openAMRobot/openamrobot-docs/docs/assets/roadmap/media/openamrobot-2-store-1080p-poster.png

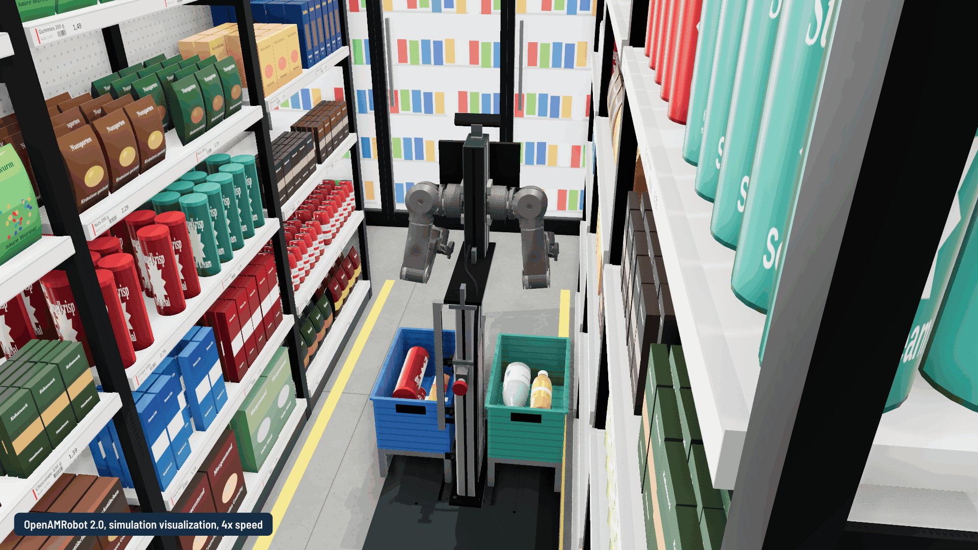
docs/assets/roadmap/media/openamrobot-2-store-1080p-poster.png
