openAMRobot/openamrobot-docs/docs/assets/roadmap/media/store/05_store_overview.jpg

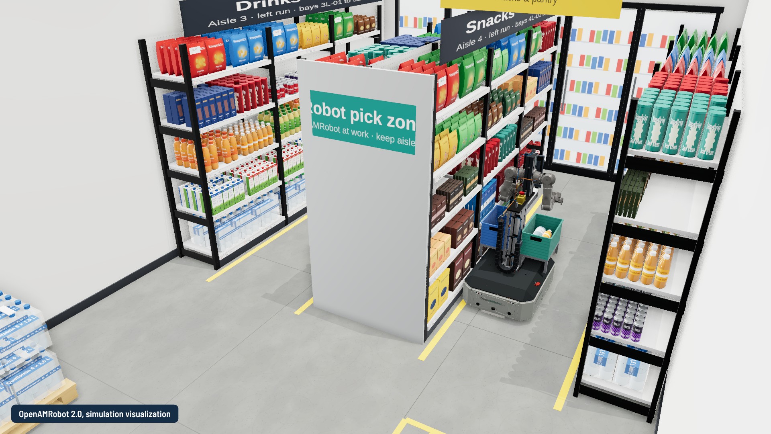
docs/assets/roadmap/media/store/05_store_overview.jpg
