openAMRobot/openamrobot-docs/docs/templates/hardware-README.md

# HARDWARE_COMPONENT_NAME

STATUS: Active

One-sentence hardware definition.

## How it fits

Identify the assemblies and repositories that consume or depend on this design.

## Opening these files

| Format | Authoring tool and version | Free viewer |
|---|---|---|
| Example | Exact tool/version | Viewer/link |

## Build contents

List assemblies, drawings, schematics, PCB source, manufacturing exports, and exclusions.

## BOM summary

Link the authoritative BOM and state its revision.

## Validated configuration

Record the exact tested mechanical, electrical, firmware, and software configuration.

## Known limitations

List verified limitations without unfinished-work markers.

## Repository boundaries

State what belongs here and link firmware, software, documentation, and interface work to their owners.

## Documentation

- Repository documentation: [docs/](docs/)
- Conceptual documentation: DOCS_PAGE_URL

## Safety

State electrical, mechanical, stored-energy, thermal, motion, lifting, and fabrication hazards.

## Project

- [Licence](LICENSE)
- [Licensing map](LICENSING.md)
- [Contributing](https://github.com/openAMRobot/.github/blob/main/CONTRIBUTING.md)
- [Security](https://github.com/openAMRobot/.github/blob/main/SECURITY.md)
