openAMRobot/openamrobot-docs/STATE.md

# State

Working state of this repository for maintainers and agents. Not published on the site (outside `docs/`).

## OpenAMRobot 2.0 plan set reflected in the docs

As of 9 November 2026 (owner decisions of 2, 3 and 8 Nov 2026; decision baseline D-01 to D-34 in P-03 rev20.6 item 30): P-03 rev20.6, E-01 rev1.8 (design text only since rev1.6; precharge, regen clamp, ZLAC boot, brake gating, FB-A/F-CHG and W09 pending, D-22 to D-25, D-28, D-33; not evidence of an implemented or accepted safety chain), M-01 rev19.10, BOM Issue 7.15 (Hardware BOM sheet; the sheet header still reads 7.14), B-02 rev18.11, UC1 rev18.6, decisions.yaml at 87c8486 on main (openAMRobot/.github#90 merged 10 Nov 2026, same tree as the reviewed head 6328f51; change request openAMRobot/.github#89).

- Roadmap pages (`docs/assets/roadmap/`): snapshot 9 Nov 2026 (status pages, model, visuals and the hardware page; window 6 to 9 Nov 2026); PARTS is BOM Issue 7.15 (148 records, 123 onboard by the model rule) (`scripts/roadmap_model/bom715.py` over the 7.14 importer; LFT-008 and MEC-022 added).
- Model placement data is generated: `scripts/roadmap_model/run_all.sh` (sources in `../src`, combined model expanded under `../ament`). Weekly update: edit `facts.yaml`, `parts.yaml`, `bom_map.yaml`, `conflicts.yaml`, then rerun.
- Item-specific citations of earlier revisions (for example "P-03 rev19.7 item 23", "rev20.0 item 24") are kept as the record of where a decision was taken.
- Shared model (`docs/assets/roadmap/model/`): Getac ZX80 drawn portrait only, on a fixed portrait mount (owner correction A3, register OPERATOR-PANEL and TABLET-MOUNT); no ghost. `scripts/sync_audit.json` regenerated by the Playwright visual audit: 166 parts, 0 mismatches.
- Owner decisions of 2 Nov 2026 in the model (entered in P-03 rev20.4 item 28 and M-01 rev19.8): 2 mm tyre compression as an intended contact; lift base plate on the centre-frame arch; owner corrections A1 to A5: TZBOT WCM-500-24 wireless charging prepared in 2.0 (register CHARGING): receiver position at the rear panel on the centre line, class "prepared, installed later", with the base-sheet cut-out, F-CHG, KCHG and the start and fault lines drawn; manual charging through SB50 with the Daly 28.4 V / 20 A charger at any time; 4 + 4 LF105 cells in the side pockets, power electronics on a plate above the receiver (`rear_layout.py`); one front bay layout, two tiers (`front_bay.py`, no options); Getac portrait only on a fixed mount, 55 mm lower (8 Nov 2026, was 40 mm), with the light bar 10 mm below; ZED lens 60 mm ahead of J1_A (8 Nov 2026, was 57 mm); second E-stop on the adapter plate, button up (no other position and no ghost; arm checks use only valid poses: within the joint limits, no self-collision, no collision with the robot body).
- Owner corrections A6 to A9 of 2 Nov 2026 (entered in P-03 rev20.4 item 28 and M-01 rev19.8): lift stop sensors on the rear face of the static DOLD column, centred in y, z 120 / 295 / 470 mm, SICK DOL-1204-G02M cables down the static column; the adapter plate is one part, 6082-T6, 425 x 100 x 10 mm, with a 65 mm rear extension behind the column rear face (sensor face, 2 mm flag gap, 9 mm rod clearance, 20 x 20 rod L430 bolted with M5 under the extension plus the corner bracket, 12 mm bolt edge distance), `frames.lift_rear_layout()`; rod bottom 109 mm above the cover at L1000; GI-010 closed. GI-082 (arch top sheet) and GI-025 (side-panel return flange notch at x -0.275 to -0.133 m) are minor decided fixes, CAD pending. The CAD rear dimensions (552 / 337.6 / 235 mm) are the reference. GI-080 (major, manual layout pending, evans-kwashie): the automatic packer could not place FB-B and the BMS under its rules (single layer plus shelf, 5 mm gaps, nothing above a fuse block, estimated outlines); the free space above the receiver is about 190 x 229 x 165 mm (plate width x plate length x height to the cover); a manual two-level layout with datasheet outlines follows in the next PR. GI-126 (major): battery + to F0 is 196 mm routed as a smooth lug-to-lug curve (175 mm straight, rule about 150 mm). GI-129 and GI-130 (major): F0 to the disconnect (CBL-P02) and K1 to K2 (CBL-P05) have no compliant route in the current rear layout (FB-A, a top-access fuse block, sits between their terminals with no passage beside or under it); they wait for the rear-layout rework with GI-080. Battery: two removable trays joined by the keyed connector PWR-018 (conflict with B-02 rev18.10 listed for the battery owner).
- Harness (3 Nov 2026, `scripts/roadmap_model/harness.py` through `build.py`): every cable of `cable_list.csv` in a named harness (W01 rear power, W02 drive section, W03 / W04 left and right side trunks, W05 front sensors, W07 front tier, W08 lift column, W09 upper body) with labels at both ends and its disconnect points (DP-TRAY-L/R, DP-FT, DP-LIFT). Base routes come from a 5 mm voxel router (structure as shells, parts as boxes, keep-outs, withdrawal paths of the trays, the front tiers and the cover, bend radius per cable class; short lug-to-lug links as smooth curves); routes are cached in `harness_routes.json` by input hash (a full reroute takes about 15 minutes). Upper body: DP-LIFT behind the lift base plate, fixed sleeve on the -y face of the static column, vertical energy chain behind the column (inner 38 x 25 mm, R 75 mm, 0.792 m), moving trunk under the adapter plate. Mounting points and new parts for CAD: `harness_cad_changes.csv`. Not routed: cables to FB-B and the BMS (not placed, GI-080; the arm power cables are routed from DP-LIFT up), CBL-P02 and CBL-P05 (GI-129, GI-130).
- Owner decisions of 8 Nov 2026 (P-03 rev20.4 item 28 and rev20.5 item 29): the roadmap model is the reference for components, mass and placement, and the URDF masses follow `mass_export.yaml` (one source: openamr-platform-sw base_link and openamr-upperbody-sw lift_carriage_link copy it). DOLD lift from the supplier STEP (`facts.yaml` `column`: foot 280 x 60.4 x 10 mm (224 x 40 mm is DOLD-internal; the robot fixing is 4 x DIN 7984 M8 x 14 through the foot tabs on 260 x 30 mm into the tapped 350 x 140 x 10 mm MEC-019, P-03 rev20.6 item 30 D-20), static profile 240 x 60 mm to 505 mm, inner stage 209.5 x 53.3 x 470 mm). Arch reinforcement GI-082: 4 x M8 8.8 through-bolts into one laser-cut tapped steel backing plate if the mechanical owner confirms the space, otherwise 5 mm S235 with press-in nuts (D-21, `arch_fix`, CAD pending). K1/K2 are GX11CAC only (docs #68, 3 Nov); option B is no longer reported (GI-008, GI-009 closed). Wiring: the slot is the gap between the cover lower edge and the panel upper edges (z 214 to 232 mm); no cable, busbar or tie in it or on a panel upper edge (the side-panel top flanges included), all around the robot, no inward band (`cover_slot` keep-outs in `harness.py`); at the rear, parts may rise above the slot level and their leads run down inside. Upper-body cables enter the base through two 50 x 25 mm openings left and right of the lift on the channel centre lines (power left through CH-C1, signal right through CH-C2; DP-LIFT-L and DP-LIFT-R), with entry slots in the centre-bracket front and rear walls and the C-RM channel over the rear power module. Mass ledger (owner, 8 Nov 2026 evening): `mass_ledger.yaml` counts every part once, quantity x datasheet mass (EVE LF105 1.98 kg per cell, ZLLG80 hub motor 3.45 kg, Blickle castor 0.3 kg, RPLIDAR S3 115 g, Gemini 336L 135 g, MEAN WELL and Blue Sea figures), custom parts from dimensions and material; the battery pack is no mass line of its own (cells, busbars, sense harness, probes, insulation; trays, BMS, F0 and disconnect separate); the DOLD 11.7 kg is split into the static 8.89 kg and the moving 2.81 kg share (`column.mass_split`); hub motors, castors and the LiDAR sit on their own URDF links, the wrist cameras on theirs; `mass_export.py` fails when a part is counted twice. Mass export: carriage parts on lift_carriage_link, column parts on lift_column_base_link, one link per BOM line, real boxes for the column, chassis and hub motors, box centres for the centre of mass (the vertex mean put the cells 66 mm high); the Getac pocket is counted once, on UI-002 (MEC-012 is allocation only, included in UI-002).
- After the snapshot: openamr-upperbody-sw #29 merged on 2 Nov 00:06 UTC; the combined model, the parity check and the mass export are rebuilt from the openamr-upperbody-sw #48 head d8c0940 (paired: the export link frames are the #48 frames; main after #48 merges) (with openamr-platform-sw 131e500 and openarm_description 14ff67b).
- Geometry and hardware issues (`geometry_issues.csv`): 0 blockers, 0 majors, 39 minors (8 Nov 2026: option B for K1/K2 is no longer reported, GI-008 and GI-009 closed; the receiver margin is the 15 mm offset, GI-121 to GI-123 keep their IDs with the new wording; 3 Nov 2026: the rear power module layout of `rear_power.py` closes GI-080, GI-126, GI-129 and GI-130). IDs are stable across reruns (`scripts/roadmap_model/issue_ids.yaml`, seeded from the IDs published in PR #68): existing IDs never renumber, new issues get new IDs, closed IDs keep their reason.
- TZBOT values from the TZBOT WCM-500-24 Wireless Charger Instruction Manual V2.5 (2021-09-23), `facts.yaml` `tzbot_receiver`: 170 x 150 x 52 mm, about 1.5 kg, air gap 20 +-10 mm (no effect on the enclosure). Owner decision of 8 Nov 2026 (P-03 rev20.5 item 29): no metal within 20 mm of the receiver sides (`metal_clear`), held by a 3D-printed plastic frame on the steel base sheet (`frame`, part `tz_receiver_frame`, design by the mechanical owner, with a cable notch for the rear TF-Luna lead), and 15 mm above it (`metal_clear_above`; TZBOT recommends 20 mm). `rear_layout.py` places the receiver 170 mm along x, 20 mm in front of the rear panel (x -0.350 to -0.180), bottom 50 mm; the base-sheet cut-out is the receiver plus the frame. The charging gap with a 52 mm floor transmitter (-2 mm) is a minor issue of kind to solve before receiver installation, declared in `check_roadmap.py` KNOWN_CONTACTS.
- Roadmap vs combined model (`parity_report.csv`): 50 mapped items, 42 matched, 4 out of tolerance, 11 pending (intended pending differences include the A6 adapter-plate rear extension, no longer flush with the column rear face (P-03 rev20.1 item 25 D2), the sensor face and the rod position).
- Decision baseline of 8 Nov 2026 (P-03 rev20.6 item 30) in the model: compute D-01, lift foot fixing and MEC-019 350 x 140 mm D-20, backing plate D-21, 0.5 m/s base ceiling D-07 (not measured), CTL-017 and NPN NO sensors D-11, two trays D-27. Mass (D-26, owner instruction of 8 Nov 2026 evening): the ledger is `mass_ledger.yaml`, every part counted once with its datasheet mass, custom parts from their design-intent solids or dimensions and material; the DOLD column split into the static and the moving share; platform-sw #126 and upperbody-sw #48 copy the export pinned to this PR's commit. Design values, not weighed; the mechanical owner reviews the custom-part estimates.
- Refresh of 9 Nov 2026 (branch roadmap/2026-11-09-roadmap-refresh, stacked on docs #83): PARTS from BOM Issue 7.15 (LFT-008 lift foot screws, MEC-022 arch backing plate, 21 changed rows); mass ledger 87.1 kg (base 58.2, lift 9.1, carriage 6.72 kg; 86.3 kg at #83 before LFT-008 and MEC-022), design values, not weighed. openamr-platform-sw #126 and openamr-upperbody-sw #48 still copy the export of #83 (eaa26aa) and need a re-pin after this refresh merges. Exploded tour stops 43.5, 54, 71.5 and 79.5 carry the 8 Nov decisions (foot tabs, receiver plastic frame, two 50 x 25 mm openings, flag rod guide and second E-stop on the adapter plate). Stills 01 to 08, both tour videos and the posters re-rendered into `evidence/2026-11-09-media/`; the dark-store video is unchanged. Conflicts between sources: 50 (`conflicts.yaml`). Review of #84 (9 Nov 2026): `bom715.py` stops on a bad header, invalid or duplicate IDs, non-numeric Qty and page records missing from the workbook, reports added, changed, removed and overridden records, and escapes "</" in the embedded JSON (`scripts/tests/test_bom715.py`); MEC-019 Qty 1 with the two joints and the assembly order of 9 Nov 2026 (P-03 rev20.6; the workbook Qty cell holds legacy notes, recorded as a conflict); LFT-008 and MEC-022 carry provisional explicit placements in `mass_ledger.yaml` (`place`), and the export names its BOM issue from `facts.yaml`. H-day 16 Nov 2026 confirmed: the v0.0.1 Teensy rig runs the current 2.0 base software (a software test, not Build 1 commissioning or acceptance); 6 Nov go/no-go dates labelled historical.
- Copy fixes of 10 Nov 2026 (roadmap audit of 10 Nov): the pages keep the 9 Nov snapshot and record what changed after it. .github #90 merged as 87c8486 and docs #83 and #84 as 329a7bc and ff8ca57 on 10 Nov; the register footers, the system map and the progress lines say so. 16 Nov is a planned software session on the v0.0.1 Teensy rig, after preflight; the architecture controller card is decided per line; the IMU row follows D-10 (EKF on /imu/data_raw, main still on /imu/data, #129); the motion figure is labelled as the rc.1 pin of 19 Oct; progress opens with a capability panel (main, rc.1 pin, last run) and the per-area tables are the historical audit of 19 Oct; purchasing status is out of the narrative (check_roadmap.py "purchasing status"); the exploded drawer label no longer names a BOM issue. Contributor GitHub handles stay on the pages as owners (project lead decision of 10 Nov 2026: they are public on GitHub already). The package cards are regenerated in a follow-up PR (packages.py).
- Public BOM status of 10 Nov 2026 (owner decision): dated stock and quote notes stay in the workbook. `bom715.py` `public_status()` cleans the Procurement status, Release status and Procurement state fields of every record and the purchase view section (no quote counters); a field that held only such notes reads "Procurement confirmation pending". Selected parts, installed quantities and engineering status stay. Tests in `scripts/tests/test_bom715.py`.
- Precharge (SAF-004, PWR-014, PWR-015, BUY-26) on the hardware page and in `bom_coverage.csv`: in the design (P-03 rev20.2; sizing, sequencing and acceptance pending, D-22), not fitted (#83). The progress page keeps "precharge fitted" only in its dated 24 Oct 2026 refresh section.
- `docs/assets/hardware/openamrobot2-hardware-architecture-bom7.html` is the BOM Issue 7 record; superseded notes at the top carry the later values.

The figures above are checked by `scripts/check_roadmap.py` against the generated files (`scripts/sync_audit.json`, `bom_coverage.csv`, `geometry_issues.csv`, `scripts/roadmap_model/parity_summary.json`); it fails when they disagree.

## Owner handles

Owners on the roadmap pages and in `geometry_issues.csv` are GitHub handles from this list, or "owner: to be assigned" (`scripts/roadmap_model/analyse.py` OWN for the issues):

- BotshareAI: project lead.
- panthera-momagdii: tech lead, UI reviewer.
- fridayali: mechanical CAD, URDF, docking.
- evans-kwashie: electrical, safety, firmware.
- skunal3318: navigation.
- Brinex45: manipulation.
- vineethmanthena: perception.
- parthkeshari: UI lead.
- nikgolobo: UI and simulation checks.
- Tushargoel230: upper-body model.
- KARTHIKEYAN124: release.
- ArkaStark: bench and integration.
- wikki26: CI owner.
- anandgawai123456-glitch: docs owner.

## Goal of the roadmap model

The roadmap becomes a renderer of the expanded combined_robot.xacro (openamr-upperbody-sw) at a pinned commit, with no hand-typed dimensions in model.js.

- One geometry, two presentations.
- URDF only: physics, inertials, collisions, ros2_control, MoveIt, Gazebo.
- Roadmap only: finishes, labels, exploded offsets, BOM classes, harness, fasteners, design-intent parts. Roadmap-only parts always attach to a URDF link with an offset (`scripts/roadmap_model/link_map.yaml`).
- Convergence runs in phases: 1) warn-only parity report (done, 2 Nov 2026: `parity.py`, CI warning); 2) URDF-to-GLB renderer plus an overlay file keyed by URDF link name; 3) the parity check fails CI above 0.5 mm, and the frozen fixture in upperbody-sw is removed; 4) the combined model feeds the lift joint, limits, mass, COM, collision reports and recorded MoveIt trajectories into the roadmap, and the roadmap feeds BOM masses, visual-only detail links and confirmed design-intent datums back (`mass_export.yaml` is the first input).

## Open follow-ups

- Rear layout (A1, A9): manual two-level layout of FB-B and the BMS with datasheet outlines in the next PR (GI-080, the automatic packer placed neither after five attempts); F0 distance (GI-126) and a cable passage for CBL-P02 and CBL-P05 beside or under FB-A (GI-129, GI-130); hardware owner. The harness rerun routes the FB-B and BMS cables once those parts are placed. CAD owner: the side-panel return flange notch (GI-025), the adapter-plate rear extension and the arch doubler (GI-082).
- Arch top sheet at the rear rivet nuts is over its yield with the arms at full reach, payload and braking (GI-082): decided fix, a doubler or through-bolts with a backing plate, CAD pending.
- TZBOT (to solve before the receiver is installed): charging gap (GI-036) and the rear panel and TF-Luna inside the 20 mm margin (GI-121 to GI-123).
- Wrist cameras are robot-page fittings, not registry parts.
- Tour and store media were not re-rendered (tour script unchanged).
