openAMRobot/openamrobot-docs/LICENSING.md

# OpenAMRobot licensing standard

OpenAMRobot uses asset-appropriate permissive licences for original material owned by or validly assigned to **OpenAMRobot (Botshare LTD)**.

| Material | Licence |
|---|---|
| Software, firmware, scripts, configuration, APIs, tests, and code examples | [MIT](https://spdx.org/licenses/MIT.html) |
| Documentation, diagrams, tutorials, original images, and other authored content | [Creative Commons Attribution 4.0 International](https://spdx.org/licenses/CC-BY-4.0.html) |
| CAD, PCB and schematic source, mechanical/electrical design files, manufacturing source, and CAD-derived robot geometry | [CERN Open Hardware Licence Version 2 — Permissive](https://spdx.org/licenses/CERN-OHL-P-2.0.html) |

Copyright (c) 2021–2026 OpenAMRobot (Botshare LTD).

The root `LICENSE` identifies the predominant licence for this repository. Where a repository contains several asset types, the table above and any more specific file, directory, SPDX, package, or notice declaration determine the applicable licence.

## Third-party material

No OpenAMRobot licence relicenses third-party material. Third-party material remains governed by its original ownership, licence, patent, attribution, modification, and source-availability terms. Specific third-party terms control over this general policy and are recorded in source headers, dependency manifests, `NOTICE.md`, `THIRD_PARTY_NOTICES.md`, accompanying licence files, or the material itself.

## Ownership and branding

Public licensing grants the permissions in the applicable licence; it does not transfer ownership of the underlying intellectual property. OpenAMRobot, OpenAMR, associated logos, visual identity, and claims of official affiliation or certification are not licensed under MIT, CC BY 4.0, or CERN-OHL-P-2.0. See the organization [Trademark Policy](https://github.com/openAMRobot/.github/blob/main/TRADEMARK_POLICY.md).

## Earlier distributions

Licences validly granted for earlier copies remain effective for those copies. The current default branch states the policy for current and future distributions, subject to third-party rights and mandatory law.

Licensing and provenance questions: **info@botshare.ai**.
