openAMRobot/openamrobot-docs/docs/includes/abbreviations.md

*[AMR]: Autonomous Mobile Robot
*[API]: Application Programming Interface
*[BOM]: Bill of Materials
*[CAD]: Computer-Aided Design
*[CoG]: Centre of Gravity
*[E-stop]: Emergency stop
*[IMU]: Inertial Measurement Unit
*[LMS]: Learning Management System
*[ROS 2]: Robot Operating System 2
*[SLAM]: Simultaneous Localization and Mapping
*[TF]: Transform frame system in ROS
*[URDF]: Unified Robot Description Format
*[VLA]: Vision-Language-Action model
