openAMRobot/openamrobot-docs/docs/learn/foundations.md

<section class="oamr-hero oamr-hero--compact"><div><span class="oamr-status">Stage 1 · Understand</span><h1>Foundations</h1><p>Build the mental model needed to make safe, informed decisions without drowning in robotics vocabulary.</p></div>OpenAMRobot logo</section>

## What to understand

<div class="oamr-grid">
<article class="oamr-card"><h3>Robot anatomy</h3><p>Drive, power, compute, sensors, actuators, chassis and mechanics.</p></article>
<article class="oamr-card"><h3>Navigation</h3><p>Frames, odometry, SLAM, localization, planning, avoidance and docking.</p></article>
<article class="oamr-card"><h3>Manipulation</h3><p>Kinematics, planning, grasping, workspace, reach and the lift.</p></article>
<article class="oamr-card oamr-card--accent"><h3>Embodied AI</h3><p>Why demonstration matters; Show, Correct, Judge; datasets, policies and simulation.</p></article>
<article class="oamr-card"><h3>ROS 2 in an afternoon</h3><p>Nodes, topics, services, actions, parameters, launch, TF, URDF and ros2_control.</p></article>
<article class="oamr-card oamr-card--success"><h3>Working safely</h3><p>Moving robots, electricity, batteries, emergency stop and basic risk assessment.</p></article>
</div>

!!! note "Learning scope"
    This section explains how the pieces relate. Exact implementation details remain in the [Technical Reference](../reference/index.md) and owning repositories.

**Next:** [Build the platform](build.md) or [start in simulation](bring-up.md).
