openAMRobot/openamrobot-docs/docs/start-here/index.md

---
title: Start here
description: Choose the shortest OpenAMRobot path for learning, assembly, operation, integration, development or business validation.
hide:
  - navigation
---

<section class="oamr-hero oamr-hero--compact"><div><span class="oamr-status">Start here</span><h1>Find the shortest path to your goal</h1><p>Choose an outcome first; learn only the detail you need.</p><div class="oamr-actions"><a class="oamr-button oamr-button--primary" href="../foundations/">Learn the platform</a><a class="oamr-button" href="../business/">Build a business</a></div></div>OpenAMRobot logo</section>

## What OpenAMRobot is

OpenAMRobot is an open-source robotics ecosystem operated by **Botshare LTD**. It combines a modular mobile platform, ROS 2 software, embedded firmware, open hardware, shared interfaces, an operator UI and a developing manipulation and Embodied AI layer.

Its operating idea is simple: **the person who understands the work should be able to operate and teach the robot without first becoming a robotics engineer**.

## Choose your path

<div class="oamr-grid">
<article class="oamr-card"><span class="oamr-status">Domain Expert</span><h3>Run and teach</h3><p>Apply task knowledge through missions, monitoring, demonstrations and outcome review.</p><p><a href="../paths/domain-expert/">Begin →</a></p></article>
<article class="oamr-card"><span class="oamr-status">Beginner</span><h3>Learn the platform</h3><p>Build foundations and reach a first verified result in simulation.</p><p><a href="../paths/beginner/">Begin →</a></p></article>
<article class="oamr-card"><span class="oamr-status">Integrator</span><h3>Deploy reliably</h3><p>Configure a supported system for a site, workflow and acceptance target.</p><p><a href="../paths/integrator/">Begin →</a></p></article>
<article class="oamr-card"><span class="oamr-status">Builder</span><h3>Build and own</h3><p>Hardware, installation, bring-up, calibration and acceptance.</p><p><a href="../paths/builder/">Begin →</a></p></article>
<article class="oamr-card"><span class="oamr-status">Developer</span><h3>Extend and contribute</h3><p>Architecture, repositories, contracts and customization guides.</p><p><a href="../paths/developer/">Begin →</a></p></article>
<article class="oamr-card oamr-card--success"><span class="oamr-status oamr-status--stable">Entrepreneur</span><h3>Create a local business</h3><p>Choose a model, validate demand, launch and join the ecosystem.</p><p><a href="../paths/entrepreneur/">Begin →</a></p></article>
</div>

## Start with the task in front of you

These routes cut across the documentation tree. Use them when you know the outcome you need but not which OpenAMRobot section owns it.

<div class="oamr-grid">
<article class="oamr-card"><h3>I need to assemble a robot</h3><p>Prepare the workspace, identify revision-matched parts, assemble one subsystem at a time and verify the result.</p><p><a href="../build/prepare/">Start the build route →</a></p></article>
<article class="oamr-card"><h3>I need to start the software</h3><p>Choose simulation or hardware, install the supported stack and verify the first launch before changing configuration.</p><p><a href="../build/software/">Start the software route →</a></p></article>
<article class="oamr-card"><h3>I need to create a map</h3><p>Understand the mapping model, capture the environment and verify that the saved map supports localization.</p><p><a href="../use/mapping/creating-a-map/">Start the mapping route →</a></p></article>
<article class="oamr-card"><h3>The robot is not moving</h3><p>Collect power, control, lifecycle and diagnostic evidence, then isolate the failing layer.</p><p><a href="../maintain/diagnosis/isolating-a-fault/">Start fault isolation →</a></p></article>
<article class="oamr-card"><h3>I need to integrate a new sensor</h3><p>Define the interface, mount and configure the sensor, then verify frames and data quality.</p><p><a href="../customize/device-packages/adding-a-sensor/">Start sensor integration →</a></p></article>
<article class="oamr-card"><h3>I want to evaluate a customer workflow</h3><p>Describe the task, environment, constraints and acceptance evidence before proposing automation.</p><p><a href="../business/validate/">Start workflow validation →</a></p></article>
</div>

## Simulation or hardware?

| Start with simulation when… | Start with hardware when… |
| --- | --- |
| You are learning navigation, missions or APIs | You must validate mechanics, wiring, sensors or safety |
| You want a reproducible software environment | You are preparing a real deployment or demonstration |
| Hardware is not yet available | You completed the pre-power safety checks |

!!! warning "Know the boundary"
    Simulation does not validate power, wiring, sensing noise, traction, mechanical tolerances, emergency behavior or site safety.
