openAMRobot/openamrobot-docs/docs/about/index.md

---
title: About, legal and contact
---

# About, legal and contact

## Project and operator

OpenAMRobot is an open-source robotics ecosystem initiated, operated and controlled by **Botshare LTD**.

| Detail | Information |
|---|---|
| Legal entity | Botshare LTD |
| Cyprus company ID | HE479056 |
| VAT number | 60197356L |
| Registered contact address | Chrysanthou Mylona 1, Panayides Building, Office 1, 3030 Limassol, Cyprus |
| Email | [info@botshare.ai](mailto:info@botshare.ai) |
| Website | [botshare.ai](https://botshare.ai) |
| GitHub | [github.com/openAMRobot](https://github.com/openAMRobot) |

## Copyright and licensing

Copyright © 2021–2026 OpenAMRobot (Botshare LTD).

Original OpenAMRobot material is licensed by asset type:

| Material | Licence |
|---|---|
| Software and firmware | MIT |
| Documentation, diagrams, tutorials, original images and educational content | CC BY 4.0 |
| Hardware source, CAD, PCB, schematics, manufacturing source and CAD-derived geometry | CERN-OHL-P-2.0 |

A repository’s root licence identifies its predominant material. LICENSING.md, file-level SPDX identifiers, directory notices and third-party notices provide more-specific terms and take priority where applicable. Public licensing grants the permissions in the applicable licence; it does not transfer ownership.

Third-party materials remain subject to their respective owners, licences and notices.

## Trademarks

OpenAMRobot, OpenAMR, associated logos, visual identity and claims of official affiliation or certification are not licensed under MIT, CC BY 4.0 or CERN-OHL-P-2.0. See the [Trademark Policy](https://github.com/openAMRobot/.github/blob/main/TRADEMARK_POLICY.md).

## Contributions and security

- Contributions: [Contribution Guide](https://github.com/openAMRobot/.github/blob/main/CONTRIBUTING.md)
- Contributor Agreements: [CLA process](https://github.com/openAMRobot/.github/blob/main/CLA.md)
- Intellectual property: [IP Policy](https://github.com/openAMRobot/.github/blob/main/IP_POLICY.md)
- Security reports: [Security Policy](https://github.com/openAMRobot/.github/blob/main/SECURITY.md)
- General, licensing and provenance questions: [info@botshare.ai](mailto:info@botshare.ai)

OpenAMRobot is experimental. Public documentation does not represent safety certification, regulatory approval, performance warranty or fitness for a particular deployment.
