openAMRobot/openamrobot-docs/docs/learn/index.md

---
title: Learning path
---

<section class="oamr-hero oamr-hero--compact"><div><span class="oamr-status">The learning path</span><h1>From first principles to an owned robot</h1><p>A staged path to understand, build, configure, train, operate, maintain and customize OpenAMRobot.</p><div class="oamr-actions"><a class="oamr-button oamr-button--primary" href="foundations/">Start with foundations</a><a class="oamr-button" href="../reference/">Technical reference</a></div></div>OpenAMRobot logo</section>

<div class="oamr-path"><span>Understand</span><b>→</b><span>Build</span><b>→</b><span>Bring up</span><b>→</b><span>Configure</span><b>→</b><span>Train</span><b>→</b><span>Use</span><b>→</b><span>Maintain</span><b>→</b><span>Customize</span></div>

## Pick the stage you need

<div class="oamr-grid">
<article class="oamr-card"><h3><a href="foundations/">1 · Foundations</a></h3><p>Robot anatomy, navigation, manipulation, Embodied AI, ROS 2 and safety.</p></article>
<article class="oamr-card"><h3><a href="build/">2 · Build</a></h3><p>Kit, mechanics, electronics, assembly, software and acceptance.</p></article>
<article class="oamr-card"><h3><a href="bring-up/">3 · Bring up</a></h3><p>First power-on, hardware checks, first motion and verification.</p></article>
<article class="oamr-card"><h3><a href="configure/">4 · Configure</a></h3><p>Profiles, hardware, geometry, calibration, safety and docking.</p></article>
<article class="oamr-card oamr-card--accent"><h3><a href="train/">5 · Train</a></h3><p>Named poses, demonstrations, replay, correction and evaluation.</p></article>
<article class="oamr-card oamr-card--success"><h3><a href="use/">6 · Use</a></h3><p>Operation, mapping, missions, Blockly, monitoring and recovery.</p></article>
<article class="oamr-card"><h3><a href="maintain/">7 · Maintain</a></h3><p>Checks, diagnosis, repair, spares, updates and rollback.</p></article>
<article class="oamr-card"><h3><a href="customize/">8 · Customize</a></h3><p>Devices, software, firmware, hardware, simulation and AI.</p></article>
</div>

## How learning pages work

Every practical guide should name its reader, prerequisites, expected outcome, verification method, common failures and next step. Repositories remain canonical for exact versions, source, parameters and interfaces; this site explains the concept and complete task.
