openAMRobot/openamrobot-docs/docs/solutions/index.md

---
title: Solutions
---

<section class="oamr-hero oamr-hero--compact"><div><span class="oamr-status">Solutions</span><h1>Start with the work, not the robot</h1><p>Use one shared platform and reusable capability patterns to address concrete operational problems.</p><div class="oamr-actions"><a class="oamr-button oamr-button--primary" href="pilot-framework/">Plan a pilot</a><a class="oamr-button" href="../business/">Build a local offer</a></div></div>OpenAMRobot logo</section>

## Priority solution families

<div class="oamr-grid">
<article class="oamr-card"><h3><a href="intralogistics/">Intralogistics</a></h3><p>Internal delivery, material movement, patrol and warehouse-support workflows.</p></article>
<article class="oamr-card oamr-card--accent"><h3><a href="retail/">Retail & replenishment</a></h3><p>Stock movement, aisle tasks and mobile-manipulation demonstrations.</p></article>
<article class="oamr-card"><h3><a href="manufacturing/">Manufacturing</a></h3><p>Line-side delivery, inspection, material handling and operator-assist workflows.</p></article>
<article class="oamr-card"><h3><a href="facility-services/">Facility & service operations</a></h3><p>Inspection, internal delivery, cleaning support and recurring service tasks.</p></article>
<article class="oamr-card oamr-card--success"><h3><a href="education-research/">Education & research</a></h3><p>A reproducible open platform for applied learning, experiments and workforce development.</p></article>
<article class="oamr-card"><h3><a href="pilot-framework/">Pilot framework</a></h3><p>Convert a workflow into requirements, metrics, evidence and a commercial next step.</p></article>
</div>

!!! note "Shared platform, not separate products"
    Solution pages adapt reusable navigation, manipulation, interface and training capabilities. They do not create four incompatible robot products.
