openAMRobot/openamrobot-docs/docs/learn/customize.md

<section class="oamr-hero oamr-hero--compact"><div><span class="oamr-status">Stage 8 · Customize</span><h1>Extend without fragmenting</h1><p>Add capabilities through stable interfaces, device packages and documented configuration rather than one-off forks.</p></div>OpenAMRobot logo</section>

<div class="oamr-grid">
<article class="oamr-card"><h3>Device packages</h3><p>Add an arm, sensor or actuator through a repeatable integration contract.</p></article>
<article class="oamr-card"><h3>Software & UI</h3><p>Add nodes, interface components, Blockly blocks and tests.</p></article>
<article class="oamr-card"><h3>Firmware</h3><p>Build, flash, add bridges, use micro-ROS and diagnose embedded behavior.</p></article>
<article class="oamr-card"><h3>Hardware</h3><p>Modify mounting, power, electronics or mechanics with mass and stability checks.</p></article>
<article class="oamr-card"><h3>Simulation & AI</h3><p>Build worlds, scenarios, datasets, evaluations and policy workflows.</p></article>
<article class="oamr-card oamr-card--accent"><h3>External systems</h3><p>Connect APIs, business systems and future fleet interoperability at explicit boundaries.</p></article>
</div>

!!! note "Contribution path"
    Reusable improvements should follow the repository governance and contribution workflow so the ecosystem benefits from them.

**Reference:** [Repository map](../reference/repositories.md) · [Interfaces](../reference/interfaces.md) · [Contributing](../contributing/index.md)
