openAMRobot/openamrobot-docs/docs/solutions/pilot-framework.md

<section class="oamr-hero oamr-hero--compact"><div><span class="oamr-status">Pilot framework</span><h1>Turn interest into evidence</h1><p>A pilot is a bounded commercial experiment with an owner, metric, safety envelope and next decision.</p></div>OpenAMRobot logo</section>

<div class="oamr-path"><span>Qualify</span><b>→</b><span>Baseline</span><b>→</b><span>Design</span><b>→</b><span>Build</span><b>→</b><span>Test</span><b>→</b><span>Decide</span></div>

| Stage | Required output |
| --- | --- |
| Qualify | Process, owner, pain, constraints and budget |
| Baseline | Current time, cost, error, delay and intervention |
| Design | Workflow, configuration, safety and acceptance metric |
| Build | Reproducible pilot configuration and operator procedure |
| Test | Results, failures, interventions and evidence |
| Decide | Deploy, iterate, stop or expand – with commercial next step |

!!! warning "A demo is not a pilot"
    A demo proves that something can move. A pilot tests whether a defined workflow creates acceptable value under real constraints.
