openAMRobot/openamrobot-docs/docs/assets/hardware/openamrobot2-general-arrangement.html

Superseded by the option B upper-body mounting, P-03 rev18.9 item 18; regenerated drawing to follow

# OpenAMRobot 2.0 general arrangement

Mobile platform with the own COTS mast and two OpenArm 2.0 arms. All views to scale from the MMP STEP, the official OpenArm 2.0 CAD and the F2S model. Dimensions in millimetres.

Status | Design proposal, pending measured inputs
Date | 28 September 2026
Owner | Botshare Ltd, OpenAMRobot
Baseline | mast_1350 installation height, mast top 1500 mm, command ceiling 1.5 m/s (analytical)

## Elevations

Arms stowed at the 1350 mm installation height. The ghost plates on the side view mark the other three mounting positions (1300, 1400, 1450 mm). Balloon numbers refer to the parts list.

Side viewFront to the right, hidden parts dashed

Front viewArms hang either side of the 60 mm mast

## Parts list

Item | Part | Key data | Source
1 | Mobile platform MMP | Steel chassis 780 x 582 mm, deck face 294 mm | MMP STEP
2 | Top cover | Non-structural, 630 x 576 mm | MMP STEP
3 | Hub motor ZLTECH ZLLG80ASM250-L-B | 200 mm, 24 V, double shaft, holding brake (ratings pending F2A), track 400 mm | ZLTECH, BOM Issue 7.7
4 | Swivel castor Blickle LPA-VSTH 35K | 52 mm total height, 15 mm offset, 100 kg each | Blickle
5 | Battery 8S1P EVE LF105 | 25.6 V, 105 Ah, 23 kg, centred 25 % of length from the rear | Decision 27 Sep
6 | Electronics bay | Jetson J401, ZLAC8015D, contactors, STM32, DC/DC | P-00
7 | LiDAR SLAMTEC RPLIDAR S3 (S3M1-R2) | Navigation scan, front; existing MMP.07 A1 bracket, 10 mm standoffs and a 7.1 mm spacer plate, beam 222.0 mm above the floor (same as the A1); lidar_link (0.330, 0, 0.124) from base_link, yaw pi; scan window fully open, no translucent cover; USB via USB to UART adapter to the Jetson, regulated 5 V rail; functional sensing, not a safety device | P-03 rev19.0 items 13 and 19
8 | Base camera Orbbec Gemini 336L | Front panel, housing centre on the old camera centre, 142.5 mm above the floor; base_camera_link (0.376, 0, 0.0445) from base_link; opening about 126 x 36 mm; up-tilt bt05, bt10 (baseline) or bt15 | P-03 rev19.0
9 | Base E-stop and start button | Front panel, dual-channel E-stop | P-00, MMP STEP
10 | Near-field sensors | 4 x MaxBotix MB7060 ultrasonic in the front and rear edge holes (27.5 mm, y ±0.130 m, 91.4 mm above the floor); 2 x TF-Luna ToF cliff sensors in the front and rear centre holes (22.0 mm; new rear hole); frames us_front_left, us_front_right, us_rear_left, us_rear_right, tof_front, tof_rear | P-03 rev19.0
11 | Mast base plate and brackets | Aluminium 10 mm on 8 x M8 rivet nuts, HBLFSDW6 brackets, rear brace | MMP STEP, OpenArm CAD
12 | Mast MISUMI HFS6-60120 | 60 x 120 mm, 1196 mm long, mast top 1500 mm above the floor, 5.4 kg | MISUMI
13 | Index cross holes | Diameter 6.6 mm at 50 mm pitch over the full length | Decision 28 Sep
14 | Cable duct | Rear slot zone, service loop to the shoulders | Decision 27 Sep
15 | J1_A arm plates | OpenArm 2.0 part, 12 mm, bolted to the mast side slots | OpenArm 2.0 STEP
16 | Shoulder motors J1 and J2 | DAMIAO DM8009P, two per arm | OpenArm 2.0 BOM
17 | OpenArm 2.0 arm | 7 DOF, 5.36 kg, reach 633 mm, nominal payload 4.1 kg | openarm_description
18 | Gripper with wrist camera | 0.77 kg, parallel fingers, in-hand RGB camera | OpenArm 2.0 BOM
19 | Chest cover with E-stop | Second dual-channel E-stop, about 1.45 m | OpenArm 2.0 STEP, P-00
20 | Head camera ZED-121210 | Stereo scene camera on the mast top; SKU and interface pending | OpenArm 2.0 BOM

## Plan view and stability

The dashed teal rectangle is the tipping boundary: the castor swivel axes moved inwards by their 15 mm offset. The centre of gravity stays inside it in every pose.

Top viewFront to the right

Tipping boundary CoG envelope, travel and arm poses P4, drawer pull 150 N, 86 mm from the edge LiDAR 270 degree field Battery under the deck

## Mast and shoulder mounting

The OpenArm J1_A plates bolt straight onto the side T-slots of the MISUMI profile, so the official arm kinematics stay exact and the shoulder moves between four indexed positions in 50 mm steps. Installation height 1350 mm; mast top 1500 mm.

Detail AElevation and section at the shoulder axis

One M6 through-bolt in the index cross hole locates both J1_A plates at the selected height.

M5 bolts into 6-series T-nuts carry the arm loads, four per plate.

Dashed outlines show the plate at mast_1300, mast_1350 and mast_1450.

Arm and camera cables run in the rear slot zone and loop to each shoulder, long enough for one 50 mm step.

Cross holes: diameter 6.6 mm at 50 mm pitch, ordered as a MISUMI alteration. Every height is a configuration ID propagated to URDF, MoveIt, calibration and dataset metadata. At mast_1450 the plate overhangs the mast top by 11 mm; its upper bolts stay inside the profile.

## Mast positions compared

Height changes reach, not stability. Theoretical horizontal reach at the A4 test heights uses the official 633 mm arm reach. Installation height is 1350 mm; the other positions are available for tests.

| mast_1300 | mast_1350 | mast_1400 | mast_1450
Shoulder axis above floor, mm | 1300 | 1350 | 1400 | 1450
Arm plate top, mm | 1361 | 1411 | 1461 | 1511
Reach at 820 mm height, mm | 413 | 346 | 254 | 62
Reach at 960 mm height, mm | 534 | 499 | 455 | 401
Reach at 1090 mm height, mm | 597 | 577 | 552 | 521
Reach at 1355 mm height, mm | 631 | 633 | 631 | 626
CoG height in travel, mm | 366 | 375 | 384 | 392
Braking decel that tips the robot, m/s² | 7.8 | 7.6 | 7.4 | 7.2

## F2S stability and stopping summary

Output | Result | Basis
Gross mass | about 93 kg | Cap 120 kg
CoG envelope, four poses | 372 to 427 mm high, within 35 mm of the drive axle | Travel, arms forward, arm sideways, drawer pull
Lowest static margin | 86 mm, drawer pull 150 N at 1090 mm | Minimum 50 mm; tips at about 220 N
Stopping at the 1.5 m/s ceiling | 0.82 m at 2.5 m/s² with 0.25 s latency | Tipping needs more than 5.6 m/s², traction limit 3.5 m/s²
Drive pair | Within the ZLTECH 120 kg drivable-mass rating | Rocking case about 650 N per motor, radial limit asked from ZLTECH
Motor speed at the cap | 143 rpm | Rated 200 rpm
Geometry change | None | Battery rear, mast on the drive axle, flat floor envelope

Open inputs: weighed chassis mass, ZLTECH radial load limit and dynamic brake rating, final hub-motor bracket and track, arms supplied without the OpenArm body. Battery and electronics outlines are placeholders until M-01 fixes them.
