openAMRobot/openamrobot-docs/docs/index.md

---
title: Home
description: Learn, build, operate, customize and commercialize the modular OpenAMRobot open-source Embodied AI platform.
hide:
  - navigation
---

<section class="oamr-hero"><div><span class="oamr-status">Open-source Embodied AI ecosystem</span><h1>Build robots. Train them for real work.</h1><p>Learn, build, operate and commercialize a modular ROS 2 platform designed to make robotics useful to domain experts – not only robotics specialists.</p><div class="oamr-actions"><a class="oamr-button oamr-button--primary" href="start-here/">Choose your path</a><a class="oamr-button" href="learn/">Learn the platform</a><a class="oamr-button" href="business/">Build a business</a></div></div>OpenAMRobot project logo</section>

> **One promise, three doors.** Make Embodied AI unprecedentedly simple for domain experts – from reading and assembly to configuration, training, operation and maintenance.

## One platform, three doors

<div class="oamr-grid">
<article class="oamr-card"><span class="oamr-status">The truth</span><h3>GitHub repositories</h3><p>Canonical code, CAD, firmware, interfaces, releases and exact technical reference.</p><p><a href="https://github.com/openAMRobot">Explore GitHub →</a></p></article>
<article class="oamr-card"><span class="oamr-status">The learning path</span><h3>This knowledge hub</h3><p>Illustrated concepts and guided paths to build, configure, train, use and maintain the platform.</p><p><a href="learn/">Start learning →</a></p></article>
<article class="oamr-card oamr-card--accent"><span class="oamr-status oamr-status--experimental">The product</span><h3>The App</h3><p>Guided, semi-automated workflows that hide robotics complexity from domain experts.</p><p><a href="about/">Understand the direction →</a></p></article>
<article class="oamr-card oamr-card--success"><span class="oamr-status oamr-status--stable">The ecosystem</span><h3>Businesses built around it</h3><p>Training, integration, hardware, pilots, deployment and local support opportunities.</p><p><a href="business/">Explore the opportunity →</a></p></article>
</div>

## Choose your role

| I want to… | Best starting point | Primary outcome |
| --- | --- | --- |
| Apply task knowledge to run and train a robot | [Domain Expert path](paths/domain-expert.md) | Operate missions, demonstrate tasks and judge outcomes safely |
| Learn robotics from the beginning | [Beginner path](paths/beginner.md) | Understand the platform and complete a first simulation |
| Deploy it at a customer site | [Integrator path](paths/integrator.md) | Configure and adapt a reliable system |
| Assemble my own platform | [Builder path](paths/builder.md) | Build, bring up and accept a working robot |
| Extend code, firmware or hardware | [Developer path](paths/developer.md) | Build new capabilities and contribute |
| Create a robotics business | [Entrepreneur path](paths/entrepreneur.md) | Validate, launch, deliver and support locally |

## Two journeys through the ecosystem

<p class="oamr-kicker">Robot ownership</p>
<div class="oamr-path"><span>Understand</span><b>→</b><span>Build</span><b>→</b><span>Bring up</span><b>→</b><span>Configure</span><b>→</b><span>Train</span><b>→</b><span>Use</span><b>→</b><span>Maintain</span><b>→</b><span>Customize</span></div>

<p class="oamr-kicker">Business building</p>
<div class="oamr-path"><span>Discover</span><b>→</b><span>Choose a model</span><b>→</b><span>Validate</span><b>→</b><span>Launch</span><b>→</b><span>Sell</span><b>→</b><span>Deliver</span><b>→</b><span>Support</span><b>→</b><span>Scale</span></div>

## Current platform

<div class="oamr-grid">
<article class="oamr-card"><span class="oamr-status oamr-status--stable">Active</span><h3>Mobile platform</h3><p>ROS 2 Jazzy, Nav2, SLAM, navigation, docking, simulation, firmware and open hardware.</p><p><a href="reference/mobile-platform/">Technical overview →</a></p></article>
<article class="oamr-card"><span class="oamr-status oamr-status--stable">Active</span><h3>Robot interface</h3><p>Browser-based operation, visualization and no-code workflows.</p><p><a href="ui/">Explore the interface →</a></p></article>
<article class="oamr-card"><span class="oamr-status oamr-status--beta">Developing</span><h3>Upper body & manipulation</h3><p>Lift, arm-agnostic manipulation, named poses and mobile-manipulation integration.</p><p><a href="reference/upper-body/">See the architecture →</a></p></article>
<article class="oamr-card"><span class="oamr-status oamr-status--experimental">Developing</span><h3>Demonstration pipeline</h3><p>Show, Correct, Judge workflows for capturing, replaying and evaluating demonstrations.</p><p><a href="learn/train/">Learn how teaching works →</a></p></article>
</div>

!!! info "Capability status"
    Pages distinguish **stable**, **beta**, **experimental**, **planned**, **community** and **partner-supported** capabilities. Confirm the relevant repository and release before committing to a deployment.

<div class="oamr-legal"><strong>Open technology, protected identity.</strong><br>Software is generally MIT, documentation CC BY 4.0, and hardware source CERN-OHL-P-2.0. Botshare Academy curriculum, certification and partner rights are separate commercial elements.</div>
