openAMRobot/openamrobot-docs/docs/academy/programs.md

# Academy programs

| Program | Audience | Promise | Primary delivery layer |
| --- | --- | --- | --- |
| **1 · Robot Operator and Trainer** | Domain experts and operations teams | Operate and teach supported workflows without becoming robotics engineers | The App + guided delivery |
| **2 · Build Your Robot** | Builders, technicians and makers | Assemble, configure and maintain an owned platform | Knowledge hub |
| **3 · Customize and Engineer** | Developers, integrators and engineers | Extend the platform safely and reproducibly | Knowledge hub + GitHub |

## Corporate formats

- **Discovery Workshop (1 day):** operate the robot, make a first demonstration, qualify a real automation process and define a pilot path.
- **Discovery Workshop / Demo Day:** practical introduction for a company, hub or professional community.
- **Corporate Enablement:** training plus advisory around a selected workflow.
- **Productization Sprint:** structured requirements, architecture, simulation or PoC and roadmap.

Formats, current prices and booking: [academy.botshare.ai/companies](https://academy.botshare.ai/companies).

!!! info "Capability honesty"
    Program promises must follow demonstrated platform capability. Training by demonstration is taught through supported pipelines and bounded workflows – not as arbitrary task learning.
