openAMRobot/openamrobot-docs/docs/reference/index.md

---
title: Technical reference
description: Find canonical OpenAMRobot repositories, architecture, interfaces, configurations and subsystem references.
---

<section class="oamr-hero oamr-hero--compact"><div><span class="oamr-status">Technical reference</span><h1>Find the owning source</h1><p>Architecture, repositories, interfaces and subsystem references for people integrating or extending the platform.</p><div class="oamr-actions"><a class="oamr-button oamr-button--primary" href="repositories/">Repository map</a><a class="oamr-button" href="https://github.com/openAMRobot">GitHub organization</a></div></div>OpenAMRobot logo</section>

## Reference map

<div class="oamr-grid">
<article class="oamr-card"><h3><a href="architecture/">System architecture</a></h3><p>Subsystem boundaries, delivery layers and how the platform fits together.</p></article>
<article class="oamr-card"><h3><a href="repositories/">Repository ecosystem</a></h3><p>The canonical source for every software, firmware, hardware and shared component.</p></article>
<article class="oamr-card"><h3><a href="mobile-platform/">Mobile platform</a></h3><p>Navigation, docking, bring-up, embedded control, CAD and electronics.</p></article>
<article class="oamr-card"><h3><a href="upper-body/">Upper body</a></h3><p>Lift, robot arms, manipulation architecture and developing integrations.</p></article>
<article class="oamr-card oamr-card--accent"><h3><a href="openamrobot-2/">OpenAMRobot 2.0 design</a></h3><p>Hardware architecture, general arrangement and stability model of the robot being designed in development cycle 2.</p></article>
<article class="oamr-card"><h3><a href="interfaces/">Interfaces</a></h3><p>Messages, services, actions and stable contracts between components.</p></article>
<article class="oamr-card"><h3><a href="communication/">Communication</a></h3><p>APIs, middleware, telemetry and external integration boundaries.</p></article>
</div>

!!! info "Canonical-source rule"
    The owning repository is canonical for exact versions, parameters, schemas and contracts. This knowledge hub teaches what they mean, how they fit together and how to choose, apply and verify them in a complete robot.
