openAMRobot/openamrobot-docs/docs/business/partner-program.md

<section class="oamr-hero oamr-hero--compact"><div><span class="oamr-status">Partner ecosystem</span><h1>Build local capability with OpenAMRobot</h1><p>Partners can specialize in training, integration, hardware, solutions or support – and expand after proving demand and delivery quality.</p><div class="oamr-actions"><a class="oamr-button oamr-button--primary" href="../../academy/partner-program/">Training Partner Program</a><a class="oamr-button" href="mailto:info@botshare.ai?subject=OpenAMRobot%20Partner%20Program">Discuss partnership</a></div></div>OpenAMRobot logo</section>

## Partner principles

1. **Customer value first:** each offer addresses a measurable workflow or capability gap.
2. **Start narrow:** begin with one authorized offer or delivery role.
3. **Open and commercial are distinct:** source licenses do not grant certification or trademark rights.
4. **Quality compounds:** training, deployment and support must follow documented standards.
5. **Evidence unlocks expansion:** territory, scope and rights grow after successful delivery.

<div class="oamr-split"><div class="oamr-panel"><h3>You bring</h3><p>Local customer access, facilities, instructors or engineers, delivery capacity and ongoing support.</p></div><div class="oamr-panel"><h3>Botshare brings</h3><p>OpenAMRobot, methodology, documentation, enablement, certification pathways and ecosystem coordination.</p></div></div>

For the mature training offer, requirements and delivery model, see the [Certified Training Partner Program](../academy/partner-program.md).
