openAMRobot/openamrobot-docs/docs/academy/index.md

---
title: Botshare Academy
description: Explore practical OpenAMRobot programs for operating, training, building, owning and extending Embodied AI systems.
---

<section class="oamr-hero"><div><span class="oamr-status">Botshare Academy</span><h1>Train the people who own the task</h1><p>Practical Embodied AI education for Domain Experts, beginners, integrators, builders and developers – built on the real OpenAMRobot platform.</p><div class="oamr-actions"><a class="oamr-button oamr-button--primary" href="programs/">Explore programs</a><a class="oamr-button" href="partner-program/">Become a training partner</a></div></div>OpenAMRobot logo</section>

> **Domain expertise – not coding – becomes the programming interface.**

## Three-program pathway

<div class="oamr-grid">
<article class="oamr-card oamr-card--accent"><span class="oamr-status">Program 1</span><h3>Operate & Train</h3><p>Run missions, demonstrate tasks, correct behavior and judge outcomes. No coding required for the core path.</p><p><a href="program-1/">View Program 1 →</a></p></article>
<article class="oamr-card"><span class="oamr-status">Program 2</span><h3>Build & Own</h3><p>Assemble, bring up, configure, calibrate and maintain the platform.</p><p><a href="program-2/">View Program 2 →</a></p></article>
<article class="oamr-card"><span class="oamr-status">Program 3</span><h3>Customize & Engineer</h3><p>Extend software, firmware, hardware, interfaces, simulation and AI workflows.</p><p><a href="program-3/">View Program 3 →</a></p></article>
<article class="oamr-card oamr-card--success"><span class="oamr-status oamr-status--stable">Corporate entry</span><h3>Robotics Opportunity Workshop</h3><p>Qualify a workflow, understand feasibility and ROI, and define an evidence-based next step.</p></article>
</div>

## From learning to adoption

<div class="oamr-path"><span>Learn</span><b>→</b><span>Assess</span><b>→</b><span>Pilot</span><b>→</b><span>Deploy</span><b>→</b><span>Expand</span></div>

Academy enrollment, payments, LMS delivery and certificate verification belong in the commercial learning platform. This site explains the programs and connects them to the open technical knowledge base.
