openAMRobot/openamrobot-docs/docs/business/index.md

---
title: Build a business
description: Validate, launch, deliver and support services or products built around the OpenAMRobot ecosystem.
---

<section class="oamr-hero"><div><span class="oamr-status">Build a business</span><h1>Create value around an open platform</h1><p>Build local capability in training, integration, pilots, hardware, deployment and support – without starting a robotics ecosystem from zero.</p><div class="oamr-actions"><a class="oamr-button oamr-button--primary" href="business-models/">Choose a model</a><a class="oamr-button" href="partner-program/">Explore partnership</a></div></div>OpenAMRobot logo</section>

> Open source lowers the barrier to building. A successful business still requires customer access, delivery competence, quality, support and measurable outcomes.

## Entrepreneur journey

<div class="oamr-path"><span>Discover</span><b>→</b><span>Choose a model</span><b>→</b><span>Validate</span><b>→</b><span>Launch</span><b>→</b><span>Sell</span><b>→</b><span>Deliver</span><b>→</b><span>Support</span><b>→</b><span>Scale</span></div>

## Where partners create value

<div class="oamr-grid">
<article class="oamr-card"><h3>Training</h3><p>Workshops, cohorts, corporate enablement and assessed practical certification.</p></article>
<article class="oamr-card"><h3>Integration</h3><p>Site configuration, devices, interfaces, workflows and external systems.</p></article>
<article class="oamr-card"><h3>Hardware</h3><p>Kit sourcing, assembly, approved configurations, spares and repair.</p></article>
<article class="oamr-card"><h3>Pilots</h3><p>Opportunity assessment, feasibility, metrics and controlled customer validation.</p></article>
<article class="oamr-card"><h3>Deployment</h3><p>Installation, acceptance, operator onboarding and transition to operation.</p></article>
<article class="oamr-card oamr-card--success"><h3>Local support</h3><p>Maintenance, updates, incident response and recurring customer relationships.</p></article>
</div>

## Start with evidence

The recommended entry point is not territorial exclusivity or a full franchise commitment. Begin with a qualified market, one repeatable offer and one delivery capability. Expand rights and scope after evidence of demand and quality.

!!! info "Open-source use and partner status"
    OpenAMRobot can be used under its applicable licenses. Official Botshare Academy curriculum, certification, trademarks and Certified Partner designations are separate commercial elements.
