openAMRobot/openamrobot-docs/docs/solutions/education-research.md

# Education and research

**For:** training providers, applied centres, researchers, makers and technical programs.

OpenAMRobot provides inspectable mechanics, electronics, firmware, ROS 2 software, simulation, navigation, interfaces and developing Embodied AI workflows on one platform.

<div class="oamr-grid"><article class="oamr-card"><h3>Learn</h3><p>Use the staged knowledge path from robot anatomy to customization.</p></article><article class="oamr-card"><h3>Build</h3><p>Connect theory to a reproducible physical platform.</p></article><article class="oamr-card"><h3>Experiment</h3><p>Work with simulation, navigation, interfaces and demonstration data.</p></article><article class="oamr-card oamr-card--success"><h3>Contribute</h3><p>Return reusable improvements through governed open-source workflows.</p></article></div>

For official training delivery and certification, see [Botshare Academy](../academy/index.md).
