openAMRobot/openamrobot-docs/docs/assets/hardware/openamrobot2-ga-elevations.jpg

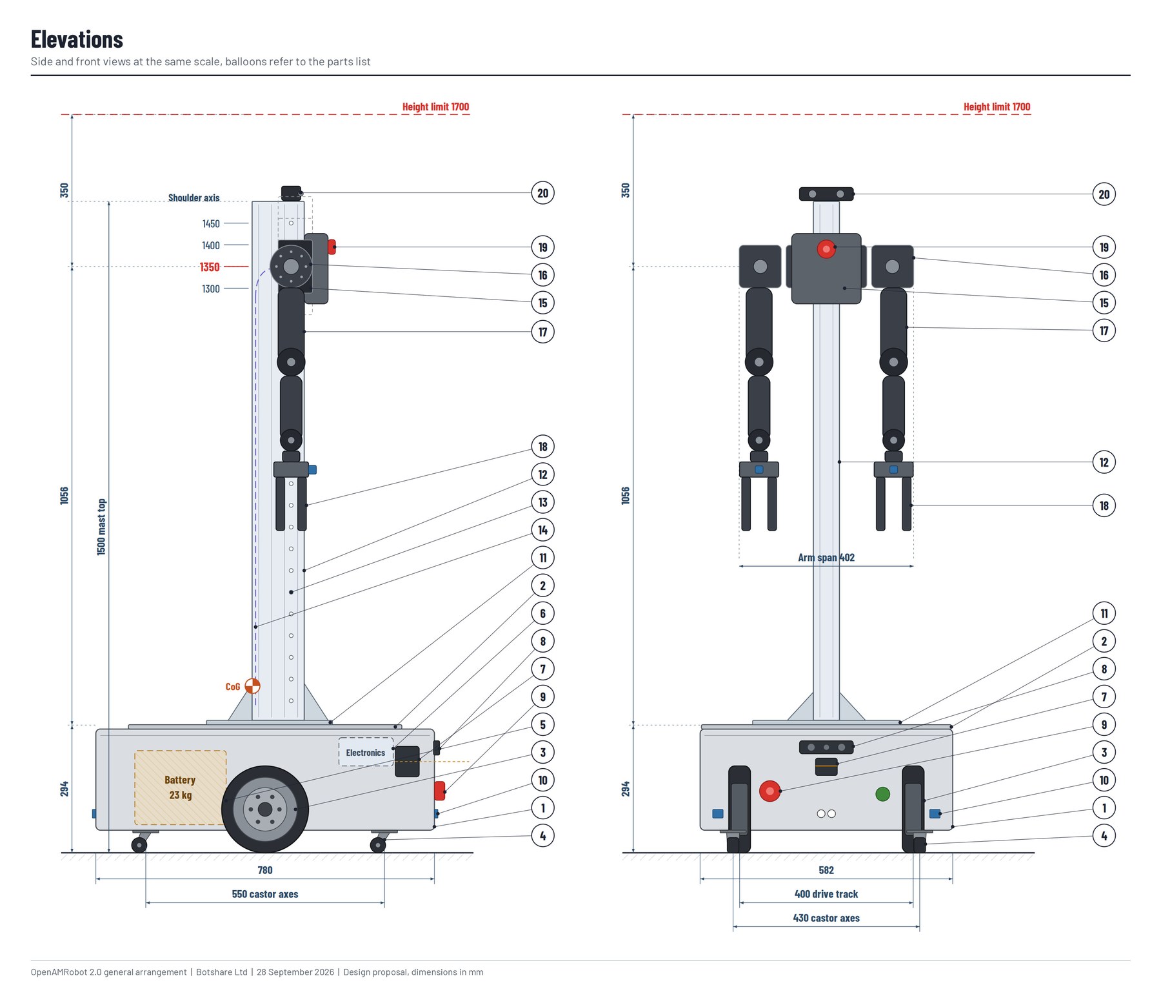
docs/assets/hardware/openamrobot2-ga-elevations.jpg
