openAMRobot/openamrobot-docs/docs/assets/hardware/openamrobot2-ga-front-view.jpg

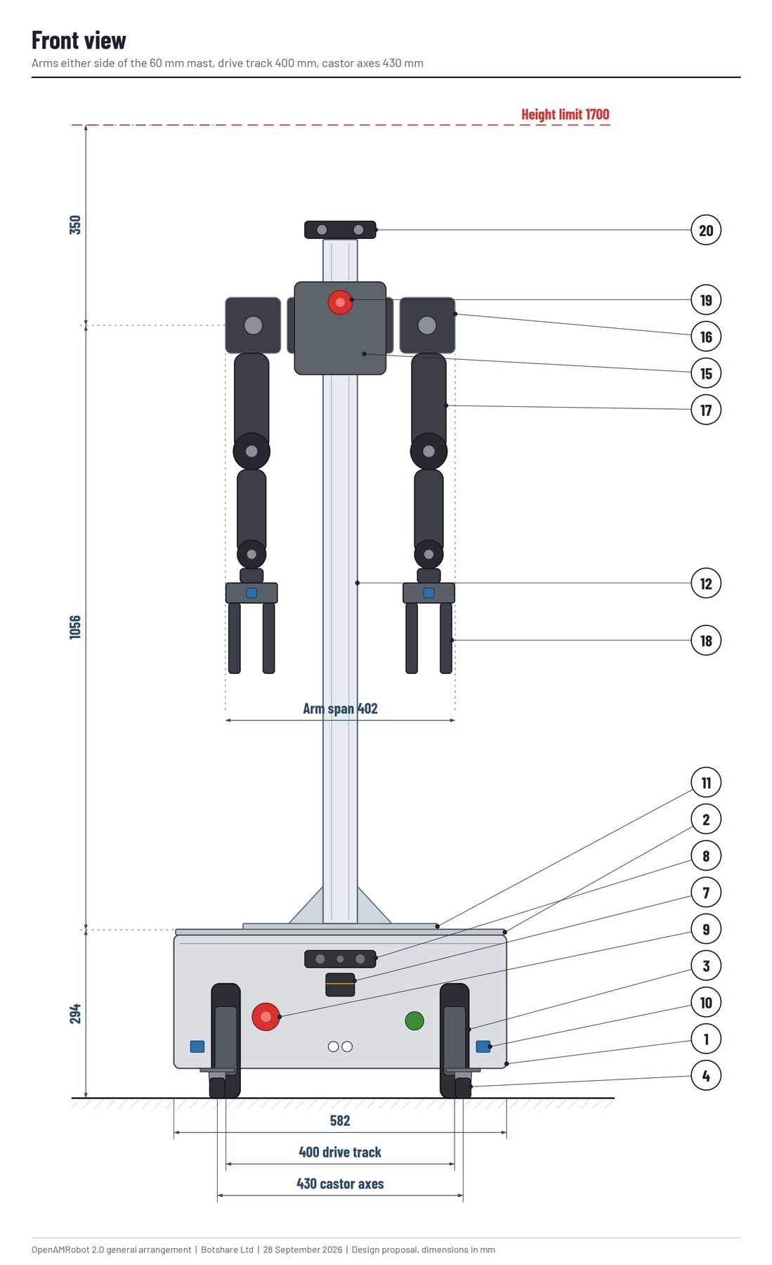
docs/assets/hardware/openamrobot2-ga-front-view.jpg
