openAMRobot/openamrobot-docs/docs/assets/hardware/openamrobot2-ga-mast-detail.jpg

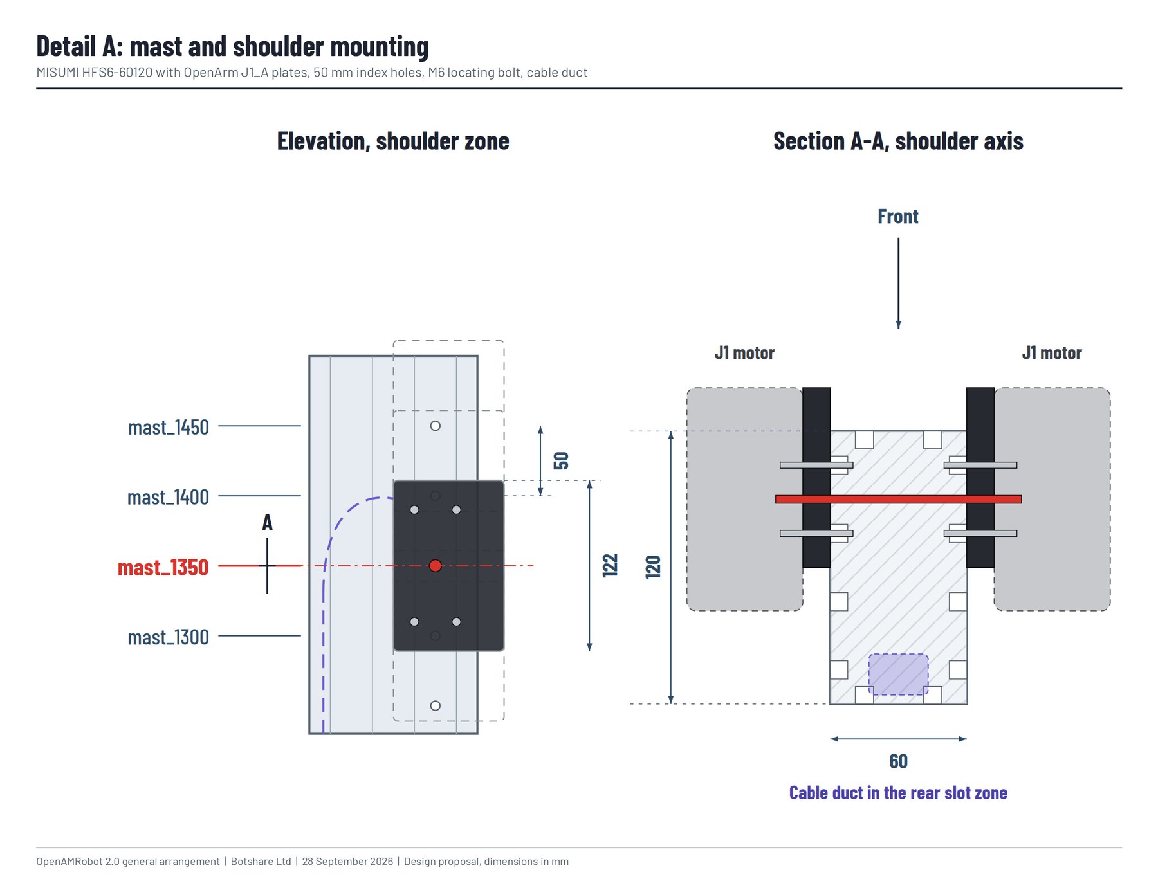
docs/assets/hardware/openamrobot2-ga-mast-detail.jpg
