openAMRobot/openamrobot-docs/docs/assets/hardware/openamrobot2-ga-side-view.jpg

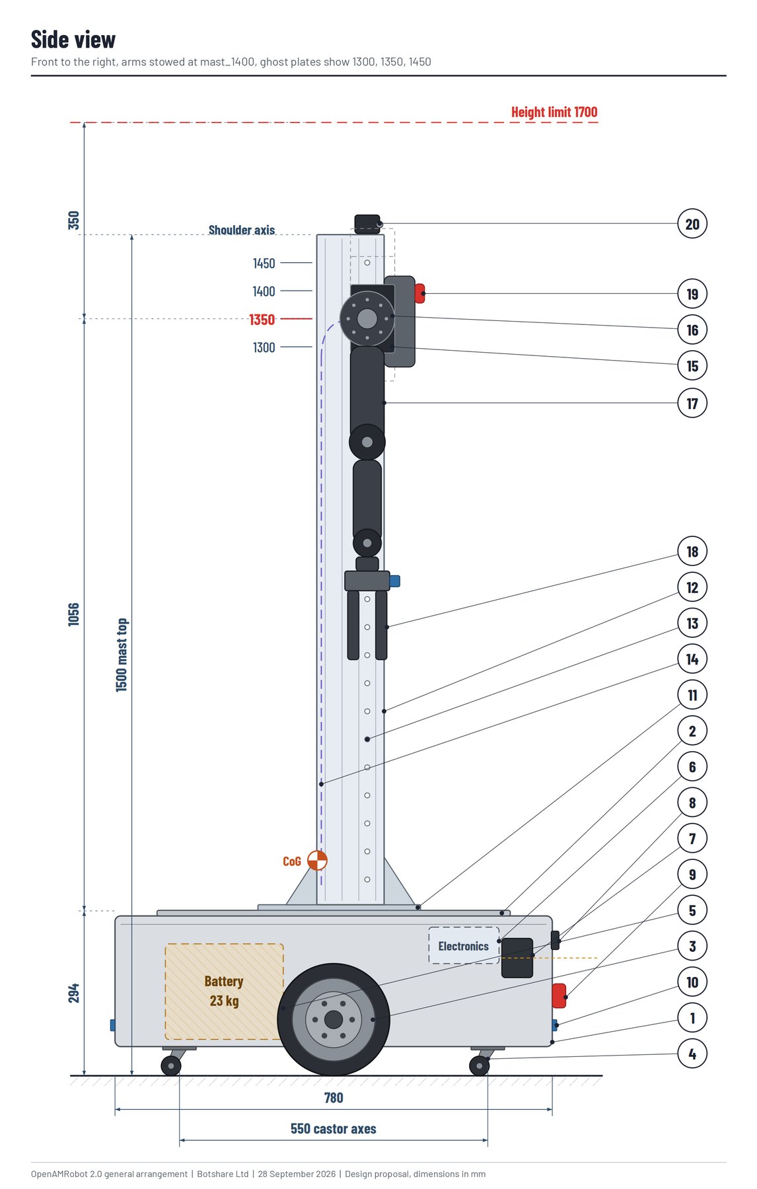
docs/assets/hardware/openamrobot2-ga-side-view.jpg
