openAMRobot/openamrobot-docs/docs/assets/hardware/openamrobot2-ga-top-view.jpg

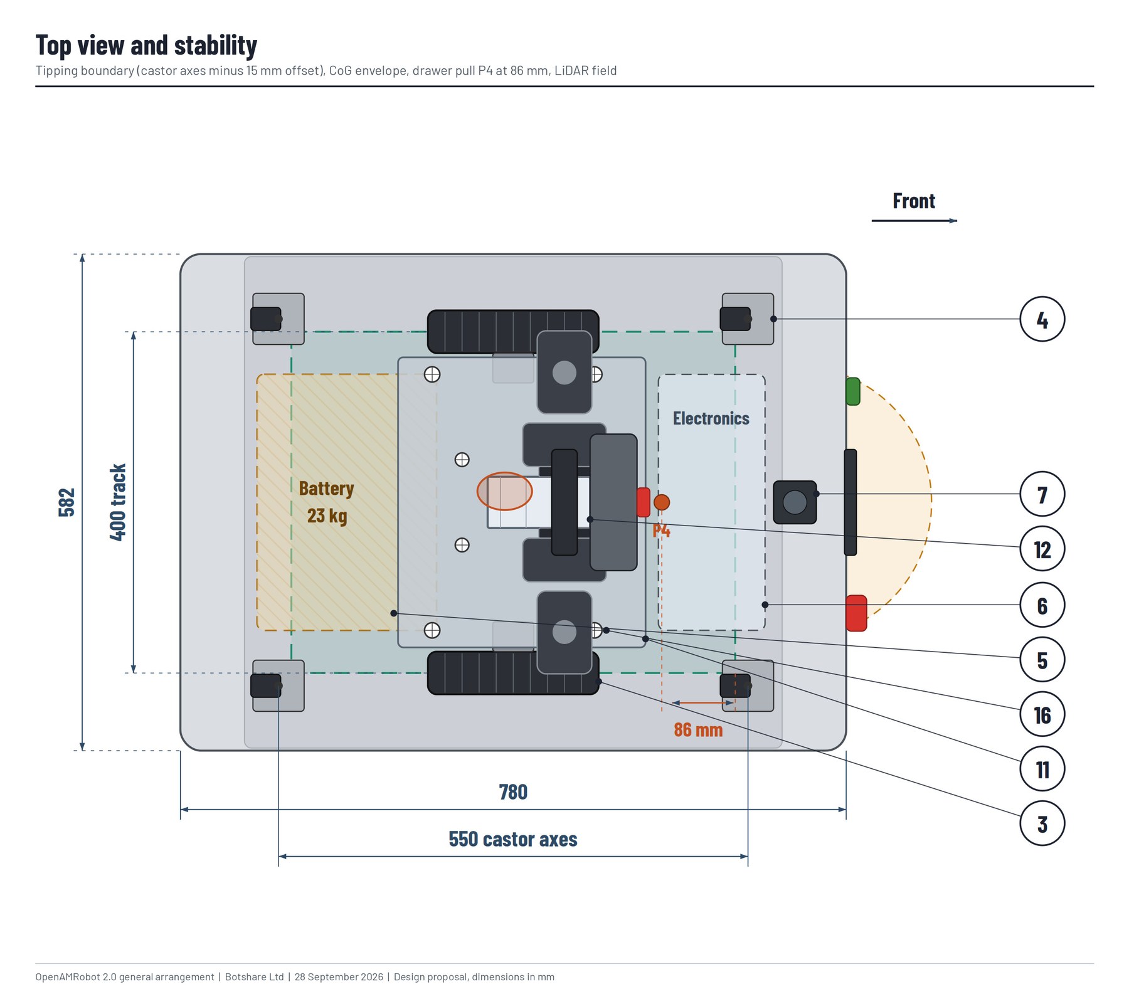
docs/assets/hardware/openamrobot2-ga-top-view.jpg
