openAMRobot/openamrobot-docs/docs/assets/roadmap/media/openamrobot-2-tour-1080p-poster.png

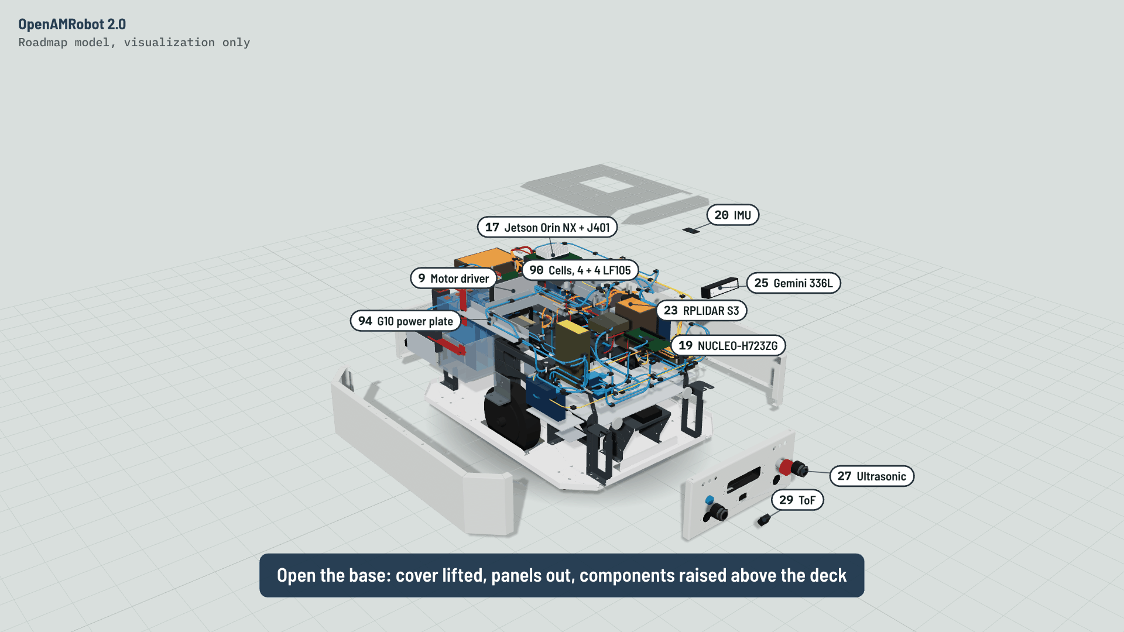
docs/assets/roadmap/media/openamrobot-2-tour-1080p-poster.png
