openAMRobot/openamrobot-docs/docs/assets/roadmap/media/openamrobot-2-tour-1080x1350-poster.png

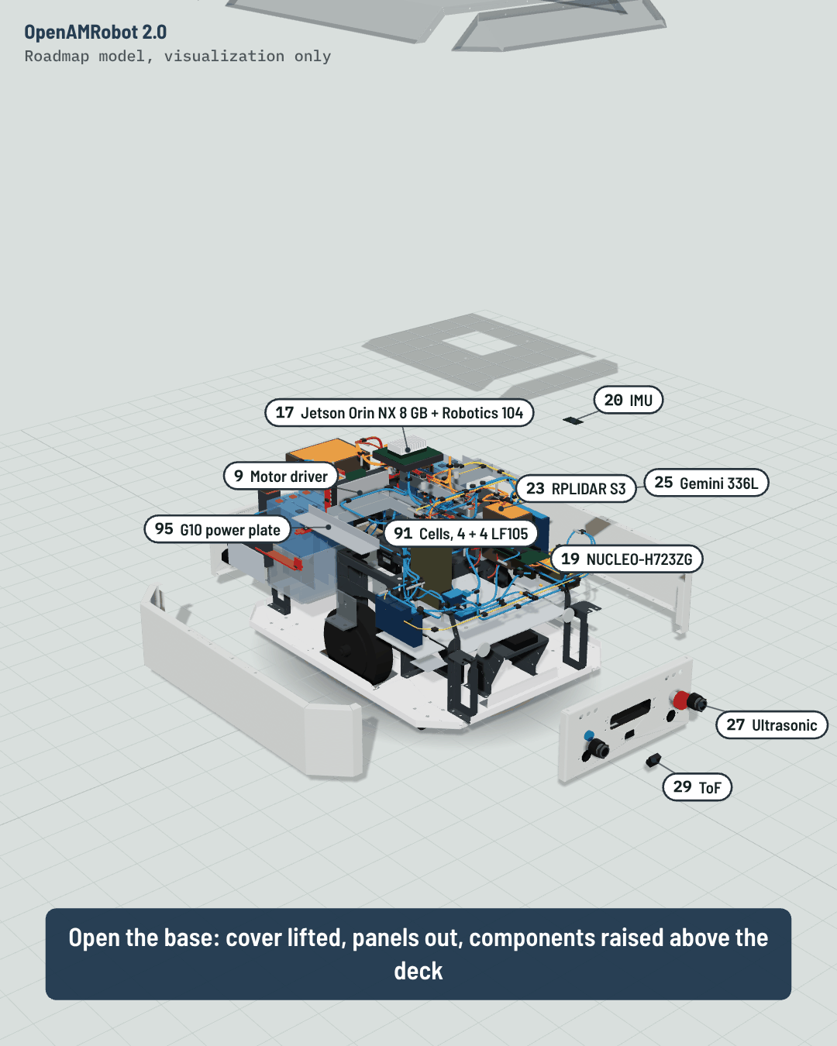
docs/assets/roadmap/media/openamrobot-2-tour-1080x1350-poster.png
