openAMRobot/openamrobot-docs/docs/assets/roadmap/media/stills/01_robot_front_three_quarter_L1000.jpg

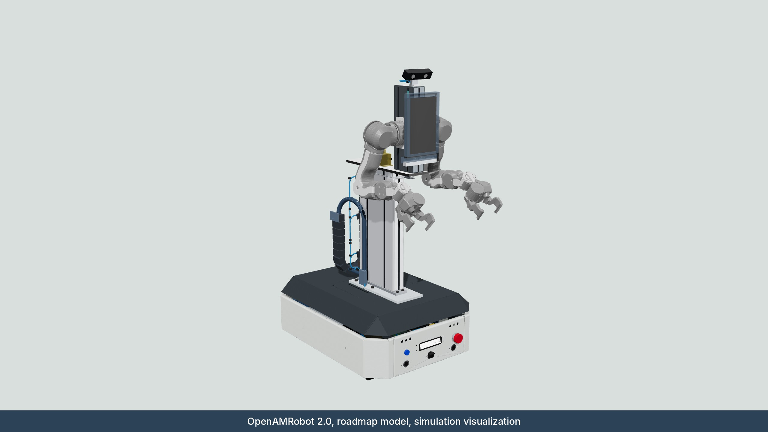
docs/assets/roadmap/media/stills/01_robot_front_three_quarter_L1000.jpg
