openAMRobot/openamrobot-docs/docs/assets/roadmap/media/stills/03_robot_side.jpg

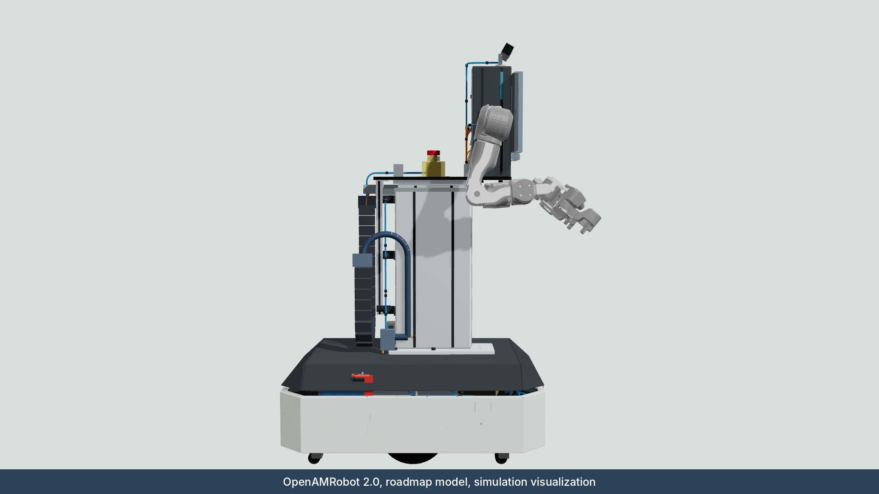
docs/assets/roadmap/media/stills/03_robot_side.jpg
