openAMRobot/openamrobot-docs/docs/assets/roadmap/media/stills/06_front_bay_side_zones.jpg

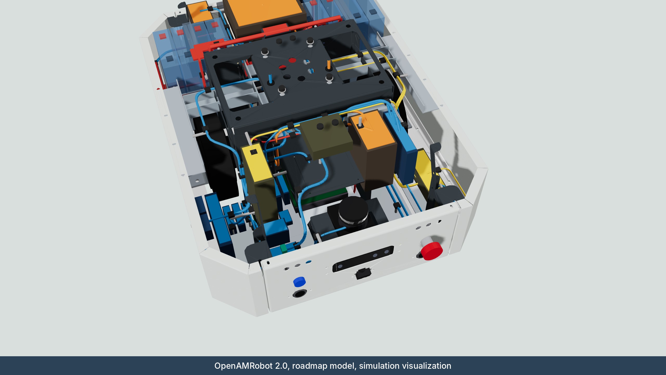
docs/assets/roadmap/media/stills/06_front_bay_side_zones.jpg
