openAMRobot/openamrobot-docs/docs/assets/roadmap/media/stills/08_exploded_view.jpg

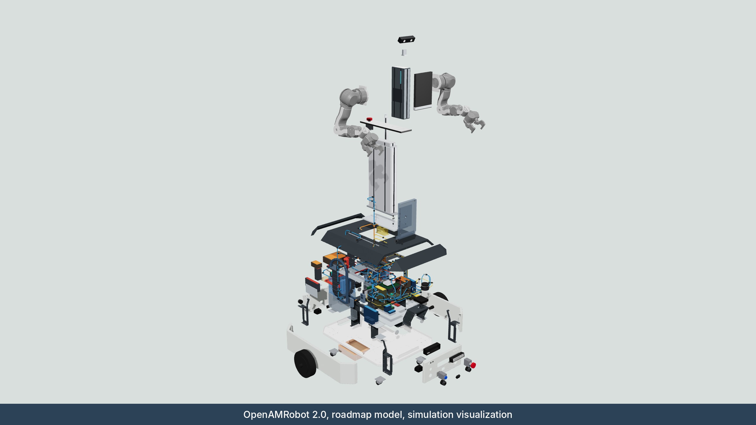
docs/assets/roadmap/media/stills/08_exploded_view.jpg
