openAMRobot/openamrobot-docs/docs/assets/roadmap/media/stills/09_store_picking_from_shelf.jpg

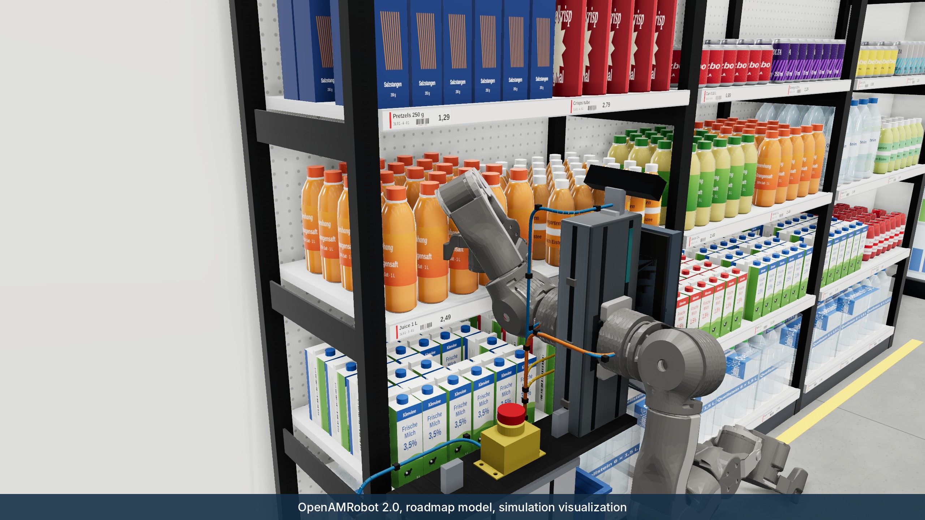
docs/assets/roadmap/media/stills/09_store_picking_from_shelf.jpg
