openAMRobot/openamrobot-docs/docs/assets/roadmap/media/store/03_place_tote.jpg

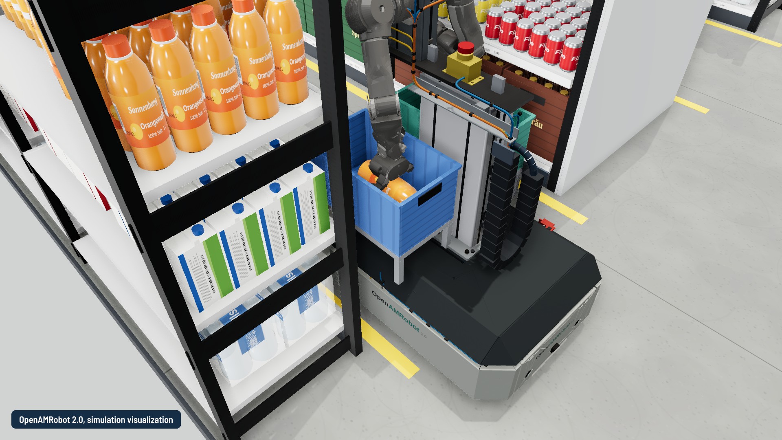
docs/assets/roadmap/media/store/03_place_tote.jpg
