openAMRobot/openamrobot-docs/docs/assets/roadmap/media/store/04_front_low.jpg

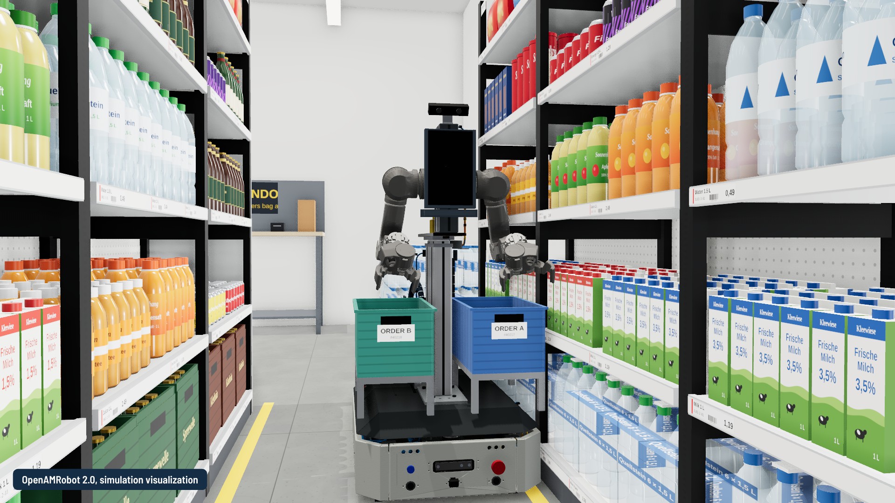
docs/assets/roadmap/media/store/04_front_low.jpg
