openAMRobot/openamrobot-docs/docs/assets/roadmap/media/store/04_front_low_1080x1350.jpg

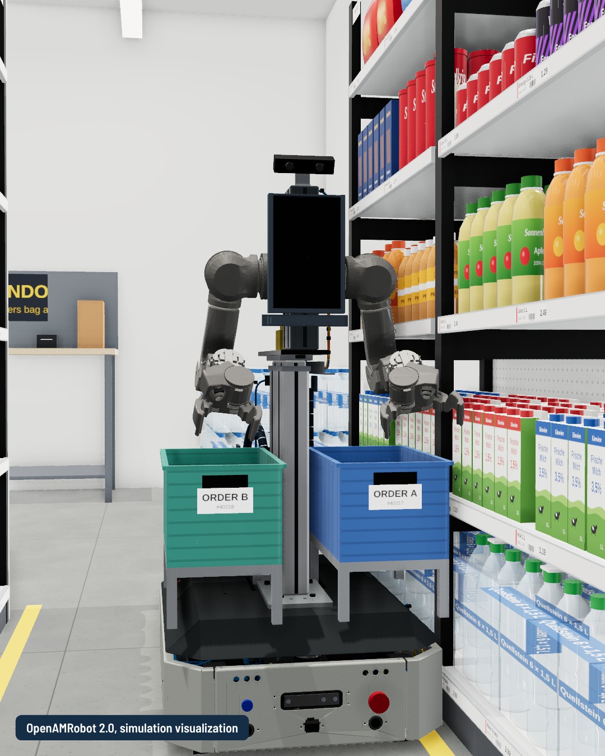
docs/assets/roadmap/media/store/04_front_low_1080x1350.jpg
