openAMRobot/openamrobot-docs/docs/assets/roadmap/media/store/06_dock.jpg

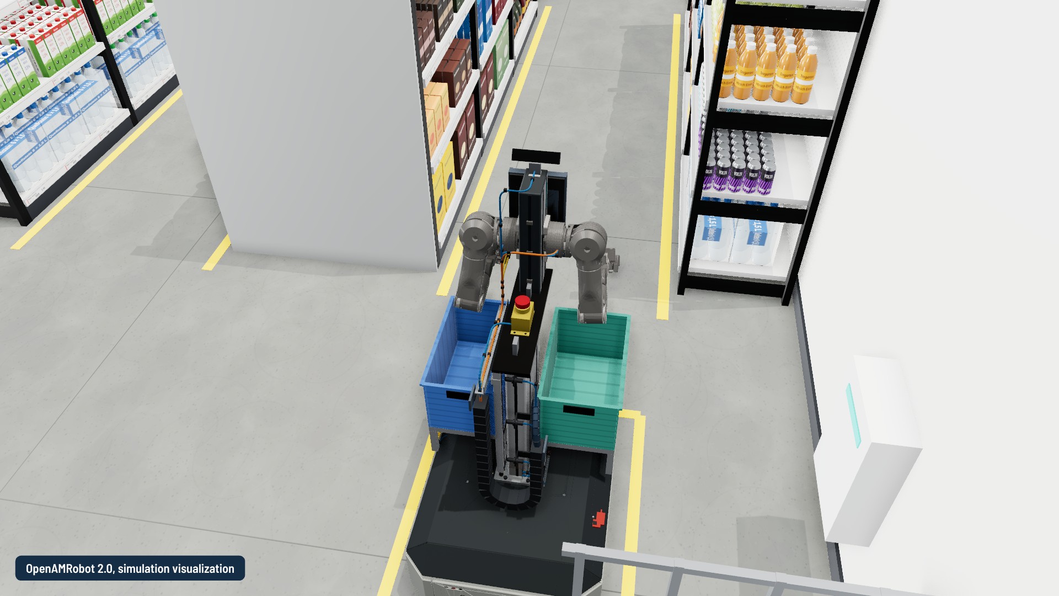
docs/assets/roadmap/media/store/06_dock.jpg
