openAMRobot/openamrobot-docs/docs/assets/roadmap/media/store/thumbs/02_pick_side_1080x1350.jpg

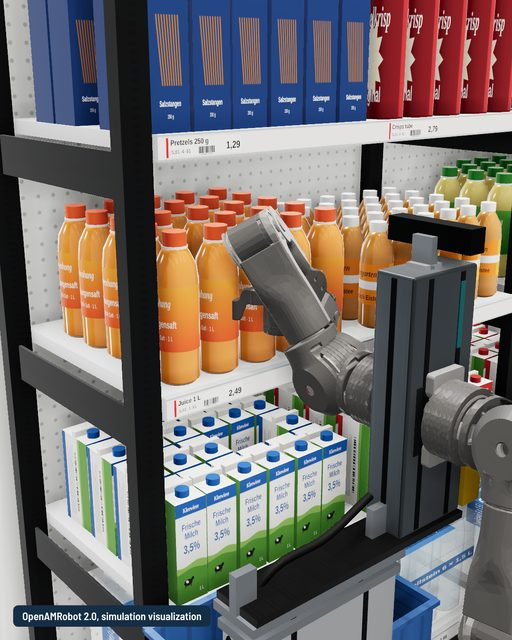
docs/assets/roadmap/media/store/thumbs/02_pick_side_1080x1350.jpg
