openAMRobot/openamrobot-docs/docs/assets/roadmap/model/exploded-static.png

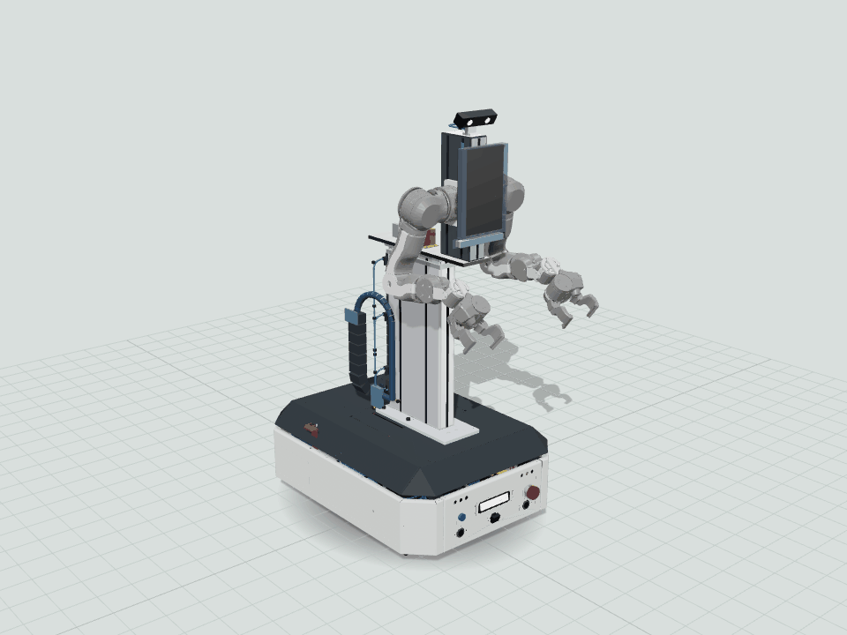
docs/assets/roadmap/model/exploded-static.png
