openAMRobot/openamrobot-docs/evidence/2026-10-25-exploded-view-v2/exploded_375_open_base.png

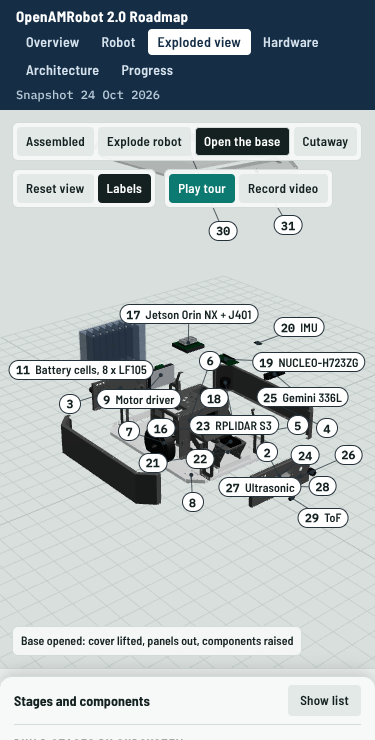
evidence/2026-10-25-exploded-view-v2/exploded_375_open_base.png
