openAMRobot/openamrobot-docs/evidence/2026-10-25-exploded-view-v2/exploded_1280_cutaway.png

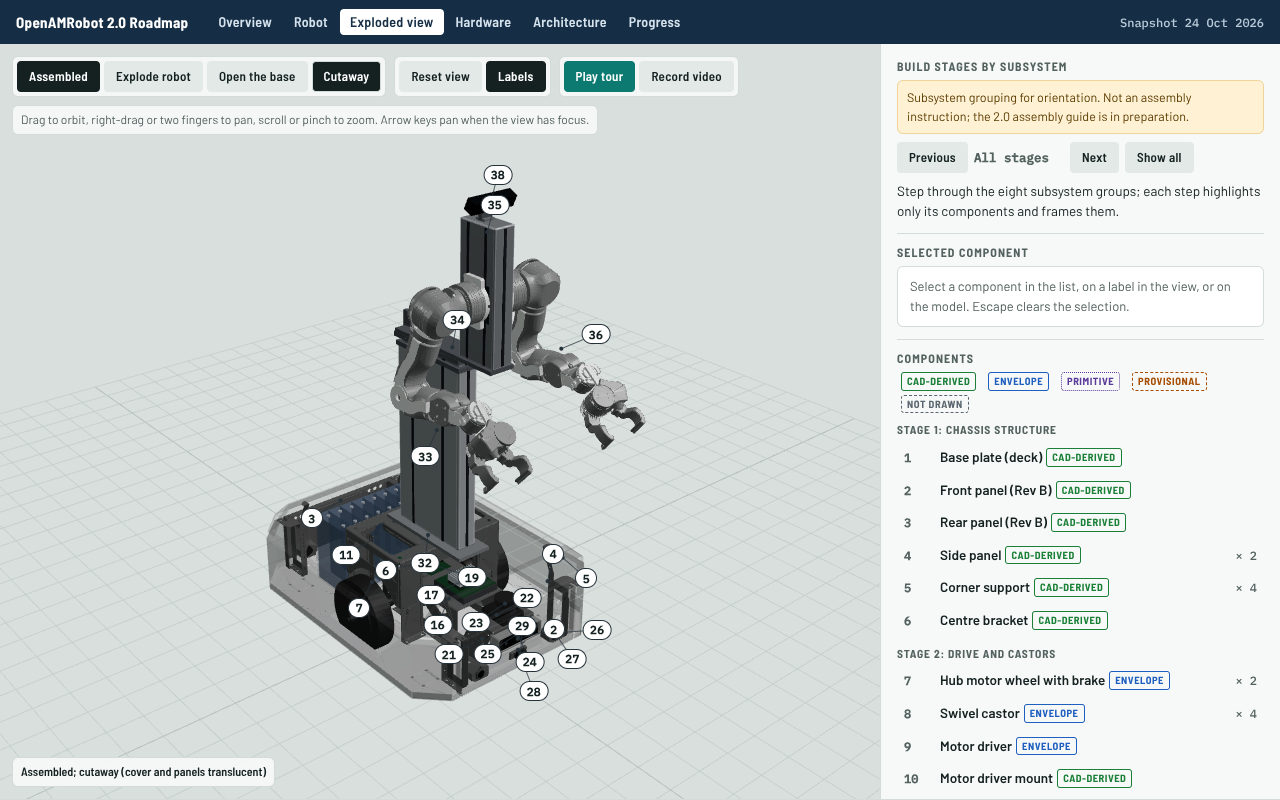
evidence/2026-10-25-exploded-view-v2/exploded_1280_cutaway.png
