openAMRobot/openamrobot-docs/evidence/2026-10-25-exploded-view-v2/exploded_1280_no_webgl.png

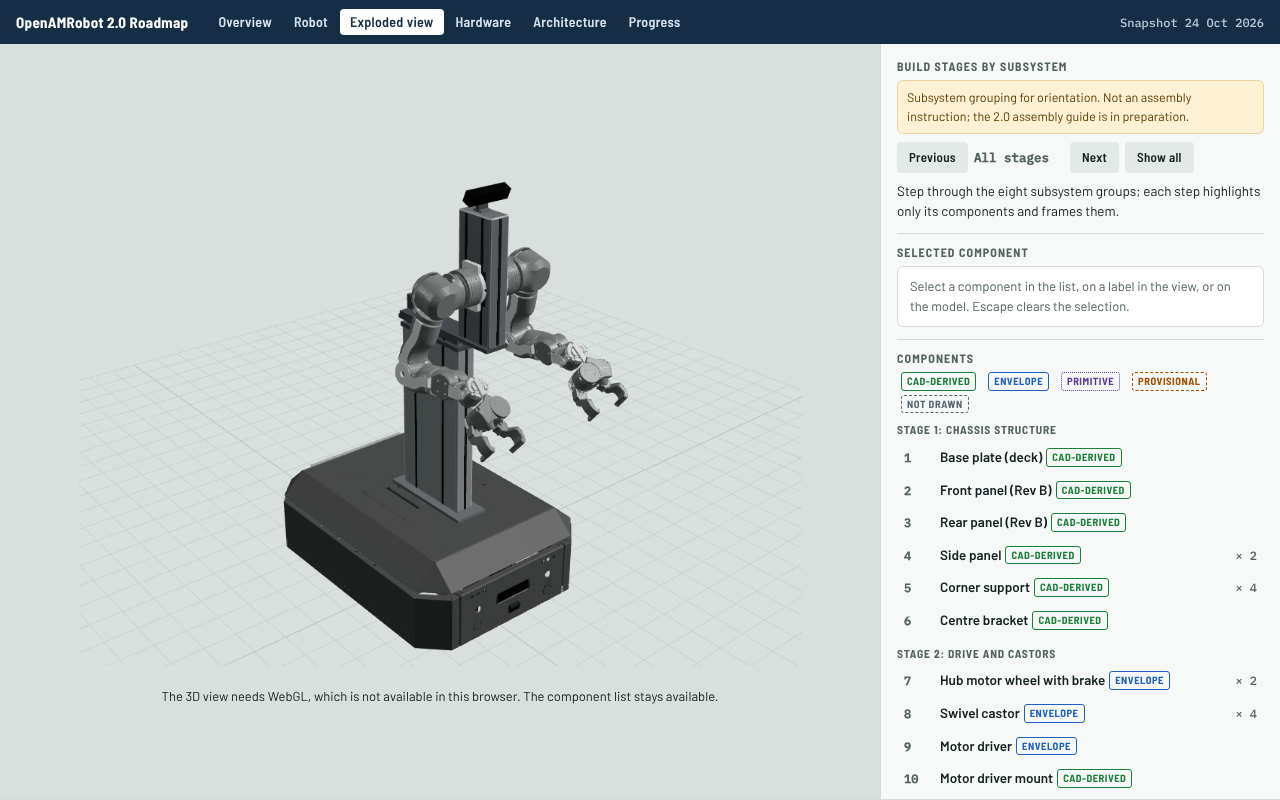
evidence/2026-10-25-exploded-view-v2/exploded_1280_no_webgl.png
