openAMRobot/openamrobot-docs/evidence/2026-10-25-exploded-view-v2/robot_1280_overview.png

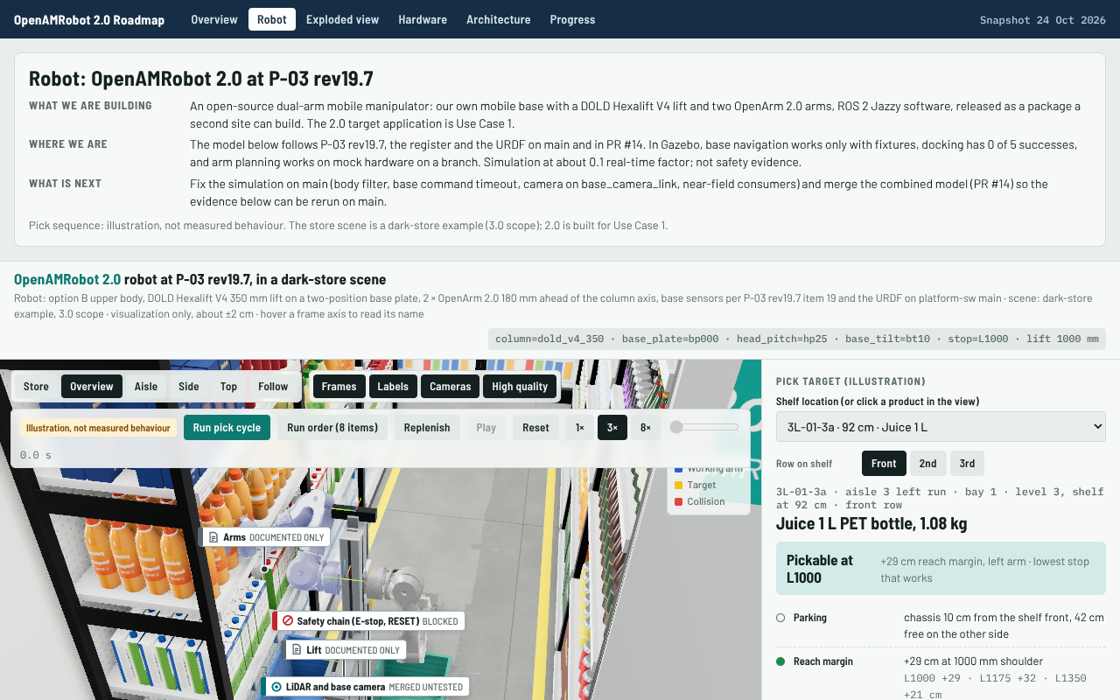
evidence/2026-10-25-exploded-view-v2/robot_1280_overview.png
