openAMRobot/openamrobot-docs/evidence/2026-10-25-finish/exploded_1280_open_base_after.png

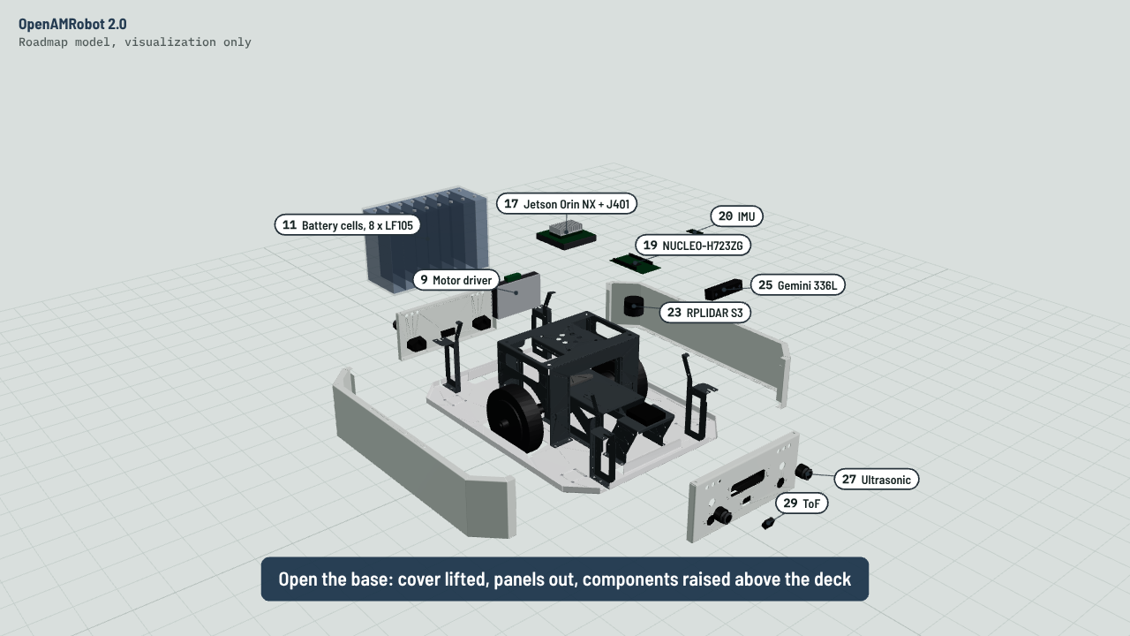
evidence/2026-10-25-finish/exploded_1280_open_base_after.png
