openAMRobot/openamrobot-docs/evidence/2026-10-25-finish/mask_rear_after.png

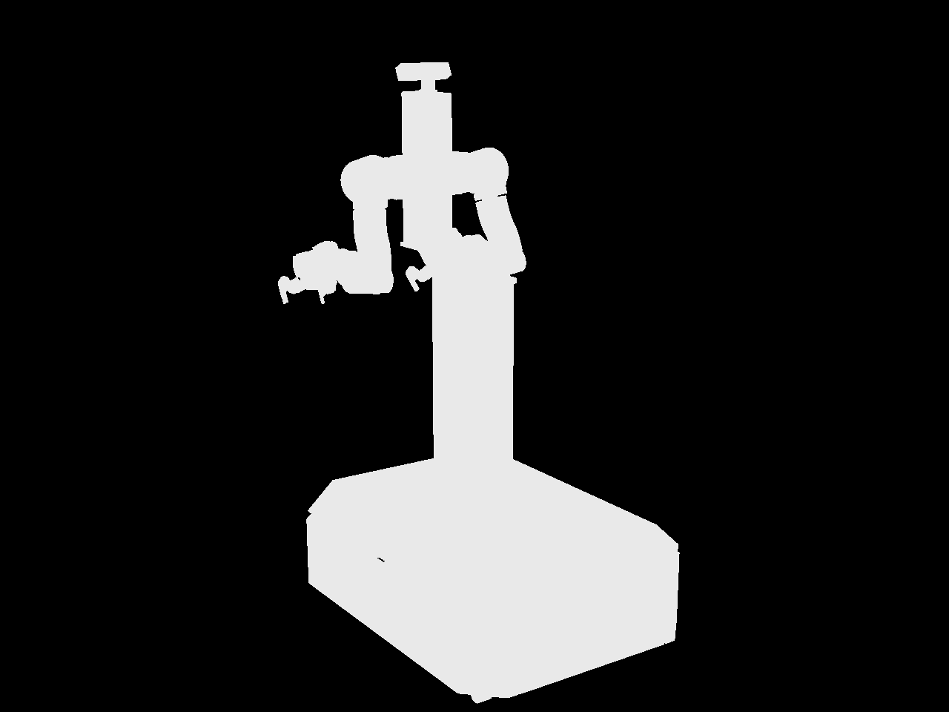
evidence/2026-10-25-finish/mask_rear_after.png
