openAMRobot/openamrobot-docs/evidence/2026-10-25-finish/robot_1280_side_before.png

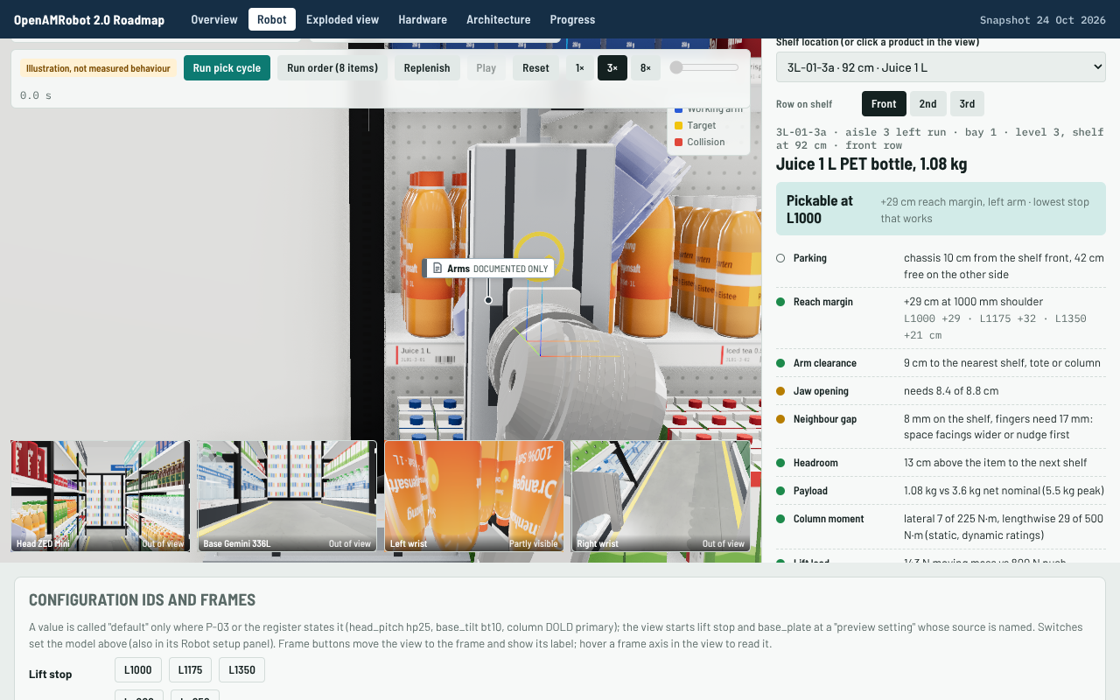
evidence/2026-10-25-finish/robot_1280_side_before.png
