openAMRobot/openamrobot-docs/evidence/2026-10-25-finish/tour_caption_12.9s_before_12.9s_after_13.0s_after.png

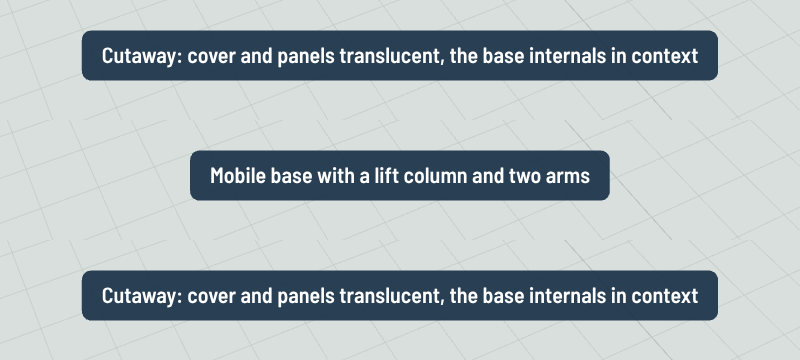
evidence/2026-10-25-finish/tour_caption_12.9s_before_12.9s_after_13.0s_after.png
