openAMRobot/openamrobot-docs/evidence/2026-10-26-shared-model/exploded_375_after.png

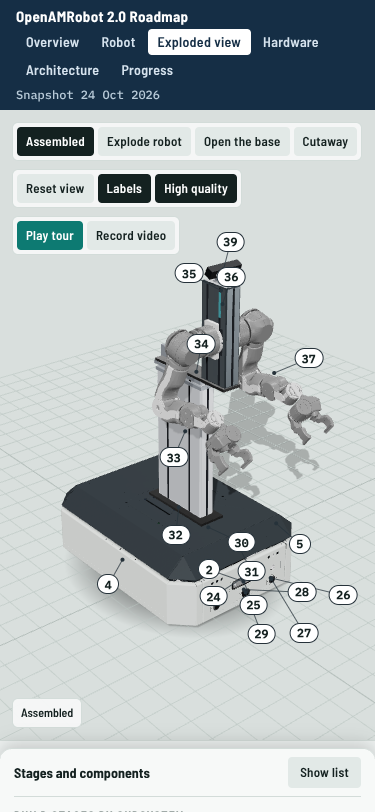
evidence/2026-10-26-shared-model/exploded_375_after.png
