openAMRobot/openamrobot-docs/evidence/2026-10-26-shared-model/mask_exploded_front_before.png

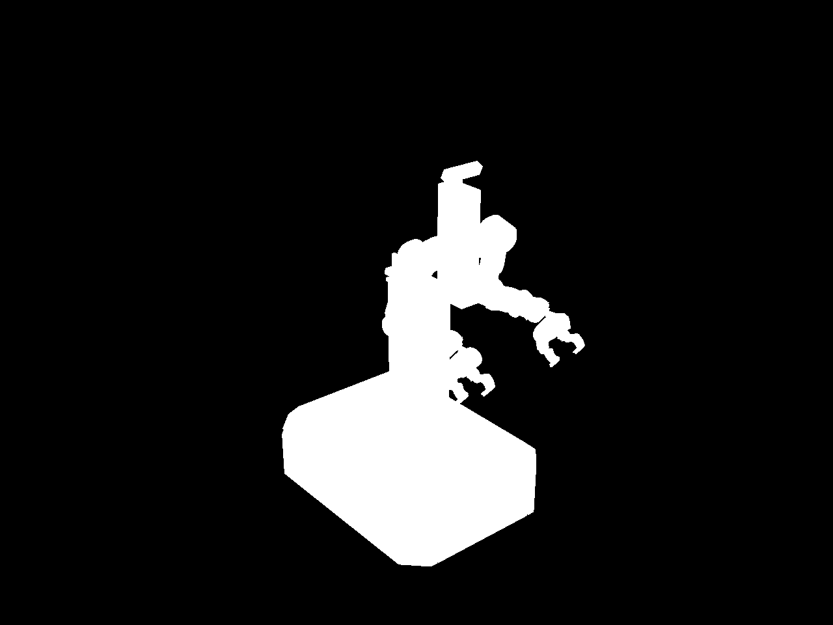
evidence/2026-10-26-shared-model/mask_exploded_front_before.png
