openAMRobot/openamrobot-docs/evidence/2026-10-26-shared-model/mask_exploded_rear_after.png

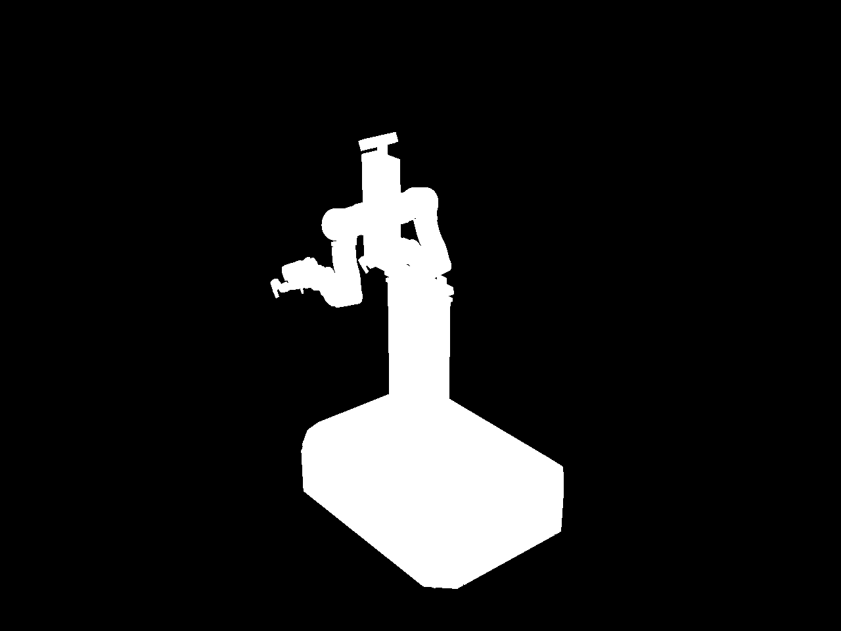
evidence/2026-10-26-shared-model/mask_exploded_rear_after.png
