openAMRobot/openamrobot-docs/evidence/2026-10-26-shared-model/preview/05_exploded_explode_robot.png

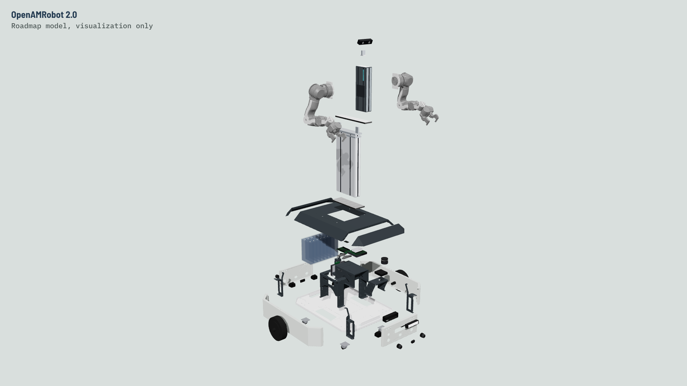
evidence/2026-10-26-shared-model/preview/05_exploded_explode_robot.png
