openAMRobot/openamrobot-docs/evidence/2026-10-26-shared-model/robot_1280_side_before.png

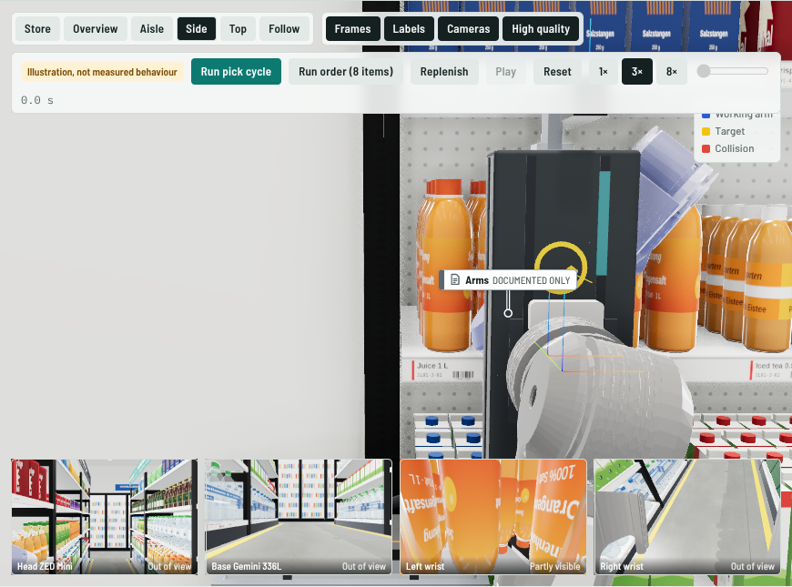
evidence/2026-10-26-shared-model/robot_1280_side_before.png
