openAMRobot/openamrobot-docs/evidence/2026-10-27-store-media/robot_375_media_section.png

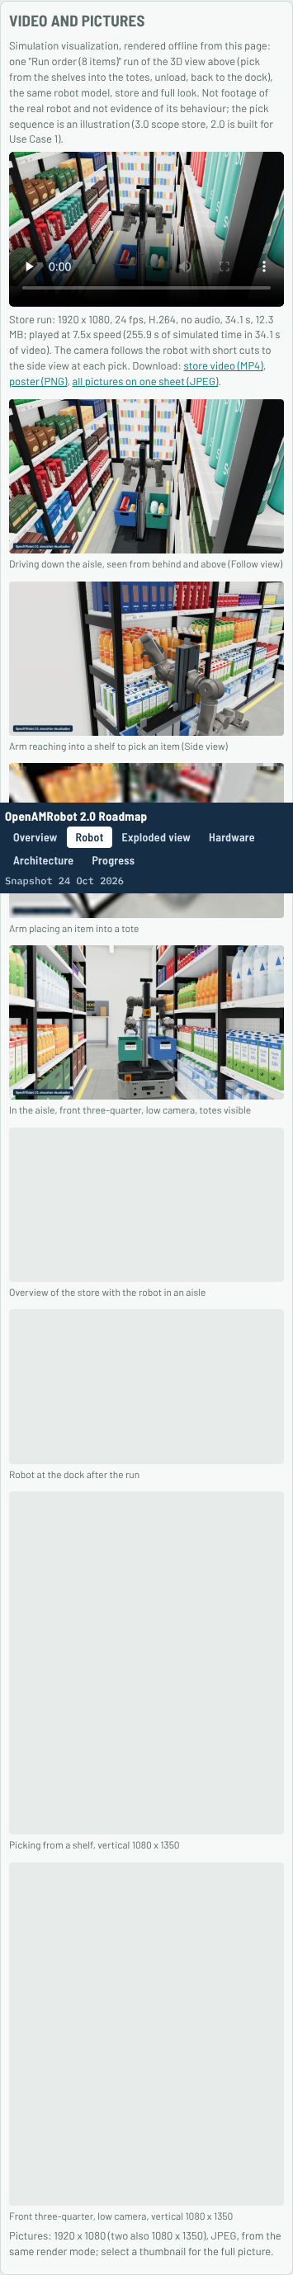
evidence/2026-10-27-store-media/robot_375_media_section.png
