openAMRobot/openamrobot-docs/evidence/2026-10-27-store-media/robot_overview_after.png

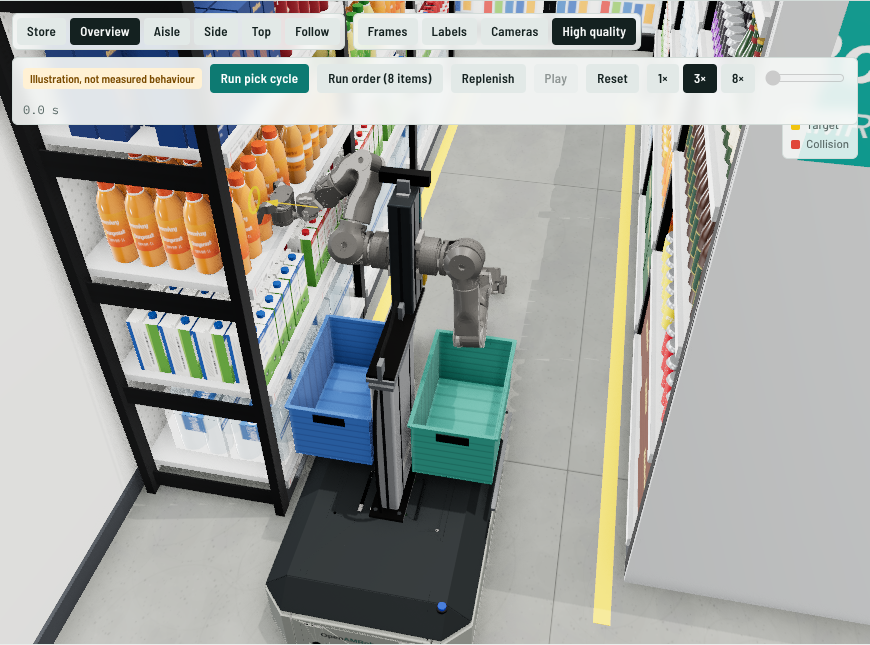
evidence/2026-10-27-store-media/robot_overview_after.png
