openAMRobot/openamrobot-docs/evidence/2026-10-28-base-estop-reset/robot_1280x720_before_rear.png

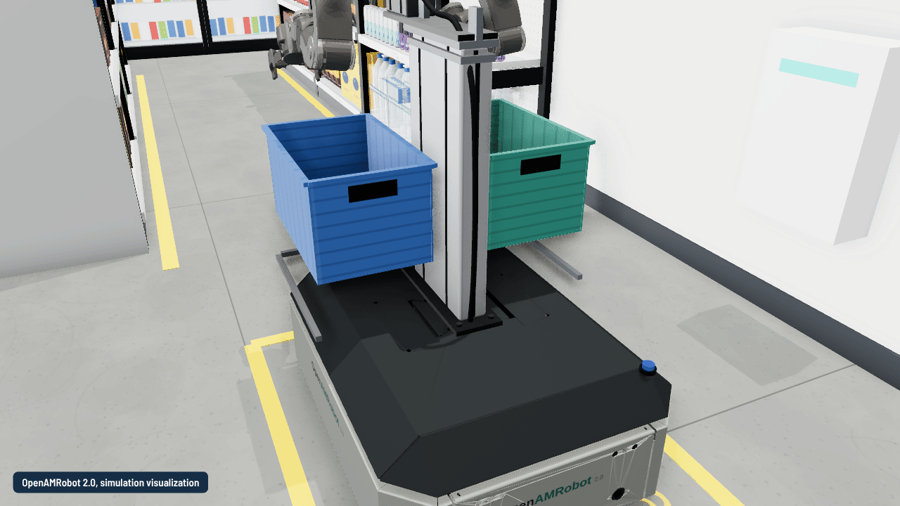
evidence/2026-10-28-base-estop-reset/robot_1280x720_before_rear.png
