openAMRobot/openamrobot-docs/evidence/2026-10-28-chest-riser-rerender/column_top_L1350.png

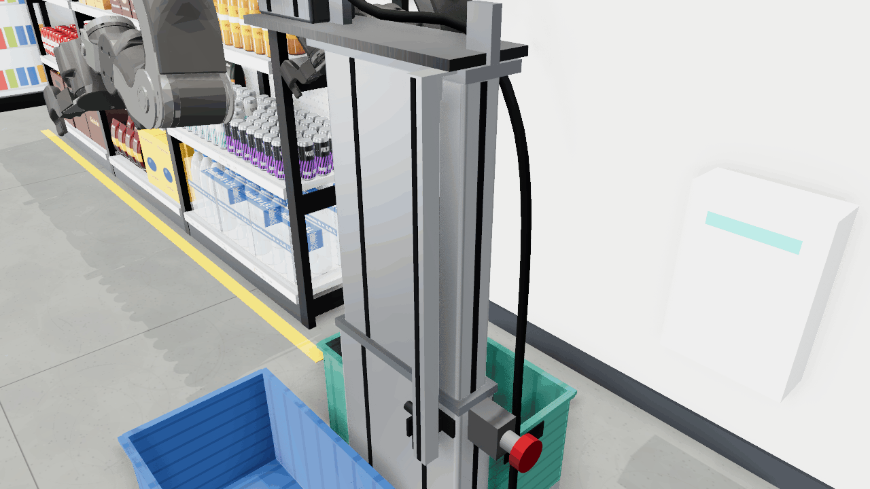
evidence/2026-10-28-chest-riser-rerender/column_top_L1350.png
