openAMRobot/openamrobot-docs/evidence/2026-10-28-chest-riser-rerender/page_checks/robot_375_media_section.png

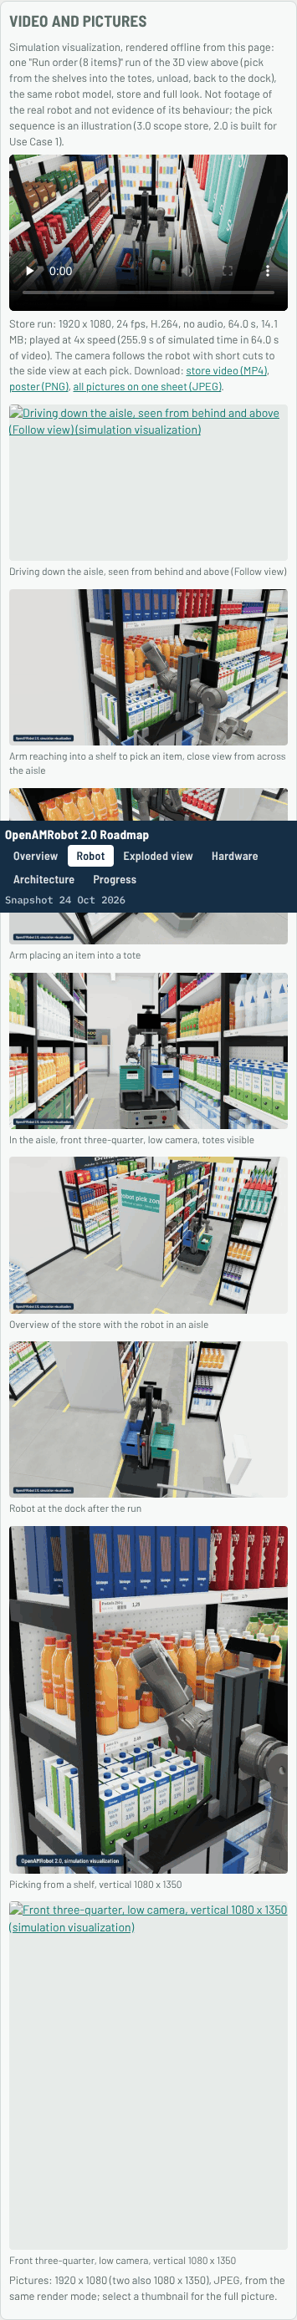
evidence/2026-10-28-chest-riser-rerender/page_checks/robot_375_media_section.png
