openAMRobot/openamrobot-docs/evidence/2026-10-28-chest-riser-rerender/store_media/store_frame_30pct_0461.jpg

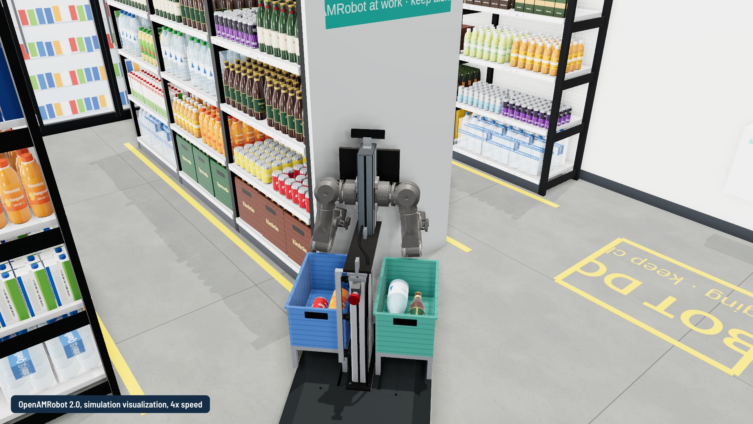
evidence/2026-10-28-chest-riser-rerender/store_media/store_frame_30pct_0461.jpg
