openAMRobot/openamrobot-docs/evidence/2026-10-28-chest-riser-rerender/store_media/store_frame_70pct_1075.jpg

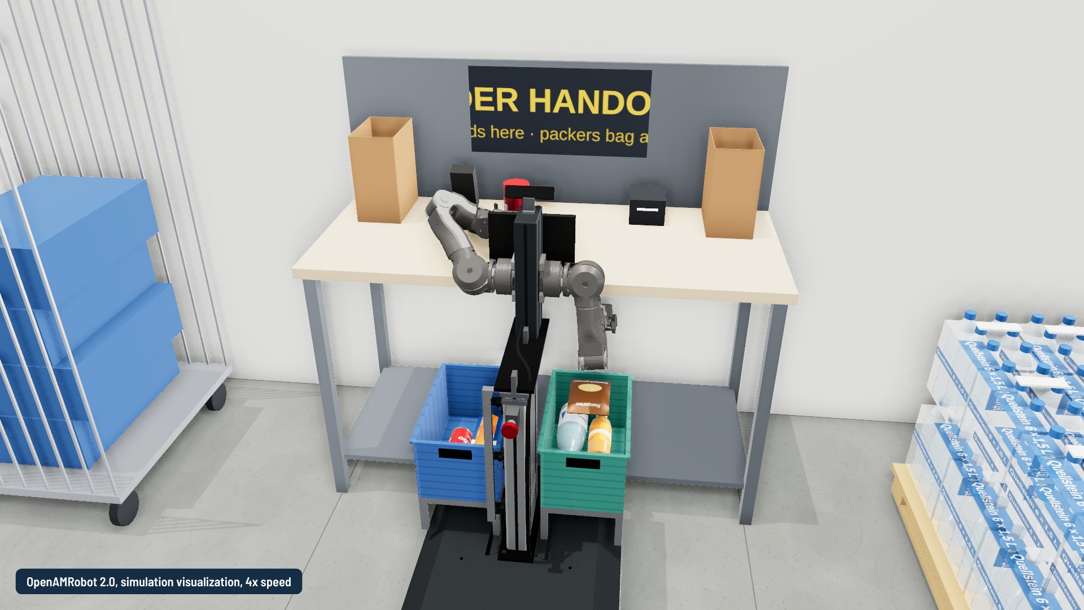
evidence/2026-10-28-chest-riser-rerender/store_media/store_frame_70pct_1075.jpg
