openAMRobot/openamrobot-docs/evidence/2026-10-28-chest-riser-rerender/store_t65_second_estop_overlap.png

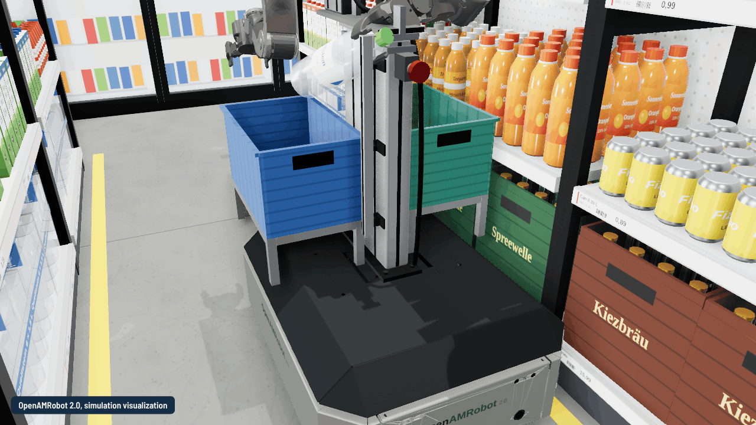
evidence/2026-10-28-chest-riser-rerender/store_t65_second_estop_overlap.png
