openAMRobot/openamrobot-docs/evidence/2026-11-02-roadmap-update/exploded_rear_view.jpg

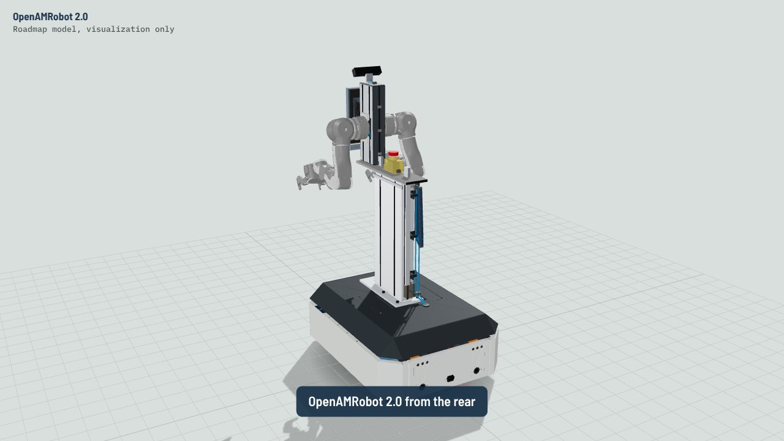
evidence/2026-11-02-roadmap-update/exploded_rear_view.jpg
