openAMRobot/openamrobot-docs/evidence/2026-11-02-roadmap-update/front_bay_opened.jpg

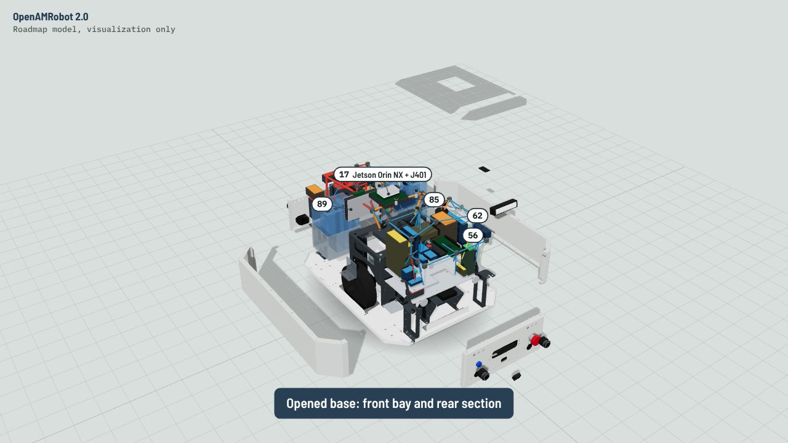
evidence/2026-11-02-roadmap-update/front_bay_opened.jpg
