openAMRobot/openamrobot-docs/evidence/2026-11-02-roadmap-update/lift_rear_L1350.jpg

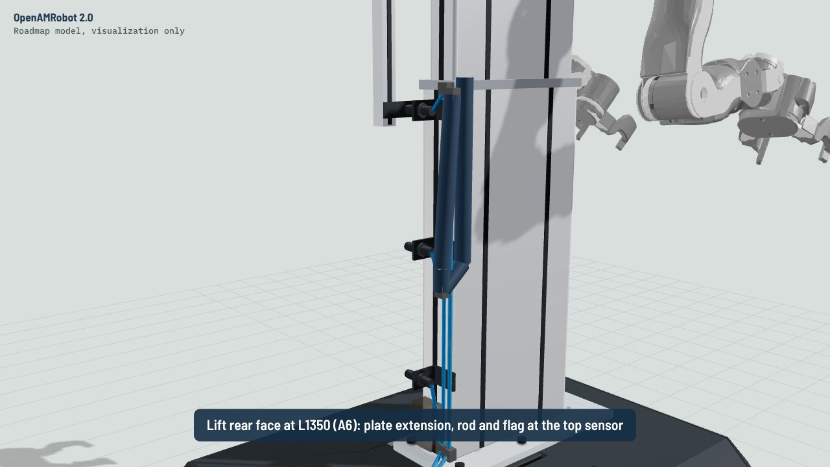
evidence/2026-11-02-roadmap-update/lift_rear_L1350.jpg
