openAMRobot/openamrobot-docs/evidence/2026-11-02-roadmap-update/rear_section_side.jpg

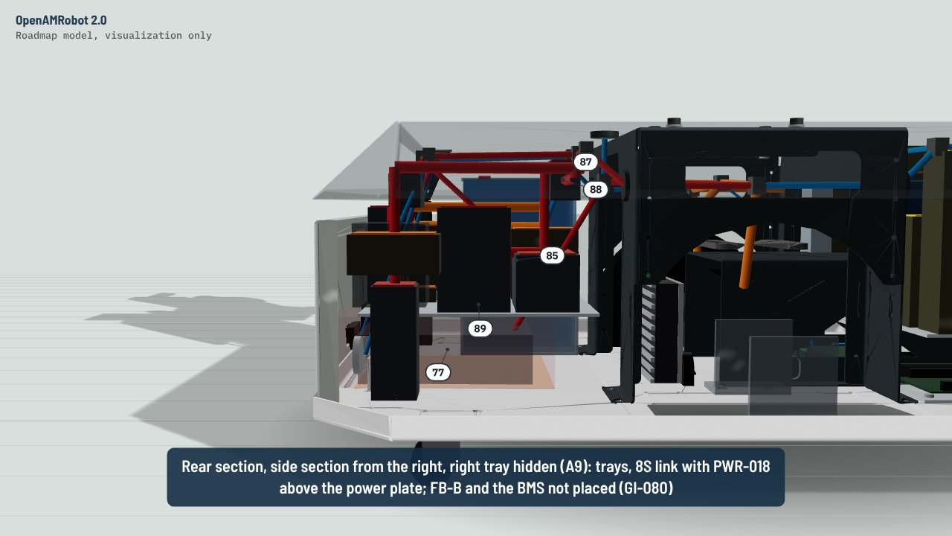
evidence/2026-11-02-roadmap-update/rear_section_side.jpg
