openAMRobot/openamrobot-docs/evidence/2026-11-02-roadmap-update/robot_rear.jpg

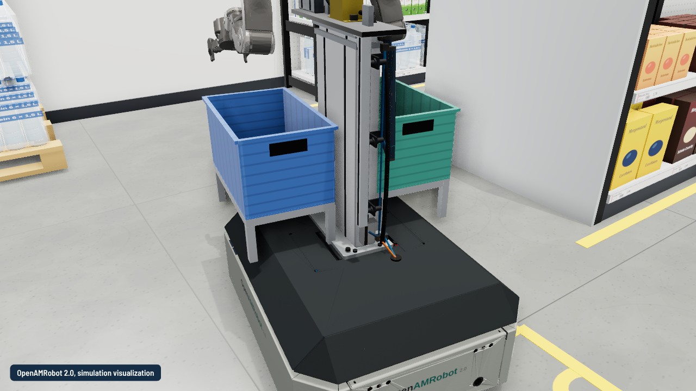
evidence/2026-11-02-roadmap-update/robot_rear.jpg
