openAMRobot/openamrobot-docs/evidence/2026-11-02-roadmap-update/upper_body_side.jpg

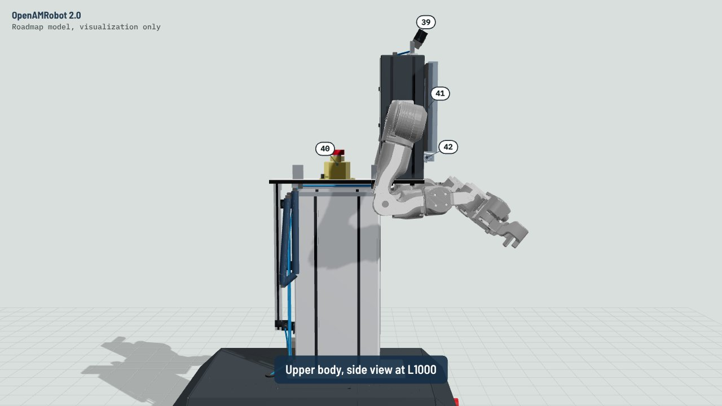
evidence/2026-11-02-roadmap-update/upper_body_side.jpg
