openAMRobot/openamrobot-docs/evidence/2026-11-03-harness/base_side_harness.png

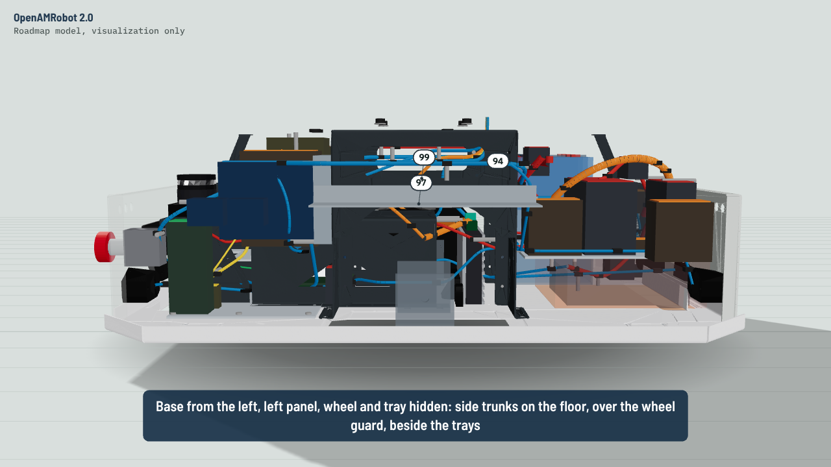
evidence/2026-11-03-harness/base_side_harness.png
