openAMRobot/openamrobot-docs/evidence/2026-11-03-harness/lift_chain_L1000.png

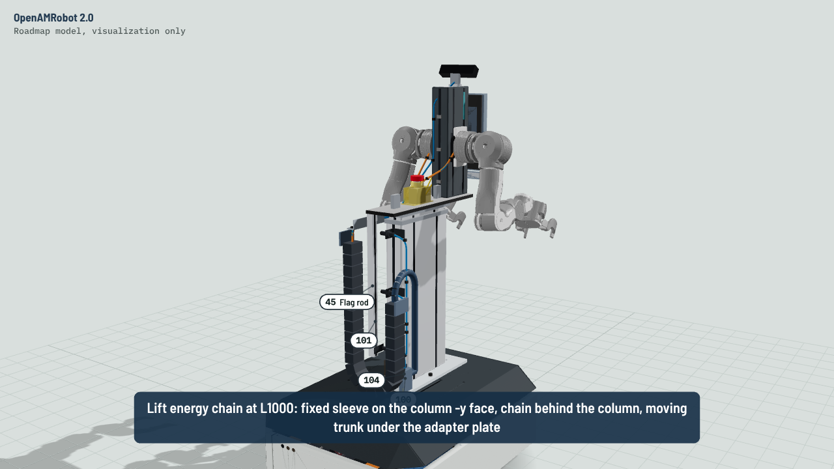
evidence/2026-11-03-harness/lift_chain_L1000.png
