openAMRobot/openamrobot-docs/evidence/2026-11-04-layout-harness-flag/after/C1_central_passage_top.png

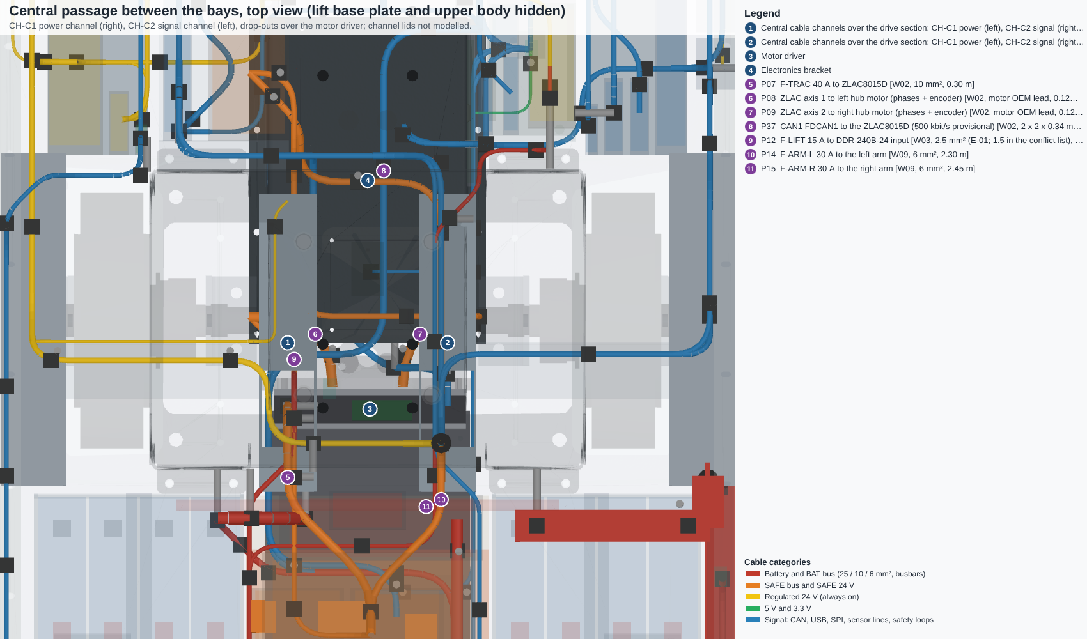
evidence/2026-11-04-layout-harness-flag/after/C1_central_passage_top.png
