openAMRobot/openamrobot-docs/evidence/2026-11-04-layout-harness-flag/after/C2_central_channels_3d.png

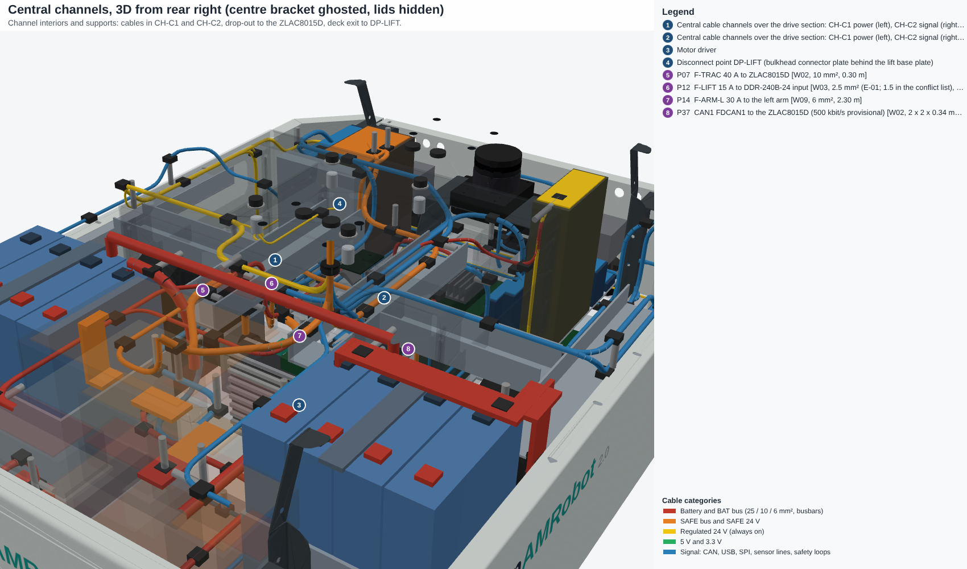
evidence/2026-11-04-layout-harness-flag/after/C2_central_channels_3d.png
