openAMRobot/openamrobot-docs/evidence/2026-11-04-layout-harness-flag/after/F1_flag_rod_rear_L1000.png

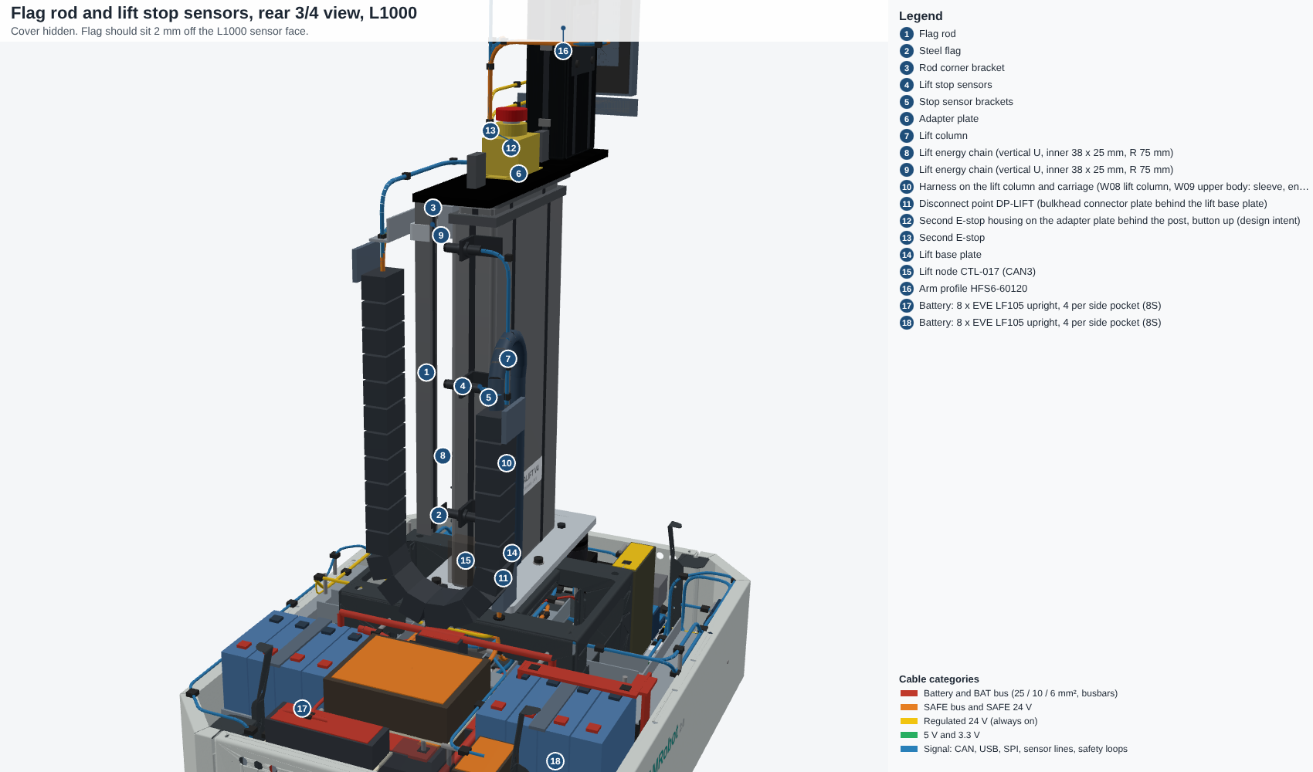
evidence/2026-11-04-layout-harness-flag/after/F1_flag_rod_rear_L1000.png
