openAMRobot/openamrobot-docs/evidence/2026-11-04-layout-harness-flag/after/F2_flag_rod_rear_L1350.png

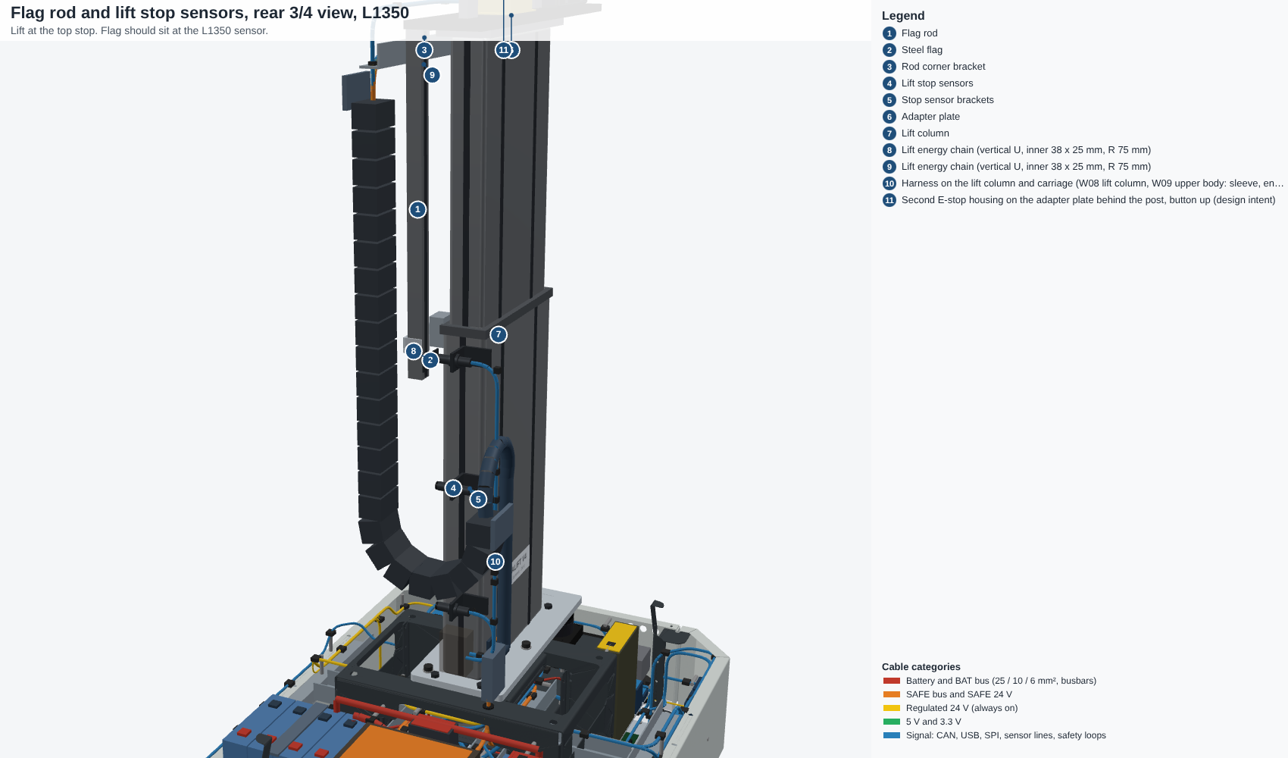
evidence/2026-11-04-layout-harness-flag/after/F2_flag_rod_rear_L1350.png
