openAMRobot/openamrobot-docs/evidence/2026-11-04-layout-harness-flag/after/F5_flag_rod_rear_straight_L1175.png

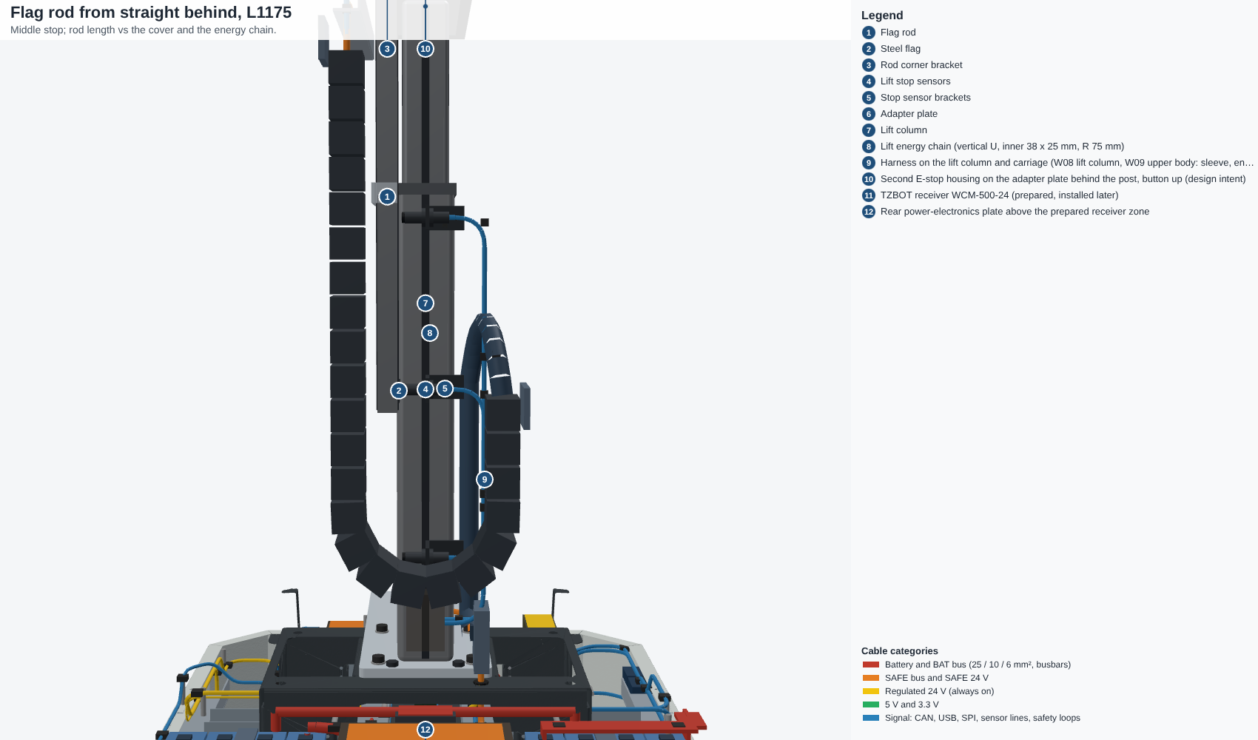
evidence/2026-11-04-layout-harness-flag/after/F5_flag_rod_rear_straight_L1175.png
