openAMRobot/openamrobot-docs/evidence/2026-11-04-layout-harness-flag/after/FB2_front_bay_side_zones_3d.png

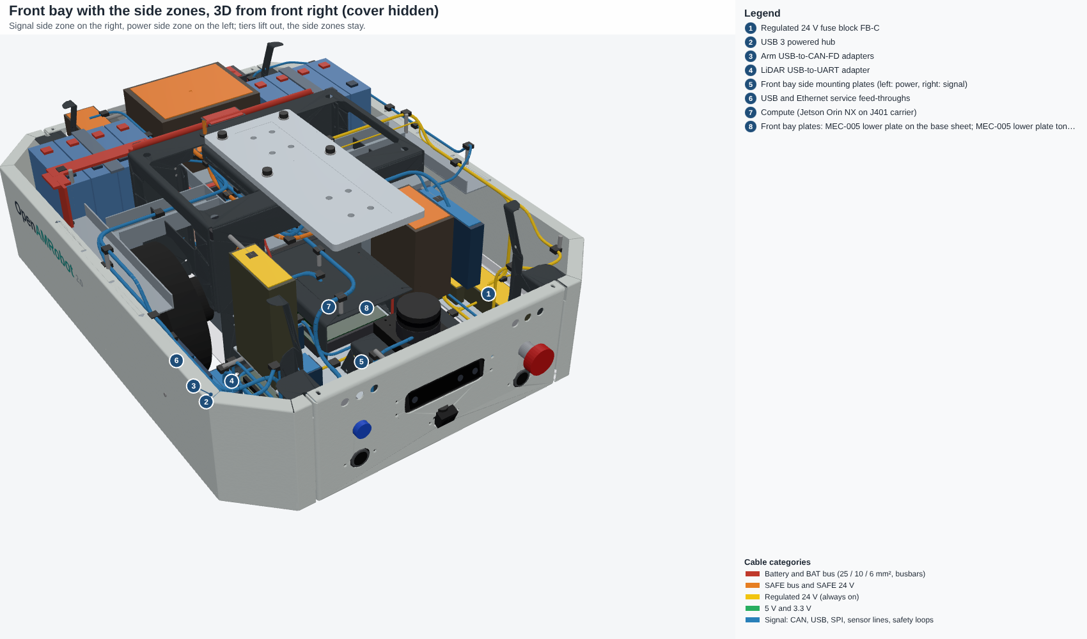
evidence/2026-11-04-layout-harness-flag/after/FB2_front_bay_side_zones_3d.png
