openAMRobot/openamrobot-docs/evidence/2026-11-04-layout-harness-flag/after/H1_harness_rear_W01_W02.png

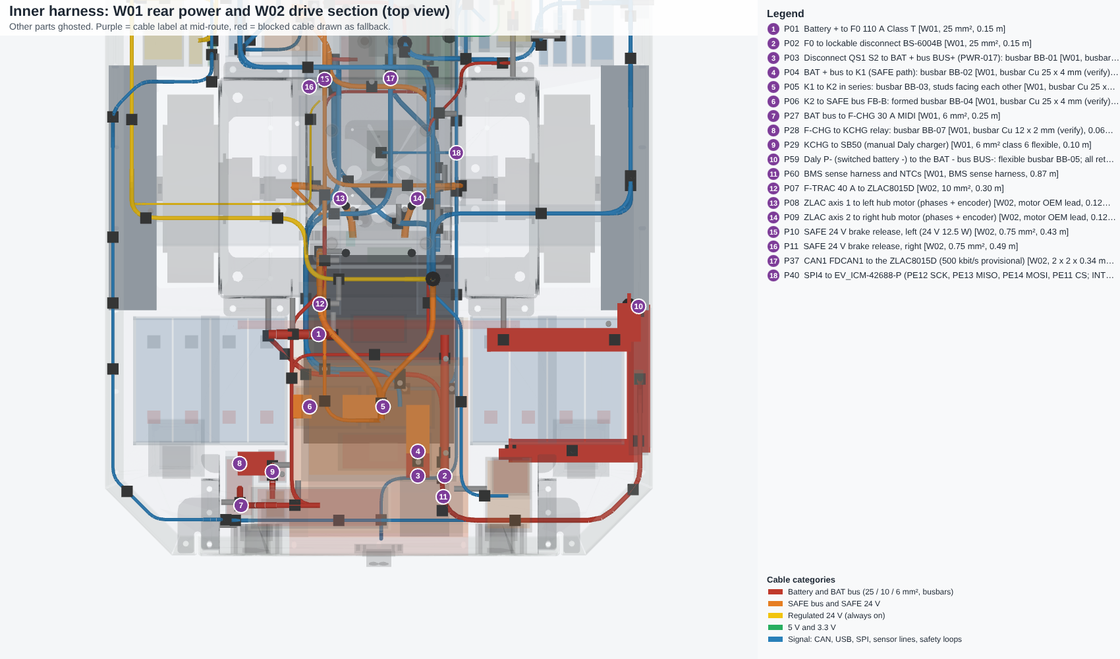
evidence/2026-11-04-layout-harness-flag/after/H1_harness_rear_W01_W02.png
