openAMRobot/openamrobot-docs/evidence/2026-11-04-layout-harness-flag/after/H2_harness_front_W05_W07.png

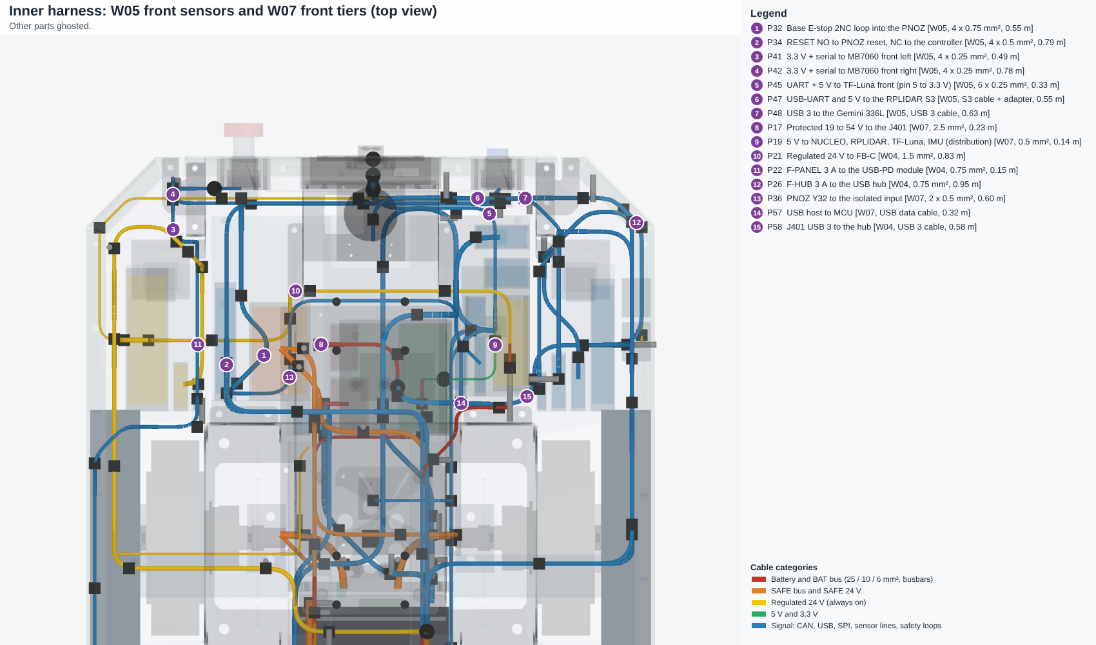
evidence/2026-11-04-layout-harness-flag/after/H2_harness_front_W05_W07.png
