openAMRobot/openamrobot-docs/evidence/2026-11-04-layout-harness-flag/after/H5_harness_all_top.png

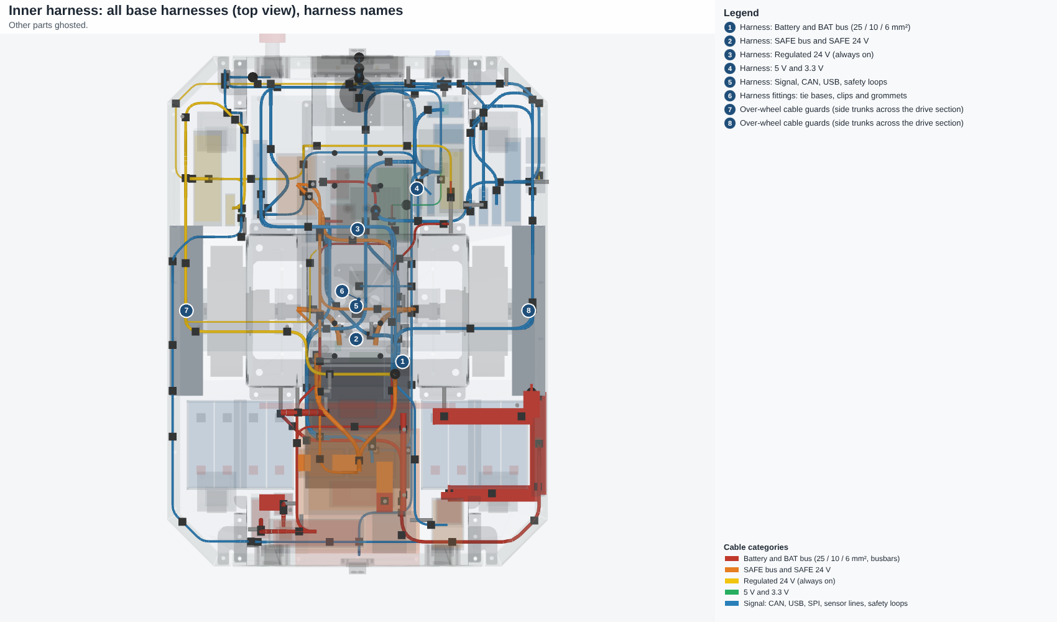
evidence/2026-11-04-layout-harness-flag/after/H5_harness_all_top.png
