openAMRobot/openamrobot-docs/evidence/2026-11-04-layout-harness-flag/after/R4_rear_module_3d.png

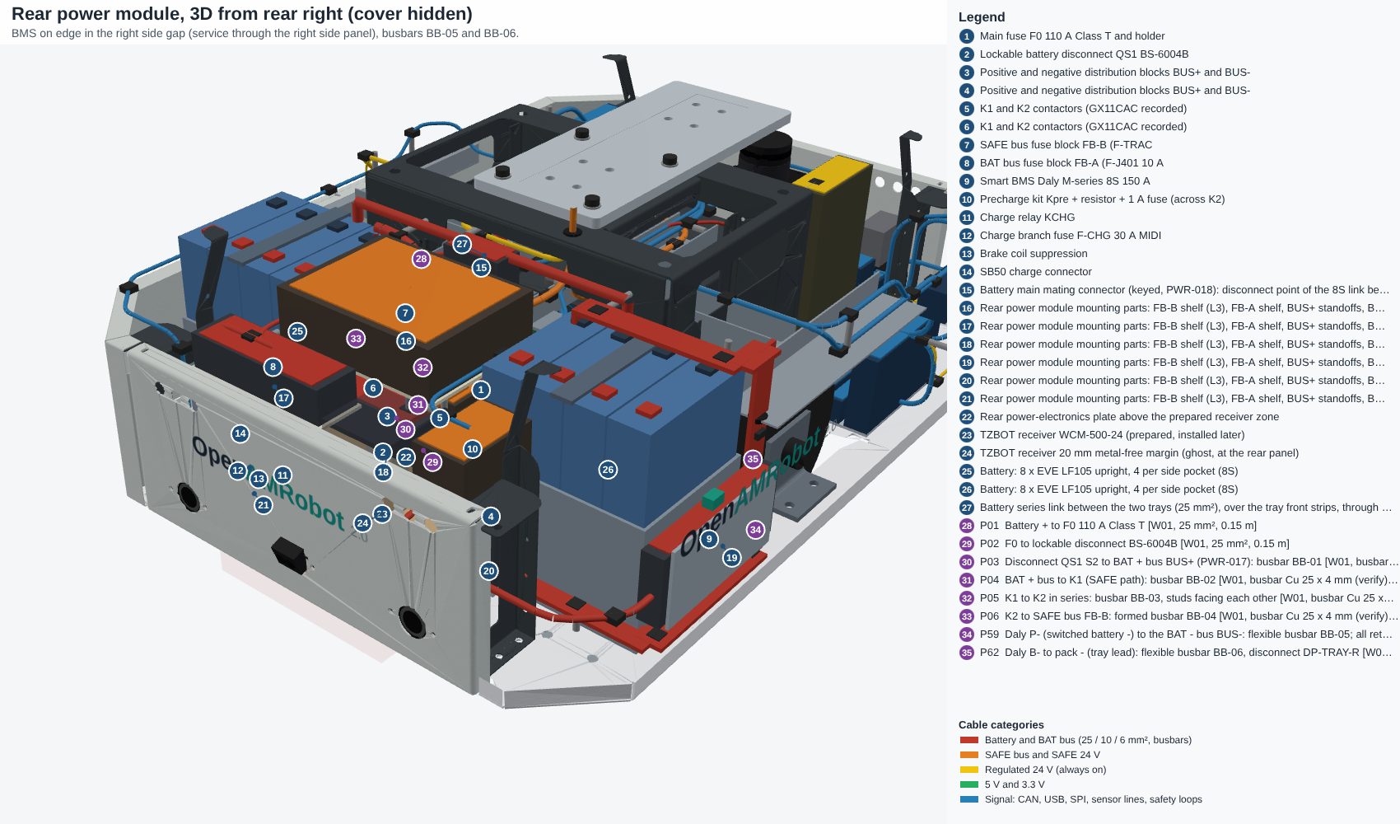
evidence/2026-11-04-layout-harness-flag/after/R4_rear_module_3d.png
