openAMRobot/openamrobot-docs/evidence/2026-11-04-layout-harness-flag/after/S1_left_corridor.png

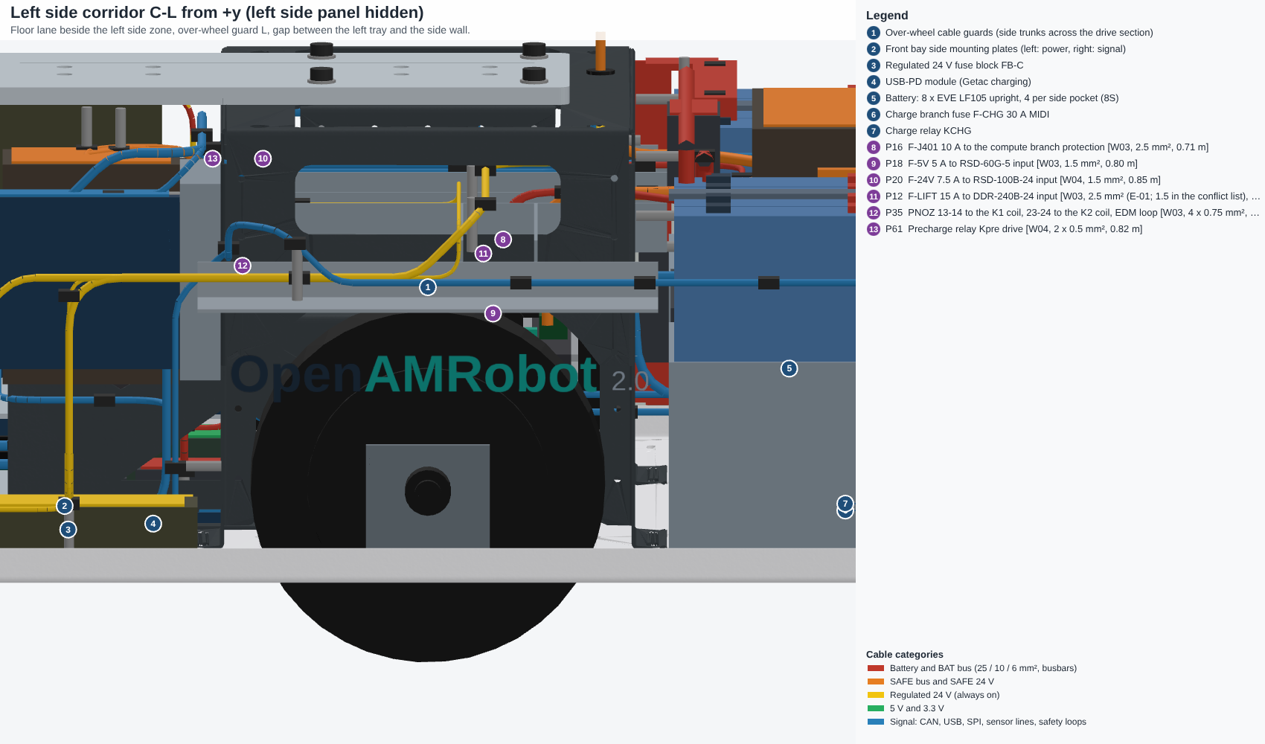
evidence/2026-11-04-layout-harness-flag/after/S1_left_corridor.png
