openAMRobot/openamrobot-docs/evidence/2026-11-04-layout-harness-flag/after/S2_right_corridor.png

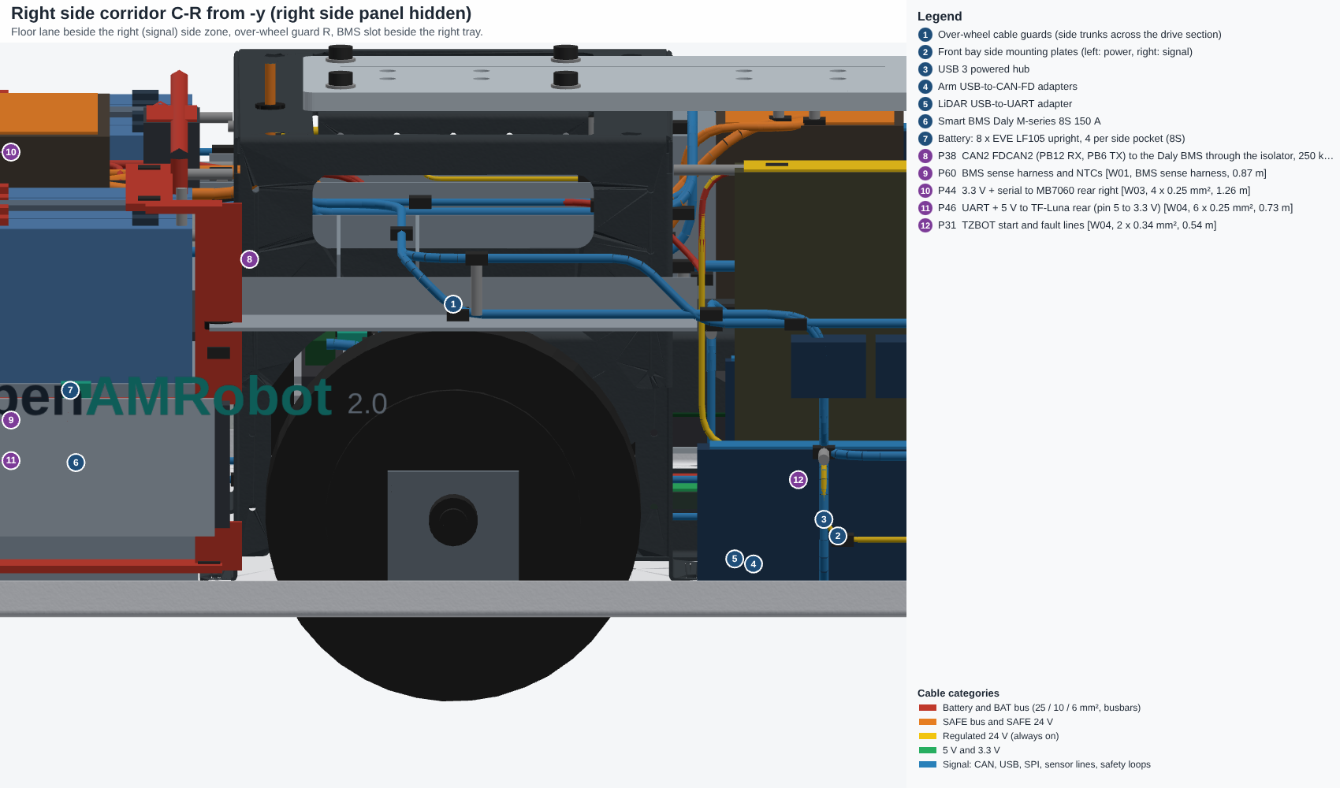
evidence/2026-11-04-layout-harness-flag/after/S2_right_corridor.png
