openAMRobot/openamrobot-docs/evidence/2026-11-04-layout-harness-flag/after/U1_upper_rear_cables.png

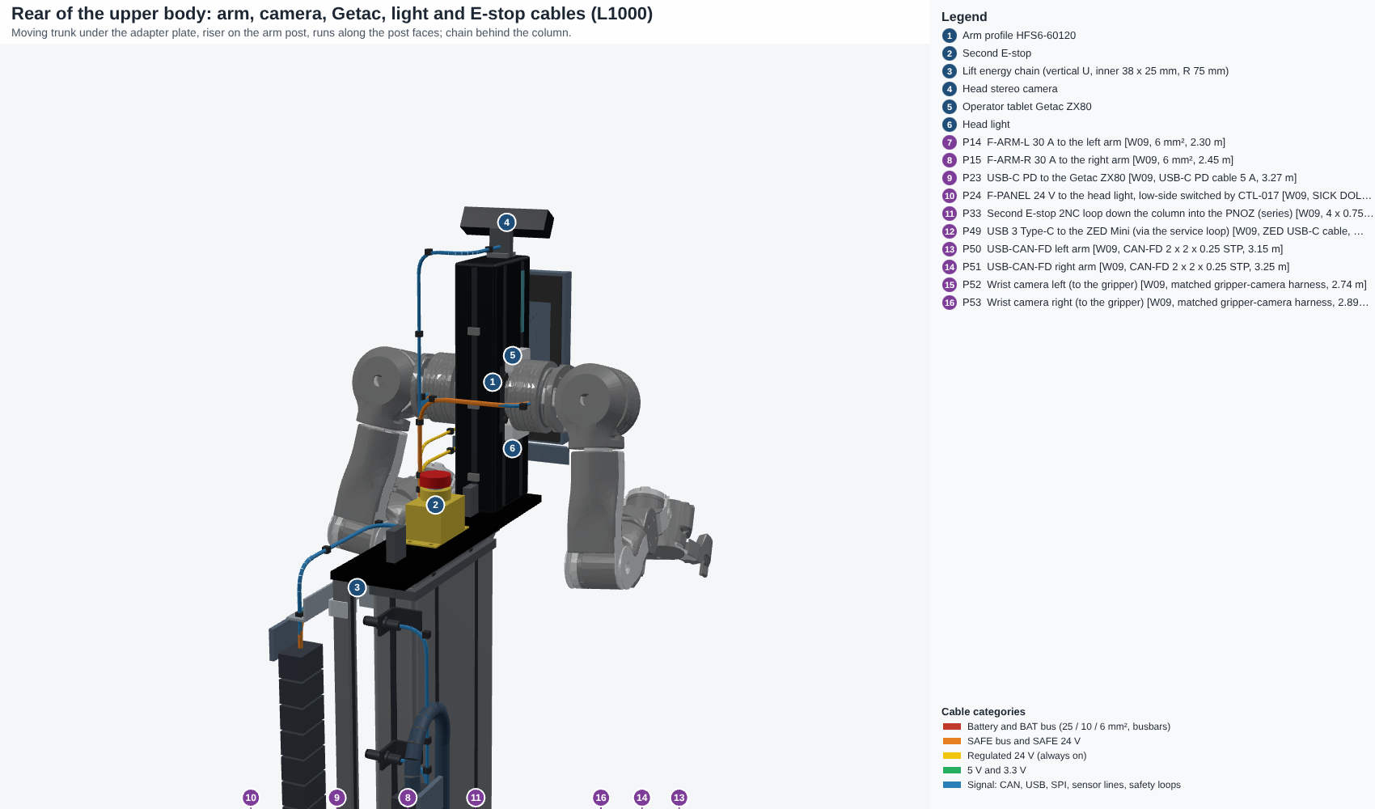
evidence/2026-11-04-layout-harness-flag/after/U1_upper_rear_cables.png
