openAMRobot/openamrobot-docs/evidence/2026-11-04-layout-harness-flag/before/B2_rear_bay_3d.png

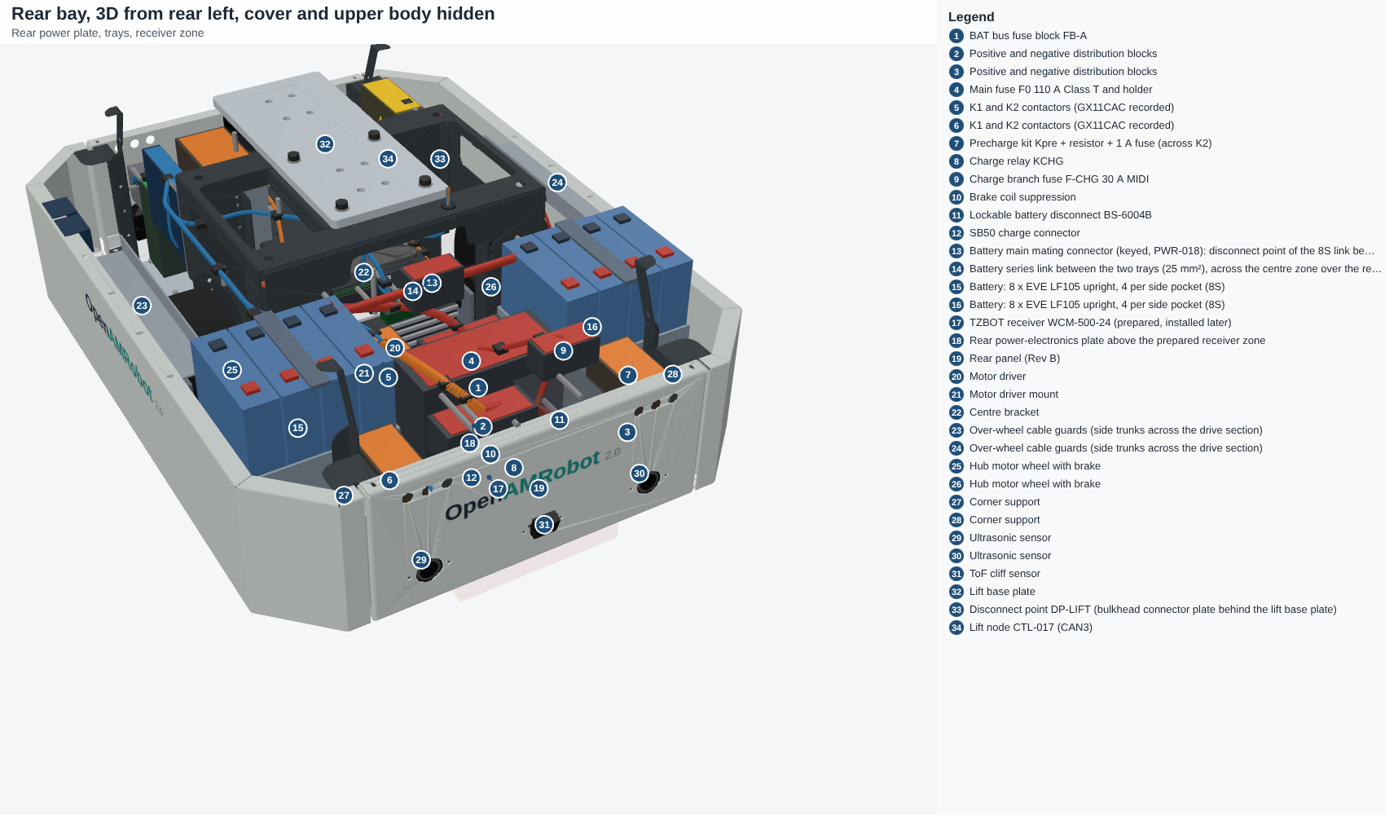
evidence/2026-11-04-layout-harness-flag/before/B2_rear_bay_3d.png
