openAMRobot/openamrobot-docs/evidence/2026-11-04-layout-harness-flag/before/B3_front_bay_top.png

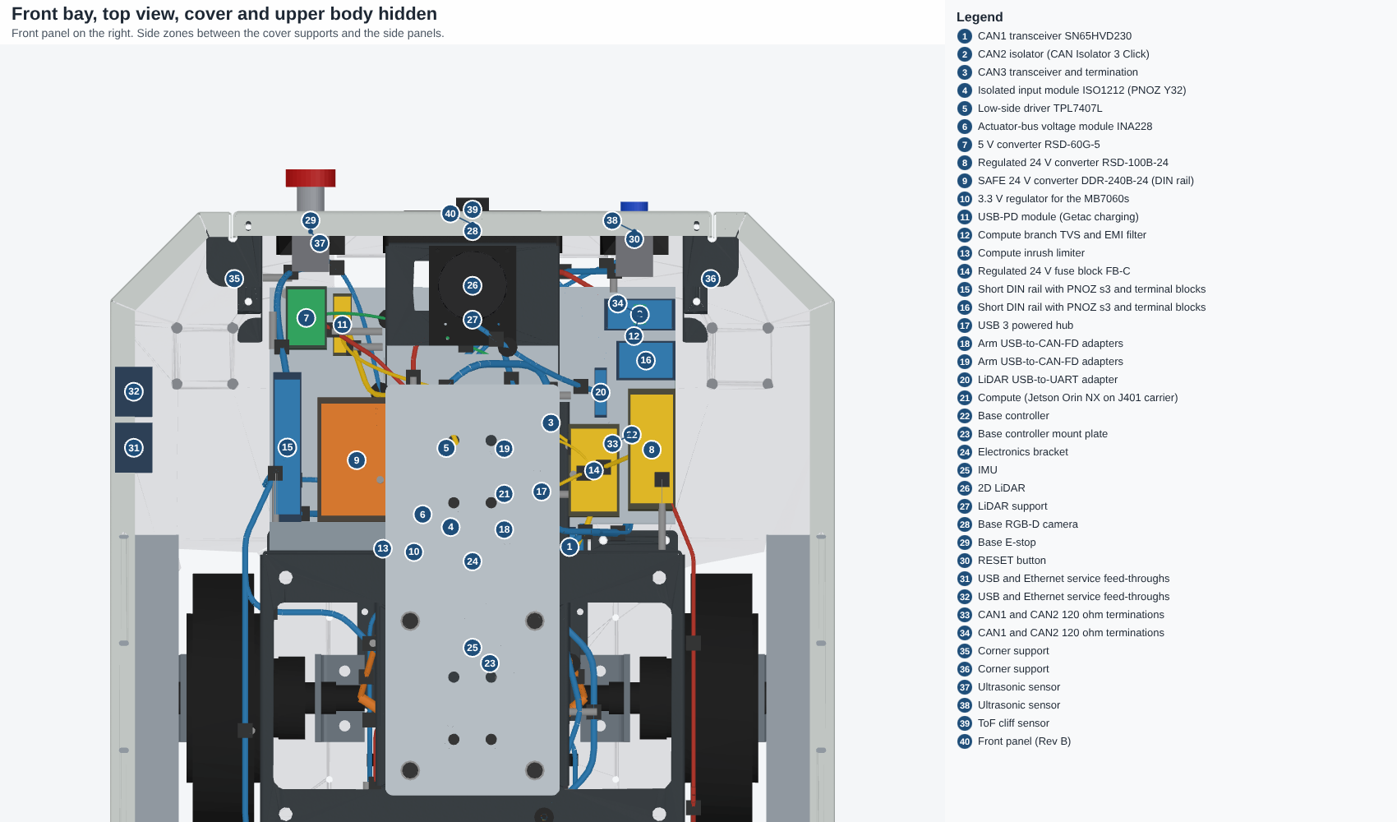
evidence/2026-11-04-layout-harness-flag/before/B3_front_bay_top.png
