openAMRobot/openamrobot-docs/evidence/2026-11-04-layout-harness-flag/before/F3_flag_rod_side_close_L1000.png

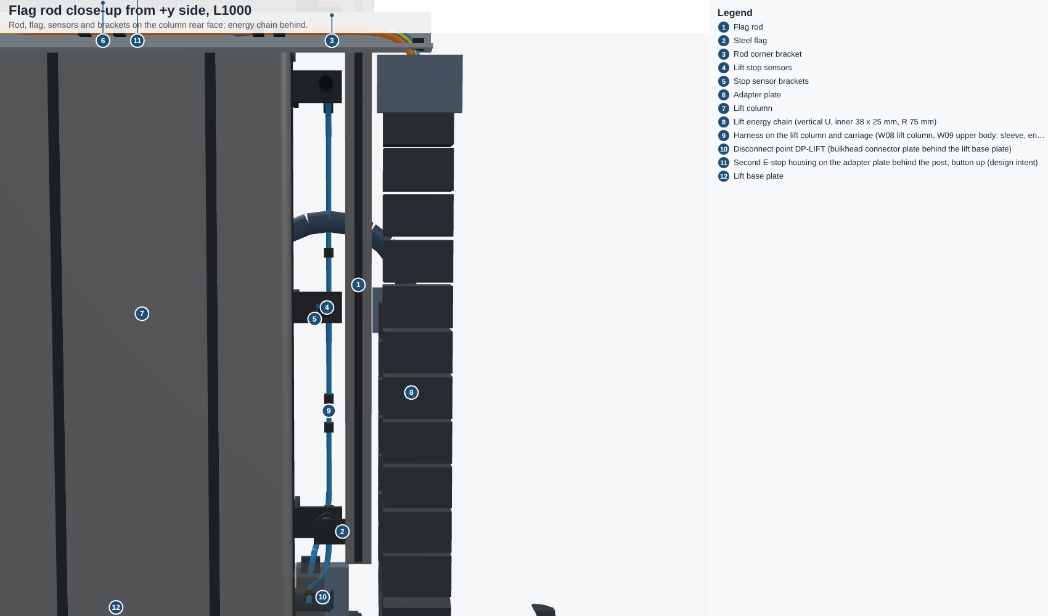
evidence/2026-11-04-layout-harness-flag/before/F3_flag_rod_side_close_L1000.png
