openAMRobot/openamrobot-docs/evidence/2026-11-04-layout-harness-flag/before/F4_flag_rod_plan_section.png

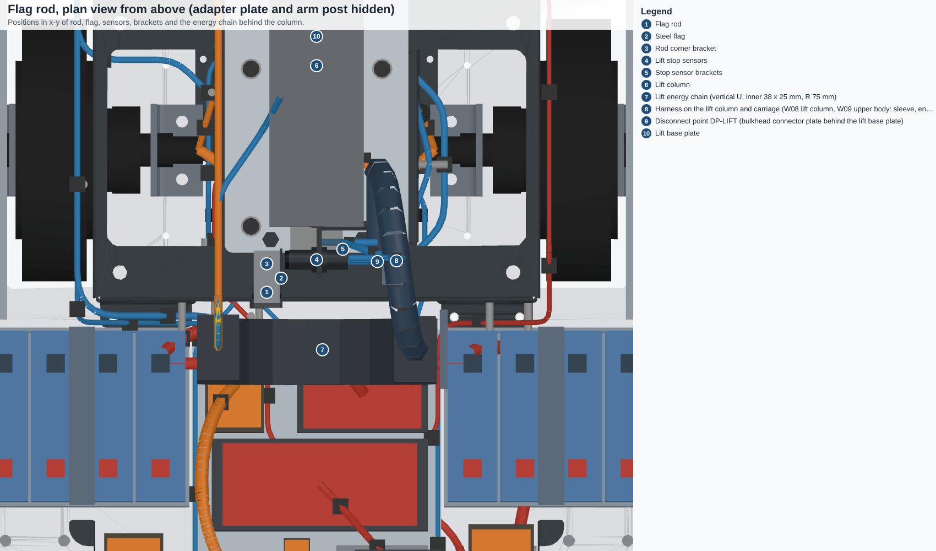
evidence/2026-11-04-layout-harness-flag/before/F4_flag_rod_plan_section.png
