openAMRobot/openamrobot-docs/evidence/2026-11-04-layout-harness-flag/before/H3_harness_side_trunks_W03_W04.png

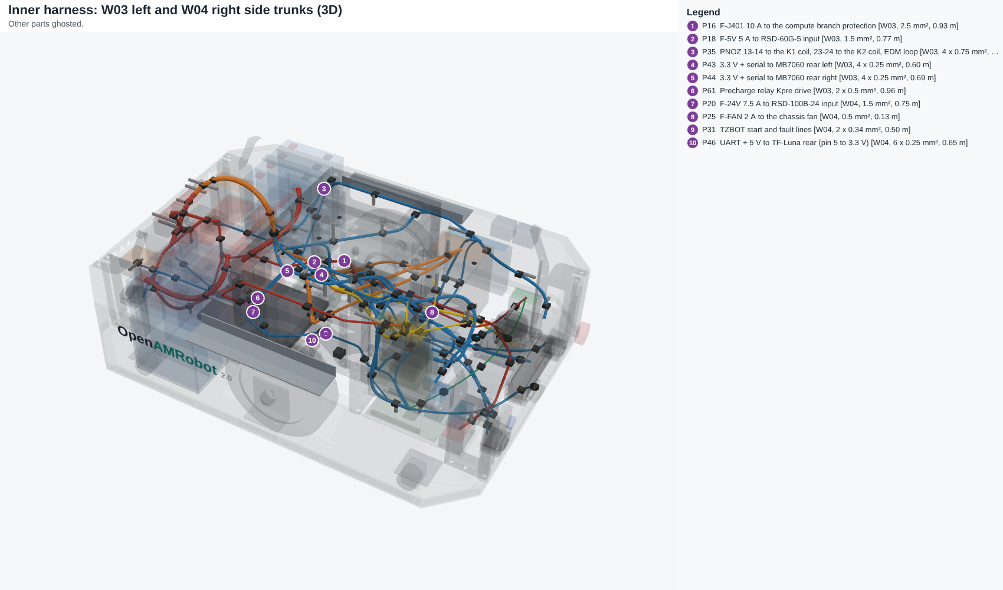
evidence/2026-11-04-layout-harness-flag/before/H3_harness_side_trunks_W03_W04.png
