openAMRobot/openamrobot-docs/evidence/2026-11-04-layout-harness-flag/compare/compare_B1_rear_bay_top.png

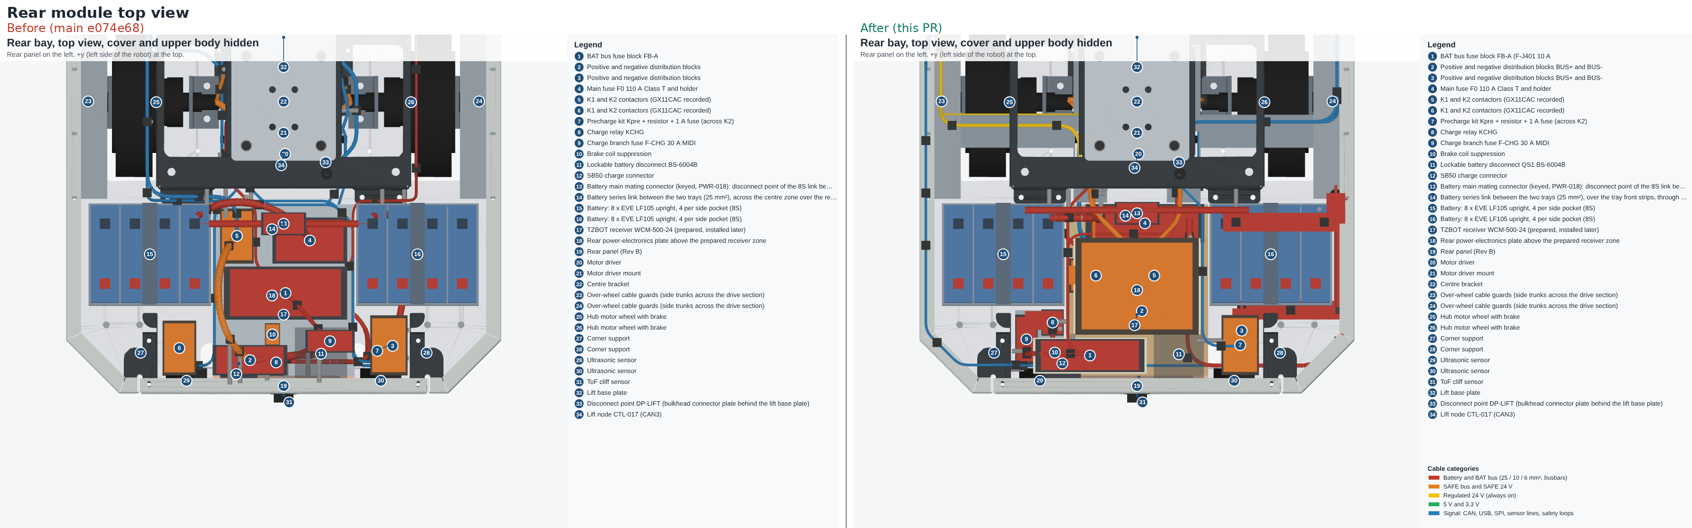
evidence/2026-11-04-layout-harness-flag/compare/compare_B1_rear_bay_top.png
