openAMRobot/openamrobot-docs/evidence/2026-11-04-layout-harness-flag/compare/compare_B4_front_bay_3d.png

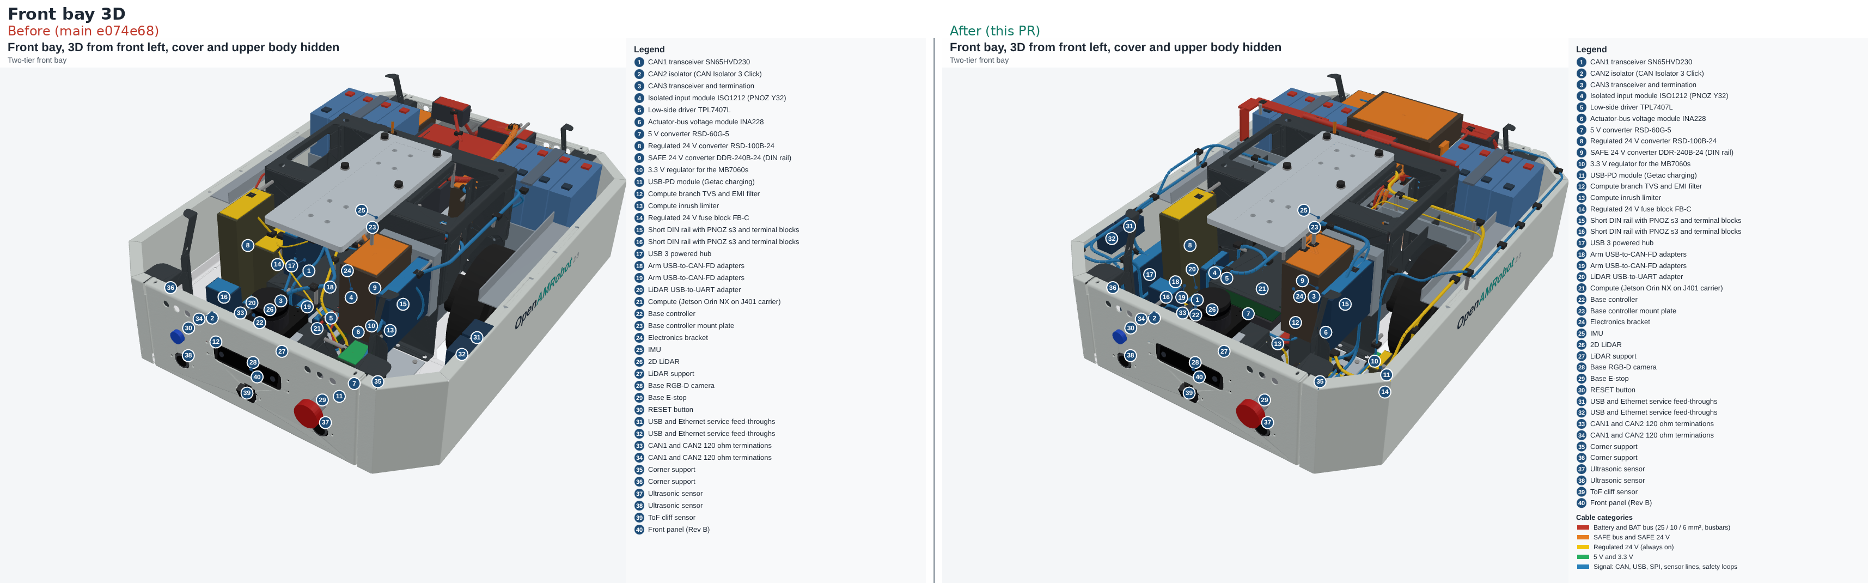
evidence/2026-11-04-layout-harness-flag/compare/compare_B4_front_bay_3d.png
