openAMRobot/openamrobot-docs/evidence/2026-11-04-layout-harness-flag/compare/compare_B5_base_overview_top.png

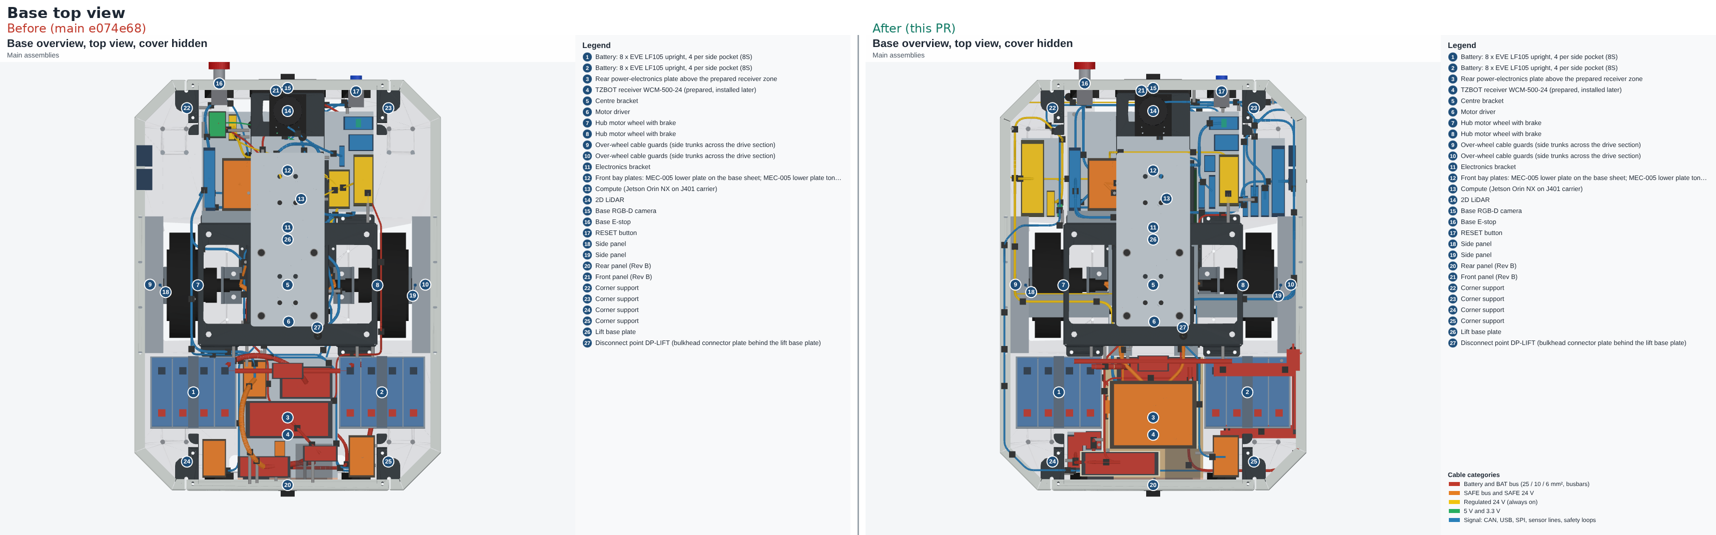
evidence/2026-11-04-layout-harness-flag/compare/compare_B5_base_overview_top.png
