openAMRobot/openamrobot-docs/evidence/2026-11-04-media/contact_stills.jpg

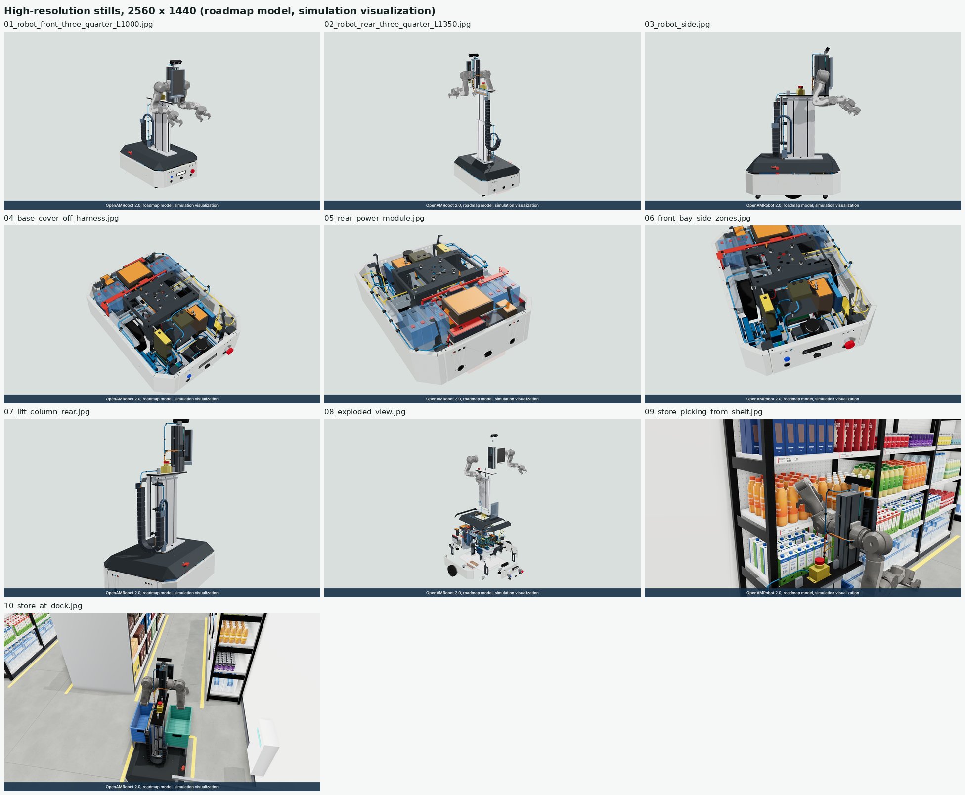
evidence/2026-11-04-media/contact_stills.jpg
