openAMRobot/openamrobot-docs/evidence/2026-11-09-media/contact_stills.jpg

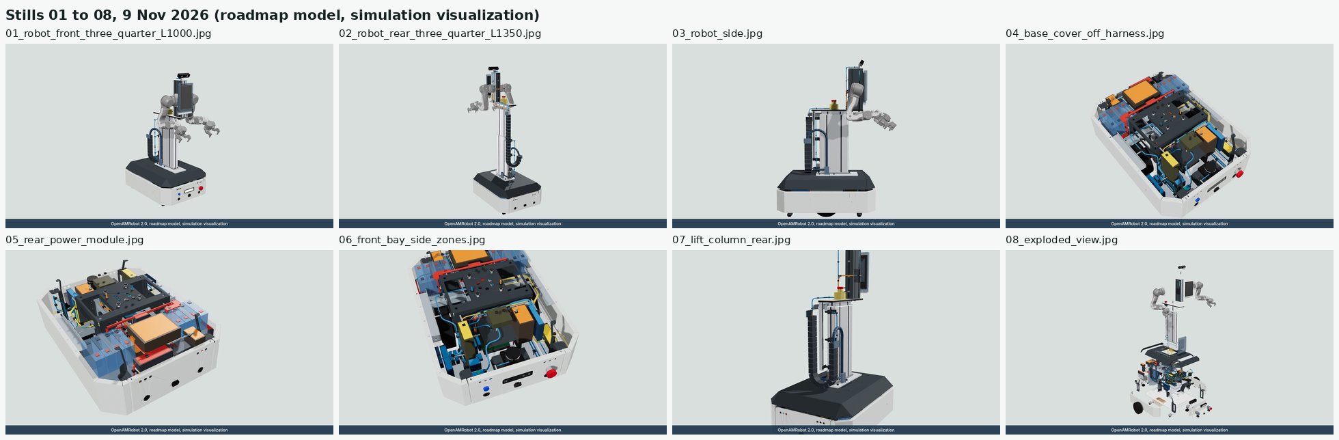
evidence/2026-11-09-media/contact_stills.jpg
