openAMRobot/openamrobot-docs/docs/assets/roadmap/model/bom_coverage.csv

id | part | part_number | qty | subsystem | onboard | class | geometry_source | position_source | model_qty | model_component | mass_kg | mass_source | drawn | reason_not_drawn
ARM-001 | Primary application arms (bimanual set) | OpenArm 2.0 Full Option target: bimanual arms with two fingertip cameras and ZED-121210 to | 1 | Manipulation | y | CAD-derived | openarm_description 14ff67b meshes | datums.yaml: J1_A at y +-0.031, 0.166 above the carriage | 1 | openarm | 12.26 | upstream URDF nominal link masses (2 x 6.13 kg incl. gripper) | y
ARM-002 | OpenArm KER bimanual leader kit | OpenArm KER bimanual leader set | 1 | Manipulation | n | not drawn |  |  | 0 | none |  |  | n | offboard
ARM-003 | Head stereo camera, Stereolabs ZED Mini | ZED-121210; USB 3 Type-C; no GMSL2; supplied lift-carriage mount and routing fit to be con | 1 | Manipulation | y | primitive | datums head_camera_size 26.5 x 124.5 x 30.5 | datums.yaml (lens 0.042 ahead, 0.223 above J1_A), hp30 | 1 | head_camera | 0.0629 | datums head_camera_mass | y
ARM-004 | Wrist RGB cameras | Exact integrated OpenArm 2.0 fingertip-camera SKU, mount geometry and optical transforms t | 2 | Manipulation | y | placeholder | 18 x 18 x 12 mm box (robot page fitting) | datums left/right_wrist_camera_pose (placeholder) | 2 | inside:openarm | 0.02 | estimate | y
ARM-005 | Grippers | OpenArm 2.0 compact grippers | 2 | Manipulation | y | CAD-derived | openarm_description gripper meshes | upstream kinematics | 2 | inside:openarm | 0.0 | included in ARM-001 | y
ARM-006 | Arm USB-to-CAN-FD adapters | Exact supported adapter revision | 2 | Manipulation | y | proposed | proposed size: 60x25x15 mm | proposed in the side_r (SIG domain) | 2 | bay_usbcan | 0.06 | estimate | y
ARM-007 | Bench arm power adapters | 24 V / 15 A per plan; confirm packing list | 2 | Manipulation | n | not drawn |  |  | 0 | none |  |  | n | offboard
ARM-008 | Kit E-stop (ESTOP-KIT), withdrawn: the second robot button is SAF-001 on the moving adapter plate | Exact kit stop assembly | 0 | Manipulation | n | not drawn |  |  | 0 | none |  |  | n | qty 0 (withdrawn)
ARM-009 | Head camera data/power cable | Stereolabs ZED Mini USB 3 Type-C cable/interface; no GMSL2 path for ZED-121210; supplied l | 1 | Manipulation | y | proposed | cable tube | harness route via the lift energy chain | 1 | harness | 0.05 | estimate | y
ARM-010 | Wrist camera cable sets | Matched gripper-camera harness | 2 | Manipulation | y | proposed | cable tube | harness route along the arms (placeholder) | 2 | harness | 0.06 | estimate | y
ARM-011 | Head-camera supplied mount and OpenAMRobot adapter | Supplied mount holds the ZED Mini at its ends; OpenAMRobot pitch bracket on the profile to | 1 | Camera and arm interface | y | primitive | datums head_camera_bracket_* | datums.yaml (post top) | 1 | head_camera_bracket | 0.05 | estimate | y
AUX-001 | Head light | FLDL-i150x15-W, 158 x 17 x 20 mm, 24 V 0.32 A, M8 4-pin; flat on an aluminium cooling plat | 1 | Upper-body auxiliary | y | placeholder | datums head_light_size 20 x 158 x 17 | datums.yaml head_light_gap_below_tablet | 1 | head_light | 0.11 | datums head_light_mass (upper bound) | y
AUX-002 | Head light low-side switching on the lift node | Low-side switch channel on CTL-017 (no separate part) | 1 | Upper-body auxiliary | y | not drawn |  |  | 0 | none |  |  | n | function on CTL-017, no separate part
AUX-003 | Head light cable | DOL-0804-G02MRN, M8 4-pin, 2 m | 1 | Upper-body auxiliary | y | proposed | cable tube | harness route via the lift energy chain | 1 | harness | 0.08 | estimate | y
CAM-001 | Base front RGB-D camera | Gemini 336L | 1 | Navigation sensing | y | envelope | PROVENANCE.yaml base_camera (Gemini 336L outline) | sensor_frames.yaml base_camera_link (0.387, 0, 0.046), bt10 | 1 | base_camera | 0.135 | 1 x 0.135 kg: Orbbec Gemini 336L specification: 135 g | y
CAM-002 | Base camera USB cable | Gemini 336L compatible USB 3 cable | 1 | Navigation sensing | y | proposed | cable tube | harness route | 1 | harness | 0.04 | estimate | y
CAP-001 | Capture workstation | PC with supported OpenArm/KER/LeRobot stack | 1 | Capture station | n | not drawn |  |  | 0 | none |  |  | n | offboard
CAP-002 | KER USB cable sets | Matched KER leader USB interfaces |  | Capture station | n | not drawn |  |  | 0 | none |  |  | n | offboard
CAP-003 | Dataset storage / backup | External storage or NAS allocation | 1 | Capture station | n | not drawn |  |  | 0 | none |  |  | n | offboard
CAP-004 | Calibration target / fixture | Rigid checkerboard/Charuco target, dimensions TBD | 1 | Capture station | n | not drawn |  |  | 0 | none |  |  | n | offboard
CAP-005 | KER desk mount / restraint | Matched bimanual support | 1 | Capture station | n | not drawn |  |  | 0 | none |  |  | n | offboard
CMP-001 | Jetson Orin NX 8 GB compute module | Jetson Orin NX 8 GB (900-13767-0010-000) | 1 | Compute | y | envelope | PROVENANCE.yaml compute (Orin NX 8 GB on Robotics 104, D-01; earlier J401 outline until the Robotics 104 drawing) | CAD v0.2 electronics bracket MMP.04.00.00.002 top | 1 | compute | 0.25 | estimate | y
CMP-002 | Robotics carrier board | reComputer Robotics 104 carrier (exact SKU to confirm) | 1 | Compute | y | envelope | Robotics 104 carrier (D-01), earlier J401 outline until its drawing | CAD v0.2 | 1 | compute | 0.2 | estimate | y
CMP-003 | NVMe SSD | M.2 2280 NVMe PCIe Gen3 x4, 512 GB | 1 | Compute | y | envelope | inside the compute envelope | carrier M.2 slot | 1 | inside:compute | 0.008 | estimate | y
CMP-005 | Jetson heatsink and fan kit | Matched Robotics 104 / Orin NX 8 GB heatsink and fan kit (confirm fit) | 1 | Compute | y | envelope | inside the compute envelope | on the module | 1 | inside:compute | 0.15 | estimate | y
CMP-006 | Chassis cooling fan | 24 V COTS fan; exact size/SKU after thermal test | 1 | Compute | y | proposed | proposed 80 x 80 x 25: 80x80x25 mm | proposed: on the cover underside above the Jetson, exhaust through the cover; comes off with the cover, lead plugs in at DP-FAN (front end of CH-C1) | 1 | fan | 0.09 | estimate | y
CMP-007 | Wi-Fi interface and antennas | Robotics 104-compatible Wi-Fi kit or external access point | 1 | Compute | y | not drawn |  |  | 0 | inside:compute | 0.02 | estimate | n | carrier M.2 Wi-Fi inside the compute envelope; antenna position not decided
CMP-009 | USB 3 powered hub | ST7300USBME, 7-port industrial USB 3 hub | 1 | Compute | y | proposed | catalogue outline, verify: 135x80x25 mm | proposed in the side_r (SIG domain) | 1 | bay_usbhub | 0.35 | estimate from the catalogue class | y
CTL-001 | STM32H723ZG base controller (Gate B) | NUCLEO-H723ZG | 1 | Base controller | y | envelope | NUCLEO-144 133.34 x 70 mm (UM2407) | CAD v0.2 controller plate MMP.04.00.00.003 | 1 | base_controller | 0.08 | estimate | y
CTL-002 | mikroBUS adapter for the Nucleo (removed) | Arduino UNO click shield; removed 1 Nov 2026, the IMU board connects to SPI4 directly | 0 | Base controller | n | not drawn |  |  | 0 | none |  |  | n | qty 0 (removed, P-03 rev20.2)
CTL-003 | CAN1 non-isolated 3.3 V transceiver board | Waveshare SN65HVD230 CAN Board | 1 | Base controller | y | proposed | catalogue outline, verify: 32x21x10 mm | proposed in the front bay, upper shelf (second tier) (SIG domain) | 1 | bay_can1 | 0.006 | estimate from the catalogue class | y
CTL-004 | Complete isolated input module for PNOZ Y32 | Complete 24 V field-input / isolated 3.3 V logic-output module; channel 1 Y32, channel 2 s | 1 | Base controller | y | proposed | catalogue outline, verify: 64x51x12 mm | proposed in the front bay, upper shelf (second tier) (SIG domain) | 1 | bay_iso1212 | 0.02 | estimate from the catalogue class | y
CTL-008 | USB data cable, host to MCU | Host-to-NUCLEO connector-compatible data cable | 1 | Base controller | y | proposed | cable tube | harness route | 1 | harness | 0.03 | estimate | y
CTL-009 | CAN1 termination resistors | 120 ohm termination at two physical ends | 2 | Base controller | y | proposed | 120 ohm termination plug | CAN1 bus ends (cable_list.csv) | 2 | can_terms | 0.004 | estimate | y
CTL-010 | CAN2 termination resistors | 120 ohm termination at two physical ends | 2 | Base controller | y | proposed | 120 ohm termination plug | CAN2 bus ends (cable_list.csv) | 2 | can_terms | 0.004 | estimate | y
CTL-011 | BMS CAN mating cable | Exact BMS CAN harness | 1 | Base controller | y | proposed | cable tube | harness route | 1 | harness | 0.03 | estimate | y
CTL-012 | IMU shield interconnect and retention | SPI/INT1 harness and mechanical retention | 1 | Base controller | y | proposed | cable tube | harness route (SPI4 pin map, B4) | 1 | harness | 0.01 | estimate | y
CTL-014 | CAN2 isolated signal-and-power transceiver board | CAN Isolator 3 Click, MIKROE-5785 (MAX14882) | 1 | Base controller | y | proposed | mikroBUS L size 57.15 x 25.4 mm: 57.15x25.4x10 mm | proposed in the front bay, upper shelf (second tier) (SIG domain) | 1 | bay_can2 | 0.008 | estimate from the catalogue class | y
CTL-015 | CAN3 upper-body auxiliary transceiver and termination | CAN3 transceiver + 120 ohm termination | 1 | Base controller | y | proposed | same board class as CTL-003, proposed: 32x21x10 mm | proposed in the front bay, upper shelf (second tier) (SIG domain) | 1 | bay_can3 | 0.006 | estimate | y
CTL-016 | CAN3 upper-body auxiliary actuators / lift carriage interface connector | Connector and cable set, to be confirmed | 1 | Base controller | y | proposed | cable tube | harness route via the lift energy chain | 1 | harness | 0.08 | estimate | y
CTL-017 | Upper-body controller (lift H-bridge and Halls, 3 stop sensors, head light, Getac power enable, spare inputs) | NUCLEO-G474RE + Infineon BLDC-SHIELD_IFX007T + SN65HVD230; CAN3 node | 1 | Base controller | y | provisional | proposed size (board envelope pending the board decision): 25x40x60 mm | not documented: drawn on the static column rear face below the L1000 stop sensor (A6), above the lift motor | 1 | lift_node | 0.06 | estimate | y
CTL-018 | Low-side output driver for RESET lamp and KCHG coil | TI TPL7407LDR on Adafruit 1207 SOIC-16 breakout, outputs off from power-up; DFR0457 not us | 1 | Base controller | y | proposed | catalogue outline, verify: 51x38x12 mm | proposed in the front bay, upper shelf (second tier) (SIG domain) | 1 | bay_tpl7407 | 0.015 | estimate from the catalogue class | y
DOC-001 | Dock target / AprilTag board | Rigid matte AprilTag 36h11 three-tag bundle | 1 | Docking hardware | n | not drawn |  |  | 0 | none |  |  | n | offboard
DOC-002 | Dock mechanical guide / base | Dock revision TBD | 1 | Docking hardware | n | not drawn |  |  | 0 | none |  |  | n | offboard
DOC-004 | Secondary low AprilTag | Rigid matte low marker | 1 | Docking | n | not drawn |  |  | 0 | none |  |  | n | offboard
DRV-001 | Rigid-mounted hub motor with encoder and integrated e-brake | ZLLG80ASM250-L-B | 2 | Drivetrain | y | envelope | ZLLG80ASM250-L-B2 V1.01 double-shaft STEP (revolved profile, platform-sw converter) | track 0.400 placeholder; axle at base_link (P-03 item 8) | 2 | hub_motor_wheel | 6.9 | 2 x 3.450 kg: ZLTECH ZLLG80-ASM250-L V1.0 specification: 3.45 kg dual shaft (3.4 kg single shaft) | y
DRV-002 | Dual-axis CANopen servo driver | ZLAC8015D V4.2 | 1 | Drivetrain | y | envelope | PROVENANCE.yaml motor_driver (as in the CAD) | CAD v0.2 driver mount MMP.02.00.00.002 | 1 | motor_driver | 0.6 | 1 x 0.600 kg: estimate: 150 x 97 x 31 mm aluminium-cased driver (ZLAC8015D manual outline) | y
DRV-003 | Integrated motor brake and OEM brake harness allocation | Harness per fuse/wiring schedule | 1 | Drivetrain | y | proposed | cable tube | harness route (cable_list.csv) | 1 | harness | 0.15 | estimate | y
F-FAN | Fan branch fuse | F-FAN 2 A ATO | 1 | Power protection | y | proposed | ATO fuse in FB-C | FB-C | 1 | inside:bay_fbc | 0.002 | estimate | y
F-HUB | USB hub branch fuse | F-HUB 3 A ATO | 1 | Power protection | y | proposed | ATO fuse in FB-C | FB-C | 1 | inside:bay_fbc | 0.002 | estimate | y
F-PANEL | Panel branch fuse (Getac USB-PD module and head light; was F-PD in an earlier E-01) | F-PANEL 3 A ATO | 1 | Power protection | y | proposed | ATO fuse in FB-C | FB-C | 1 | inside:bay_fbc | 0.002 | estimate | y
F-SAFE | Safety circuit fuse | F-SAFE 2 A ATO | 1 | Power protection | y | proposed | ATO fuse in FB-C | FB-C | 1 | inside:bay_fbc | 0.002 | estimate | y
FB-A | Battery-bus fuse block | SafetyHub 150 (7748) | 1 | Power distribution | y | proposed | 146 x 44 x 33 mm (owner report rev 2, verify): 44x146x33 mm | proposed in the rear power module, at the rear panel under the sloped cover (rear_power.py) (BAT domain) | 1 | rz_fba | 0.12 | estimate from the catalogue class | y
FB-B | Safe-bus fuse block | SafetyHub 150 (7748) | 1 | Power distribution | y | proposed | 165 x 129 x 48 mm (owner report rev 2, verify): 129x165x48 mm | proposed in the rear power module level L3, FB-B shelf above BUS+, K1 and K2, fuses up (rear_power.py) (SAFE domain) | 1 | rz_fbb | 0.45 | estimate from the catalogue class | y
FB-C | Regulated 24 V fuse block | 5046 | 1 | Power distribution | y | proposed | Blue Sea 5046 146 x 44 x 33 mm (owner report rev 2: same part as FB-A), verify: 146x44x33 mm | proposed in the side_l (R24 domain) | 1 | bay_fbc | 0.12 | estimate from the catalogue class | y
FIX-001 | Portability and API validation fixture | LeRobot SO-101 follower only | 1 | Manipulation validation | n | not drawn |  |  | 0 | none |  |  | n | offboard
FIX-002 | SO-101 leader kit | SO-101 leader, optional | 1 | Manipulation validation | n | not drawn |  |  | 0 | none |  |  | n | offboard
FIX-003 | SO-101 controller, PSU and harness | Exact follower kit peripherals | 1 | Manipulation validation | n | not drawn |  |  | 0 | none |  |  | n | offboard
IMU-001 | 6-DoF IMU module | TDK EV_ICM-42688-P evaluation board on SPI4 (P-03 rev20.2) | 1 | IMU / base controller | y | envelope | EV_ICM-42688-P board outline (GLB envelope) | sensor_frames.yaml imu_link (0.0544, 0, 0.1210) on MMP.04.00.00.002 | 1 | imu | 0.005 | estimate | y
LFT-001 | Lift stop sensors, one per stop (L1000, L1175, L1350) | IME12-04BNSZC0S, M12 inductive, NPN NO; always-on 24 V rail | 3 | Lift sensing | y | placeholder | M12 x 48 mm cylinder | datums.yaml lift_stop_sensor_z_* | 3 | lift_stop_sensors | 0.09 | estimate 30 g each | y
LFT-002 | Lift stop sensor cables | DOL-1204-G02M, M12 4-pin, 2 m | 3 | Lift sensing | y | proposed | cable tube | down the static column | 3 | harness | 0.15 | estimate | y
LFT-003 | Lift stop sensor brackets in the static DOLD profile T-slot | BEF-WN-M12 (5308447) | 3 | Lift sensing | y | placeholder | datums lift_sensor_bracket_* | datums.yaml | 3 | lift_sensor_brackets | 0.06 | estimate | y
LFT-004 | Flag rod hanging from the adapter plate | 5-series 20 x 20 profile, L 430 mm, M5 tapped | 1 | Lift sensing | y | placeholder | 20 x 20 x 430 | datums.yaml lift_flag_rod_* | 1 | flag_rod | 0.22 | estimate 0.5 kg/m | y
LFT-005 | Rod corner bracket (anti-rotation) | 20-series corner bracket | 1 | Lift sensing | y | placeholder | 20 corner bracket | datums.yaml | 1 | rod_corner_bracket | 0.02 | estimate | y
LFT-006 | Steel flag for the stop sensors | SS400 flag 45 x 20 x 2 mm | 1 | Lift sensing | y | placeholder | 45 x 20 x 2 SS400 | datums.yaml lift_flag_* | 1 | lift_flag | 0.014 | volume x 7850 | y
LFT-007 | Lift sensor fastener set | 2 x M4 short nut, 2 x M4x8 ISO 7380, 1 x M5x20 ISO 4762, 3 x bracket screw plus T-nut | 1 | Lift sensing | y | proposed | fastener_schedule.csv | LIFT-SNS-01 joints | 1 | fasteners | 0.03 | estimate | y
LFT-008 | Lift foot fasteners and medium threadlocker | 4 x DIN 7984 M8 x 14 8.8 + medium threadlocker (lift foot to MEC-019) | 4 | Lift mechanics | y | proposed | fastener_schedule.csv (DOLD column to the lift base plate) | D-20 foot tabs 260 x 30 mm | 4 | fasteners | 0.032 | 4 x 0.008 kg: estimate: DIN 7984 M8 x 14 class 8.8 low-head cap screw, steel (BOM 7.15, D-20) | y
MEC-001 | Robot 2.0 chassis/deck and panels | MEC-001 drawing revision TBD | 1 | Mechanical | y | CAD-derived | CAD v0.2 MMP.00 to MMP.05 STEP | CAD v0.2 assembly | 1 | base_plate, front_panel, rear_panel, side_panel, support, centre_bracket, cover, cover_flange | 0.0 | CAD volume x 7850 kg/m3 (steel assumed), computed | y
MEC-002 | Four rigid swivel castors, no suspension | LPA-VSTH 35K, unbraked swivel plate castor | 4 | Mechanical | y | envelope | PROVENANCE.yaml castor (LPA-VSTH 35K) | CAD v0.2 corners | 4 | castor | 1.2 | 4 x 0.300 kg: Blickle LPA-VSTH 35K data sheet: unit weight 0.3 kg | y
MEC-003 | Arm profile on the lift / OpenArm J1\_A support | HFS6-60120, 340 mm, end-tapped both ends (confirm MISUMI drawing) | 1 | Mechanical | y | primitive | HFS6-60120 60 x 120 x 340 | B7: centred 0.180 ahead of the column axis | 1 | arm_profile | 1.5 | estimate 4.4 kg/m | y
MEC-004 | Lift adapter plate, rear upright and profile fasteners | MEC-004 drawing revision TBD | 1 | Mechanical | y | primitive | 360 x 100 x 10 6082-T6 | B7: rear edge flush with the column rear face | 1 | adapter_plate | 1.546 | 1 x 1.546 kg: design-intent solids design_intent/adapter_post.py: adapter plate with the rear extension, rear upright and stiffener, 6082-T6 (the HFS6 post is MEC-003) | y
MEC-005 | Removable electronics base plate | MEC-005 drawing revision TBD | 1 | Mechanical | y | proposed | 3 mm 5052 aluminium sheet, proposed outline | front bay floor (E1) | 1 | bay_plate | 0.0 | computed from outline x 3 mm x 2680 kg/m3 | y
MEC-006 | Base electronics plate / cable-routing interface | MEC-006 drawing revision TBD | 1 | Mechanical | y | proposed | 3 mm aluminium cable-routing plate, proposed outline | rear zone floor behind the cells | 1 | rear_plate | 0.0 | computed | y
MEC-007 | Battery tray and positive restraints | MEC-007 drawing revision TBD | 2 | Mechanical | y | provisional | design_intent/battery_tray.step (two pocket trays, scripts/roadmap_model/design_intent/battery_tray.py) | A1 side pockets | 2 | battery_tray | 1.479 | 1 x 1.479 kg: design-intent solids design_intent/battery_tray.py: two 5754-H22 pocket trays with their cell straps | y
MEC-008 | LiDAR spacer plate, aluminium, A1 hole pattern below, 4 x M2.5 S3 pattern above | Existing MMP.07 A1 bracket with 17.5 mm printed spacer MMP.07.00.00.002 and no standoffs; | 1 | Mechanical | y | CAD-derived | MMP.07.00.00.001 and .002 STEP | CAD v0.2 | 1 | lidar_support, lidar_spacer | 0.6 | estimate | y
MEC-009 | Base RGB-D camera bracket | 3D-printed PETG Gemini 336L mount with 2 x M4 heat-set inserts and longer spacers; spacer | 1 | Mechanical | y | CAD-derived | MMP.01.00.00.003 STEP | CAD v0.2 | 1 | camera_mount | 0.04 | estimate | y
MEC-010 | 3D-printed PETG TF-Luna mounting sets, one front centre and one rear centre, pitched 10 degrees down (P-03 rev19.7 item 19 D6; bench test confirms the return on real floors; sensor positions pending the owner CAD confirmation) | 3D-printed PETG TF-Luna mounting sets, one front centre and one rear centre, pitched 10 de | 2 | Mechanical | y | CAD-derived | MMP.00.00.00.005 STEP | CAD v0.2 | 2 | tof_mount | 0.02 | estimate | y
MEC-011 | 3D-printed PETG or COTS MB7060 retention sets, one per edge hole (front left, front right, rear left, rear right) | 3D-printed PETG MB7060 serial ultrasonic mounting sets, one front and one rear | 4 | Mechanical | y | CAD-derived | MMP.00.00.00.006 STEP | CAD v0.2 | 4 | ultrasonic_mount | 0.06 | estimate | y
MEC-012 | Tablet mounting adapter | MEC-012 drawing revision TBD | 1 | Mechanical | y | provisional | design_intent/getac_pocket.step (scripts/roadmap_model/design_intent/getac_pocket.py) | L1000, portrait on a fixed mount (A3) (arm-post front face x 0.060 + 0.180 + 0.060 = 0.300 (bp000); tablet centre 0.246 above the column top at L1000 (datums.yaml getac_tablet_z_above_column_top), 0.) | 1 | getac_pocket | 0.461 | design-intent volume x density | y
MEC-013 | Cable guards, clamps and edge protection | MEC-013 drawing revision TBD |  | Mechanical | y | proposed | P-clips, grommets, edge guards | harness route | 204 | harness_fittings | 0.15 | estimate | y
MEC-014 | Mounting fastener and standoff schedule | MEC-014 drawing revision TBD |  | Mechanical | y | proposed | fastener_schedule.csv | joints of the model |  | fasteners | 0.6 | estimate | y
MEC-015 | Rigid motor shaft-flat bracket sets | Laser-cut / bent / bolted bracket assembly | 2 | Mechanical | y | provisional | design_intent/motor_bracket.step (scripts/roadmap_model/design_intent/motor_bracket.py) | 4 brackets; brake side inboard on both wheels (local +y points away from the wheel: inner brackets face inboard, outer brackets outboard) | 2 | motor_brackets | 1.116 | design-intent volume x 7850 | y
MEC-016 | Rigid caster height-shim assortment | Laser-cut 0.5 / 1 / 2 mm full-footprint plates or suitable COTS shims | 1 | Mechanical | y | proposed | castor plate footprint: 62x60x1 mm | castor positions (M.DIMS CASTER) | 1 | shims | 0.12 | estimate | y
MEC-017 | OpenAMRobot branding parts for covers | Geometry/material to be defined | 1 | Mechanical | y | not drawn |  |  | 0 | none |  |  | n | branding decals are robot page fittings, geometry not defined
MEC-018 | DOLD Hexalift V4 350 mm lift column | DOLD Hexalift V4 350, BS-HM240G350530-MFF24; 350 mm stroke; 530 mm retracted; 880 mm exten | 1 | Lift mechanics | y | primitive | DOLD 240 x 60, 530 retracted, inner stage placeholder | B7 column axis x 0.060 (bp000) | 1 | lift_column | 11.7 | 1 x 11.700 kg: DOLD Hexalift V4 350 catalogue 11.7 kg; static and moving share from the STEP geometry and the materials (facts.yaml column.mass_split) | y
MEC-019 | Lift base plate, two fore-aft positions | 6082-T6, 350 x 140 x 10 mm, 8 x M8 tapped through. Joint 1, column to MEC-019: the DOLD fo | 1 | Lift mechanics | y | primitive | 350 x 140 x 10 6082-T6 (D-20) | B7 bp000 / bp050 | 1 | lift_base_plate | 1.293 | 1 x 1.293 kg: design-intent solid design_intent/lift_base_plate.py: 350 x 140 x 10 mm 6082-T6 with the tapped hole sets, x 2700 kg/m3 (D-20) | y
MEC-020 | TiMOTION TL3 400 mm lift column fallback | Exact delivered variant to be confirmed | 1 | Lift mechanics | n | not drawn |  |  | 0 | none |  |  | n | fallback lift, not fitted
MEC-021 | 3/4 inch NPS lock nut for MB7060 | 3/4 inch NPS lock nut | 4 | Mechanical | y | proposed | 3/4 in NPS nut, 35 mm across | sensor_frames us_* (y, z); behind the 2 mm front panel | 4 | us_locknut | 0.08 | estimate | y
MEC-022 | Arch backing plate | One laser-cut tapped steel plate if the mechanical owner confirms space, else 5 mm S235 wi | 1 | Lift mechanics | y | provisional | arch backing plate under the arch top sheet, below MEC-019 (BOM 7.15, D-21); drawing pending, mass placed at the lift base plate | B3 arch top, under MEC-019 | 1 | lift_base_plate | 0.77 | 1 x 0.770 kg: estimate: arch backing plate, 5 mm S235 option, about 150 x 130 x 5 mm x 7850 kg/m3 (BOM 7.15, D-21); the tapped laser-cut option is lighter or equal | y
NAV-001 | 2D navigation LiDAR | RPLIDAR S3M1-R2 (S3) | 1 | Navigation sensing | y | envelope | PROVENANCE.yaml lidar (S3 outline) | sensor_frames.yaml lidar_link (0.330, 0, 0.124) yaw pi; MMP.07 + 17.5 mm spacer | 1 | lidar | 0.115 | 1 x 0.115 kg: Slamtec RPLIDAR S3 datasheet: 115 g | y
NAV-003 | LiDAR USB-to-UART adapter and regulated 5 V cable set | USB-to-UART adapter + regulated 5 V cable set | 1 | Navigation sensing | y | proposed | proposed size: 40x20x10 mm | proposed in the side_r (SIG domain) | 1 | bay_lidar_uart | 0.01 | estimate | y
PWR-001 | Battery pack | 8 x EVE LF105 (8S1P, 25.6 V, 105 Ah, 2.688 kWh) in two trays of 4 joined by PWR-018 | 1 | Power | y | provisional | 8 x LF105 200 x 130 x 38 mm (B5) | A1 side pockets (owner, 2 Nov 2026) | 1 | battery_cells | 0.0 | included in PWR-023, PWR-024, PWR-025, PWR-026, PWR-027: 8S1P pack = cells PWR-023 + busbars PWR-024 + BMS sense harness PWR-025 + probes PWR-026 + insulation PWR-027; trays MEC-007, BMS PWR-002, F0 PWR-003 and disconnect PWR-004 are their own lines | y
PWR-002 | Smart BMS | Daly M-series configured 8S LiFePO4 150 A common port | 1 | Power | y | proposed | 164 x 66 x 21 mm catalogue outline (owner report rev 2; verify on the delivered order code): 164x21x66 mm | proposed in the right side gap between the right battery tray and the side wall (owner report rev 2, rear_power.py) (BAT domain) | 1 | rz_bms | 0.45 | 1 x 0.450 kg: estimate from the catalogue class (Daly M-series 8S 150 A) | y
PWR-003 | Main fuse and holder | Blue Sea 5112 Class T fuse 110 A with Blue Sea 5007100 holder, 20 kA interrupt | 1 | Power | y | proposed | about 159 x 51 x 58 mm (owner report rev 2, verify): 51x159x58 mm | proposed in the rear power module level L1, on the G10 power plate 15 mm above the receiver (rear_power.py) (BAT domain) | 1 | rz_f0 | 0.3 | estimate from the catalogue class | y
PWR-004 | Battery disconnect | Blue Sea BS-6004B lockable disconnect, 300 A, key lock in OFF | 1 | Power | y | provisional | 67 mm face, 64 mm behind the panel (owner report rev 2, verify): 64x67x67 mm | rear power owner report rev 2 (rear_power.py): through the rear panel at y -56, key outside, both M10 studs facing into the robot (S1 from F0 at z 183, S2 to BUS+ at z 202) | 1 | rz_disc | 0.29 | 1 x 0.290 kg: Blue Sea Systems 6004 m-Series specification: 0.65 lb (0.29 kg) | y
PWR-005 | Bench charger | Daly 28.4 V / 20 A charger, bench charger only, on the SB50 charge connector, E-stop press | 1 | Power | n | not drawn |  |  | 0 | none |  |  | n | offboard
PWR-006 | Fuse block and branch fuses | Blade fuse block 8-way + fuses per schedule (F1..F5) | 1 | Power | y | proposed | superseded by FB-A / FB-B / FB-C (E-01 rev1.6) | FB-C | 1 | inside:bay_fbc | 0.0 | included in FB-C | y
PWR-007 | 5 V isolated DC/DC converter | MEAN WELL RSD-60G-5 | 1 | Power | y | proposed | catalogue outline, verify: 120x50x33 mm | proposed in the front bay, lower plate on the base sheet (power conversion and safety) (LV domain) | 1 | bay_rsd60 | 0.32 | estimate from the catalogue class | y
PWR-008 | USB-PD module for operator tablet charging | 24 V in, USB-C PD 15 to 30 W | 1 | Power | y | proposed | proposed size: 50x30x15 mm | proposed in the side_l (R24 domain) | 1 | bay_usbpd | 0.03 | estimate | y
PWR-009 | Bus TVS clamps and EMI filter for compute branch | TVS and EMI/inrush network selected against each rail limit | 1 | Power | y | proposed | proposed size: 60x40x25 mm | proposed in the front bay, lower plate on the base sheet (power conversion and safety) (BAT domain) | 1 | bay_pwr009 | 0.06 | estimate | y
PWR-010 | Braking resistor (conditional) | Brake chopper/dump path sized from measured energy; exact product gate | 1 | Power | y | not drawn |  |  | 0 | none |  |  | n | conditional, not decided
PWR-012 | Regulated 24 V supply for coils and low-current peripherals | RSD-100B-24 | 1 | Power | y | proposed | catalogue outline, verify: 159x97x38 mm | proposed in the front bay, upper shelf (second tier) (R24 domain) | 1 | bay_rsd100 | 0.6 | 1 x 0.600 kg: MEAN WELL RSD-100B-24: 0.6 kg (distributor data from the MEAN WELL datasheet) | y
PWR-013 | Arm 24 V conversion stage | Bidirectional/regen-compatible architecture TBD |  | Power | y | not drawn |  |  | 0 | none |  |  | n | ARM-VOLT gate open (PWR-013 not selected)
PWR-014 | Precharge pulse resistor | Value and pulse rating after capacitance measurement | 1 | Power | y | proposed | in the precharge kit | rear zone | 1 | inside:rz_pre | 0.0 | included in SAF-004 | y
PWR-015 | Precharge branch fuse and holder | Coordinated with precharge resistor and wiring | 1 | Power | y | proposed | in the precharge kit | rear zone | 1 | inside:rz_pre | 0.0 | included in SAF-004 | y
PWR-016 | Ready-made actuator-bus voltage measurement module | INA228 breakout, product 5832 | 1 | Power | y | proposed | catalogue outline, verify: 25.4x17.8x6 mm | proposed in the front bay, lower plate on the base sheet (power conversion and safety) (SIG domain) | 1 | bay_ina228 | 0.003 | estimate from the catalogue class | y
PWR-017 | Positive and negative distribution blocks | Touch-protected DC distribution blocks | 2 | Power | y | proposed | proposed size, verify: 40x100x40 mm | proposed in the rear power module level L1, on the G10 power plate 15 mm above the receiver (rear_power.py) (BAT domain) | 2 | rz_pwr017 | 0.4 | estimate | y
PWR-018 | Battery tray series link connector set | Keyed touch-protected DC connector, at least 100 A, tray series link (D-27) | 1 | Power | y | proposed | proposed size: 30x60x40 mm | on the series link over the centre, z 0.262 (A9) | 1 | rz_batcon | 0.08 | estimate | y
PWR-019 | SB50 charge connector | SB50 charge connector for the TZBOT receiver output and the bench charger | 1 | Power | y | proposed | catalogue outline, verify: 40x50x38 mm | proposed: rear panel above the plate, reachable for manual charging (Daly 28.4 V / 20 A charger at any time) | 1 | rz_sb50 | 0.06 | estimate | y
PWR-022 | Single wired charge-branch fuse and holder | F-CHG 30 A MIDI | 1 | Power | y | proposed | catalogue outline, verify: 66x30x32 mm | proposed in the rear corner behind a battery tray, inside the rear supports (rear_power.py) (BAT domain) | 1 | rz_fchg | 0.05 | estimate from the catalogue class | y
PWR-023 | EVE LF105 cell allocation | LF105 105 Ah LiFePO4 | 8 | Power | y | provisional | 8 cell boxes | A1 side pockets | 8 | battery_cells | 15.84 | 8 x 1.980 kg: EVE LF105 product specification (version F): 1980 +/- 100 g per cell | y
PWR-024 | Cell busbars and terminal hardware | Matched LF105 terminal variant |  | Power | y | provisional | inside the envelope | B5 |  | inside:battery_cells | 0.22 | 1 x 0.220 kg: estimate: 8 Cu busbars 56 x 20 x 2 mm x 8960 kg/m3 (0.020 kg each) + 16 M6 nuts and washers (4 g each) | y
PWR-025 | BMS sense harness | Exact 8S BMS mating harness | 1 | Power | y | provisional | inside the envelope | B5 | 1 | inside:battery_cells | 0.06 | 1 x 0.060 kg: estimate: 9 leads x 0.6 m, 0.5 mm2 Cu with insulation, 11 g/m | y
PWR-026 | Pack temperature probes | Exact supported NTC type |  | Power | y | provisional | inside the envelope | B5 |  | inside:battery_cells | 0.01 | 2 x 0.005 kg: estimate: NTC probe with lead, 5 g | y
PWR-027 | Battery pack internal insulation and cell restraint allocation | LF105-compatible insulation/restraint set | 1 | Power | y | provisional | inside the envelope | B5 | 1 | inside:battery_cells | 0.29 | 1 x 0.290 kg: estimate: 0.5 mm insulating sheet on two faces of each cell (0.42 m2 x 0.5 mm x 1400 kg/m3); the cell straps are in MEC-007 | y
PWR-028 | Battery enclosure | Use two removable insulated trays of 4 upright LF105 cells, sized from delivered cell data | 1 | Power | y | provisional | the envelope shell | B5 | 1 | battery_tray | 0.0 | included in MEC-007: the two removable pocket trays MEC-007 are the battery enclosure (A9) | y
PWR-029 | Compute inrush limiter / protected input | Matched Robotics 104 input protection | 1 | Power | y | proposed | proposed size: 50x30x20 mm | proposed in the front bay, lower plate on the base sheet (power conversion and safety) (BAT domain) | 1 | bay_pwr029 | 0.04 | estimate | y
PWR-030 | SAFE 24 V converter for lift and hub-motor brake release | MEAN WELL DDR-240B-24 (P-03 rev20.2); requirement 20 to 30 V DC input, 24 V DC output, at | 1 | Power and safety | y | proposed | catalogue outline, verify: 63x125.2x100 mm | proposed in the front bay, DIN carrier on the centre-bracket front wall (SAFE domain) | 1 | bay_ddr240 | 0.8 | 1 x 0.800 kg: MEAN WELL DDR-240B-24: 0.8 kg (distributor data from the MEAN WELL datasheet) | y
PWR-031 | Reserved fused contactor-switched 24 V auxiliary-actuator branch | Fuse/contactor/branch parts to be confirmed | 1 | Power and safety | y | not drawn |  |  | 0 | none |  |  | n | reserved branch, parts to be confirmed
PWR-032 | 3.3 V regulator for the four MB7060 sensors | 3.3 V regulator, at least 300 mA, fed from the 5 V rail | 1 | Power | y | proposed | proposed size: 25x20x10 mm | proposed in the side_l (LV domain) | 1 | bay_pwr032 | 0.005 | estimate | y
SAF-001 | Base front and moving adapter plate E-stop button assemblies | Schneider XB4BS8445 plus ZBE-102 (2NC + 1NO each), base front and top of the moving adapte | 2 | Safety | y | placeholder | XB4BS8445 + ZBE-102 datasheet dimensions (GLB estop node) | B4: base front old red-button hole; static column rear face (M-09 pending) | 2 | estop, second_estop | 0.3 | estimate 0.15 kg each | y
SAF-002 | Dual-channel monitored safety relay with manual reset and feedback loop | Pilz PNOZ s3 24 V DC (750103), selected | 1 | Safety | y | proposed | PNOZ s3 22.5 x 98 x 121 catalogue outline, verify; rail 35 mm: 100x98x121 mm | proposed in the front bay, DIN carrier on the centre-bracket front wall (SIG domain) | 1 | bay_din | 0.35 | estimate from the catalogue class | y
SAF-003 | K1 and K2 series contactors with integrated NC auxiliary contacts | GX11CAC only (P-03 item 27); GX14CAC dropped (D-32) | 2 | Safety | y | proposed | catalogue outline, verify: 45x73x76 mm | proposed in the rear power module level L1, on the G10 power plate 15 mm above the receiver (rear_power.py) (SAFE domain) | 2 | rz_k1k2 | 0.9 | estimate from the catalogue class | y
SAF-004 | Kpre: actuator-bus precharge relay, in the design (P-03 rev20.2; sizing, sequencing and acceptance pending, D-22) | DC relay, exact contact/coil SKU pending | 1 | Safety | y | proposed | proposed size: 80x50x35 mm | proposed in the rear corner behind a battery tray, inside the rear supports (rear_power.py) (SAFE domain) | 1 | rz_pre | 0.12 | estimate | y
SAF-005 | One illuminated manual reset pushbutton | XB4BW36B5, the only reset button: 1NO to the PNOZ reset, 1NC to the controller, 5 s hold r | 1 | Safety | y | placeholder | XB4BW36B5 datasheet dimensions | B4: old green-button hole | 1 | reset_button | 0.12 | estimate | y
SAF-006 | Integrated NC auxiliary contacts for K1 and K2 (no separate feedback assemblies) | One SPST-NC auxiliary per GX11CAC, mechanically linked to its main contacts | 2 | Safety | y | proposed | integrated in GX11CAC | K1/K2 | 2 | inside:rz_k1k2 | 0.0 | included | y
SAF-007 | Brake coil suppression / switching hardware | Matched brake coil transient control | 1 | Safety | y | proposed | proposed size: 30x20x15 mm | proposed in the rear corner behind a battery tray, inside the rear supports (rear_power.py) (SAFE domain) | 1 | rz_brake | 0.01 | estimate | y
SNS-001 | 2 x TF-Luna ToF cliff sensors, front and rear panel centre holes, one MCU UART each | TF-Luna | 2 | Near-field sensing | y | envelope | TF-Luna 35 x 21.25 x 13.5 mm (datasheet) | sensor_frames.yaml tof_front/tof_rear | 2 | tof | 0.01 | datasheet 5 g each | y
SNS-002 | MaxBotix MB7060 serial ultrasonic ranger | MB7060 XL-MaxSonar-WR, housing -2XX (3/4 inch NPS WRC), RS232, 7-pin default connection, n | 4 | Near-field sensing | y | envelope | MB7060 -2XX housing (datasheet 11838) | sensor_frames.yaml us_* | 4 | ultrasonic | 0.236 | datasheet 59 g each | y
SNS-003 | Sensor harness and panel mounts | six near-field sensors: four MB7060 UART drops (with trigger GPIO) and two TF-Luna UART dr | 1 | Near-field sensing | y | proposed | cable tubes and panel mounts | harness route | 1 | harness | 0.1 | estimate | y
TST-001 | CAN service interface | PCAN-USB, isolated order variant required | 1 | Commissioning | n | not drawn |  |  | 0 | none |  |  | n | offboard
TST-002 | Borrowed calibrated scales for six wheel-contact loads | Six scales/load cells suitable for wheel loads | 6 | Commissioning | n | not drawn |  |  | 0 | none |  |  | n | offboard
TST-003 | Battery energy measurement | Calibrated DC power/Wh logger | 1 | Commissioning | n | not drawn |  |  | 0 | none |  |  | n | offboard
TST-004 | Service harness and crimp tooling | Connector-specific calibrated crimp tools | 1 | Commissioning | n | not drawn |  |  | 0 | none |  |  | n | offboard
TST-005 | Commissioning gamepad | Logitech F710 with USB receiver | 1 | Commissioning | n | not drawn |  |  | 0 | none |  |  | n | offboard
TST-006 | Docking ground-truth rig | Overhead camera, calibrated tags/grid and angle reference | 1 | Test equipment | n | not drawn |  |  | 0 | none |  |  | n | offboard
UI-001 | Detachable operator tablet | Getac ZX80 (8 inch, 234 x 149.8 x 17.6 mm, 590 g, IP67, USB-C PD) portrait only, on a fixe | 1 | Operator panel | y | placeholder | datums getac_tablet_size 17.6 x 234 x 149.8 | datums.yaml getac_tablet_z_above_column_top, centre 40 mm lower (A3, portrait on a fixed mount) | 1 | getac_tablet | 0.59 | datums getac_tablet_mass | y
UI-002 | Tablet mount, fixed portrait mount | Fixed portrait mount for the ZX80 (149.8 wide x 234 tall), owner decision of 2 Nov 2026 | 1 | Operator panel | y | provisional | design_intent/getac_pocket.step (scripts/roadmap_model/design_intent/getac_pocket.py) | L1000, portrait on a fixed mount (A3) (arm-post front face x 0.060 + 0.180 + 0.060 = 0.300 (bp000); tablet centre 0.246 above the column top at L1000 (datums.yaml getac_tablet_z_above_column_top), 0.) | 1 | getac_pocket | 0.461 | design-intent volume x density | y
UI-003 | Reporting audio output | Tablet speaker; external audio conditional | 1 | Operator panel | y | not drawn |  |  | 0 | inside:getac_tablet |  |  | n | tablet speaker, part of UI-001
WCH-001 | TZBOT WCM-500-24 wireless charging set | WCM-500-24, 24 V class, 8 to 15 A, output 28.4 V | 1 | Wireless charging | n | not drawn |  |  | 0 | none |  |  | n | set row: the onboard part is WCH-002, the transmitter WCH-003 is offboard
WCH-002 | TZBOT onboard receiver | WCM-500-24 onboard receiver | 1 | Wireless charging | y | prepared, installed later | TZBOT WCM-500-24 manual V2.5: 170 x 150 x 52 mm, about 1.5 kg: 170x150x52 mm | A1 rear charger zone (owner, 2 Nov 2026) | 1 | tz_receiver | 0.0 | installed later (about 1.5 kg when installed) | y
WCH-003 | TZBOT station transmitter | WCM-500-24 station transmitter, input 220 V 50 Hz | 1 | Wireless charging | n | unmapped |  |  | 1 | tz_transmitter |  |  | y
WCH-004 | Charge relay KCHG | 24 V coil, 1NO + 1NC | 1 | Charging safety | y | proposed | proposed size: 35x30x30 mm | proposed in the rear corner behind a battery tray, inside the rear supports (rear_power.py) (BAT domain) | 1 | rz_kchg | 0.05 | estimate | y
WCH-005 | TZBOT start and fault lines to STM32 | Fault open collector, max 30 V, 200 mA, pull-up | 1 | Charging control | y | proposed | cable tube | harness route | 1 | harness | 0.02 | estimate | y
WCH-006 | Receiver output branch | Receiver output to F-CHG and BAT bus | 1 | Charging power | y | proposed | cable tube | harness route | 1 | harness | 0.1 | estimate | y
WCH-007 | Receiver plastic frame, 3D printed, 20 mm metal-free lateral, 15 mm above, rear bar 40 x 18 mm cable notch | Receiver plastic frame, 3D printed, 20 mm metal-free lateral, 15 mm above, rear bar 40 x 1 | 1 | Mechanical | y | provisional | drawn with the receiver | with WCH-002 | 1 | inside:tz_receiver | 0.0 | included in WCH-002 | y
WIR-001 | Power cables, connectors | Provisional 25 mm² main, 10 mm² drive, 6 mm² each arm and charger; connector variants matc |  | Wiring | y | proposed | cable tubes | harness route |  | harness | 2.2 | computed from route lengths (cable_list.csv) | y
WIR-002 | CAN drive bus cable | 2x2x0.34 mm2 shielded twisted pair, \< 3 m, 120 ohm terminations |  | Wiring | y | proposed | cable tubes | harness route |  | harness | 0.15 | computed from route lengths | y
