openAMRobot/openamrobot-docs/docs/templates/component-README.md

# COMPONENT_NAME

STATUS: Active

One-sentence technical definition.

## Quick start

Provide no more than five copy-pasteable commands.

**Success check:** State the exact observable result.

## Requirements

| Requirement | Version or constraint |
|---|---|
| Example | Exact value |

## Architecture

Add the implementation-sensitive architecture diagram here and explain it briefly.

## Repository structure

| Path | Purpose |
|---|---|
| src/ | Component source |

## Configuration

| Parameter | Default | Meaning |
|---|---:|---|
| Example | value | Purpose |

## Repository boundaries

State what belongs here, what does not, and link to the owning repositories.

## Documentation

- Repository documentation: [docs/](docs/)
- Conceptual documentation: DOCS_PAGE_URL

## Development

Link to build, test, and contribution commands.

## Safety

State component-specific hazards and mandatory controls, or explain why this section is not applicable.

## Project

- [Licence](LICENSE)
- [Licensing map](LICENSING.md)
- [Contributing](https://github.com/openAMRobot/.github/blob/main/CONTRIBUTING.md)
- [Security](https://github.com/openAMRobot/.github/blob/main/SECURITY.md)
- [Support](https://github.com/openAMRobot/.github/blob/main/SUPPORT.md)
