openAMRobot/openamrobot-docs/docs/templates/README-component.md

# <Human Readable Name>

<One sentence: what this is, what it runs on, what it produces.>

> **Status:** Active




OpenAMRobot ecosystem

## How it fits

<Two or three sentences. What this component is responsible for, what it consumes,
what consumes it. Name the repos.>

Full ecosystem overview: [openamrobot-docs](https://github.com/openAMRobot/openamrobot-docs)

## Quick start

```bash
<five commands or fewer, copy-pasteable, no placeholders>
```

**Success check:** <one observable thing that proves it worked>

Other installation paths: [docs/installation.md](docs/installation.md)

## Requirements

| Use case | Required |
| --- | --- |
| <case> | <requirement> |

## What is in here

| Path | Contains |
| --- | --- |
| `<dir>/` | <one line> |

## Repository boundaries

**Belongs here**

- <item>

**Does not belong here**

| Topic | Lives in |
| --- | --- |
| <topic> | [<repo>](https://github.com/openAMRobot/<repo>) |

## Documentation

| Guide | Purpose |
| --- | --- |
| [Installation](docs/installation.md) | <purpose> |
| [Development](docs/development.md) | <purpose> |
| [Troubleshooting](docs/troubleshooting.md) | <purpose> |

## Development

```bash
<build and test commands>
```

Read [CONTRIBUTING.md](CONTRIBUTING.md) before changing <the sensitive areas>.

## Safety notice

<Delete this section only if nothing here can move, heat, or carry current.
State plainly what is not safety rated and what the operator must keep in reach.>

## Project

MIT licensed. See [LICENSE](LICENSE).

[Contributing](CONTRIBUTING.md) · [Security](SECURITY.md) · [Support the project](https://github.com/openAMRobot/openamrobot-docs#support)
