openAMRobot/openamrobot-docs/docs/assets/hardware/openamrobot2-ga-parts-list.jpg

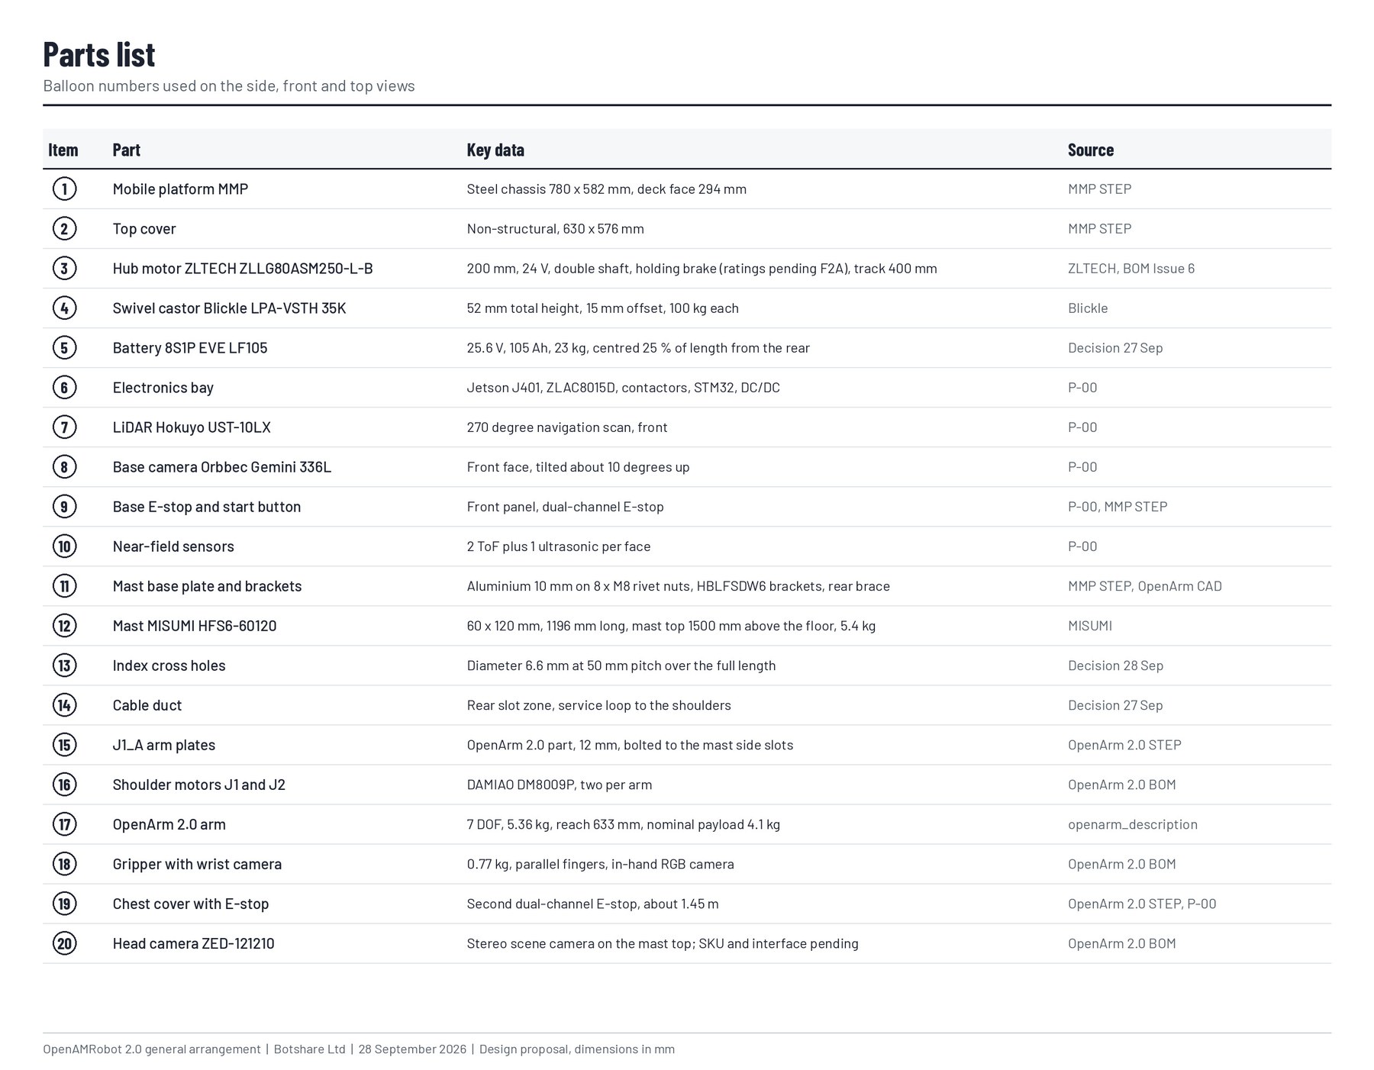
docs/assets/hardware/openamrobot2-ga-parts-list.jpg
