openAMRobot/openamrobot-docs/docs/assets/roadmap/model/design_intent/ultrasonic_mount.step

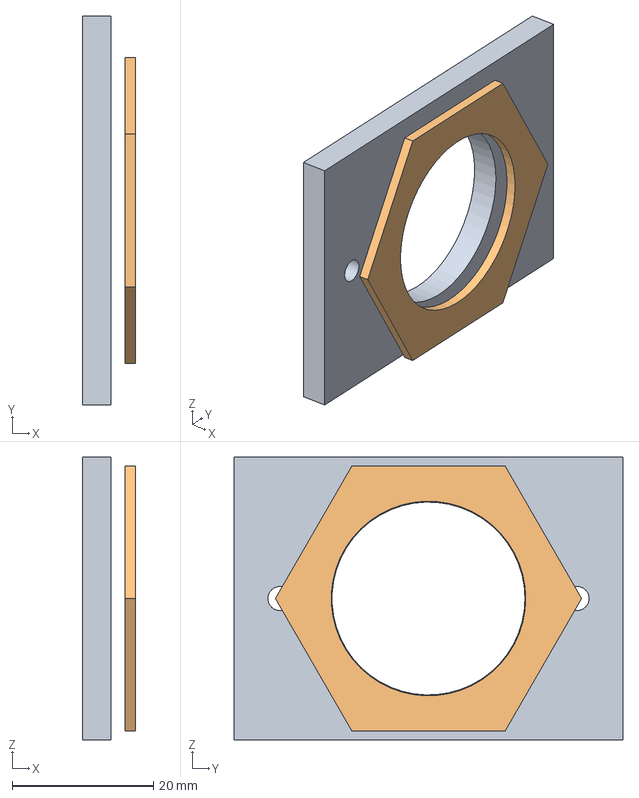
[picture p84: CAD file, 2026-11-10]
docs/assets/roadmap/model/design_intent/ultrasonic_mount.step
7.50 x 55.0 x 40.0 mm
MEC-011_retention_plate
MEC-011_nut_seat
