openAMRobot/openamrobot-docs/docs/assets/roadmap/model/export/openamrobot2_layout.step

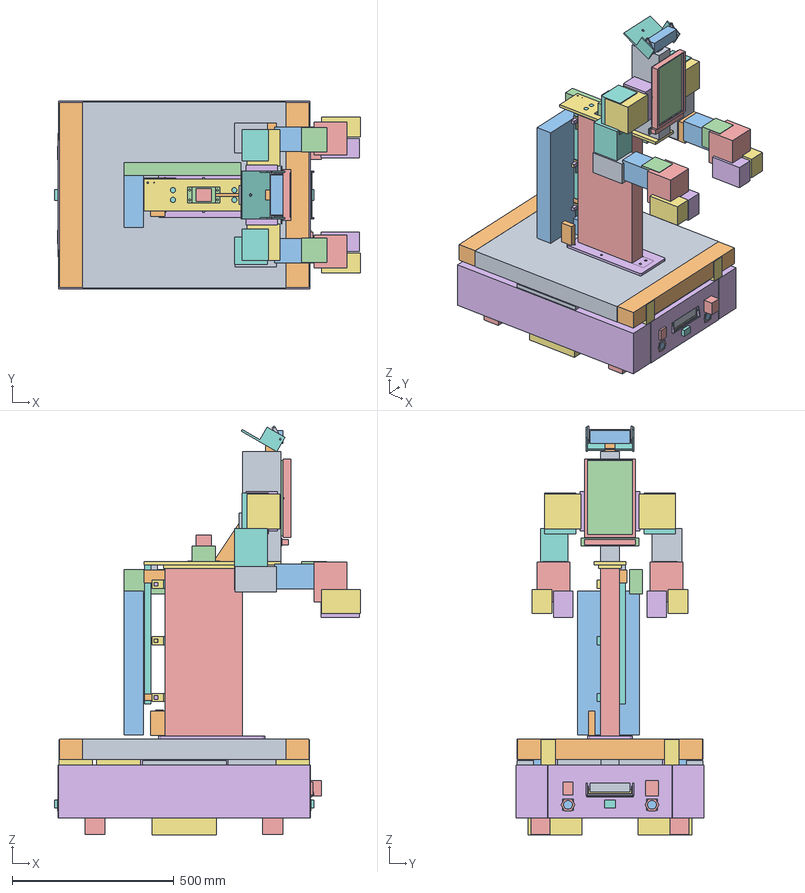
[picture p85: CAD file, 2026-11-04]
docs/assets/roadmap/model/export/openamrobot2_layout.step
947.1 x 582.0 x 1265.5 mm
CAM-001__base_camera
CTL-001__base_controller
MEC-001__base_plate
MEC-009__camera_mount
MEC-002__castor_front_left
MEC-002__castor_front_right
MEC-002__castor_rear_left
MEC-002__castor_rear_right
MEC-001__centre_bracket
CMP-001__compute
MMP.04.00.00.003__controller_plate
MEC-001__cover
MEC-001__cover_flange_front
MEC-001__cover_flange_rear
MMP.02.00.00.002__driver_mount
MMP.04.00.00.002__electronics_bracket
SAF-001__estop
MEC-001__front_panel
DRV-001__hub_motor_wheel_left
DRV-001__hub_motor_wheel_right
IMU-001__imu
NAV-001__lidar
MEC-008__lidar_spacer
MEC-008__lidar_support
DRV-002__motor_driver
MEC-001__rear_panel
SAF-005__reset_button
MEC-001__side_panel_left
MEC-001__side_panel_right
MEC-001__support_front_left
MEC-001__support_front_right
MEC-001__support_rear_left
MEC-001__support_rear_right
SNS-001__tof_front
MEC-010__tof_mount_front
MEC-010__tof_mount_rear
SNS-001__tof_rear
SNS-002__ultrasonic_front_left
SNS-002__ultrasonic_front_right
MEC-011__ultrasonic_mount_front_left
MEC-011__ultrasonic_mount_front_right
MEC-011__ultrasonic_mount_rear_left
MEC-011__ultrasonic_mount_rear_right
SNS-002__ultrasonic_rear_left
SNS-002__ultrasonic_rear_right
MEC-018__lift_column
MEC-018__lift_column_stage
MEC-018__lift_column_head
MEC-004__adapter_plate
MEC-003__arm_profile
ARM-011__head_camera_bracket
ARM-003__head_camera
SAF-001__second_estop
UI-001__getac_tablet
AUX-001__head_light
NOBOM__lift_stop_sensor_1
NOBOM__lift_sensor_bracket_1
NOBOM__lift_sensor_bracket_leg_1
NOBOM__lift_stop_sensor_2
NOBOM__lift_sensor_bracket_2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
