openAMRobot/openamrobot-docs/docs/assets/roadmap/model/design_intent/ultrasonic_mount_tilt6.step

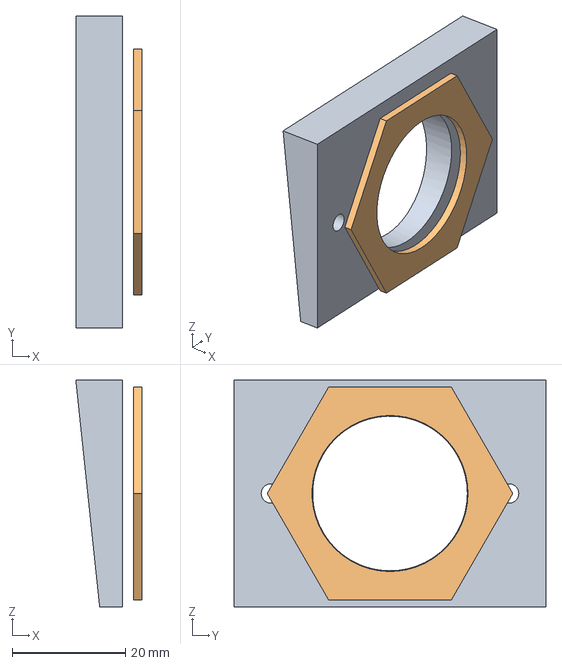
[picture p86: CAD file, 2026-11-10]
docs/assets/roadmap/model/design_intent/ultrasonic_mount_tilt6.step
11.7 x 55.0 x 40.0 mm
MEC-011_retention_plate
MEC-011_nut_seat
