openAMRobot/openamrobot-docs/docs/assets/roadmap/model/design_intent/lift_base_plate.step

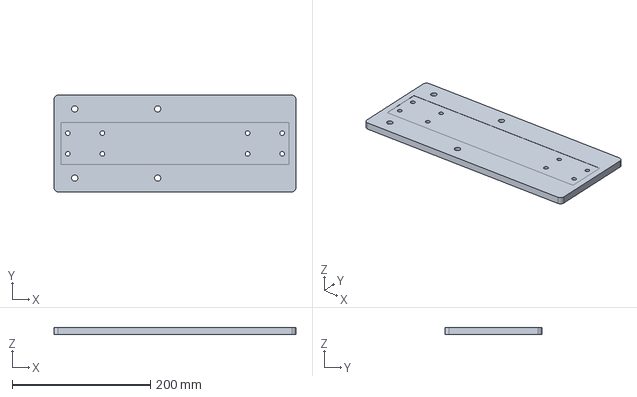
[picture p87: CAD file, 2026-11-10]
docs/assets/roadmap/model/design_intent/lift_base_plate.step
350.0 x 140.0 x 10.0 mm
