openAMRobot/openamrobot-docs/docs/assets/roadmap/model/design_intent/gemini_mount.step

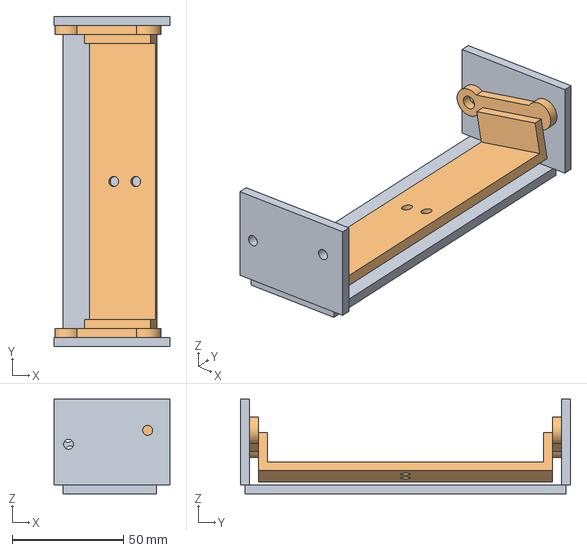
[picture p88: CAD file, 2026-11-10]
docs/assets/roadmap/model/design_intent/gemini_mount.step
52.0 x 148.0 x 42.5 mm
MEC-009_base_and_cheeks
MEC-009_cradle_bt10
