openAMRobot/openamrobot-docs/docs/assets/roadmap/model/design_intent/zed_bracket.step

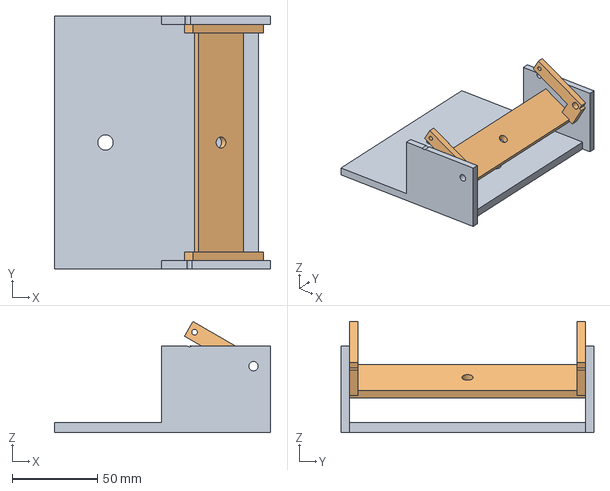
[picture p89: CAD file, 2026-11-10]
docs/assets/roadmap/model/design_intent/zed_bracket.step
127.0 x 148.5 x 65.3 mm
ARM-011_foot_and_cheeks
ARM-011_cradle_hp30
