openAMRobot/openamrobot-docs/docs/assets/roadmap/model/design_intent/adapter_post.step

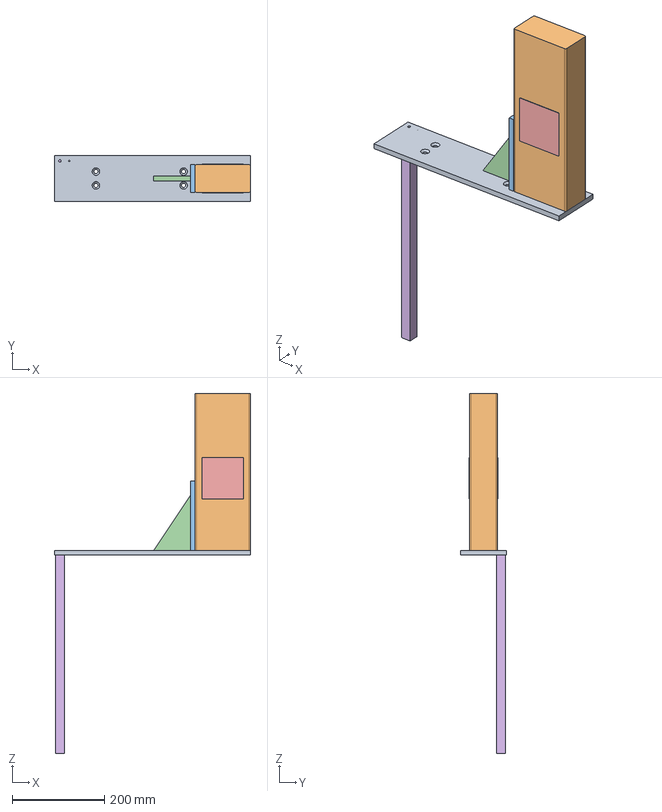
[picture p91: CAD file, 2026-11-03]
docs/assets/roadmap/model/design_intent/adapter_post.step
425.0 x 100.0 x 780.0 mm
MEC-004_adapter_plate
MEC-003_arm_post_HFS6-60120_envelope
MEC-004_rear_upright
MEC-004_stiffener
MEC-004_J1A_spacer_left
MEC-004_J1A_spacer_right
LFT-004_flag_rod_ref
