openAMRobot/openamrobot-docs/docs/assets/roadmap/model/design_intent/battery_tray.stl

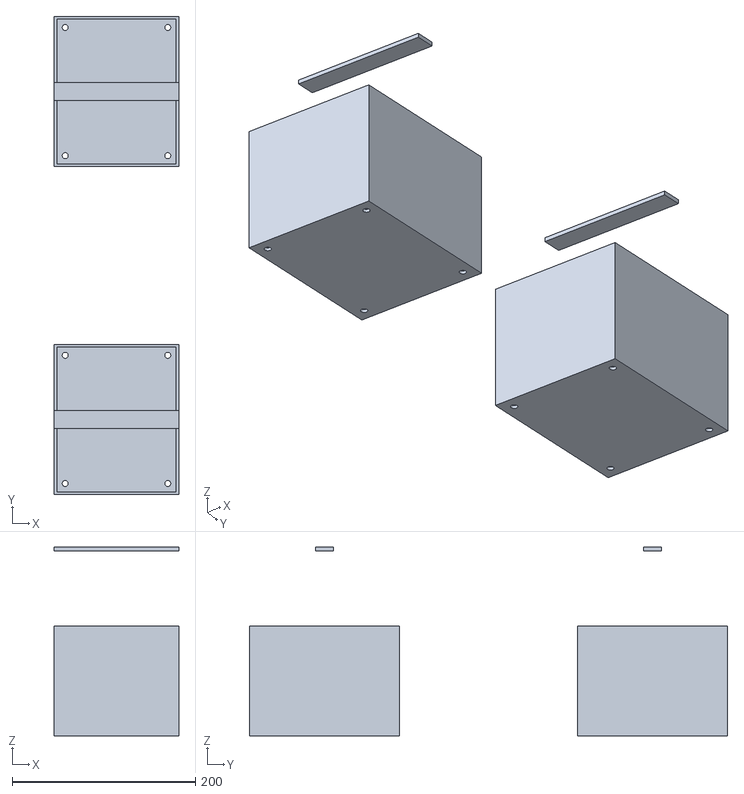
[picture p92: CAD file, 2026-11-03]
docs/assets/roadmap/model/design_intent/battery_tray.stl
136.0 x 522.0 x 206.0
