openAMRobot/openamrobot-docs/docs/assets/roadmap/model/design_intent/motor_bracket.stl

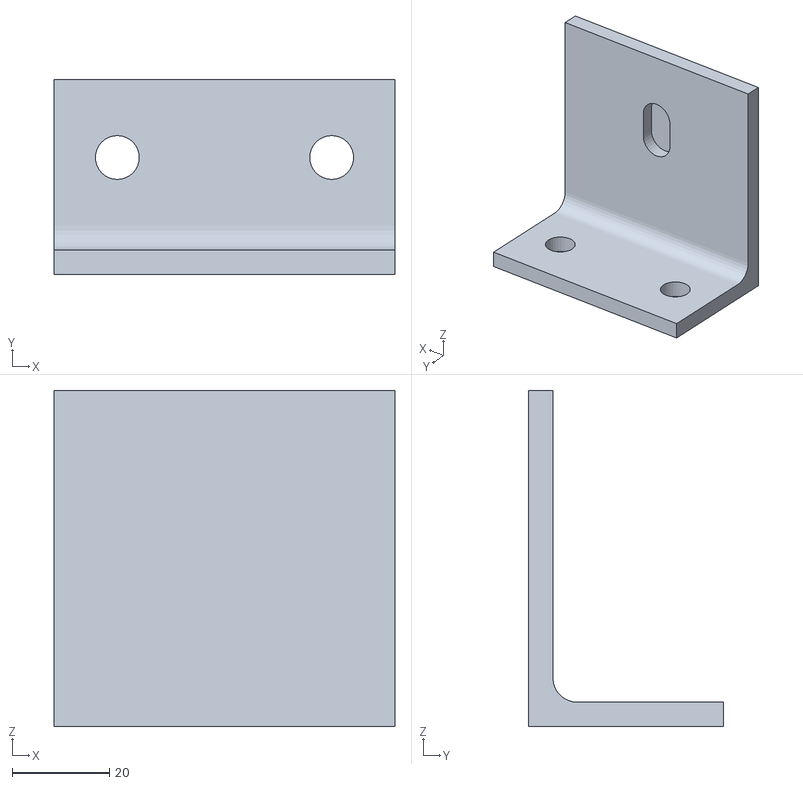
[picture p93: CAD file, 2026-11-03]
docs/assets/roadmap/model/design_intent/motor_bracket.stl
70.0 x 40.0 x 69.0
