openAMRobot/openamrobot-docs/docs/assets/roadmap/model/design_intent/getac_pocket.step

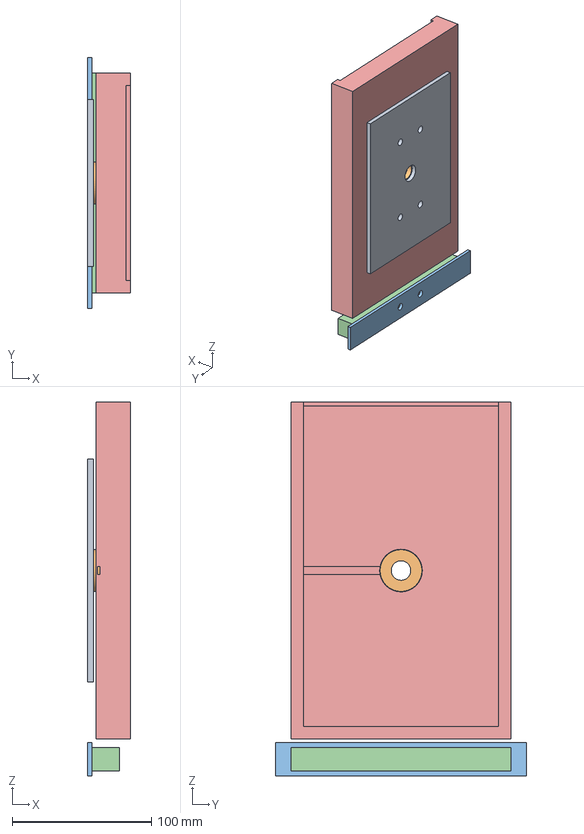
[picture p94: CAD file, 2026-11-03]
docs/assets/roadmap/model/design_intent/getac_pocket.step
30.6 x 180.0 x 268.5 mm
MEC-012_back_plate
UI-002_spacer_hub
AUX-001_light_plate
AUX-001_head_light_envelope
UI-002_pocket_portrait
