openAMRobot/openamrobot-docs/docs/assets/roadmap/model/design_intent/lift_sensor_set.step

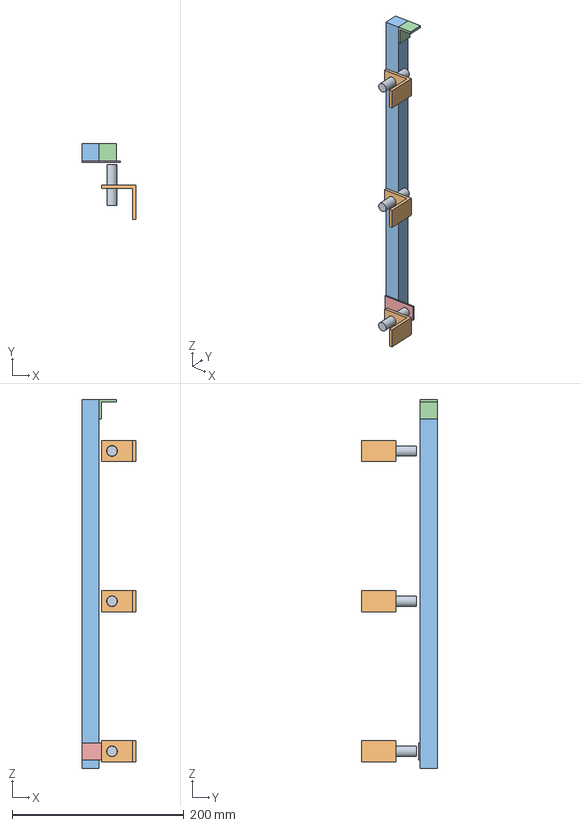
[picture p95: CAD file, 2026-11-03]
docs/assets/roadmap/model/design_intent/lift_sensor_set.step
63.0 x 88.0 x 430.0 mm
LFT-001_IME12_1_envelope
LFT-003_BEF-WN-M12_1
LFT-001_IME12_2_envelope
LFT-003_BEF-WN-M12_2
LFT-001_IME12_3_envelope
LFT-003_BEF-WN-M12_3
LFT-004_rod_L430
LFT-005_corner_bracket
LFT-006_flag_SS400
