openAMRobot/openamrobot-docs/docs/assets/roadmap/model/design_intent/tof_mount_hole22.stl

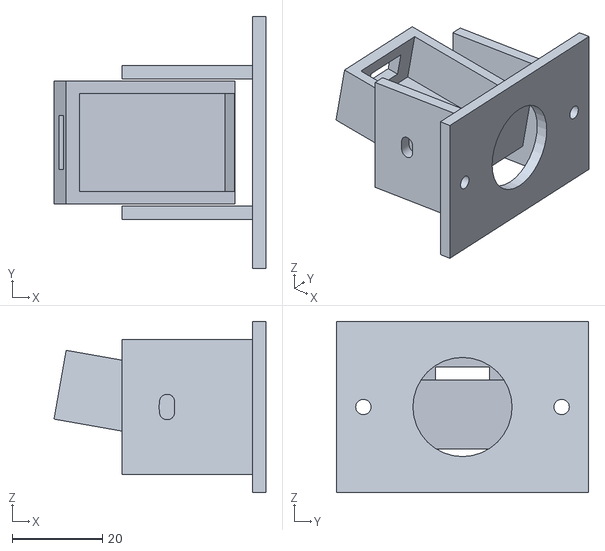
[picture p96: CAD file, 2026-11-03]
docs/assets/roadmap/model/design_intent/tof_mount_hole22.stl
47.0 x 56.0 x 38.0
