openAMRobot/openamrobot-docs/(list of files, cad)

Other CAD files:
docs/assets/roadmap/model/design_intent/gemini_mount.stl
docs/assets/roadmap/model/design_intent/lift_base_plate.stl
docs/assets/roadmap/model/design_intent/lift_sensor_set.stl
docs/assets/roadmap/model/design_intent/ultrasonic_mount_tilt6.stl
docs/assets/roadmap/model/design_intent/zed_bracket.stl
