openAMRobot/openamrobot-docs/docs/tutorials/index.md

---
title: Tutorials
---

# Tutorials

Tutorials explain concepts and complete learning paths. Version-sensitive commands remain in their owning repositories and are linked rather than copied here.

Current starting points:

- [Mobile platform overview](../reference/mobile-platform.md)
- [Repository ecosystem](../reference/repositories.md)
- [Start here](../start-here/index.md)
- [Architecture](../reference/architecture.md)

A tutorial must name the release, repository and version it was validated against. If it cannot be maintained, remove it from navigation rather than leaving an unverified procedure.
