openAMRobot/openamrobot-docs/evidence/2026-10-26-shared-model/exploded_1280_assembled_before.png

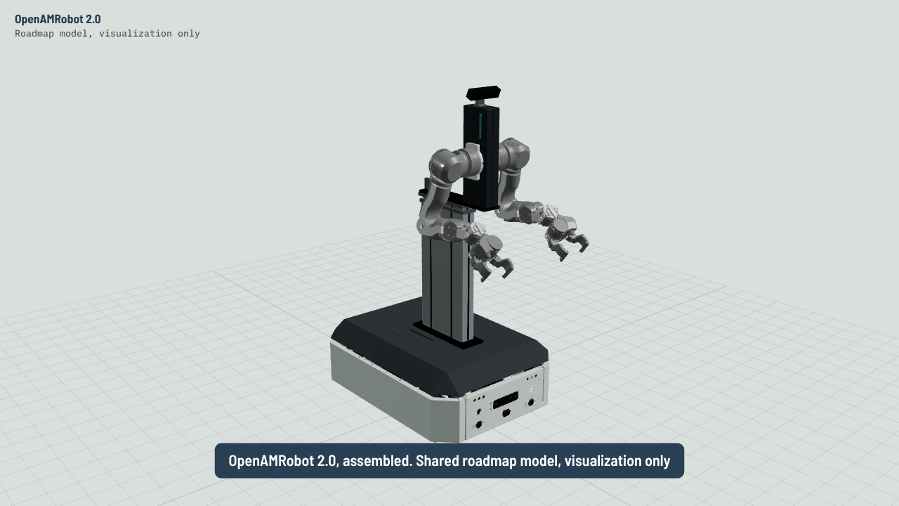
evidence/2026-10-26-shared-model/exploded_1280_assembled_before.png
