openAMRobot/openamrobot-docs/evidence/2026-10-26-shared-model/preview/01_assembled_front_three_quarter.png

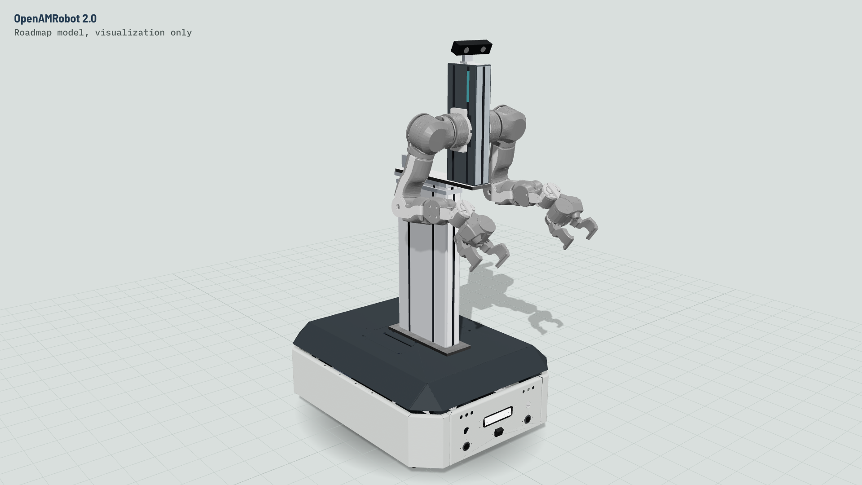
evidence/2026-10-26-shared-model/preview/01_assembled_front_three_quarter.png
