openAMRobot/openamrobot-docs/evidence/2026-11-04-layout-harness-flag/after/G1_guide_close_L1000.png

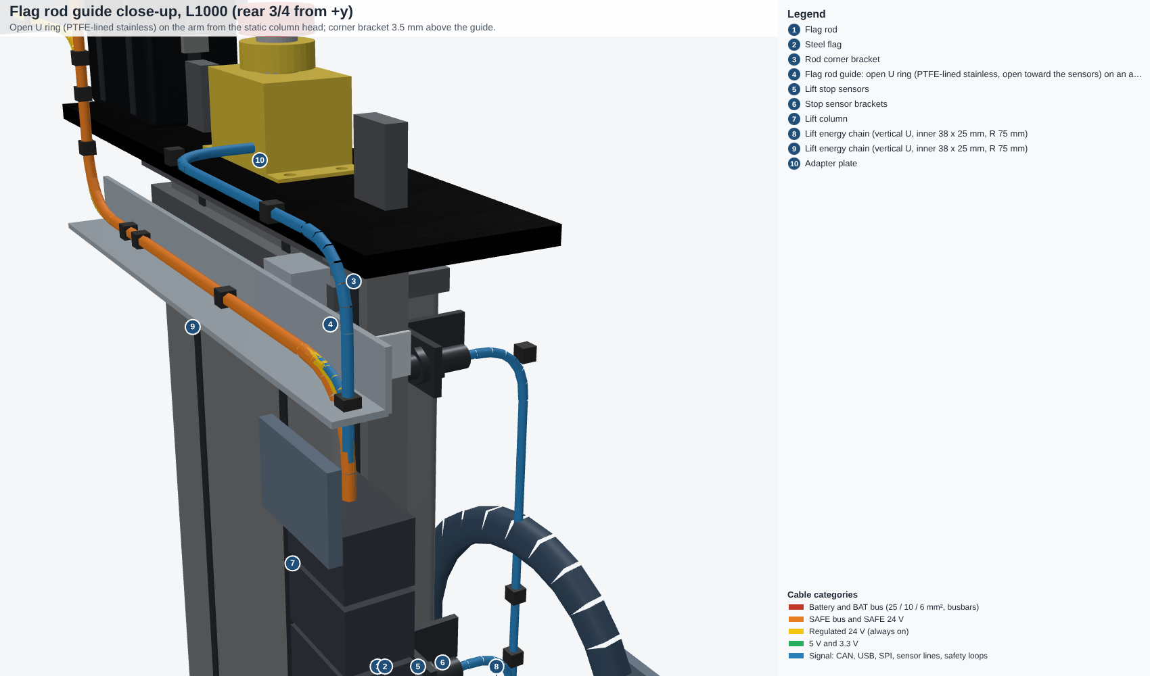
evidence/2026-11-04-layout-harness-flag/after/G1_guide_close_L1000.png
