openAMRobot/openamrobot-docs/evidence/2026-11-04-layout-harness-flag/after/G2_guide_close_L1350.png

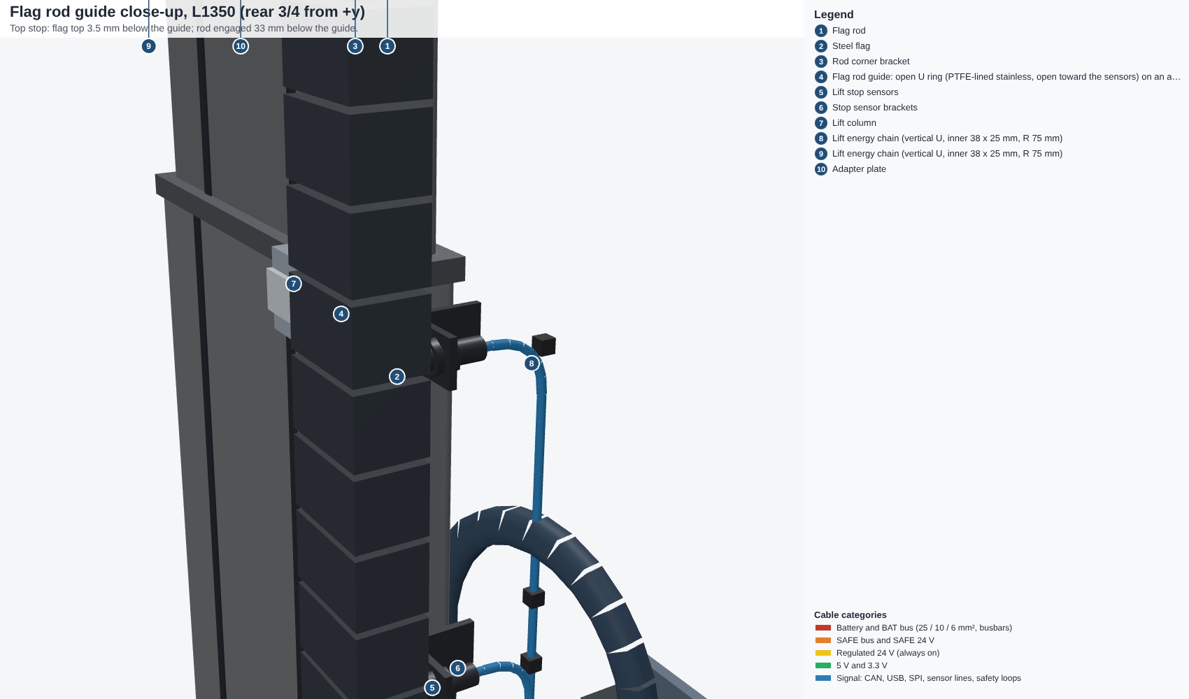
evidence/2026-11-04-layout-harness-flag/after/G2_guide_close_L1350.png
