openAMRobot/openamrobot-docs/evidence/2026-11-04-layout-harness-flag/after/G3_guide_plan_L1000.png

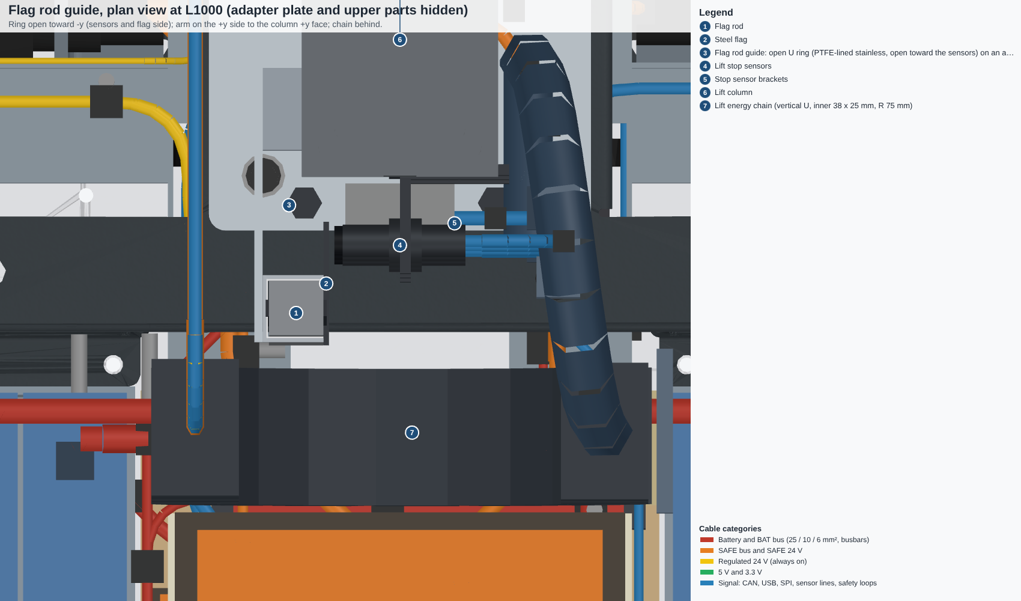
evidence/2026-11-04-layout-harness-flag/after/G3_guide_plan_L1000.png
