openAMRobot/openamrobot-docs/docs/assets/roadmap/model/combined_robot.urdf

<?xml version="1.0" ?>
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
<robot name="openamrobot">
  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
  <link name="base_footprint"/>
  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
  <joint name="base_footprint_joint" type="fixed">
    <origin rpy="0 0 0" xyz="0 0 0.098"/>
    <parent link="base_footprint"/>
    <child link="base_link"/>
  </joint>
  <link name="base_link">
    <inertial>
      <origin rpy="0 0 0" xyz="0.0130206782008723 -0.0172284113080805 0.0442737724499705"/>
      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
      <mass value="4.17533781895232"/>
      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
    </inertial>
    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
  </link>
  <link name="fl_caster_link">
    <inertial>
      <origin rpy="0 0 0" xyz="-0.00137751441938117 1.75682554387491E-06 0.000943582234356817"/>
      <mass value="0.0219398692551679"/>
      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
    </inertial>
    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
  </link>
  <joint name="fl_caster_joint" type="fixed">
    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
    <origin rpy="0 0 0" xyz="0.27505 0.215 -0.043833"/>
    <parent link="base_link"/>
    <child link="fl_caster_link"/>
    <axis xyz="0 0 1"/>
    <dynamics damping="0.001" friction="0.001"/>
  </joint>
  <link name="fl_wheel_link">
    <inertial>
      <origin rpy="0 0 0" xyz="-6.39569062432788E-07 0.000112518782016985 0.00254643003871692"/>
      <mass value="0.0267291642645555"/>
      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
    </inertial>
    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
  </link>
  <joint name="fl_wheel_joint" type="fixed">
    <origin rpy="0 0 0" xyz="-0.015 0 -0.027746"/>
    <parent link="fl_caster_link"/>
    <child link="fl_wheel_link"/>
    <axis xyz="0 1 0"/>
    <dynamics damping="0.001" friction="0.001"/>
  </joint>
  <link name="fr_caster_link">
    <inertial>
      <origin rpy="0 0 0" xyz="-0.001377514419381 1.75682554379164E-06 0.000943582234356991"/>
      <mass value="0.0219398692551674"/>
      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
    </inertial>
    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
  </link>
  <joint name="fr_caster_joint" type="fixed">
    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
    <origin rpy="0 0 0" xyz="0.27505 -0.215 -0.043833"/>
    <parent link="base_link"/>
    <child link="fr_caster_link"/>
    <axis xyz="0 0 1"/>
    <dynamics damping="0.001" friction="0.001"/>
  </joint>
  <link name="fr_wheel_link">
    <inertial>
      <origin rpy="0 0 0" xyz="-7.06559357133152E-07 -5.5142527616292E-07 0.00254642490100031"/>
      <mass value="0.0241949191842345"/>
      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
    </inertial>
    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
  </link>
  <joint name="fr_wheel_joint" type="fixed">
    <origin rpy="0 0 0" xyz="-0.015 0 -0.027746"/>
    <parent link="fr_caster_link"/>
    <child link="fr_wheel_link"/>
    <axis xyz="0 1 0"/>
    <dynamics damping="0.001" friction="0.001"/>
  </joint>
  <link name="br_caster_link">
    <inertial>
      <origin rpy="0 0 0" xyz="-0.001377514419381 1.7568255438194E-06 0.000943582234356914"/>
      <mass value="0.0219398692551676"/>
      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
    </inertial>
    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
  </link>
  <joint name="br_caster_joint" type="fixed">
    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
    <origin rpy="0 0 0" xyz="-0.27495 -0.215 -0.043833"/>
    <parent link="base_link"/>
    <child link="br_caster_link"/>
    <axis xyz="0 0 1"/>
    <dynamics damping="0.001" friction="0.001"/>
  </joint>
  <link name="br_wheel_link">
    <inertial>
      <origin rpy="0 0 0" xyz="-7.06559360075243E-07 -5.51425279493589E-07 0.0025464249010014"/>
      <mass value="0.0241949191842423"/>
      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
    </inertial>
    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
  </link>
  <joint name="br_wheel_joint" type="fixed">
    <origin rpy="0 0 0" xyz="-0.015 0 -0.027746"/>
    <parent link="br_caster_link"/>
    <child link="br_wheel_link"/>
    <axis xyz="0 1 0"/>
    <dynamics damping="0.001" friction="0.001"/>
  </joint>
  <link name="bl_caster_link">
    <inertial>
      <origin rpy="0 0 0" xyz="-0.00137751441938105 1.75682554365286E-06 0.000943582234356866"/>
      <mass value="0.0219398692551676"/>
      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
    </inertial>
    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
  </link>
  <joint name="bl_caster_joint" type="fixed">
    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
    <origin rpy="0 0 0" xyz="-0.27495 0.215 -0.043833"/>
    <parent link="base_link"/>
    <child link="bl_caster_link"/>
    <axis xyz="0 0 1"/>
    <dynamics damping="0.001" friction="0.001"/>
  </joint>
  <link name="bl_wheel_link">
    <inertial>
      <origin rpy="0 0 0" xyz="-7.06559361574044E-07 -5.51425277522943E-07 0.00254642490100057"/>
      <mass value="0.0241949191842375"/>
      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
    </inertial>
    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
  </link>
  <joint name="bl_wheel_joint" type="fixed">
    <origin rpy="0 0 0" xyz="-0.015 0 -0.027746"/>
    <parent link="bl_caster_link"/>
    <child link="bl_wheel_link"/>
    <axis xyz="0 1 0"/>
    <dynamics damping="0.001" friction="0.001"/>
  </joint>
  <link name="left_wheel_link">
    <inertial>
      <origin rpy="0 0 0" xyz="6.28502999154333E-07 -0.0039870676124848 -0.000569790977384271"/>
      <mass value="1.06112497715273"/>
      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
    </inertial>
    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
  </link>
  <joint name="left_wheel_joint" type="continuous">
    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
    <origin rpy="0 0 0" xyz="0 0.200 0"/>
    <parent link="base_link"/>
    <child link="left_wheel_link"/>
    <axis xyz="0 1 0"/>
    <dynamics damping="0.001" friction="0.001"/>
  </joint>
  <link name="right_wheel_link">
    <inertial>
      <origin rpy="0 0 0" xyz="-6.2850299915387E-07 0.0039870676124848 -0.000569790977384271"/>
      <mass value="1.06112497715273"/>
      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
    </inertial>
    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
  </link>
  <joint name="right_wheel_joint" type="continuous">
    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
    <origin rpy="0 0 0" xyz="0 -0.200 0"/>
    <parent link="base_link"/>
    <child link="right_wheel_link"/>
    <axis xyz="0 1 0"/>
    <dynamics damping="0.001" friction="0.001"/>
  </joint>
  <link name="lidar_link">
    <inertial>
      <origin rpy="0 0 0" xyz="-0.028276907815542 0.000919025220279201 -0.0114509307164145"/>
      <mass value="0.167633664227307"/>
      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
    </inertial>
    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
  </link>
  <joint name="lidar_joint" type="fixed">
    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
    <origin rpy="0 0 3.141592653589793" xyz="0.330 0 0.124"/>
    <parent link="base_link"/>
    <child link="lidar_link"/>
    <axis xyz="0 0 0"/>
  </joint>
  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
  <link name="camera_link">
    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
    <inertial>
      <mass value="0.05"/>
      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
    </inertial>
  </link>
  <joint name="camera_joint" type="fixed">
    <origin rpy="0 0 0" xyz="0.35 0 0.20"/>
    <parent link="base_link"/>
    <child link="camera_link"/>
  </joint>
  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
  <link name="camera_optical_frame"/>
  <joint name="camera_optical_joint" type="fixed">
    <origin rpy="-1.5707963 0 -1.5707963" xyz="0 0 0"/>
    <parent link="camera_link"/>
    <child link="camera_optical_frame"/>
  </joint>
  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
  <link name="base_camera_link">
    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
  </link>
  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
  <joint name="base_camera_joint" type="fixed">
    <origin rpy="0 -0.1745 0" xyz="0.387 0 0.046"/>
    <parent link="base_link"/>
    <child link="base_camera_link"/>
  </joint>
  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
  <link name="base_camera_color_optical_frame"/>
  <joint name="base_camera_color_optical_joint" type="fixed">
    <origin rpy="-1.5707963267948966 0 -1.5707963267948966" xyz="0 0 0"/>
    <parent link="base_camera_link"/>
    <child link="base_camera_color_optical_frame"/>
  </joint>
  <link name="base_camera_depth_optical_frame"/>
  <joint name="base_camera_depth_optical_joint" type="fixed">
    <origin rpy="-1.5707963267948966 0 -1.5707963267948966" xyz="0 0 0"/>
    <parent link="base_camera_link"/>
    <child link="base_camera_depth_optical_frame"/>
  </joint>
  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
  <link name="imu_link">
    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
  </link>
  <joint name="imu_joint" type="fixed">
    <origin rpy="0 0 -1.5707963267948966" xyz="0.0544 0 0.1210"/>
    <parent link="base_link"/>
    <child link="imu_link"/>
  </joint>
  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
  <link name="us_front_left">
    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
  </link>
  <joint name="us_front_left_joint" type="fixed">
    <origin rpy="0 0 0" xyz="0.3906 0.13 -0.0066"/>
    <parent link="base_link"/>
    <child link="us_front_left"/>
  </joint>
  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
  <link name="us_front_right">
    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
  </link>
  <joint name="us_front_right_joint" type="fixed">
    <origin rpy="0 0 0" xyz="0.3906 -0.13 -0.0066"/>
    <parent link="base_link"/>
    <child link="us_front_right"/>
  </joint>
  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
  <link name="us_rear_left">
    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
  </link>
  <joint name="us_rear_left_joint" type="fixed">
    <origin rpy="0 0 3.141592653589793" xyz="-0.3886 0.13 -0.0066"/>
    <parent link="base_link"/>
    <child link="us_rear_left"/>
  </joint>
  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
  <link name="us_rear_right">
    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
  </link>
  <joint name="us_rear_right_joint" type="fixed">
    <origin rpy="0 0 3.141592653589793" xyz="-0.3886 -0.13 -0.0066"/>
    <parent link="base_link"/>
    <child link="us_rear_right"/>
  </joint>
  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
  <link name="tof_front">
    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
  </link>
  <joint name="tof_front_joint" type="fixed">
    <origin rpy="0 0.3491 0" xyz="0.399 0 -0.0066"/>
    <parent link="base_link"/>
    <child link="tof_front"/>
  </joint>
  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
  <link name="tof_rear">
    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
  </link>
  <joint name="tof_rear_joint" type="fixed">
    <origin rpy="0 0.3491 3.141592653589793" xyz="-0.399 0 -0.0066"/>
    <parent link="base_link"/>
    <child link="tof_rear"/>
  </joint>
  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
  <link name="lift_column_base_link">
    <inertial>
      <origin rpy="0 0 0" xyz="0 0 0.265"/>
      <mass value="11.7"/>
      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
    </inertial>
    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
  </link>
  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
  <joint name="lift_column_base_joint" type="fixed">
    <parent link="base_footprint"/>
    <child link="lift_column_base_link"/>
    <origin rpy="0 0 0" xyz="0.06 0 0.304"/>
  </joint>
  <link name="lift_carriage_link">
    <inertial>
      <origin rpy="0 0 0" xyz="0.1125 0.0029 0.1013"/>
      <mass value="3.335"/>
      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
    </inertial>
    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
  </link>
  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
  <joint name="lift_joint" type="prismatic">
    <parent link="lift_column_base_link"/>
    <child link="lift_carriage_link"/>
    <origin rpy="0 0 0" xyz="0 0 0.53"/>
    <axis xyz="0 0 1"/>
    <limit effort="800.0" lower="0.0" upper="0.35" velocity="0.018"/>
  </joint>
  <link name="adapter_plate_link">
    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
  </link>
  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
  <joint name="adapter_plate_joint" type="fixed">
    <parent link="lift_carriage_link"/>
    <child link="adapter_plate_link"/>
    <origin rpy="0 0 0" xyz="0.027499999999999997 0 0.005"/>
  </joint>
  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
  <link name="arm_profile_link">
    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
  </link>
  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
  <joint name="arm_profile_joint" type="fixed">
    <parent link="adapter_plate_link"/>
    <child link="arm_profile_link"/>
    <origin rpy="0 0 0" xyz="0.1525 0 0.17500000000000002"/>
  </joint>
  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
  <link name="head_camera_mount_link"/>
  <joint name="head_camera_mount_joint" type="fixed">
    <parent link="lift_carriage_link"/>
    <child link="head_camera_mount_link"/>
    <origin rpy="0 0 0" xyz="0.24 0.0 0.389"/>
  </joint>
  <link name="head_camera_link">
    <inertial>
      <origin rpy="0 0 0" xyz="-0.013 0 0"/>
      <mass value="0.0629"/>
      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
    </inertial>
    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
  </link>
  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
  <joint name="head_camera_pitch_joint" type="fixed">
    <parent link="head_camera_mount_link"/>
    <child link="head_camera_link"/>
    <origin rpy="0 0.5235987755982988 0" xyz="0 0 0"/>
  </joint>
  <link name="head_camera_optical_frame"/>
  <joint name="head_camera_optical_joint" type="fixed">
    <parent link="head_camera_link"/>
    <child link="head_camera_optical_frame"/>
    <origin rpy="-1.5707963267948966 0 -1.5707963267948966" xyz="0 0 0"/>
  </joint>
  <link name="getac_tablet_link">
    <inertial>
      <origin rpy="0 0 0" xyz="0 0 0"/>
      <mass value="0.59"/>
      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
    </inertial>
    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
  </link>
  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
  <joint name="getac_tablet_joint" type="fixed">
    <parent link="arm_profile_link"/>
    <child link="getac_tablet_link"/>
    <origin rpy="0 0 0" xyz="0.0688 0 0.010999999999999982"/>
  </joint>
  <link name="head_light_link">
    <inertial>
      <origin rpy="0 0 0" xyz="0 0 0"/>
      <mass value="0.11"/>
      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
    </inertial>
    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
  </link>
  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
  <joint name="head_light_joint" type="fixed">
    <parent link="arm_profile_link"/>
    <child link="head_light_link"/>
    <origin rpy="0 0 0" xyz="0.06999999999999999 0 -0.12450000000000003"/>
  </joint>
  <link name="second_estop_link">
    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
  </link>
  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
  <joint name="second_estop_joint" type="fixed">
    <parent link="adapter_plate_link"/>
    <child link="second_estop_link"/>
    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
    <origin rpy="0 -1.5707963267948966 0" xyz="-0.027499999999999997 0 0.053"/>
  </joint>
  <link name="lift_stop_sensor_l1000_link">
    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
  </link>
  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
  <joint name="lift_stop_sensor_l1000_joint" type="fixed">
    <parent link="lift_column_base_link"/>
    <child link="lift_stop_sensor_l1000_link"/>
    <origin rpy="0 0 0" xyz="-0.148 0.024 0.12"/>
  </joint>
  <link name="lift_stop_sensor_l1175_link">
    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
  </link>
  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
  <joint name="lift_stop_sensor_l1175_joint" type="fixed">
    <parent link="lift_column_base_link"/>
    <child link="lift_stop_sensor_l1175_link"/>
    <origin rpy="0 0 0" xyz="-0.148 0.024 0.295"/>
  </joint>
  <link name="lift_stop_sensor_l1350_link">
    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
  </link>
  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
  <joint name="lift_stop_sensor_l1350_joint" type="fixed">
    <parent link="lift_column_base_link"/>
    <child link="lift_stop_sensor_l1350_link"/>
    <origin rpy="0 0 0" xyz="-0.148 0.024 0.47"/>
  </joint>
  <link name="head_camera_bracket_link">
    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
  </link>
  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
  <joint name="head_camera_bracket_joint" type="fixed">
    <parent link="head_camera_mount_link"/>
    <child link="head_camera_bracket_link"/>
    <origin rpy="0 0 0" xyz="-0.03 0 -0.03899999999999998"/>
  </joint>
  <link name="lift_flag_rod_link">
    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
  </link>
  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
  <joint name="lift_flag_rod_joint" type="fixed">
    <parent link="adapter_plate_link"/>
    <child link="lift_flag_rod_link"/>
    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
    <origin rpy="0 0 0" xyz="-0.2005 0.038000000000000006 -0.005"/>
  </joint>
  <link name="lift_flag_link">
    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
  </link>
  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
  <joint name="lift_flag_joint" type="fixed">
    <parent link="lift_flag_rod_link"/>
    <child link="lift_flag_link"/>
    <origin rpy="0 0 0" xyz="0.012499999999999983 -0.011000000000000003 -0.41"/>
  </joint>
  <link name="openarm_left_base_link">
    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
    <inertial>
      <origin rpy="0 0 0" xyz="0.00253123748061566 0.0258185540330169 2.70658291858903e-05"/>
      <mass value="1.1432284943239561"/>
      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
    </inertial>
  </link>
  <joint name="openarm_left_base_link_mount_joint" type="fixed">
    <origin rpy="0.0 0.0 0.0" xyz="0.18 0.031 0.166"/>
    <parent link="lift_carriage_link"/>
    <child link="openarm_left_base_link"/>
  </joint>
  <link name="openarm_left_link1">
    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
    <inertial>
      <origin rpy="0 0 0" xyz="0.000900350355624244 0.0444659716892874 2.88441021165683e-05"/>
      <mass value="1.1416684646202298"/>
      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
    </inertial>
  </link>
  <joint name="openarm_left_joint1" type="revolute">
    <origin rpy="0 0 0" xyz="0 0.0625 0"/>
    <parent link="openarm_left_base_link"/>
    <child link="openarm_left_link1"/>
    <axis xyz="0 1 0"/>
    <limit effort="40" lower="-3.4907" upper="1.3963" velocity="16.755"/>
  </joint>
  <link name="openarm_left_link2">
    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
    <inertial>
      <origin rpy="0 0 0" xyz="-0.0247184924346635 -7.60578399428002e-08 -0.0312643102292087"/>
      <mass value="0.2775092746011571"/>
      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
    </inertial>
  </link>
  <joint name="openarm_left_joint2" type="revolute">
    <origin rpy="0 0 0" xyz="0 0.0600000000000001 0"/>
    <parent link="openarm_left_link1"/>
    <child link="openarm_left_link2"/>
    <axis xyz="-1 0 0"/>
    <limit effort="40" lower="-3.3161" upper="0.17453" velocity="16.755"/>
  </joint>
  <link name="openarm_left_link3">
    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
    <inertial>
      <origin rpy="0 0 0" xyz="-0.00300861804638783 -0.000514813312550808 -0.109368241429434"/>
      <mass value="1.073863338202347"/>
      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
    </inertial>
  </link>
  <joint name="openarm_left_joint3" type="revolute">
    <origin rpy="0 0 0" xyz="0 0 -0.0662500000000008"/>
    <parent link="openarm_left_link2"/>
    <child link="openarm_left_link3"/>
    <axis xyz="0 0 -1"/>
    <limit effort="27" lower="-1.5708" upper="1.5708" velocity="5.4454"/>
  </joint>
  <link name="openarm_left_link4">
    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
    <inertial>
      <origin rpy="0 0 0" xyz="-0.00310326243752606 -0.00136538979048502 -0.0574601379354351"/>
      <mass value="0.6348534566833373"/>
      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
    </inertial>
  </link>
  <joint name="openarm_left_joint4" type="revolute">
    <origin rpy="0 0 0" xyz="0 0 -0.15375"/>
    <parent link="openarm_left_link3"/>
    <child link="openarm_left_link4"/>
    <axis xyz="0 -1 0"/>
    <limit effort="27" lower="0" upper="2.4435" velocity="5.4454"/>
  </joint>
  <link name="openarm_left_link5">
    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
    <inertial>
      <origin rpy="0 0 0" xyz="-0.000737188580130584 0.000412406544351845 -0.047093829077211"/>
      <mass value="0.6156588026168502"/>
      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
    </inertial>
  </link>
  <joint name="openarm_left_joint5" type="revolute">
    <origin rpy="0 0 0" xyz="0 0 -0.0955000000000005"/>
    <parent link="openarm_left_link4"/>
    <child link="openarm_left_link5"/>
    <axis xyz="0 0 -1"/>
    <limit effort="7" lower="-1.5708" upper="1.5708" velocity="20.944"/>
  </joint>
  <link name="openarm_left_link6">
    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
    <inertial>
      <origin rpy="0 0 0" xyz="2.27438423593244e-05 -0.00068649602098908 5.44000494765995e-05"/>
      <mass value="0.475202773187987"/>
      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
    </inertial>
  </link>
  <joint name="openarm_left_joint6" type="revolute">
    <origin rpy="0 0 0" xyz="0 0 -0.120499999999998"/>
    <parent link="openarm_left_link5"/>
    <child link="openarm_left_link6"/>
    <axis xyz="0 -1 0"/>
    <limit effort="7" lower="-0.7854" upper="0.7854" velocity="20.944"/>
  </joint>
  <joint name="openarm_left_joint7" type="revolute">
    <origin rpy="0 0 0" xyz="0 0 0"/>
    <parent link="openarm_left_link6"/>
    <child link="openarm_left_ee_base_link"/>
    <axis xyz="1 0 0"/>
    <limit effort="7" lower="-1.5708" upper="1.5708" velocity="20.944"/>
  </joint>
  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
  <link name="openarm_left_ee_base_link">
    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
    <inertial>
      <origin rpy="0.0 -0.0 0.0" xyz="0.0137902 -0.0084073 -0.05938"/>
      <mass value="0.52832"/>
      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
    </inertial>
  </link>
  <link name="openarm_left_ee_link1">
    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
    <inertial>
      <origin rpy="0 0 0" xyz="-0.0124990911725494 -0.00176592789915655 -0.0241663193888537"/>
      <mass value="0.125979047366671"/>
      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
    </inertial>
  </link>
  <link name="openarm_left_ee_link2">
    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
    <inertial>
      <origin rpy="0 0 0" xyz="-0.012796 0.0020183 -0.026792"/>
      <mass value="0.11372"/>
      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
    </inertial>
  </link>
  <joint name="openarm_left_finger_joint1" type="revolute">
    <origin rpy="0.0 -0.0 0.0" xyz="-0.0014300000000005003 -0.0180000000000009 -0.0680000000000174"/>
    <parent link="openarm_left_ee_base_link"/>
    <child link="openarm_left_ee_link1"/>
    <axis xyz="-1 0 0"/>
    <limit effort="7" lower="0" upper="0.7854" velocity="5"/>
  </joint>
  <joint name="openarm_left_finger_joint2" type="revolute">
    <origin rpy="0.0 -0.0 0.0" xyz="-0.0014300000000005003 0.0180000000000012 -0.0680000000000215"/>
    <parent link="openarm_left_ee_base_link"/>
    <child link="openarm_left_ee_link2"/>
    <axis xyz="1 0 0"/>
    <limit effort="7" lower="0" upper="0.7854" velocity="5"/>
    <mimic joint="openarm_left_finger_joint1" multiplier="1" offset="0"/>
  </joint>
  <link name="openarm_left_grasp_frame"/>
  <joint name="openarm_left_grasp_frame_joint" type="fixed">
    <origin rpy="-0.0 1.570796326794893 0.0" xyz="-0.0014300000000008993 -0.0 -0.138000000000019"/>
    <parent link="openarm_left_ee_base_link"/>
    <child link="openarm_left_grasp_frame"/>
  </joint>
  <link name="openarm_right_base_link">
    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
    <inertial>
      <origin rpy="0 0 0" xyz="0.00253123748061566 -0.0258185540330169 2.70658291858903e-05"/>
      <mass value="1.1432284943239561"/>
      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
    </inertial>
  </link>
  <joint name="openarm_right_base_link_mount_joint" type="fixed">
    <origin rpy="0.0 0.0 0.0" xyz="0.18 -0.031 0.166"/>
    <parent link="lift_carriage_link"/>
    <child link="openarm_right_base_link"/>
  </joint>
  <link name="openarm_right_link1">
    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
    <inertial>
      <origin rpy="0 0 0" xyz="0.000900350355624244 -0.0444659716892874 2.88441021165683e-05"/>
      <mass value="1.1416684646202298"/>
      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
    </inertial>
  </link>
  <joint name="openarm_right_joint1" type="revolute">
    <origin rpy="0 0 0" xyz="0 -0.0625 0"/>
    <parent link="openarm_right_base_link"/>
    <child link="openarm_right_link1"/>
    <axis xyz="0 -1 0"/>
    <limit effort="40" lower="-1.3963" upper="3.4907" velocity="16.755"/>
  </joint>
  <link name="openarm_right_link2">
    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
    <inertial>
      <origin rpy="0 0 0" xyz="-0.0247184924346635 7.60578399428002e-08 -0.0312643102292087"/>
      <mass value="0.2775092746011571"/>
      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
    </inertial>
  </link>
  <joint name="openarm_right_joint2" type="revolute">
    <origin rpy="0 0 0" xyz="0 -0.0600000000000001 0"/>
    <parent link="openarm_right_link1"/>
    <child link="openarm_right_link2"/>
    <axis xyz="-1 0 0"/>
    <limit effort="40" lower="-0.17453" upper="3.3161" velocity="16.755"/>
  </joint>
  <link name="openarm_right_link3">
    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
    <inertial>
      <origin rpy="0 0 0" xyz="-0.00300861804638783 -0.000514813312550808 -0.109368241429434"/>
      <mass value="1.073863338202347"/>
      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
    </inertial>
  </link>
  <joint name="openarm_right_joint3" type="revolute">
    <origin rpy="0 0 0" xyz="0 0 -0.0662500000000008"/>
    <parent link="openarm_right_link2"/>
    <child link="openarm_right_link3"/>
    <axis xyz="0 0 -1"/>
    <limit effort="27" lower="-1.5708" upper="1.5708" velocity="5.4454"/>
  </joint>
  <link name="openarm_right_link4">
    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
    <inertial>
      <origin rpy="0 0 0" xyz="-0.00310326243752606 -0.00136538979048502 -0.0574601379354351"/>
      <mass value="0.6348534566833373"/>
      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
    </inertial>
  </link>
  <joint name="openarm_right_joint4" type="revolute">
    <origin rpy="0 0 0" xyz="0 0 -0.15375"/>
    <parent link="openarm_right_link3"/>
    <child link="openarm_right_link4"/>
    <axis xyz="0 -1 0"/>
    <limit effort="27" lower="0" upper="2.4435" velocity="5.4454"/>
  </joint>
  <link name="openarm_right_link5">
    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
    <inertial>
      <origin rpy="0 0 0" xyz="-0.000737188580130584 -0.000412406544351845 -0.047093829077211"/>
      <mass value="0.6156588026168502"/>
      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
    </inertial>
  </link>
  <joint name="openarm_right_joint5" type="revolute">
    <origin rpy="0 0 0" xyz="0 0 -0.0955000000000005"/>
    <parent link="openarm_right_link4"/>
    <child link="openarm_right_link5"/>
    <axis xyz="0 0 -1"/>
    <limit effort="7" lower="-1.5708" upper="1.5708" velocity="20.944"/>
  </joint>
  <link name="openarm_right_link6">
    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
    <inertial>
      <origin rpy="0 0 0" xyz="2.27438423593244e-05 0.00068649602098908 5.44000494765995e-05"/>
      <mass value="0.475202773187987"/>
      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
    </inertial>
  </link>
  <joint name="openarm_right_joint6" type="revolute">
    <origin rpy="0 0 0" xyz="0 0 -0.120499999999998"/>
    <parent link="openarm_right_link5"/>
    <child link="openarm_right_link6"/>
    <axis xyz="0 1 0"/>
    <limit effort="7" lower="-0.7854" upper="0.7854" velocity="20.944"/>
  </joint>
  <joint name="openarm_right_joint7" type="revolute">
    <origin rpy="0 0 0" xyz="0 0 0"/>
    <parent link="openarm_right_link6"/>
    <child link="openarm_right_ee_base_link"/>
    <axis xyz="1 0 0"/>
    <limit effort="7" lower="-1.5708" upper="1.5708" velocity="20.944"/>
  </joint>
  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
  <link name="openarm_right_ee_base_link">
    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
    <inertial>
      <origin rpy="0.0 -0.0 0.0" xyz="0.0137902 0.0084073 -0.05938"/>
      <mass value="0.52832"/>
      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
    </inertial>
  </link>
  <link name="openarm_right_ee_link1">
    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
    <inertial>
      <origin rpy="0 0 0" xyz="-0.0124990911725494 0.00176592789915655 -0.0241663193888537"/>
      <mass value="0.125979047366671"/>
      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
    </inertial>
  </link>
  <link name="openarm_right_ee_link2">
    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
    <inertial>
      <origin rpy="0 0 0" xyz="-0.012796 -0.0020183 -0.026792"/>
      <mass value="0.11372"/>
      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
    </inertial>
  </link>
  <joint name="openarm_right_finger_joint1" type="revolute">
    <origin rpy="0.0 -0.0 0.0" xyz="-0.0014300000000005003 0.0180000000000009 -0.0680000000000174"/>
    <parent link="openarm_right_ee_base_link"/>
    <child link="openarm_right_ee_link1"/>
    <axis xyz="-1 0 0"/>
    <limit effort="7" lower="-0.7854" upper="0" velocity="5"/>
  </joint>
  <joint name="openarm_right_finger_joint2" type="revolute">
    <origin rpy="0.0 -0.0 0.0" xyz="-0.0014300000000005003 -0.0180000000000012 -0.0680000000000215"/>
    <parent link="openarm_right_ee_base_link"/>
    <child link="openarm_right_ee_link2"/>
    <axis xyz="1 0 0"/>
    <limit effort="7" lower="-0.7854" upper="0" velocity="5"/>
    <mimic joint="openarm_right_finger_joint1" multiplier="1" offset="0"/>
  </joint>
  <link name="openarm_right_grasp_frame"/>
  <joint name="openarm_right_grasp_frame_joint" type="fixed">
    <origin rpy="-0.0 1.570796326794893 0.0" xyz="-0.0014300000000008993 0.0 -0.138000000000019"/>
    <parent link="openarm_right_ee_base_link"/>
    <child link="openarm_right_grasp_frame"/>
  </joint>
  <link name="left_wrist_camera_link">
    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
  </link>
  <joint name="left_wrist_camera_joint" type="fixed">
    <parent link="openarm_left_ee_base_link"/>
    <child link="left_wrist_camera_link"/>
    <origin rpy="0.0 0.0 0.0" xyz="0.0 0.05 -0.03"/>
  </joint>
  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
  <link name="left_wrist_camera_optical_frame"/>
  <joint name="left_wrist_camera_optical_joint" type="fixed">
    <parent link="left_wrist_camera_link"/>
    <child link="left_wrist_camera_optical_frame"/>
    <origin rpy="-1.5707963267948966 0 -1.5707963267948966" xyz="0 0 0"/>
  </joint>
  <link name="right_wrist_camera_link">
    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
  </link>
  <joint name="right_wrist_camera_joint" type="fixed">
    <parent link="openarm_right_ee_base_link"/>
    <child link="right_wrist_camera_link"/>
    <origin rpy="0.0 0.0 0.0" xyz="0.0 -0.05 -0.03"/>
  </joint>
  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
  <link name="right_wrist_camera_optical_frame"/>
  <joint name="right_wrist_camera_optical_joint" type="fixed">
    <parent link="right_wrist_camera_link"/>
    <child link="right_wrist_camera_optical_frame"/>
    <origin rpy="-1.5707963267948966 0 -1.5707963267948966" xyz="0 0 0"/>
  </joint>
  <ros2_control name="openarm_left_hardware_interface" type="system">
    <hardware>
      <param name="arm_type">v20</param>
      <plugin>mock_components/GenericSystem</plugin>
      <param name="fake_sensor_commands">False</param>
      <param name="state_following_offset">0.0</param>
    </hardware>
    <joint name="openarm_left_joint1">
      <command_interface name="position"/>
      <command_interface name="velocity"/>
      <command_interface name="effort"/>
      <state_interface name="position">
        <param name="initial_value">0.0</param>
      </state_interface>
      <state_interface name="velocity">
        <param name="initial_value">0.0</param>
      </state_interface>
      <state_interface name="effort">
        <param name="initial_value">0.0</param>
      </state_interface>
    </joint>
    <joint name="openarm_left_joint2">
      <command_interface name="position"/>
      <command_interface name="velocity"/>
      <command_interface name="effort"/>
      <state_interface name="position">
        <param name="initial_value">0.0</param>
      </state_interface>
      <state_interface name="velocity">
        <param name="initial_value">0.0</param>
      </state_interface>
      <state_interface name="effort">
        <param name="initial_value">0.0</param>
      </state_interface>
    </joint>
    <joint name="openarm_left_joint3">
      <command_interface name="position"/>
      <command_interface name="velocity"/>
      <command_interface name="effort"/>
      <state_interface name="position">
        <param name="initial_value">0.0</param>
      </state_interface>
      <state_interface name="velocity">
        <param name="initial_value">0.0</param>
      </state_interface>
      <state_interface name="effort">
        <param name="initial_value">0.0</param>
      </state_interface>
    </joint>
    <joint name="openarm_left_joint4">
      <command_interface name="position"/>
      <command_interface name="velocity"/>
      <command_interface name="effort"/>
      <state_interface name="position">
        <param name="initial_value">0.0</param>
      </state_interface>
      <state_interface name="velocity">
        <param name="initial_value">0.0</param>
      </state_interface>
      <state_interface name="effort">
        <param name="initial_value">0.0</param>
      </state_interface>
    </joint>
    <joint name="openarm_left_joint5">
      <command_interface name="position"/>
      <command_interface name="velocity"/>
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
      <state_interface name="position">
        <param name="initial_value">0.0</param>
      </state_interface>
      <state_interface name="velocity">
        <param name="initial_value">0.0</param>
      </state_interface>
    </joint>
  </ros2_control>
</robot>
