openAMRobot/openamrobot-docs/scripts/roadmap_model/facts.yaml

# Section B facts of record (Drive documents and team Slack, as of 1 Nov 2026) that the model uses.
# Units: metres, kilograms, radians unless stated. Frame: base_footprint (floor under the drive-axle midpoint,
# x forward, y left, z up, REP 103/105). base_link = base_footprint + base_link_z.
snapshot: "8 Nov 2026"
window: "24 Oct to 1 Nov 2026"
documents:
  P-03: rev20.6 (8 Nov 2026; item 30, decision baseline of 8 Nov 2026, D-01 to D-34)
  E-01: rev1.8 (8 Nov 2026; design text only since rev1.6, safety items pending D-22 to D-25, D-28, D-33)
  M-01: rev19.9 (8 Nov 2026)
  P-02: rev19.2
  BOM: Issue 7.14 (27 Oct 2026, with 1 Nov changes; 146 records, 115 onboard)
  B-02: rev18.10 (25 Oct 2026)
  S-01: rev18.3
  UC1: Use Case 1 Requirements Baseline rev18.5
  decisions: .github decisions.yaml 5ed600e (main after openAMRobot/.github#84; in_force P-03-rev20.2)
  datums: openamr-upperbody-sw datums.yaml 2026-11-01.d (a8c304d; .c to .d adds the lift velocity and effort limits only, no geometry)
  sensor_frames: openamr-platform-sw sensor_frames.yaml (4926f40)
base_link_z: 0.098          # B7, datums base_link_height_above_floor
wheel_radius_supplier: 0.100  # datums drive_wheel_radius
wheel_compression: 0.002     # owner decision 2 Nov 2026 (B1): rubber tyres r 0.100 on the axle at 0.098; the 2 mm is intended tyre
                             # compression under load and levels the rigid chassis (no suspension); wheel-to-floor overlap <= 2 mm is an intended contact
track: 0.400                 # placeholder; 0.46 measured on the legacy robot
chassis: [0.780, 0.582]
base_sheet: {bottom: 0.052, top: 0.054}
deck: 0.294
cover_underside: 0.290      # deck 0.054 + 236 mm (B5)
# slot between the base panels and the cover skirt (CAD v0.2 base GLB: side, front and rear panel tops z 0.2142 to 0.2150, cover lower edge z 0.2321):
# the LiDAR looks out through it; owner rule 8 Nov 2026 (P-03 rev20.5 item 29): no cable and no tie in the slot band, all around the robot, no inward band
cover_slot: {panel_top: 0.2142, cover_edge: 0.2321, margin: 0.003, depth: 0.005}   # owner rule 8 Nov 2026 (P-03 rev20.5 item 29): the band at the panels, no 50 mm inward band
# lift base plate MEC-019, owner decision 2 Nov 2026 (B3): one 10 mm 6082-T6 plate on the centre-frame arch top (z 0.294), bolted from above
# into the inner arch pattern (CAD MMP.04.00.00.000: 4 x M8 at x +/-0.060, y +/-0.050). Decision D-20 (8 Nov 2026, approved, rule
# "most COTS, fewest operations, fewest custom parts"): the column foot is fixed from above through its four mounting-tab holes
# (260 x 30 mm, counterbores on the foot top face, seat 4.5 mm) with 4 x DIN 7984 M8 x 14 8.8, no washer, medium threadlocker, into
# M8 tapped through MEC-019 (9.5 mm engagement, no inserts). MEC-019 is 350 x 140 mm (10 mm longer at each end than 330 mm, so the
# tab holes keep 20 mm edge distance). The 224 x 40 mm pattern is DOLD-internal (opens on the foot underside). Machining is released
# only after the DOLD drawing and a dry fit (mechanical owner).
lift_plate: {size: [0.350, 0.140, 0.010], x: [-0.090, 0.260], top: 0.304, arch_bolts: {x: [-0.060, 0.060], y: [-0.050, 0.050]},
             arch_outer: {x: [-0.095, 0.095], y: [-0.150, 0.150]}, col_axis_x: {bp000: 0.060, bp050: 0.110}, col_screws: [0.260, 0.030],
             col_fixing: {screw: "DIN 7984 M8 x 14 8.8", qty: 4, from: above, into: "M8 tapped through MEC-019", engagement: 0.0095, washer: none,
                          threadlocker: medium, decision: D-20, status: "approved; machining after the DOLD drawing and a dry fit (mechanical owner)"}}
arch: {top: 0.294, sheet: 0.002, walls_x: [-0.117, 0.117], ribs_y: [-0.077, 0.077], material: "S235JR (EN 1.0114), 2 mm"}
# GI-082 fix decided by the owner on 8 Nov 2026: 4 x M8 8.8 through-bolts and a backing plate under the arch top sheet. Decision D-21 (8 Nov 2026,
# approved with the D-20 rule): one laser-cut tapped steel plate if the mechanical owner confirms the space, otherwise 5 mm S235 with press-in (PEM) nuts.
# The screening below uses 5 mm S235; size about 150 x 130 mm until the drawing (with the two 50 x 24 mm lift cable openings).
arch_fix: {kind: through-bolts with backing plate, bolts: M8 8.8, backing_t: 0.005, backing_material: S235JR, backing_size: [0.150, 0.130],
           backing_options: "tapped plate or 5 mm S235 with press-in nuts, the mechanical owner confirms", decision: D-21, status: "approved rule, drawing pending (mechanical owner)"}
column: {section: [0.240, 0.060], retracted: 0.530, stroke: 0.350, mass: 11.7,
         # DOLD supplier CAD Hexalift_EB530_Hub350_mit_Montagelaschen.STEP (owner, 8 Nov 2026; OCC bounding boxes, column frame: z from the column base)
         foot: [0.280, 0.0604, 0.010], static_bottom: 0.010, static_profile_top: 0.503, static_top: 0.505,
         inner: [0.2095, 0.0533, 0.470], inner_bottom_retracted: 0.060,
         foot_screws: {x: 0.112, y: 0.020, role: "DOLD-internal (224 x 40 mm, underside counterbores), not the robot fixing"},
         tab_holes: {x: 0.130, y: 0.015, seat: 0.0045, role: "robot fixing (260 x 30 mm, top-face counterbores), D-20"},
         step: "Hexalift_EB530_Hub350_mit_Montagelaschen.STEP (DOLD, 2019-01-28)",
         # 11.7 kg catalogue split into the static and the moving share (8 Nov 2026), from the STEP boxes above and the materials:
         # z_col = centre of mass height in the column frame at the retracted stop; the drive takes the rest of the catalogue mass
         mass_split: {
           static: [{part: "outer profile 240 x 60, 0.6 m perimeter x 3 mm wall x 0.493 m, aluminium", kg: 2.40, z_col: 0.257},
                    {part: "foot with mounting tabs 280 x 60 x 10 mm, steel", kg: 1.33, z_col: 0.005},
                    {part: "motor, gearbox, spindle and control in the foot (catalogue rest)", kg: 5.16, z_col: 0.100}],
           moving: [{part: "inner profile 209.5 x 53.3, 0.526 m perimeter x 3 mm wall x 0.47 m, aluminium", kg: 2.00, z_col: 0.295},
                    {part: "top cap 240 x 60 x 8 mm, aluminium", kg: 0.31, z_col: 0.530},
                    {part: "push tube D20 x 2 x 450 mm steel with the spindle nut", kg: 0.50, z_col: 0.300}]}}
shoulder: {L1000: 1.000, L1175: 1.175, L1350: 1.350}
head_lens_L1000: 1.223
imu_z: 0.21904
us_z: 0.0914
lidar_scan_plane: 0.22205
mass_cap: 120.0
motor_pair_rating: 120.0
speed_max: 1.5               # analytical command ceiling (P-03 item 10)
speed_cap_build1: 0.5        # D-07 (P-03 rev20.5 item 29): base speed ceiling 0.5 m/s until measured stop acceptance; designed limit, not measured
speed_cap_status: "designed limit, not measured (stop tests at 0.2, 0.3 and 0.5 m/s, limit 0.15 m)"
# D-01 (P-03 rev20.5 item 29): compute; exact carrier SKU, fit and power are an evidence hold. The 118.1 x 115 x 45 mm envelope of the
# earlier J401 outline stays until the Robotics 104 drawing.
compute: {module: "NVIDIA Jetson Orin NX 8 GB (900-13767-0010-000)", carrier: "Seeed reComputer Robotics 104", decision: D-01,
          hold: "exact carrier SKU, fit and power to confirm"}
# D-11 (P-03 rev20.5 item 29): CTL-017 is the single upper-body controller on CAN3 (CANopen 500 kbit/s, node 0x10); board proposed
# (the electrical owner checks): NUCLEO-G474RE + BLDC-SHIELD_IFX007T + SN65HVD230. Stop sensors SICK IME12-04BNSZC0S are NPN NO, 10 to 30 V.
upperbody_controller: {id: CTL-017, bus: CAN3, node: "0x10", bitrate_kbit: 500, board: "NUCLEO-G474RE + BLDC-SHIELD_IFX007T + SN65HVD230 (proposed, the electrical owner checks)",
                       scope: "lift H-bridge and Halls, three stop sensors, light bar, ZX80 power and charge enable, spare inputs (functional only)",
                       stop_sensor_output: "NPN NO, 10 to 30 V (pull-up to 24 V on CTL-017)", decision: D-11}
estop_clear_below_top: 0.180
# D-27 (8 Nov 2026, approved): 8 x EVE LF105 in two trays (two 4-cell packs) joined by PWR-018, trays sized from delivered cell data,
# 300 +/- 20 kgf compression, two-tray RFQ. The single-row envelope is superseded and kept only for the hidden legacy outline.
battery: {envelope: [0.140, 0.314, 0.210], envelope_status: "superseded single-row outline (B-02 rev18.10), not drawn", trays: 2, cells_per_tray: 4,
          tray_link: PWR-018, compression_kgf: [280, 320], cells: 8, cell_mass: 1.98, assembly_mass: [20.0, 23.0], decision: D-27}
rear_zones:   # B5 / platform-sw #95: free zones next to the cells (x, y, z extents)
  behind: {x: [-0.347, -0.277], y: [-0.157, 0.157], z: [0.054, 0.264]}
  side_l: {x: [-0.277, -0.137], y: [0.157, 0.248], z: [0.054, 0.264]}
  side_r: {x: [-0.277, -0.137], y: [-0.248, -0.157], z: [0.054, 0.264]}
front_bay: {x: [0.137, 0.366], y: [-0.166, 0.166], z: [0.057, 0.290], plate_t: 0.003}
# TZBOT WCM-500-24 receiver (manual V2.5: 170 x 150 x 52 mm, about 1.5 kg). Owner correction A1 as corrected on 2 Nov 2026 (owner; to be
# entered in P-03 and M-01; register CHARGING): wireless charging prepared in 2.0, the receiver unit is installed later (manual charging through SB50 at any time); 170 mm along the
# robot (x) x 150 mm across (y), centred on the long axis, as close to the rear panel inner face as possible without touching the rear
# TF-Luna, the rear MB7060s, their mounts or the rear panel flange (rear_layout.py measures them); bottom 2 mm below the base-sheet
# underside (50 mm above the floor). No 240 x 210 mm zone (withdrawn). No transmitter is drawn.
tzbot_receiver: {model: WCM-500-24, source: "TZBOT WCM-500-24 Wireless Charger Instruction Manual V2.5 (2021-09-23)", size: [0.170, 0.150, 0.052], mass: 1.5, touch_clear: 0.001,
                 status: "prepared, installed later", below_base_sheet: 0.002, air_gap: [0.010, 0.030], air_gap_nominal: 0.020,
                 align: [0.020, 0.020], metal_clear: 0.020, metal_clear_above: 0.015,   # owner decision 8 Nov 2026: no metal within 20 mm of the receiver sides (manual V2.5 Figure 4, A >= 2 cm), held by a plastic frame on the steel deck; 15 mm above (owner, TZBOT recommends 20 mm)
                 frame: {width: 0.020, material: "3D-printed plastic (first iteration)", design: "mechanical owner, D-02 and D-03", fixing: "screws to the base sheet; receiver screwed or clipped into the frame"},
                 
                 freq_khz: [30, 60], data_link_ghz: [2.400, 2.485], data_link_dbm: 0, output_v: [12, 30], output_a: [8, 15], efficiency_min: 0.85,
                 signals: {brown: "start, active high, 3 to 30 V DC", yellow: "fault, active low, open collector, max 200 mA, 30 V DC", blue: "signal ground",
                           red: "receiver output to battery +", black: "receiver output to battery -"}}
# rear section (A1, A9): the CAD v0.2 dimensions measured by rear_layout.py are the reference (A9, 2 Nov 2026);
# side pockets (side-wall inner width - 150) / 2 across, minus the 20 mm metal-free frame next to the receiver (owner decision 8 Nov 2026)
rear_section: {rear_panel_inner_x: -0.370, arch_edge_x: -0.135, side_wall_inner_y: 0.288,
               power_plate: {t: 0.003, min_above_receiver: 0.015, material: "G10 glass-epoxy (non-metal)"}}   # owner decisions 3 and 8 Nov 2026: 15 mm above the receiver top (TZBOT recommends 20 mm)
# 8 x EVE LF105 (200 h x 130 x 38 mm, 1.98 kg) upright, 4 per side pocket, 8S (replaces the single row across the robot, B-02 rev18.10)
cells: {h: 0.200, l: 0.130, w: 0.038, mass: 1.98, per_pocket: 4, gap: 0.002, tray_floor: 0.003, restraint_wall: 0.003, clear_to_margin: 0.002,
        tray_from_receiver: 0.020}   # trays 20 mm beside the receiver: the metal-free frame width (owner decision 8 Nov 2026)
tzbot_transmitter: {size: [0.170, 0.150, 0.052], mass: 1.5}   # floor station (installed with the receiver), same outer size (manual V2.5); not drawn
emc_flag_distance: 0.050      # roadmap screening value until TZBOT gives a minimum distance
front_bay_layout: single   # owner correction A2 (2 Nov 2026): one layout, one plate on the base sheet; second tier only if one plate does not fit
second_estop: {position: adapter_top, housing: [0.064, 0.050, 0.050], button_up: true}   # owner correction A5 (2 Nov 2026): on top of the adapter plate behind the post, centred in y, button up
getac: {orientation: portrait, size: [0.0176, 0.1498, 0.234], item26_z: 0.246, lower_by: 0.055, light_gap: 0.010}   # owner correction A3 (2 Nov 2026: 40 mm lower), owner decision 8 Nov 2026: 15 mm lower again (55 mm), light bar still 10 mm below
zed_ahead_of_j1a: 0.060   # owner decision 8 Nov 2026 (was 0.057, owner correction A4 of 2 Nov 2026; 0.042 before)
# lowest points of the robot below the base sheet (full assembly STEP MMP.00.00.00.000_full_assembly, openamr-platform-hw main,
# exact OCC bounding boxes of every solid, floor at the castor wheel bottom; base sheet at 52.0 / 54.0 mm as corrected in base_mesh_map.yaml)
cad_lowest: {drive_tyre: -0.0020, castor_wheels: 0.0, castor_bolt_tips_m6x20: 0.0410, m5x20_bolt_tips: 0.0448, m4x16_bolt_tips: 0.0460,
             lidar_support_m4_bolt_tips: 0.0472, nuts_and_washers: [0.0470, 0.0510], base_sheet_bottom: 0.052}
# A6 (owner correction, 2 Nov 2026; to be entered in P-03 and M-01): lift stop sensors and flag rod at the rear of the column.
# Inputs only; frames.lift_rear_layout() derives the sensor, flag, rod, corner-bracket and adapter-plate geometry (column frame:
# x from the column axis, y lateral, z above the column base = lift base-plate top). Sensor and bracket outlines as LIFT-SNS-01 rev 1.
lift_rear: {column_rear_x: -0.120, sensor_z: [0.120, 0.295, 0.470], sensor: {d: 0.012, len: 0.048}, bracket: {leg: 0.040, t: 0.004, h: 0.025, axis_from_face: 0.028},
            flag: [0.045, 0.002, 0.020], gap: 0.002, rod_clear: 0.009, rod: {w: 0.020, len: 0.430}, corner: {leg: 0.020, t: 0.003},
            bolt_edge: 0.012, flag_below_plate: 0.410, plate: {front_x: 0.240, width: 0.100, t: 0.010, material: "6082-T6"},
            lift_node_z: 0.355}
