openAMRobot/openamrobot-docs/scripts/roadmap_model/build.py

#!/usr/bin/env python3
"""Build the placement data of the OpenAMRobot 2.0 roadmap model from its sources.

Reads datums.yaml (openamr-upperbody-sw), sensor_frames.yaml (openamr-platform-sw), facts.yaml (section B
facts of record), parts.yaml (parts table), bom_map.yaml (BOM line coverage), the PARTS list of hardware.html
(BOM Issue 7.14), the base GLB (model/base_glb.js) and the design-intent index (model/design_intent/index.json).
Writes, under docs/assets/roadmap/model/:
  placement.json         parts the model draws on top of the GLB and the upper-body primitives (model.js loads it)
  exploded.json          entries (stage, exploded and opened-base offsets) for every placement part, stage 9 Harness
  bom_coverage.csv       one row per BOM 7.14 line
  fastener_schedule.csv  every fastener of the model (named or proposed), the start of MEC-014
  cable_list.csv         every cable of the harness with route length plus 10 % service margin
  assembly_sequence.csv  proposed assembly order with tool access checks
Next week's update: edit parts.yaml / bom_map.yaml / facts.yaml and rerun
  python3 scripts/roadmap_model/build.py
Sources are read from ../src (override with OAMR_SRC).
"""
import csv
import html as H
import itertools
import json
import math
import os
import re

import numpy as np

import front_bay as FB
from frames import FACTS, HERE, MODEL, REPO, SENSOR_FRAMES, aabb, bl_to_bf, datums, glb_nodes, lift_rear_layout, load_yaml, sensor_frames, tzbot_layout

R = lambda v, n=4: round(float(v), n)
MM = 0.001

DOMAIN_COL = {"BAT": "#c0392b", "SAFE": "#e67e22", "R24": "#f1c40f", "LV": "#27ae60", "SIG": "#2980b9", "MECH": "#7f8c8d"}
BODY_COL = {"BAT": "#3b3f46", "SAFE": "#4a4036", "R24": "#4b4a36", "LV": "#34463b", "SIG": "#1f3b57", "MECH": "#8a939b"}


# ---------------------------------------------------------------- sources
def bom_parts():
    s = open(os.path.join(REPO, "docs/assets/roadmap/hardware.html"), encoding="utf-8").read()
    i = s.index("var PARTS=") + 10
    parts, _ = json.JSONDecoder().raw_decode(s, i)
    return {k: v for k, v in parts.items() if re.match(r"^[A-Z]+(?:-[A-Z0-9]+)+$", k)}


def upper_body(D, rev):
    """Upper-body reference points (base_footprint, bp000, L1000) derived from datums.yaml and B7."""
    f = FACTS
    ax = f["lift_plate"]["col_axis_x"]["bp000"]
    top = f["lift_plate"]["top"] + f["column"]["retracted"]          # column top / carriage reference at L1000
    prof_front = ax + 0.18 + 0.06
    # owner corrections A3 / A4 / A5 (owner, 2 Nov 2026; to be entered in P-03 and M-01): Getac portrait, centre 40 mm lower; light bar
    # top edge 10 mm below the Getac bottom; ZED lens 57 mm ahead of J1_A; second E-stop on the adapter plate behind the post
    gs = FACTS["getac"]["size"]
    g_z = top + D["getac_tablet_z_above_column_top"] - FACTS["getac"]["lower_by"]
    light_top = g_z - gs[2] / 2 - FACTS["getac"]["light_gap"]
    eh = FACTS["second_estop"]["housing"]
    static_top = top - D["lift_static_profile_top_below_column_top"]
    return {
        "datums_revision": rev, "col_axis_x": ax, "col_top": top, "static_top": static_top,
        "shoulder": [ax + 0.18, 0.031, top + 0.166], "prof_front": prof_front,
        "head_lens": [ax + 0.18 + FACTS["zed_ahead_of_j1a"], 0.0, top + 0.166 + 0.223],
        "getac": [prof_front + gs[0] / 2, 0.0, g_z], "getac_size": gs,
        "head_light": [prof_front + D["head_light_size"][0] / 2, 0.0, light_top - D["head_light_size"][2] / 2],
        "estop2": [ax, 0.0, top + 0.010 + eh[2] / 2], "estop2_actuator_z": round(top + 0.010 + eh[2] + 0.007, 4),
        "estop2_actuator_z_stops": {k: round(top + 0.010 + eh[2] + 0.007 + tr, 4) for k, tr in (("L1000", 0.0), ("L1175", 0.175), ("L1350", 0.350))},
        "col_rear_x": ax - 0.12, "col_front_x": ax + 0.12,
        "lift_sensor_z": [FACTS["lift_plate"]["top"] + D["lift_stop_sensor_z_" + k] for k in ("l1000", "l1175", "l1350")],
    }


# ---------------------------------------------------------------- packer
class Grid:
    """Voxel occupancy (5 mm) of a zone; obstacles and placed parts are boxes."""

    def __init__(self, lo, hi, res=0.005):
        self.lo, self.res = np.array(lo, float), res
        self.n = np.ceil((np.array(hi) - self.lo) / res - 1e-6).astype(int)
        self.occ = np.zeros(self.n, bool)

    def idx(self, lo, hi):
        a = np.floor((np.array(lo) - self.lo) / self.res + 1e-3).astype(int)
        b = np.ceil((np.array(hi) - self.lo) / self.res - 1e-3).astype(int)
        return np.clip(a, 0, self.n), np.clip(b, 0, self.n)

    def block(self, lo, hi):
        a, b = self.idx(lo, hi)
        if (b > a).all():
            self.occ[a[0]:b[0], a[1]:b[1], a[2]:b[2]] = True

    def block_points(self, pts):
        k = np.floor((pts - self.lo) / self.res).astype(int)
        m = ((k >= 0) & (k < self.n)).all(1)
        k = k[m]
        self.occ[k[:, 0], k[:, 1], k[:, 2]] = True

    def free(self, lo, hi):
        lo, hi = np.array(lo), np.array(hi)
        if (lo < self.lo - 1e-9).any() or (hi > self.lo + self.n * self.res + 1e-9).any():
            return False
        a, b = self.idx(lo, hi)
        return not self.occ[a[0]:b[0], a[1]:b[1], a[2]:b[2]].any()


def surface_points(v, f, step=0.002):
    """Points on the triangles of a mesh, at most `step` apart (voxelizes sheet-metal parts as shells)."""
    tri = v[f]
    out = [tri.reshape(-1, 3)]
    e = np.maximum(np.linalg.norm(tri[:, 1] - tri[:, 0], axis=1), np.linalg.norm(tri[:, 2] - tri[:, 0], axis=1))
    for n in sorted(set(np.ceil(e / step).astype(int).clip(1, 200))):
        sel = tri[np.ceil(e / step).astype(int).clip(1, 200) == n]
        if n <= 1:
            continue
        a, b = np.meshgrid(np.arange(n + 1), np.arange(n + 1))
        m = (a + b) <= n
        a, b = a[m] / n, b[m] / n
        p = sel[:, None, 0] + a[None, :, None] * (sel[:, None, 1] - sel[:, None, 0]) + b[None, :, None] * (sel[:, None, 2] - sel[:, None, 0])
        out.append(p.reshape(-1, 3))
    return np.vstack(out)


zone_of = {}
TOP_ACCESS = {"rz_fba", "rz_fbb", "rz_f0", "rz_fchg", "rz_pre"}
# compact MIDI fuse holder, one fuse per holder (GI-080 option 4, proposed): catalogue class outline, verify against the chosen order code
MIDI_HOLDER = {"dims": [62, 33, 30], "mass": 0.05, "part": "compact single MIDI fuse holder (order code open)", "geom": "catalogue outline, verify"}   # fuses: top access with the cover off (A1 service access)


def pack(items, zones, obstacles, ceiling=None, shells=()):
    """Greedy placement on the zone floor: largest first, domain order fore-aft, 10 mm air gap around converters,
    3 mm elsewhere. Returns {id: (centre, size)} and the ids that do not fit."""
    placed, nofit = {}, []
    zone_of.clear()
    grids = {}
    for zn, z in zones.items():
        g = Grid([z["x"][0], z["y"][0], z["z"][0]], [z["x"][1], z["y"][1], z["z"][1]])
        for lo, hi in obstacles:
            g.block(lo, hi)
        for pts in shells:
            g.block_points(pts)
        import rear_layout
        cf = rear_layout.ceiling if zn.startswith("rear") else (ceiling if zn == "front_bay" else None)
        if cf:
            for ix in range(g.n[0]):
                x = g.lo[0] + (ix + .5) * g.res
                c = cf(x)
                kz = int(max(0, math.floor((c - g.lo[2]) / g.res)))
                g.occ[ix, :, kz:] = True
        grids[zn] = g
    order = sorted(items, key=lambda it: -np.prod(it["dims"]))
    order = order + [dict(it, zone=fz, _fallback=True) for it in order for fz in it.get("fallback", [])]
    for it in order:
        if it.get("_fallback"):
            keys = [it["id"]] if int(it.get("qty", 1)) == 1 else ["%s_%d" % (it["id"], i + 1) for i in range(int(it.get("qty", 1)))]
            if not any(k in nofit for k in keys):
                continue
        g = grids[it["zone"]]
        z = zones[it["zone"]]
        gap = (0.010 if it.get("converter") else it.get("gap", 0.003))
        dims = np.array(it["dims"]) * MM
        perms = sorted(set(itertools.permutations(dims)), key=lambda p: (abs(p[2] - dims[2]) > 1e-9, -p[0]))
        fore = {"BAT": 0, "SAFE": 0, "R24": 1, "LV": 1, "SIG": 2}.get(it["domain"], 1)
        xs = np.arange(z["x"][0], z["x"][1], g.res)
        if it["zone"] == "front_bay" and fore == 2:
            xs = xs[::-1]  # signal parts toward the front, power entry toward the rear zone
        ys = np.arange(z["y"][0], z["y"][1], g.res)
        ys = sorted(ys, key=lambda y: -abs(y))  # outboard first
        best = None
        for qty_i in range(int(it.get("qty", 1))):
            best = None
            for p in perms:
                p = np.array(p)
                zs = [z["z"][0]] if (it["zone"] == "front_bay" or z.get("floor_only")) else list(np.arange(z["z"][0], z["z"][1], 0.01))
                for x, zz in ((a, b) for b in zs for a in xs):
                    for y in ys:
                        lo = np.array([x, y, zz])
                        hi = lo + p
                        zlo = np.array([z["x"][0], z["y"][0], z["z"][0]])
                        zhi = np.array([z["x"][1], z["y"][1], z["z"][1]])
                        if (hi > zhi + 1e-6).any():
                            continue
                        gz = 0 if zz <= z["z"][0] + 1e-9 else gap
                        if g.free(np.maximum(lo - [gap, gap, gz], zlo), np.minimum(hi + [gap, gap, gap], zhi)):
                            # service access (A1): nothing above a fuse block or fuse holder, and a fuse part never goes under another part
                            over = lambda a, b: (a[0][0] < b[1][0] and b[0][0] < a[1][0] and a[0][1] < b[1][1] and b[0][1] < a[1][1])
                            blocked = False
                            for k2, (c2, p2) in placed.items():
                                if zone_of.get(k2) != it["zone"]:
                                    continue
                                b2 = (c2 - p2 / 2, c2 + p2 / 2)
                                if over((lo, hi), b2) and ((k2.rsplit("_", 1)[0] in TOP_ACCESS or k2 in TOP_ACCESS) and lo[2] >= b2[1][2] - 1e-6
                                                         or (it["id"] in TOP_ACCESS) and hi[2] <= b2[0][2] + 1e-6):
                                    blocked = True
                                    break
                            if blocked:
                                continue
                            best = (lo + p / 2, p)
                            break
                    if best:
                        break
                if best:
                    break
            key = it["id"] if int(it.get("qty", 1)) == 1 else "%s_%d" % (it["id"], qty_i + 1)
            if it.get("_fallback") and key not in nofit:
                continue
            if best:
                c, p = best
                g.block(c - p / 2, c + p / 2)
                placed[key] = best
                zone_of[key] = it["zone"]
                if key in nofit:
                    nofit.remove(key)
            elif key not in nofit:
                nofit.append(key)
    return placed, nofit


# ---------------------------------------------------------------- geometry helpers
def box(s, p, c, o=None, r=None, hq=False, name=None):
    d = {"t": "box", "s": [R(v) for v in s], "p": [R(v) for v in p], "c": c}
    if o is not None:
        d["o"] = o
    if r is not None:
        d["r"] = [R(v) for v in r]
    if hq:
        d["hq"] = 1
    if name:
        d["n"] = name
    return d


def cyl(r, h, p, ax, c, o=None, hq=False):
    d = {"t": "cyl", "r": R(r, 5), "h": R(h, 5), "p": [R(v) for v in p], "ax": ax, "c": c}
    if o is not None:
        d["o"] = o
    if hq:
        d["hq"] = 1
    return d


def tube(pts, r, c):
    return {"t": "tube", "pts": [[R(v) for v in q] for q in pts], "r": R(r, 5), "c": c}


def plen(pts):
    return float(sum(np.linalg.norm(np.subtract(pts[i + 1], pts[i])) for i in range(len(pts) - 1)))


# ---------------------------------------------------------------- harness graph (base_footprint, bp000, L1000)
def harness_graph(U):
    ax, top = U["col_axis_x"], U["col_top"]
    Z = 0.245
    ZF = 0.278   # front bay trunk: over the option A DIN carrier and shelf parts, under the cover (0.290)
    ZL = 0.205   # front sensor run: below the LiDAR scan plane band (0.217 to 0.227) in the open sector (C3)
    N = {
        # front bay trunk (above the bay parts, under the cover); it drops below the scan plane at x 0.300, behind the open sector
        "FL1": (0.150, 0.150, ZF), "FL2": (0.300, 0.150, ZF), "FR1": (0.150, -0.150, ZF), "FR2": (0.300, -0.150, ZF),
        "FL3": (0.300, 0.150, ZL), "FL4": (0.345, 0.150, ZL), "FR3": (0.300, -0.150, ZL), "FR4": (0.345, -0.150, ZL),
        "FC": (0.150, 0.0, ZF), "FCF": (0.255, 0.0, ZF), "FCL": (0.385, 0.0, ZL), "FCL_L": (0.385, 0.150, ZL), "FCL_R": (0.385, -0.150, ZL),
        # through the centre-bracket walls (grommets) and across the drive section, above the wheels
        "GCF_L": (0.118, 0.150, Z), "GCF_R": (0.118, -0.150, Z), "CL": (0.0, 0.125, Z), "CR": (0.0, -0.125, Z),
        "GCR_L": (-0.118, 0.125, Z), "GCR_R": (-0.118, -0.125, Z), "CC": (0.0, 0.0, 0.250),
        # rear section (A1): trunk over the series-link strip at the arch edge, then over the power plate (cells in the side pockets)
        "RL1": (-0.152, 0.100, 0.278), "RL2": (-0.152, 0.030, 0.278), "RL3": (-0.300, 0.050, 0.275),
        "RR1": (-0.152, -0.100, 0.278), "RR2": (-0.152, -0.030, 0.278), "RR3": (-0.300, -0.050, 0.275), "RB": (-0.310, 0.0, 0.275),
        # up through the deck behind the lift plate, beside the static column, service loop to the carriage
        "D0": (-0.128, -0.050, 0.250), "GD": (-0.128, -0.050, 0.296), "SL0": (ax - 0.135, -0.045, 0.330),
        "SL1": (ax - 0.135, -0.045, top - 0.040), "SLB": (ax - 0.150, -0.045, top - 0.280),
        "SL2": (ax - 0.115, -0.045, top - 0.020),
        # on the carriage (moving): under the adapter plate, up the arm post; MR: through the adapter plate to the second E-stop (A5)
        "M0": (ax - 0.100, -0.040, top - 0.006), "M1": (ax + 0.100, -0.040, top - 0.006),
        "MP": (ax + 0.120, 0.0, top + 0.020), "MJ_L": (ax + 0.150, 0.038, top + 0.166), "MJ_R": (ax + 0.150, -0.038, top + 0.166),
        "MT": (ax + 0.160, 0.0, top + 0.352), "MF": (ax + 0.250, 0.0, top + 0.120),
        "MR0": (ax - 0.040, 0.0, top + 0.016), "MR": (ax - 0.040, 0.0, top - 0.006),
        # static column: lift sensors on the +y face
        "CY_T": (ax - 0.132, -0.030, 0.80), "CY_B": (ax - 0.132, -0.030, 0.330),   # A6: down the rear face of the static column
    }
    group = {k: "base" for k in N}
    for k in ("SL0", "SL1", "SLB", "CY_T", "CY_B"):
        group[k] = "col"
    for k in ("SL2", "M0", "M1", "MP", "MJ_L", "MJ_R", "MT", "MF", "MR0", "MR"):
        group[k] = "mov"
    E = [("FL1", "FL2"), ("FR1", "FR2"), ("FL1", "FC"), ("FR1", "FC"), ("FC", "FCF"), ("FL2", "FL3"), ("FL3", "FL4"), ("FR2", "FR3"), ("FR3", "FR4"),
         ("FL4", "FCL_L"), ("FR4", "FCL_R"), ("FCL_L", "FCL"), ("FCL_R", "FCL"), ("FCF", "FL2"), ("FCF", "FR2"),
         ("FL1", "GCF_L"), ("FR1", "GCF_R"), ("GCF_L", "CL"), ("GCF_R", "CR"), ("CL", "CC"), ("CR", "CC"),
         ("CL", "GCR_L"), ("CR", "GCR_R"), ("GCR_L", "RL1"), ("GCR_R", "RR1"), ("RL1", "RL2"), ("RL2", "RL3"),
         ("RR1", "RR2"), ("RR2", "RR3"), ("RL3", "RB"), ("RR3", "RB"), ("CC", "D0"), ("CR", "D0"), ("D0", "GD"),
         ("GD", "SL0"), ("SL0", "SL1"), ("SL1", "SLB"), ("SLB", "SL2"), ("SL2", "M0"), ("M0", "M1"), ("M1", "MP"),
         ("MP", "MJ_L"), ("MP", "MJ_R"), ("MP", "MT"), ("MP", "MF"), ("M0", "MR"), ("MR", "MR0"), ("GD", "CY_B"),
         ("CY_B", "CY_T")]
    return N, group, E


def route(N, E, a, b):
    import heapq
    adj = {}
    for u, v in E:
        w = float(np.linalg.norm(np.subtract(N[u], N[v])))
        adj.setdefault(u, []).append((v, w))
        adj.setdefault(v, []).append((u, w))
    dist, prev, q = {a: 0}, {}, [(0, a)]
    while q:
        d, u = heapq.heappop(q)
        if u == b:
            break
        for v, w in adj.get(u, []):
            if d + w < dist.get(v, 1e9):
                dist[v], prev[v] = d + w, u
                heapq.heappush(q, (d + w, v))
    path, u = [b], b
    while u != a:
        u = prev[u]
        path.append(u)
    return path[::-1]


def write_lift_json(LR):
    """Write M.LIFT_SENSE in model.js from frames.lift_rear_layout() (A6): the pages and the checker read it."""
    f = FACTS["lift_rear"]
    js_path = os.path.join(MODEL, "model.js")
    js = open(js_path, encoding="utf-8").read()
    L = {"face": "rear", "z": f["sensor_z"], "stops": ["L1000", "L1175", "L1350"], "sensor": f["sensor"], "rear_x": f["column_rear_x"],
         "axis_x": LR["sensor_axis_x"], "face_y": LR["face_y"], "gap": f["gap"], "flag": f["flag"], "flag_x": LR["flag_x"], "flag_y": LR["flag_y"],
         "flag_below_plate": f["flag_below_plate"], "rod": f["rod"], "rod_x": LR["rod_x"], "rod_y": LR["rod_y"], "corner_x": LR["corner_x"],
         "rod_clear": f["rod_clear"], "bracket": {"leg": f["bracket"]["leg"], "t": f["bracket"]["t"], "at": f["bracket"]["axis_from_face"]},
         "bracket_h": f["bracket"]["h"], "plate_rear_x": LR["plate_rear_x"]}
    new = "/*LIFT-JSON*/%s/*LIFT-JSON-END*/" % json.dumps(L)
    js2 = re.sub(r"/\*LIFT-JSON\*/.*?/\*LIFT-JSON-END\*/", lambda m: new, js, flags=re.S)
    if js2 != js:
        open(js_path, "w", encoding="utf-8").write(js2)


# ---------------------------------------------------------------- main build
def main():
    rev, D = datums()
    SF = sensor_frames()
    G = glb_nodes()
    T = load_yaml(os.path.join(HERE, "parts.yaml"))
    for it in T["fixed"]:
        if it["id"] == "lift_node":   # A6: below the L1000 sensor on the rear face of the static column
            it["pos"] = [it["pos"][0], it["pos"][1], FACTS["lift_rear"]["lift_node_z"]]
    TZL = tzbot_layout()
    LR = lift_rear_layout()   # A6: lift stop sensors and flag rod at the rear of the column
    write_lift_json(LR)   # receiver box from facts.yaml (WCM-500-24 manual V2.5, B4 position); the parts table follows it
    for it in T["fixed"]:
        if it["id"] == "tz_receiver":
            it["dims"] = [round(v * 1000, 1) for v in TZL["size"]]
            it["pos"] = [R(v) for v in TZL["centre"]]
    BM = load_yaml(os.path.join(HERE, "bom_map.yaml"))
    BOM = bom_parts()
    U = upper_body(D, rev)
    di_path = os.path.join(MODEL, "design_intent", "index.json")
    DI = json.load(open(di_path)) if os.path.exists(di_path) else []
    if isinstance(DI, dict):
        DI = DI.get("items", list(DI.values()))

    box_of = {k: aabb(v["v"]) for k, v in G.items()}
    comps, geo, exploded, fasteners, cables, issues_seed = [], {}, {}, [], [], []

    def comp(cid, name, bom, qty, cls, purpose, geom_src, pos_src, mass, msrc, stage, parts, group="base", label=None, off=None, opn=None,
             hq=False, link=None, part_number=""):
        c = {"id": cid, "name": name, "qty": qty, "geometry": "envelope" if cls in ("provisional", "envelope", "placeholder") else "primitive",
             "bom": bom, "purpose": purpose, "source": geom_src, "class": cls, "position_source": pos_src, "mass_kg": R(mass, 3),
             "mass_source": msrc, "part_number": part_number,
             "link": link or "https://github.com/openAMRobot/openamr-upperbody-hw/blob/main/docs/mechanical/upper_body_option_B.md",
             "parts": list(parts)}
        if cls == "provisional":
            c["provisional_label"] = label or "Provisional position: no source gives it"
        if cls == "placeholder":
            c["placeholder"] = True
            c["label"] = label or "Placeholder"
        if cls == "proposed":
            c["proposed"] = True
            c["label"] = label or "Proposed by the roadmap model (not a decision)"
        if hq:
            c["hq"] = True
        comps.append(c)
        exploded[cid] = {"stage": stage, "offsets": {p: (off or [0, 0, .2]) for p in parts}, "open": {p: (opn or [0, 0, .12]) for p in parts}}
        for p in parts:
            geo.setdefault(p, {"group": group, "prims": []})
        return c

    SW = "https://github.com/openAMRobot/openamr-platform-sw/blob/main/ros2/src/openamrobot_description/config/sensor_frames.yaml"
    HW = "https://github.com/openAMRobot/openamr-platform-hw/tree/main/mechanical/cad/production_files"

    # ---------------- obstacles (GLB AABBs) for the packer
    obst, shells = [], []
    for k, (lo, hi) in box_of.items():
        if k in ("base_plate", "cover", "cover_flange_front", "cover_flange_rear", "battery"):
            continue
        if G[k]["extras"].get("class") == "chassis" and k not in ("electronics_bracket", "lidar_support", "lidar_spacer", "driver_mount", "controller_plate"):
            shells.append(surface_points(G[k]["v"], G[k]["f"]))
            continue
        obst.append((lo - 0.003, hi + 0.003))
    lp = FACTS["lift_plate"]
    # lift base plate on the arch (B3): the same 4 arch bolts for bp000 and bp050 (the plate carries both column hole sets)
    arch_bolts = [(x, y) for x in lp["arch_bolts"]["x"] for y in lp["arch_bolts"]["y"]]
    bolts = {bp: arch_bolts for bp in lp["col_axis_x"]}
    # rear section (owner correction A1): cells and pocket trays, the receiver 20 mm metal-free margin and the series link strip
    import rear_layout
    RL = rear_layout.layout()
    for t_ in RL["trays"]:
        obst.append((np.array(t_["lo"]) - 0.003, np.array(t_["hi"]) + 0.003))
    obst.append((np.array(RL["margin"][0]), np.array(RL["margin"][1])))
    obst.append((np.array([-0.152, -0.155, 0.274]), np.array([-0.140, 0.155, 0.290])))   # series link strip over the tray fronts (rear_power.py)
    # A9: two removable trays joined by the keyed main connector PWR-018, the disconnect point of the 8S link over the centre
    cl0 = [c_ for c_ in RL["cells"] if c_["side"] == "left"]
    import rear_power as _rp
    bc_c = np.array(_rp.SERIES_LINK["connector"]["c"]) * MM
    bc_s = np.array(_rp.SERIES_LINK["connector"]["s"]) * MM
    obst.append((bc_c - bc_s / 2 - 0.003, bc_c + bc_s / 2 + 0.003))
    # fixed parts of the parts table and the design-intent battery tray are obstacles too
    for it in T["fixed"]:
        if it.get("group", "base") != "base" or "dims" not in it or it["id"] in ("tz_receiver", "fan"):
            continue
        for rp in it.get("repeat", [[0, 0, 0]]):
            c0 = np.add(it["pos"], rp)
            h = np.array(it["dims"]) * MM / 2
            obst.append((c0 - h - .003, c0 + h + .003))
    tray = []
    # front-bay ceiling: cover underside, then the front flange slope
    def ceiling(x):
        return FACTS["cover_underside"] if x < 0.315 else FACTS["cover_underside"] - (x - 0.315) * (0.0628 / 0.0706)

    pz = RL["plate"]
    zones = {"rear_plate": {"x": [pz[0][0], pz[1][0]], "y": [pz[0][1], pz[1][1]], "z": [pz[1][2], FACTS["cover_underside"]]}}
    for s_, nm_ in ((1, "rear_corner_l"), (-1, "rear_corner_r")):   # pocket rear corners behind the cell trays, inside the rear supports
        y_ = sorted([s_ * (RL["margin"][1][1] + 0.002), s_ * 0.1658])
        zones[nm_] = {"x": [-0.366, RL["trays"][0]["lo"][0] - 0.004], "y": y_, "z": [0.057, 0.264]}
    for k in ("compute", "base_controller"):   # moved to the front bay (option A); the old places are free
        obst[:] = [o for o in obst if not (np.allclose(o[0], box_of[k][0] - 0.003) and np.allclose(o[1], box_of[k][1] + 0.003))]
    obst.append((np.array([0.005, -0.035, 0.054]), np.array([0.075, 0.035, 0.294])))     # IMU column: nothing heavy or vibrating above the IMU
    # rear power module (GI-080, GI-126, GI-129, GI-130): explicit layout of the rear power owner's report rev 2 with the
    # measured adaptations (rear_power.py); the packer is no longer used for the rear zone. Owner decision 3 Nov 2026:
    # parts above the receiver from 15 mm above its top up to the cover; non-metal within 20 mm of the receiver.
    import rear_power
    RP = rear_power.layout()
    items = [dict(it, gap=0.005) for it in T["packed"] if it["zone"] != "front_bay" and it["id"] != "rz_batcon"]
    placed, nofit = {}, []
    zone_of.clear()
    for k_, p_ in RP["parts"].items():
        if k_ in ("rear_plate", "rz_disc"):
            continue
        lo_, hi_ = np.array(p_["lo"]), np.array(p_["hi"])
        placed[k_] = ((lo_ + hi_) / 2, hi_ - lo_)
        zone_of[k_] = "rear_" + p_["level"]
    want = [it["id"] if int(it.get("qty", 1)) == 1 else "%s_%d" % (it["id"], i + 1) for it in items for i in range(int(it.get("qty", 1)))]
    nofit = [k_ for k_ in want if k_ not in placed]
    zo = dict(zone_of)
    fit_obst = {t_["side"] + "_tray": (t_["lo"], t_["hi"]) for t_ in RL["trays"]}
    for k_ in ("support_rear_left", "support_rear_right", "ultrasonic_mount_rear_left", "ultrasonic_mount_rear_right", "tof_mount_rear", "hub_motor_wheel_right", "rear_panel"):
        if k_ in box_of:
            fit_obst[k_] = box_of[k_]
    sc_ = rear_power.SERIES_LINK["connector"]
    fit_obst["rz_batcon"] = (np.array(sc_["c"]) * MM - np.array(sc_["s"]) * MM / 2, np.array(sc_["c"]) * MM + np.array(sc_["s"]) * MM / 2)
    fit_obst.pop("rear_panel", None)
    rp_fit = rear_power.fit_check(fit_obst, RL["receiver"])
    gi80 = {"first_pass_nofit": [], "steps": [{"option": "manual", "what": "explicit rear power module layout (rear_power.py): owner report rev 2 with %d measured adaptations" % len(RP["adaptations"]),
                                               "placed": sorted(placed), "nofit": nofit, "clashes": rp_fit["clashes"]}],
            "fbb_front": False, "midi": False, "manual": True, "fit": rp_fit, "main_path": rear_power.main_path(),
            "adaptations": [{"part": a_[0], "owner_report": a_[1], "model": a_[2], "reason": a_[3]} for a_ in RP["adaptations"]],
            "levels": {"receiver_top_mm": round(RL["receiver"][1][2] * 1000, 1), "plate_underside_mm": round(RL["plate"][0][2] * 1000, 1),
                       "gap_mm": round((RL["plate"][0][2] - RL["receiver"][1][2]) * 1000, 1), "main_line_mm": 202, "fbb_shelf_mm": [231, 234],
                       "fba_shelf_mm": [205, 208], "cover_flat_mm": round(FACTS["cover_underside"] * 1000, 1)}}
    gi80["final_nofit"] = list(nofit)
    print("GI-080 (manual layout):", "no fit", nofit, "clashes", rp_fit["clashes"])
    # front bay: one layout (A2); the receiver is at the rear (A1)
    fb_items = [dict(it) for it in T["packed"] if it["zone"] == "front_bay"] + [dict(v, id=k, zone="front_bay") for k, v in FB.CATALOGUE.items()]
    if gi80["fbb_front"]:   # GI-080 option 2 kept: FB-B in the front bay, top access to its fuses
        fb_items.append(dict([it for it in T["packed"] if it["id"] == "rz_fbb"][0], zone="front_bay", top_access=True, priority=0))
    fb_default = "single"   # owner correction A2 (2 Nov 2026): one layout, no options
    FBR = {fb_default: FB.layout([dict(i) for i in fb_items])}
    fb_fit = {k: FB.fit_numbers(v, fb_items) for k, v in FBR.items()}
    print("front bay:", {k: (v["placed"], v["not_placed"]) for k, v in fb_fit.items()})
    items = [dict(it, zone="front_bay") if (gi80["fbb_front"] and it["id"] == "rz_fbb") else (dict(gi80["midi_item"]) if (gi80["midi"] and it["id"] == "rz_fbb") else dict(it)) for it in T["packed"]]

    # ---------------- packed parts (rear zone) and the front bay of both options
    stage_of = {"front_bay": 4, "rear_manual": 3, "rear_plate": 3, "rear_corner_l": 3, "rear_corner_r": 3, "rear_l2": 3, "rear_panel_face": 3, "tray_wall": 3}
    ZONE_TXT = {"rear_L1": "rear power module level L1, on the G10 power plate 15 mm above the receiver (rear_power.py)",
                "rear_L3": "rear power module level L3, FB-B shelf above BUS+, K1 and K2, fuses up (rear_power.py)",
                "rear_rear": "rear power module, at the rear panel under the sloped cover (rear_power.py)",
                "rear_side": "right side gap between the right battery tray and the side wall (owner report rev 2, rear_power.py)",
                "rear_corner": "rear corner behind a battery tray, inside the rear supports (rear_power.py)",
                "rear_plate": "rear power-electronics plate above the prepared receiver zone (A1)", "rear_l2": "second level above the rear power plate (GI-080 option 1)",
                "rear_panel_face": "rear panel inner face above the receiver, outside its 20 mm metal-free margin (GI-080 option 3)",
                "tray_wall": "upright against the receiver-side wall of a battery tray, outside the 20 mm metal-free margin (GI-080 option 5)", "rear_corner_l": "left pocket rear corner behind the cells (A1)",
                "rear_corner_r": "right pocket rear corner behind the cells (A1)", "rear_behind": "rear zone behind the cells (B5)", "rear_side_l": "rear zone, left side pocket (B5, real section)",
                "rear_side_r": "rear zone, right side pocket (B5, real section)",
                "arch": "under the arch top above the hub motors (overflow proposal, not B5: the B5 rear zone is too small with the tray and the real pocket section)", "A_lower": "front bay, lower plate on the base sheet (power conversion and safety)",
                "A_upper": "front bay, upper shelf (second tier)", "A_din": "front bay, DIN carrier on the centre-bracket front wall", "bay": "front bay, single plate on the base sheet",
                "strip_l": "front bay, left strip beside the receiver (under the bay plate)", "strip_r": "front bay, right strip beside the receiver (under the bay plate)",
                "B_bay": "front bay option B, single tier above the receiver", "pocket_l": "option B, left rear side pocket", "pocket_r": "option B, right rear side pocket"}
    fb_relocate = {}
    item_by_id = {it["id"]: it for it in fb_items}
    item_by_id["bay_din_pnoz"] = dict(item_by_id["bay_din"], id="bay_din_pnoz", dims=[120.3, 22.5, 98.0])
    item_by_id["bay_din_tb"] = dict(item_by_id["bay_din"], id="bay_din_tb", dims=[31.2, 47.5, 42.5], standoff=None)

    def draw_box_part(k, it, cc, p, option=None):
        prims = geo.setdefault(k, {"group": "base", "prims": []})["prims"]
        if option:
            geo[k]["option"] = option
        prims.append(box(p, cc, BODY_COL[it["domain"]], name=it["id"]))
        prims.append(box([p[0] * .9, p[1] * .9, .0015], [cc[0], cc[1], cc[2] + p[2] / 2 + .00075], DOMAIN_COL[it["domain"]]))
        if it.get("standoff") and p[2] < 0.03:
            for sx in (-1, 1):
                for sy in (-1, 1):
                    prims.append(cyl(.0028, .006, [cc[0] + sx * (p[0] / 2 - .004), cc[1] + sy * (p[1] / 2 - .004), cc[2] - p[2] / 2 + .003], "z", "#b8b8b8", hq=True))

    for it in items:
        q = int(it.get("qty", 1))
        keys = [it["id"]] if q == 1 else ["%s_%d" % (it["id"], i + 1) for i in range(q)]
        bomrow = BOM.get(it["bom"], {})
        pn = it.get("part", bomrow.get("Model / order code", ""))
        for opt in (fb_default,):
            suffix = ""
            if it["zone"] == "front_bay":
                P = FBR[opt]["placed"]
                sub = {"bay_din": ["bay_din_pnoz", "bay_din_tb"]}.get(it["id"], keys)
                got = [k for k in sub if k in P]
                where = {k: (P[k][0], P[k][1], P[k][2]) for k in got}
            else:
                got = [k for k in keys if k in placed]
                where = {k: (zone_of.get(k, it["zone"]), placed[k][0], placed[k][1]) for k in got}
            if not got:
                continue
            zn = where[got[0]][0]
            parts_ = [k + suffix for k in got]
            label = None if not suffix else "Front bay option %s (alternative, hidden by default; switch on the exploded view)" % opt
            c = comp(it["id"] + suffix, it["name"] + ("" if not suffix else " (option %s)" % opt), it["bom"], len(got) if it["id"] != "bay_din" else 1, "proposed",
                     "%s. %s" % (it["name"], "Placed by scripts/roadmap_model/%s with %s air gap." % ("front_bay.py" if it["zone"] == "front_bay" else "build.py", "10 mm" if it.get("converter") else ("5 mm" if it["zone"] != "front_bay" else "3 mm"))),
                     "%s: %s" % (it.get("geom", "proposed size"), "x".join("%g" % d for d in it["dims"]) + " mm"),
                     "proposed in the %s (%s domain)" % (ZONE_TXT.get(zn, zn), it["domain"]),
                     (it.get("mass", 0) * (len(got) if it["id"] != "bay_din" else 1)) if not suffix else 0,
                     "estimate" if "proposed" in it.get("geom", "proposed") else "estimate from the catalogue class",
                     stage_of[it["zone"]], parts_, part_number=pn, label=label,
                     off=[0, 0, .32] if it["zone"] == "front_bay" else [-.25, 0, .3], opn=[0, 0, .16] if it["zone"] == "front_bay" else [-.12, 0, .14])
            for k in got:
                zn_k, cc, p = where[k]
                draw_box_part(k + suffix, item_by_id.get(k, it), cc, p, None)
                if not suffix and it["zone"] == "front_bay" and item_by_id.get(k, it).get("standoff") and p[2] < 0.03:
                    fasteners.append({"joint": "%s to the MEC-005 plate" % it["name"], "part": "%s hex standoff + ISO 7380 screw" % it["standoff"],
                                      "size": "%s x 6" % it["standoff"], "qty": 4, "standard": "DIN 7380 / hex standoff", "material": "A2 / brass",
                                      "class": "proposed", "drawn": "y"})
    # compute and NUCLEO: the base GLB nodes are moved by the option layout (model.js M.setFrontBay)
    for opt in (fb_default,):
        rel = {}
        for k in ("compute", "base_controller"):
            if k in FBR[opt]["placed"]:
                _, cc, p = FBR[opt]["placed"][k]
                lo, hi = box_of[k]
                d0 = hi - lo
                yaw = 0.0 if abs(p[0] - d0[0]) < abs(p[0] - d0[1]) else math.pi / 2
                rel[k] = {"p": [R(cc[0]), R(cc[1]), R(cc[2] - FACTS["base_link_z"])], "yaw": R(yaw, 5),
                          "zone": FBR[opt]["placed"][k][0]}
        fb_relocate[opt] = rel
    fb_glb_centre = {k: [R(v) for v in (box_of[k][0] + box_of[k][1]) / 2 - [0, 0, FACTS["base_link_z"]]] for k in ("compute", "base_controller")}
    # option plates (MEC-005 lower plate, shelf, DIN carrier; option B single plate)
    for opt in (fb_default,):
        suffix = ""
        pl = FBR[opt]["plates"]
        k = "bay_plate" + suffix
        geo[k] = {"group": "base", "prims": [box(np.subtract(q["hi"], q["lo"]), np.add(q["hi"], q["lo"]) / 2, "#b9c2c9" if "DIN" not in q["name"] else "#8e9aa3", name=q["name"]) for q in pl]}
        area = sum((q["hi"][0] - q["lo"][0]) * (q["hi"][1] - q["lo"][1]) * (q["hi"][2] - q["lo"][2]) for q in pl)
        c = comp(k, "Front bay plates: %s" % "; ".join(q["name"] for q in pl), "MEC-005", 1, "proposed",
                 "Front bay, one layout (owner correction A2, 2 Nov 2026): %s, plate on the base sheet (top z %.3f); %s." % (FBR[opt].get("layout", ""), FB.FLOOR, "lower plate, upper shelf on standoffs and DIN carrier on the centre-bracket front wall" if "two-tier" in FBR[opt].get("layout", "") else "single plate"),
                 "proposed outlines (3 mm 5052 sheet; DIN carrier 23 mm)", "front bay (front_bay.py)", area * 2680,
                 "outline x thickness x 2680 kg/m3", 4, [k], off=[0, 0, .28], opn=[0, 0, .14], part_number="MEC-005 (drawing revision TBD)",
                 label=None)
    # side zones (Phase 2b): side mounting plates on the base sheet, and the protected central channels over the drive section
    sp_ = FBR[fb_default].get("side_plates", [])
    if sp_:
        geo["side_plates"] = {"group": "base", "prims": [box(np.subtract(q["hi"], q["lo"]), np.add(q["hi"], q["lo"]) / 2, "#b9c2c9", name=q["name"]) for q in sp_]}
        comp("side_plates", "Front bay side mounting plates (left: power, right: signal)", "MEC-005", 2, "proposed",
             "; ".join(q["name"] for q in sp_) + ". Parts on the plates: %s." % ", ".join("%s (%s)" % (k_, v_) for k_, v_ in sorted(FBR[fb_default].get("side", {}).items())),
             "proposed outlines (3 mm 5052 sheet)", "front_bay.py side zones (3 Nov 2026)", 0.15, "outline x thickness x 2680 kg/m3", 4, ["side_plates"],
             off=[0, 0, .28], opn=[0, 0, .14], part_number="MEC-005 side plates (drawing TBD)")
    import harness as _hn
    chp = []
    for k_, bx_ in _hn.channel_prims().items():
        geo[k_] = {"group": "base", "prims": [box(np.subtract(h_, l_), np.add(h_, l_) / 2, "#8e9aa3", name=k_) for l_, h_ in bx_]}
        chp.append(k_)
    comp("ch_central", "Central cable channels over the drive section: CH-C1 power (left), CH-C2 signal (right), cross branches CH-B1 / CH-B2 to the side corridors", "MEC-013", len(chp), "proposed",
         "Two U-channels (3 mm floor, 2 mm walls, %d mm wide) hung from the arch top sheet at z %.3f to %.3f, x %.3f to %.3f: protected passages between the rear power module and the front bay over the motor driver; power and signal 80 mm apart; lids with clips (hidden in the channel views). Cross branches at x -0.060 to -0.020 through slots in the arch side walls lead over the wheels to the over-wheel guards (side corridors)." % (
             (_hn.CHANNELS[0]["y"][1] - _hn.CHANNELS[0]["y"][0]) * 1000, _hn.CH_FLOOR, _hn.CH_TOP, _hn.CH_X[0], _hn.CH_X[1]),
         "proposed outlines", "harness.py CHANNELS (3 Nov 2026)", 0.25, "estimate", 9, chp, off=[0, 0, .45], opn=[0, 0, .2], part_number="MEC-013 channels (drawing TBD)")
    geo_lookup = {}

    # ---------------- fixed parts
    for it in T["fixed"]:
        reps = it.get("repeat", [[0, 0, 0]])
        parts = [it["id"]] if len(reps) == 1 else ["%s_%d" % (it["id"], i + 1) for i in range(len(reps))]
        grp = it.get("group", "base")
        cls = it.get("cls", "proposed")
        bomrow = BOM.get(it.get("bom", ""), {})
        lab = None
        if cls == "provisional":
            lab = "Provisional: %s" % it["pos_src"]
        c = comp(it["id"], it["name"], it.get("bom", ""), len(parts), cls, it["name"] + ".",
                 "%s%s" % (it.get("geom", ""), (": " + "x".join("%g" % d for d in it["dims"]) + " mm") if "dims" in it else ""),
                 it["pos_src"], it.get("mass", 0) * (1 if it["id"] in ("tz_receiver", "rz_disc") else len(parts)), "estimate",
                 {"base": 3, "col": 7, "mov": 8}[grp] if it["id"] not in ("fan", "feedthru") else 4, parts, group=grp, label=lab,
                 part_number=it.get("part", bomrow.get("Model / order code", "")), hq=it["id"] in ("shims", "us_locknut"),
                 off=[0, 0, -.25] if it["id"] == "tz_receiver" else None)
        if it["id"] == "tz_receiver":
            c["class"] = "prepared, installed later"
            c["provisional_label"] = "Prepared in 2.0, installed later (wireless charging prepared; manual charging through SB50 at any time)"
        for k, rp in zip(parts, reps):
            p = np.add(it["pos"], rp)
            if grp in ("col", "mov"):
                p = p - [FACTS["lift_plate"]["col_axis_x"]["bp000"], 0, 0]
            col = "#9aa3ab" if it.get("domain") == "MECH" else BODY_COL.get(it.get("domain", "SIG"))
            o = .45 if cls == "provisional" else None
            if "cyl" in it:
                geo[k]["prims"].append(cyl(it["cyl"]["r"], it["cyl"]["h"], p, it["cyl"]["axis"], "#b0b4b8", hq=True))
            else:
                geo[k]["prims"].append(box(np.array(it["dims"]) * MM, p, col, o=o, hq=it["id"] == "shims"))
    # ---------------- flag rod guide (owner decision 3 Nov 2026): second support of the rod at the static column head (flag_guide.py)
    import flag_guide as FG
    import harness as _hn0
    FGL = FG.layout(_hn0.energy_chain(U, FACTS))
    if "flag_rod_guide" in geo:
        cols = {"ring": "#b8bec4", "liner": "#f2f2f2", "arm": "#c4ccd2", "foot": "#9aa3ab"}
        geo["flag_rod_guide"]["prims"] = [box(np.subtract(hi_, lo_), np.add(lo_, hi_) / 2, cols[k_.split("_")[0]], name=k_) for k_, (lo_, hi_) in FGL["boxes"].items()]
        LR["guide_boxes"] = FGL["boxes"]
        for nm_, part_, size_, q_ in FGL["fasteners"]:
            fasteners.append({"joint": "Flag rod guide: %s" % nm_, "part": part_, "size": size_, "qty": q_, "standard": part_.split(" ")[0] + " " + part_.split(" ")[1],
                              "material": "A2", "class": "proposed", "drawn": "n"})
    # ---------------- rear section, owner correction A1 (owner, 2 Nov 2026; to be entered in P-03 and M-01): TZBOT receiver zone prepared at the
    # rear panel (receiver installed later, wireless charging prepared in 2.0), 8 x LF105 in the two side pockets, power electronics above
    TZ = FACTS["tzbot_receiver"]
    mz = RL["margin"]
    geo["tz_metal_free_zone"] = {"group": "base", "prims": [box(np.subtract(mz[1], mz[0]), np.add(mz[0], mz[1]) / 2, "#e74c3c", o=.10, name="metal_free_zone")]}
    comp("tz_metal_free_zone", "TZBOT receiver 20 mm metal-free margin (ghost, at the rear panel)", "", 1, "proposed",
         "The receiver outline plus 20 mm on every side: no metal inside it (TZBOT WCM-500-24 manual V2.5). Prepared in 2.0; keep it free for the receiver installed later.", "receiver outline + 20 mm",
         "receiver at the rear panel on the centre line (owner, 2 Nov 2026)", 0, "no mass", 3, ["tz_metal_free_zone"], label="Keep-out ghost, not a part", off=[0, 0, -.25], opn=[0, 0, -.12])
    cz = RL["cutout"]
    geo["base_cutout"] = {"group": "base", "prims": [box([cz[1][0] - cz[0][0], cz[1][1] - cz[0][1], 0.0022], [(cz[0][0] + cz[1][0]) / 2, 0, 0.053], "#e67e22", o=.35, name="base_sheet_cutout")]}
    comp("base_cutout", "Base-sheet cut-out prepared for the receiver (at the rear panel)", "MEC-001", 1, "proposed",
         "Base sheet MMP.02.00.00.001 cut-out under the prepared receiver zone: receiver outline plus the 20 mm metal-free margin (%.0f x %.0f mm). Prepared in 2.0 for the receiver installed later." % ((cz[1][0] - cz[0][0]) * 1000, (cz[1][1] - cz[0][1]) * 1000),
         "proposed cut-out %.0f x %.0f mm" % ((cz[1][0] - cz[0][0]) * 1000, (cz[1][1] - cz[0][1]) * 1000), "receiver at the rear panel (owner, 2 Nov 2026)", 0, "material removed (not counted)", 1, ["base_cutout"],
         label="Cut-out, prepared", off=[0, 0, -.2], opn=[0, 0, -.1])
    # cells (PWR-001 / PWR-023) and the two pocket trays (MEC-007); the GLB battery node (single row across) is hidden by model.js
    cell_parts = []
    for side in ("left", "right"):
        k = "battery_cells_" + side
        cell_parts.append(k)
        geo[k] = {"group": "base", "prims": [box(np.subtract(c_["hi"], c_["lo"]), np.add(c_["lo"], c_["hi"]) / 2, "#4f7cac", name="LF105") for c_ in RL["cells"] if c_["side"] == side]}
        for c_ in RL["cells"]:
            if c_["side"] == side:
                geo[k]["prims"].append(box([.014, .014, .004], [c_["lo"][0] + .025, (c_["lo"][1] + c_["hi"][1]) / 2, c_["hi"][2] + .002], "#c0392b", name="terminal_pos"))
                geo[k]["prims"].append(box([.014, .014, .004], [c_["hi"][0] - .025, (c_["lo"][1] + c_["hi"][1]) / 2, c_["hi"][2] + .002], "#2c3e50", name="terminal_neg"))
    Cc = FACTS["cells"]
    comp("battery_cells", "Battery: 8 x EVE LF105 upright, 4 per side pocket (8S)", "PWR-001, PWR-023", 8, "provisional",
         "Eight EVE LF105 cells upright, four in each side pocket beside the prepared charger zone, in series (8S); replaces the single row across the robot (B-02 rev18.10).",
         "cell 200 h x 130 x 38 mm (B5); pocket arrangement %s chosen by rear_layout.py" % RL["pockets"].get("arrangement", ""),
         "A1 side pockets (owner, 2 Nov 2026)%s" % ("" if RL["pockets"].get("clears_flanges") else "; needs the side-panel return flanges notched along the pockets (GI-025)"),
         8 * Cc["mass"], "8 x 1.98 kg (cells only)", 3, cell_parts, label="Provisional: A1 side pockets, to be entered in P-03 and M-01", off=[0, 0, .3], opn=[0, 0, .14])
    tray_parts = []
    for t_ in RL["trays"]:
        k = "battery_tray_" + t_["side"]
        tray_parts.append(k)
        lo_, hi_ = np.array(t_["lo"]), np.array(t_["hi"])
        w_ = Cc["restraint_wall"]
        prims = [box([hi_[0] - lo_[0], hi_[1] - lo_[1], Cc["tray_floor"]], [(lo_[0] + hi_[0]) / 2, (lo_[1] + hi_[1]) / 2, lo_[2] + Cc["tray_floor"] / 2], "#8d9aa5", name="tray_floor")]
        for xx in (lo_[0] + w_ / 2, hi_[0] - w_ / 2):
            prims.append(box([w_, hi_[1] - lo_[1], 0.120], [xx, (lo_[1] + hi_[1]) / 2, lo_[2] + 0.060], "#8d9aa5", name="end_wall"))
        for yy in (lo_[1] + w_ / 2, hi_[1] - w_ / 2):
            prims.append(box([hi_[0] - lo_[0], w_, 0.120], [(lo_[0] + hi_[0]) / 2, yy, lo_[2] + 0.060], "#8d9aa5", name="side_wall"))
        prims.append(box([hi_[0] - lo_[0], 0.020, 0.004], [(lo_[0] + hi_[0]) / 2, (lo_[1] + hi_[1]) / 2, hi_[2] - 0.002], "#5d6d7e", name="restraint_strap"))
        geo[k] = {"group": "base", "prims": prims}
    comp("battery_tray", "Battery pocket trays MEC-007, left and right (design intent)", "MEC-007", 2, "provisional",
         "Two pocket trays (3 mm floor and walls, 120 mm restraint walls, top strap) for 4 cells each; terminals on top, reachable with the cover off.",
         "design_intent/battery_tray.step (two pocket trays, scripts/roadmap_model/design_intent/battery_tray.py)", "A1 side pockets", 1.6, "design-intent estimate", 3, tray_parts,
         label="Design intent, not CAD: owner fridayali", off=[0, 0, .25], opn=[0, 0, .12])
    # series link between the two trays (A9): proposed path of rear_power.py, over the tray front strips at z 0.280, tray ends at
    # the second cell (battery owner to confirm the string ends, B-02), disconnect point PWR-018 at the centre of the plate front
    SL = rear_power.SERIES_LINK
    xa, zl = SL["x"] * MM, SL["z"] * MM
    ya, yb = SL["ends_y"][0] * MM, SL["ends_y"][1] * MM
    zt = RL["cells"][0]["hi"][2] + 0.004
    geo["battery_series_link"] = {"group": "base", "prims": [tube([[xa, ya, zt], [xa, ya, zl], [xa, yb, zl], [xa, yb, zt]], 0.00525, "#c0392b")]}
    comp("battery_series_link", "Battery series link between the two trays (25 mm²), over the tray front strips, through the keyed connector PWR-018", "PWR-024", 1, "proposed",
         "Insulated 25 mm² tray leads from each tray to the keyed main connector PWR-018 at the centre, at z %.3f over the tray front strips and the F0 holder (A9); the trays come out after PWR-018 is unplugged. Tray ends at the second cell of each tray: battery owner to confirm (B-02)." % zl,
         "tube 10.5 mm", "A1, A9, rear_power.py", 0.1, "estimate", 3, ["battery_series_link"], off=[0, 0, .3], opn=[0, 0, .14])
    it_bc = [it for it in T["packed"] if it["id"] == "rz_batcon"][0]
    geo["rz_batcon"] = {"group": "base", "prims": [box(bc_s, bc_c, BODY_COL["BAT"], name="rz_batcon"), box([bc_s[0] * .9, bc_s[1] * .9, .0015], [bc_c[0], bc_c[1], bc_c[2] + bc_s[2] / 2 + .00075], DOMAIN_COL["BAT"])]}
    comp("rz_batcon", "Battery main mating connector (keyed, PWR-018): disconnect point of the 8S link between the two trays", "PWR-018", 1, "proposed",
         "Keyed, touch-protected DC connector on the series link at the centre: the two trays (4 + 4 LF105) come out separately after it is unplugged (A9, replaces the one removable battery assembly of B-02 rev18.10).",
         "%s: %s" % (it_bc.get("geom", "proposed size"), "x".join("%g" % d for d in it_bc["dims"]) + " mm"), "on the series link over the centre, z %.3f (A9)" % bc_c[2],
         it_bc.get("mass", 0.08), "estimate", 3, ["rz_batcon"], part_number=it_bc.get("part", ""), off=[0, 0, .3], opn=[0, 0, .14])
    # A9 assembly checks: cells in from above with the cover off, power plate out without the cells, a disconnect point on the 8S link
    trays_ = RL["trays"]
    plate_ = RL["plate"]
    ov = lambda a, b: all(min(a[1][i], b[1][i]) - max(a[0][i], b[0][i]) > 1e-6 for i in range(2))
    tray_check = {"trays": len(trays_), "connector": "PWR-018 keyed, on the 8S link at x %.3f, z %.3f" % (bc_c[0], bc_c[2]),
                  "plate_overlaps_trays_in_plan": any(ov((plate_[0], plate_[1]), (t_["lo"], t_["hi"])) for t_ in trays_),
                  "plate_tray_gap_mm": round(min(abs(t_["lo"][1]) - plate_[1][1] for t_ in trays_ if t_["lo"][1] > 0) * 1000, 1),
                  "cells_from_above": all(t_["hi"][2] < FACTS["cover_underside"] for t_ in trays_), "link_over_plate": True,
                  "nothing_on_cells": True}
    BM["PWR-001"] = {"by": "battery_cells", "cls": "provisional", "geo": "8 x LF105 200 x 130 x 38 mm (B5)", "pos": "A1 side pockets (owner, 2 Nov 2026)", "mass": 21.5, "msrc": "B5 assembly 20 to 23 kg provisional (midpoint)"}
    BM["PWR-023"] = {"by": "battery_cells", "cls": "provisional", "mqty": 8, "geo": "8 cell boxes", "pos": "A1 side pockets", "mass": 0.0, "msrc": "included in PWR-001"}
    BM["MEC-007"] = {"by": "battery_tray", "cls": "provisional", "mqty": 1}
    # MEC-006: power-electronics mounting plate above the receiver zone (A1)
    pl_ = RL["plate"]
    comp("rear_plate", "Rear power-electronics plate above the prepared receiver zone", "MEC-006", 1, "proposed",
         "3 mm G10 glass-epoxy plate (non-metal) over the charger zone, underside %.0f mm above the floor (15 mm above the receiver top, owner decision 3 Nov 2026): F0, BUS+, K1, K2 and the FB-B shelf posts; PA66 or PEEK fasteners within 20 mm of the receiver (TZBOT manual, verify)." % (pl_[0][2] * 1000),
         "proposed outline (3 mm G10 sheet, verify stiffness)", "rear power owner report rev 2 (rear_power.py)", (pl_[1][0] - pl_[0][0]) * (pl_[1][1] - pl_[0][1]) * 0.003 * 1850,
         "outline x 3 mm x 1850 kg/m3", 3, ["rear_plate"], off=[-.25, 0, .25], opn=[-.12, 0, .1], part_number="MEC-006 (drawing revision TBD)")
    geo["rear_plate"]["prims"].append(box(np.subtract(pl_[1], pl_[0]), np.add(pl_[0], pl_[1]) / 2, "#c8b88a", name="G10 plate"))
    # rear power module mounting parts (new, CAD changes): FB-B and FB-A shelves, BUS+ standoffs, BMS clamp strips, BUS- bracket, corner plate
    mparts = []
    for k_, m_ in RP["mounts"].items():
        lo_, hi_ = np.array(m_["lo"]), np.array(m_["hi"])
        geo[k_] = {"group": "base", "prims": [box(hi_ - lo_, (lo_ + hi_) / 2, "#e8e2c8" if ("POM" in m_["material"] or "G10" in m_["material"]) else "#a9b4bd", name=m_["name"])]}
        mparts.append(k_)
    comp("rear_mounts", "Rear power module mounting parts: FB-B shelf (L3), FB-A shelf, BUS+ standoffs, BMS clamp strips, BUS- bracket, corner plate", "MEC-006", len(mparts), "proposed",
         "; ".join("%s (%s)" % (m_["name"], m_["material"]) for m_ in RP["mounts"].values()), "proposed outlines (rear_power.py)",
         "rear power owner report rev 2 with the measured adaptations (rear_power.py)", 0.35, "estimate", 3, mparts, off=[-.25, 0, .25], opn=[-.12, 0, .1],
         part_number="MEC-006 sub-parts (drawing TBD)")

    # K1/K2 options (P16): the contactors stand on the plate under the FB-B shelf; height there 111 mm (plate top 120 to shelf 231)
    k1 = [k for k in placed if k.startswith("rz_k1k2")]
    h_free = 231 - 120
    opt = {"A": {"part": "Gigavac GX11CAC", "dims": [73, 45, 76], "fits": len(k1) == 2, "height_free_mm": h_free},
           "B_tesys": {"part": "Schneider TeSys D LC1D80BD", "dims": [85, 127, 186], "fits": False, "nofit": ["186 mm deep (mounted height) > %d mm under the FB-B shelf and > 170 mm to the cover" % h_free]},
           "B_siemens": {"part": "Siemens 3RT2 size S3", "dims": [70, 140, 152], "fits": False, "nofit": ["3RT2045: 152 mm deep > %d mm under the FB-B shelf" % h_free]}}

    # ---------------- design-intent parts (from the CAD fork index), drawn as envelopes of their placement
    di_comp = {}
    for d in DI:
        di_comp[d.get("item")] = d

    def di_mesh(item, variant, pl, colour, opacity=None, group="base"):
        import trimesh
        rec = di_comp[item]
        f = [x for x in rec["files"] if x["variant"] == variant][0]
        m = trimesh.load(os.path.join(MODEL, f["stl"] if f["stl"].startswith("design_intent") else "design_intent/" + f["stl"]))
        v = np.asarray(m.vertices) * MM
        rx, ry, rz = pl["rpy"]
        cx, sx, cy, sy, cz, sz = math.cos(rx), math.sin(rx), math.cos(ry), math.sin(ry), math.cos(rz), math.sin(rz)
        Rm = np.array([[cz, -sz, 0], [sz, cz, 0], [0, 0, 1]]) @ np.array([[cy, 0, sy], [0, 1, 0], [-sy, 0, cy]]) @ np.array([[1, 0, 0], [0, cx, -sx], [0, sx, cx]])
        v = v @ Rm.T + np.array(pl["xyz"])
        if group in ("col", "mov"):
            v = v - [FACTS["lift_plate"]["col_axis_x"]["bp000"], 0, 0]
        d = {"t": "mesh", "v": [R(x, 4) for x in v.reshape(-1)], "f": np.asarray(m.faces).reshape(-1).tolist(), "c": colour}
        if opacity is not None:
            d["o"] = opacity
        return d

    DI_DRAW = [  # item, variant, component id, name, bom, colour, group, stage, ghost
        ("motor_bracket", "motor_bracket", "motor_brackets", "Motor shaft-flat brackets MEC-015 (design intent)", "MEC-015", "#6d7780", "base", 2, False),
        ("rear_estop_housing", "rear_estop_housing", "rear_estop_housing", "Second E-stop housing on the adapter plate behind the post, button up (design intent)", "SAF-001", "#c9b037", "mov", 8, False),
        ("getac_pocket", "getac_pocket", "getac_pocket", "Getac ZX80 pocket, portrait (decided default), back plate and light-bar plate (design intent)", "UI-002, MEC-012", "#5d6d7e", "mov", 8, False),
    ]
    for item, variant, cid, name, bomid, colour, group, stage, ghost in DI_DRAW:
        if item not in di_comp:
            continue
        rec = di_comp[item]
        pls = rec["placement"] if isinstance(rec["placement"], list) else [rec["placement"]]
        if item == "rear_estop_housing":
            pls = [p_ for p_ in pls if p_.get("variant") == variant]
        if item == "getac_pocket":
            pls = pls[:1]
        parts = [cid] if len(pls) == 1 else ["%s_%d" % (cid, i + 1) for i in range(len(pls))]
        f0 = [x for x in rec["files"] if x["variant"] == variant][0]
        comp(cid, name, bomid, len(parts), "proposed" if ghost else "provisional",
             "%s. Method: %s, %s mm. Adjustment: %s." % (name, rec.get("method", ""), rec.get("thickness_mm", ""), rec.get("adjustment", "")),
             "design_intent/%s.step (scripts/roadmap_model/design_intent/%s.py)" % (variant, item),
             "%s (%s)" % (rec.get("configuration", ""), rec.get("placement_note", "")[:160]),
             (f0.get("mass_kg") or rec.get("mass_kg") or 0) * (0 if ghost else len(parts)), "design-intent volume x density", stage, parts, group=group,
             label=("Ghost, not fitted" if ghost else "Design intent, not CAD: owner fridayali"),
             off=[0, 0, .25] if group == "base" else [0, 0, .1], opn=[0, 0, .12] if group == "base" else [0, 0, 0],
             link="https://github.com/openAMRobot/openamr-upperbody-hw/blob/main/docs/mechanical/upper_body_option_B.md")
        for k, pl in zip(parts, pls):
            geo[k]["prims"].append(di_mesh(item, variant, pl, colour, .14 if ghost else None, group))
        if ghost:
            comps[-1]["hq"] = False
    # lift base plate MEC-019 on the arch (B3): drawn from the design-intent STL in the base group (the plate stays when bp changes)
    if "lift_base_plate" in di_comp:
        geo["lift_base_plate"] = {"group": "base", "prims": [di_mesh("lift_base_plate", "lift_base_plate", di_comp["lift_base_plate"]["placement"][0], "#c4ccd2")]}
    # the getac pocket replaces the placeholder mount envelope of parts.yaml
    if "getac_pocket" in di_comp:
        comps[:] = [c for c in comps if c["id"] != "tablet_mount"]
        exploded.pop("tablet_mount", None)
        geo.pop("tablet_mount", None)
        BM["UI-002"] = {"by": "getac_pocket"}
        BM["MEC-012"] = {"by": "getac_pocket"}
    BM["MEC-015"] = {"by": "motor_brackets", "cls": "provisional", "mass": 4 * 0.279, "msrc": "design-intent volume x 7850"}

    # ---------------- CAN terminations (CTL-009, CTL-010)
    # ---------------- harness
    N, NG, E = harness_graph(U)
    fbd = FBR[fb_default]["placed"]

    def top_of(k):
        if k in fbd:
            _, cc, p = fbd[k]
            return [cc[0], cc[1], cc[2] + p[2] / 2]
        if k in placed:
            cc, p = placed[k]
            return [cc[0], cc[1], cc[2] + p[2] / 2]
        if k in box_of:
            lo, hi = box_of[k]
            return [(lo[0] + hi[0]) / 2, (lo[1] + hi[1]) / 2, hi[2]]
        raise KeyError(k)

    def fixed_pos(k):
        for it in T["fixed"]:
            if it["id"] == k:
                return list(it["pos"])
        raise KeyError(k)

    ax = U["col_axis_x"]
    TERM = {
        "battery+": RP["studs"]["pack+"], "battery-": RP["studs"]["pack-"],
        "motor_l": [0.0, 0.090, 0.150], "motor_r": [0.0, -0.090, 0.150],
        # ZLAC8015D (Phase 3): motor ports on the +x face toward the electronics bracket, power input and CAN1 on the top under the
        # drop-outs of the central channels (power on the -y side, CAN on the +y side; connector positions to verify on the ZLAC drawing)
        "zlac": [R(box_of["motor_driver"][1][0]), 0.030, 0.150], "zlac_m2": [R(box_of["motor_driver"][1][0]), -0.030, 0.150], "zlac_pwr": [R(top_of("motor_driver")[0]), 0.060, R(box_of["motor_driver"][1][2])],
        "zlac_can": [R(top_of("motor_driver")[0]), -0.060, R(box_of["motor_driver"][1][2])], "imu": top_of("imu"), "nucleo": top_of("base_controller"), "jetson": top_of("compute"),
        "lidar": [0.300, 0.0, 0.200], "gemini": [0.372, 0.0, 0.160], "estop": [0.345, 0.130, 0.145], "reset": [0.340, -0.130, 0.145],
        "us_fl": [0.355, 0.130, 0.0914], "us_fr": [0.355, -0.130, 0.0914], "us_rl": [-0.355, 0.130, 0.0914], "us_rr": [-0.355, -0.130, 0.0914],
        "tof_f": [0.385, 0.0, 0.107], "tof_r": [-0.374, 0.0, 0.092],
        "disc": fixed_pos("rz_disc"), "sb50": fixed_pos("rz_sb50"), "rx": [FACTS["tzbot_receiver"]["hi"][0] - 0.015, 0.0, FACTS["tzbot_receiver"]["hi"][2] - 0.005],  # cable exit, receiver rear top
        "lift_node": fixed_pos("lift_node"), "lift_motor": [ax - 0.060, 0.0, 0.345],
        "estop2": [ax - 0.025, 0.0, U["col_top"] + 0.016],
        # arm base connectors on the outer side of each arm base (positions to verify on the OpenArm base): reached from the riser
        # behind the post along y, then forward
        "arm_l": [U["shoulder"][0] - 0.03, 0.075, U["shoulder"][2]], "arm_r": [U["shoulder"][0] - 0.03, -0.075, U["shoulder"][2]],
        "zed": [U["head_lens"][0] - 0.03, 0.0, U["head_lens"][2] - 0.025],
        "getac": [U["prof_front"] + 0.002, 0.075, U["getac"][2] - U["getac_size"][2] / 2 + 0.01],
        "light": [U["prof_front"] + 0.002, 0.075, U["head_light"][2]],
        "lsens1": [ax + LR["sensor_axis_x"], LR["sensor_y"][0], U["lift_sensor_z"][0]], "lsens2": [ax + LR["sensor_axis_x"], LR["sensor_y"][0], U["lift_sensor_z"][1]],
        "lsens3": [ax + LR["sensor_axis_x"], LR["sensor_y"][0], U["lift_sensor_z"][2]],   # A6: cable at the sensor back end (-y)
    }
    for k in list(placed) + list(fbd):
        TERM[k] = top_of(k)
    if "bay_din_pnoz" in fbd:
        TERM["bay_din"] = top_of("bay_din_pnoz")
    ID_OF_TERM = {"battery+": "battery_cells_left", "battery-": "battery_cells_right", "motor_l": "hub_motor_wheel_left", "motor_r": "hub_motor_wheel_right",
                  "zlac": "motor_driver", "zlac_m2": "motor_driver", "zlac_pwr": "motor_driver", "zlac_can": "motor_driver", "imu": "imu", "nucleo": "base_controller", "jetson": "compute", "lidar": "lidar",
                  "gemini": "base_camera", "estop": "estop", "reset": "reset_button", "us_fl": "ultrasonic_front_left",
                  "us_fr": "ultrasonic_front_right", "us_rl": "ultrasonic_rear_left", "us_rr": "ultrasonic_rear_right",
                  "tof_f": "tof_front", "tof_r": "tof_rear", "disc": "rz_disc", "sb50": "rz_sb50", "rx": "tz_receiver",
                  "lift_node": "lift_node", "lift_motor": "lift_column", "estop2": "second_estop", "arm_l": "openarm_left",
                  "arm_r": "openarm_right", "zed": "head_camera", "getac": "getac_tablet", "light": "head_light",
                  "lsens1": "lift_stop_sensors", "lsens2": "lift_stop_sensors", "lsens3": "lift_stop_sensors"}
    near = lambda p: min(N, key=lambda k: np.linalg.norm(np.subtract(N[k], p)) + (0.5 if NG[k] != "base" and p[2] < 0.3 else 0))
    # cable table: id, from, to, function, domain, gauge/type, OD mm, connector A, connector B, pin/terminal, BOM
    CAB = [
        ("CBL-P01", "battery+", "rz_f0", "Battery + to F0 110 A Class T", "BAT", "25 mm²", 10.5, "M8 lug", "M8 lug (5007100 stud)", "pack + terminal", "WIR-001"),
        ("CBL-P02", "rz_f0", "disc", "F0 to lockable disconnect BS-6004B", "BAT", "25 mm²", 10.5, "M8 lug", "M10 lug", "", "WIR-001"),
        ("CBL-P03", "disc", "rz_pwr017_1", "Disconnect QS1 S2 to BAT + bus BUS+ (PWR-017): busbar BB-01", "BAT", "busbar Cu 25 x 4 mm (verify)", 8.0, "M10 stud, bolted", "M8 stud, bolted", "BAT +", "WIR-001"),
        ("CBL-P04", "rz_pwr017_1", "rz_k1k2_1", "BAT + bus to K1 (SAFE path): busbar BB-02", "SAFE", "busbar Cu 25 x 4 mm (verify)", 8.0, "M8 stud, bolted", "M8 stud, bolted", "K1 A1", "WIR-001"),
        ("CBL-P05", "rz_k1k2_1", "rz_k1k2_2", "K1 to K2 in series: busbar BB-03, studs facing each other", "SAFE", "busbar Cu 25 x 4 mm (verify)", 8.0, "M8 stud, bolted", "M8 stud, bolted", "", "WIR-001"),
        ("CBL-P06", "rz_k1k2_2", "rz_fbb", "K2 to SAFE bus FB-B: formed busbar BB-04", "SAFE", "busbar Cu 25 x 4 mm (verify)", 8.0, "M8 stud, bolted", "M8 stud, bolted", "SAFE +", "WIR-001"),
        ("CBL-P07", "rz_fbb", "zlac_pwr", "F-TRAC 40 A to ZLAC8015D", "SAFE", "10 mm²", 7.5, "M6 lug", "ZLAC power terminal", "F-TRAC", "WIR-001"),
        ("CBL-P08", "zlac", "motor_l", "ZLAC axis 1 to left hub motor (phases + encoder)", "SAFE", "motor OEM lead", 9.0, "ZLAC motor port", "motor lead", "axis 1", "DRV-001"),
        ("CBL-P09", "zlac_m2", "motor_r", "ZLAC axis 2 to right hub motor (phases + encoder)", "SAFE", "motor OEM lead", 9.0, "ZLAC motor port", "motor lead", "axis 2", "DRV-001"),
        ("CBL-P10", "bay_ddr240", "motor_l", "SAFE 24 V brake release, left (24 V 12.5 W)", "SAFE", "0.75 mm²", 5.0, "DIN terminal", "brake lead", "", "DRV-003"),
        ("CBL-P11", "bay_ddr240", "motor_r", "SAFE 24 V brake release, right", "SAFE", "0.75 mm²", 5.0, "DIN terminal", "brake lead", "", "DRV-003"),
        ("CBL-P12", "rz_fbb", "bay_ddr240", "F-LIFT 15 A to DDR-240B-24 input", "SAFE", "2.5 mm² (E-01; 1.5 in the conflict list)", 4.5, "ring lug", "DIN terminal", "F-LIFT", "WIR-001"),
        ("CBL-P13", "bay_ddr240", "lift_motor", "SAFE 24 V to the DOLD lift via CTL-017 motor stage", "SAFE", "16 AWG Mini-Fit Jr HCS", 6.0, "DIN terminal", "Molex Mini-Fit Jr HCS", "", "CTL-016"),
        ("CBL-P14", "rz_fbb", "arm_l", "F-ARM-L 30 A to the left arm", "SAFE", "6 mm²", 6.5, "ring lug", "arm power connector", "F-ARM-L", "WIR-001"),
        ("CBL-P15", "rz_fbb", "arm_r", "F-ARM-R 30 A to the right arm", "SAFE", "6 mm²", 6.5, "ring lug", "arm power connector", "F-ARM-R", "WIR-001"),
        ("CBL-P16", "rz_fba", "bay_pwr009", "F-J401 10 A to the compute branch protection", "BAT", "2.5 mm²", 4.5, "ring lug", "screw terminal", "F-J401", "WIR-001"),
        ("CBL-P17", "bay_pwr029", "jetson", "Protected 19 to 54 V to the J401", "BAT", "2.5 mm²", 4.5, "screw terminal", "J401 DC input", "", "WIR-001"),
        ("CBL-P18", "rz_fba", "bay_rsd60", "F-5V 5 A to RSD-60G-5 input", "BAT", "1.5 mm²", 3.8, "ring lug", "screw terminal", "F-5V", "WIR-001"),
        ("CBL-P19", "bay_rsd60", "nucleo", "5 V to NUCLEO, RPLIDAR, TF-Luna, IMU (distribution)", "LV", "0.5 mm²", 2.5, "screw terminal", "JST / Dupont", "NUCLEO 5V_EXT", "SNS-003"),
        ("CBL-P20", "rz_fba", "bay_rsd100", "F-24V 7.5 A to RSD-100B-24 input", "BAT", "1.5 mm²", 3.8, "ring lug", "screw terminal", "F-24V", "WIR-001"),
        ("CBL-P21", "bay_rsd100", "bay_fbc", "Regulated 24 V to FB-C", "R24", "1.5 mm²", 3.8, "screw terminal", "FB-C bus stud", "", "WIR-001"),
        ("CBL-P22", "bay_fbc", "bay_usbpd", "F-PANEL 3 A to the USB-PD module", "R24", "0.75 mm²", 3.0, "blade fuse circuit", "screw terminal", "F-PANEL", "WIR-001"),
        ("CBL-P23", "bay_usbpd", "getac", "USB-C PD to the Getac ZX80", "R24", "USB-C PD cable 5 A", 4.5, "USB-C", "USB-C", "", "UI-002"),
        ("CBL-P24", "bay_fbc", "light", "F-PANEL 24 V to the head light, low-side switched by CTL-017", "R24", "SICK DOL-0804-G02MRN", 5.0, "M8 4-pin", "M8 4-pin", "AUX-002", "AUX-003"),
        ("CBL-P25", "bay_fbc", "fan", "F-FAN 2 A to the chassis fan", "R24", "0.5 mm²", 2.5, "blade fuse circuit", "fan lead", "F-FAN", "WIR-001"),
        ("CBL-P26", "bay_fbc", "bay_usbhub", "F-HUB 3 A to the USB hub", "R24", "0.75 mm²", 3.0, "blade fuse circuit", "hub DC jack", "F-HUB", "WIR-001"),
        ("CBL-P27", "rz_fba", "rz_fchg", "BAT bus to F-CHG 30 A MIDI", "BAT", "6 mm²", 6.5, "ring lug", "MIDI stud", "", "WCH-006"),
        ("CBL-P28", "rz_fchg", "rz_kchg", "F-CHG to KCHG relay: busbar BB-07", "BAT", "busbar Cu 12 x 2 mm (verify)", 6.0, "MIDI stud, bolted", "relay stud, bolted", "", "WCH-006"),
        ("CBL-P29", "rz_kchg", "sb50", "KCHG to SB50 (manual Daly charger)", "BAT", "6 mm² class 6 flexible", 6.5, "ring lug", "Anderson SB50", "", "WCH-006"),
        ("CBL-P30", "rz_kchg", "rx", "KCHG to the TZBOT receiver output", "BAT", "6 mm²", 6.5, "ring lug", "receiver output", "", "WCH-006"),
        ("CBL-P31", "rx", "nucleo", "TZBOT start and fault lines", "SIG", "2 x 0.34 mm²", 4.0, "receiver signal", "NUCLEO GPIO", "GPIO to be assigned", "WCH-005"),
        ("CBL-P32", "estop", "bay_din", "Base E-stop 2NC loop into the PNOZ", "SIG", "4 x 0.75 mm²", 5.5, "ZBE-102 screw", "PNOZ S11/S12, S21/S22", "S11-S12, S21-S22", "SNS-003"),
        ("CBL-P33", "estop2", "bay_din", "Second E-stop 2NC loop down the column into the PNOZ (series)", "SIG", "4 x 0.75 mm²", 5.5, "ZBE-102 screw", "PNOZ S11/S12, S21/S22", "series with base E-stop", "SNS-003"),
        ("CBL-P34", "reset", "bay_din", "RESET NO to PNOZ reset, NC to the controller", "SIG", "4 x 0.5 mm²", 5.0, "XB4 screw", "PNOZ S34 / ISO1212", "S33-S34; NC to CTL-004", "SNS-003"),
        ("CBL-P35", "bay_din", "rz_k1k2_1", "PNOZ 13-14 to the K1 coil, 23-24 to the K2 coil, EDM loop", "SIG", "4 x 0.75 mm²", 5.5, "PNOZ terminal", "GX11 coil leads", "13-14 K1, 23-24 K2, Y1-Y2 EDM", "SNS-003"),
        ("CBL-P36", "bay_din", "bay_iso1212", "PNOZ Y32 to the isolated input", "SIG", "2 x 0.5 mm²", 4.0, "PNOZ Y32", "ISO1212 IN", "Y32", "CTL-004"),
        ("CBL-P37", "nucleo", "zlac_can", "CAN1 FDCAN1 to the ZLAC8015D (500 kbit/s provisional)", "SIG", "2 x 2 x 0.34 mm² STP", 6.0, "SN65HVD230 screw", "ZLAC CAN port", "FDCAN1 via CTL-003", "WIR-002"),
        ("CBL-P38", "bay_can2", "rz_bms", "CAN2 FDCAN2 (PB12 RX, PB6 TX) to the Daly BMS through the isolator, 250 kbit/s", "SIG", "2 x 2 x 0.34 mm² STP", 6.0, "Click screw", "BMS CAN connector", "FDCAN2 PB12/PB6", "CTL-011"),
        ("CBL-P39", "bay_can3", "lift_node", "CAN3 FDCAN3 to the lift node CTL-017", "SIG", "2 x 2 x 0.34 mm² STP", 6.0, "screw", "CTL-017 CAN", "FDCAN3", "CTL-016"),
        ("CBL-P40", "nucleo", "imu", "SPI4 to EV_ICM-42688-P (PE12 SCK, PE13 MISO, PE14 MOSI, PE11 CS; INT1 GPIO TBD; 5 V VIN)", "SIG", "8-way 0.14 mm² ribbon", 3.0, "NUCLEO ST zio CN", "board CN1", "CN1 16 SCLK, 18 SDI, 20 SDO, 4 CS, 3 INT1, 11/13 GND, 19 VIN", "CTL-012"),
        ("CBL-P41", "bay_pwr032", "us_fl", "3.3 V + serial to MB7060 front left", "SIG", "4 x 0.25 mm²", 4.0, "JST", "MB7060 pads", "UART RX", "SNS-003"),
        ("CBL-P42", "bay_pwr032", "us_fr", "3.3 V + serial to MB7060 front right", "SIG", "4 x 0.25 mm²", 4.0, "JST", "MB7060 pads", "UART RX", "SNS-003"),
        ("CBL-P43", "bay_pwr032", "us_rl", "3.3 V + serial to MB7060 rear left", "SIG", "4 x 0.25 mm²", 4.0, "JST", "MB7060 pads", "UART RX", "SNS-003"),
        ("CBL-P44", "bay_pwr032", "us_rr", "3.3 V + serial to MB7060 rear right", "SIG", "4 x 0.25 mm²", 4.0, "JST", "MB7060 pads", "UART RX", "SNS-003"),
        ("CBL-P45", "nucleo", "tof_f", "UART + 5 V to TF-Luna front (pin 5 to 3.3 V)", "SIG", "6 x 0.25 mm²", 4.0, "JST", "TF-Luna 6-pin", "UART", "SNS-003"),
        ("CBL-P46", "nucleo", "tof_r", "UART + 5 V to TF-Luna rear (pin 5 to 3.3 V)", "SIG", "6 x 0.25 mm²", 4.0, "JST", "TF-Luna 6-pin", "UART", "SNS-003"),
        ("CBL-P47", "bay_lidar_uart", "lidar", "USB-UART and 5 V to the RPLIDAR S3", "SIG", "S3 cable + adapter", 4.5, "USB-A", "S3 connector", "", "NAV-003"),
        ("CBL-P48", "bay_usbhub", "gemini", "USB 3 to the Gemini 336L", "SIG", "USB 3 cable", 5.0, "USB-A", "USB-C", "", "CAM-002"),
        ("CBL-P49", "bay_usbhub", "zed", "USB 3 Type-C to the ZED Mini (via the service loop)", "SIG", "ZED USB-C cable", 5.0, "USB-A", "USB-C", "", "ARM-009"),
        ("CBL-P50", "bay_usbcan_1", "arm_l", "USB-CAN-FD left arm", "SIG", "CAN-FD 2 x 2 x 0.25 STP", 5.0, "adapter", "arm CAN", "", "ARM-006"),
        ("CBL-P51", "bay_usbcan_2", "arm_r", "USB-CAN-FD right arm", "SIG", "CAN-FD 2 x 2 x 0.25 STP", 5.0, "adapter", "arm CAN", "", "ARM-006"),
        ("CBL-P52", "bay_usbhub", "arm_l", "Wrist camera left (to the gripper)", "SIG", "matched gripper-camera harness", 4.0, "USB-A", "gripper camera", "", "ARM-010"),
        ("CBL-P53", "bay_usbhub", "arm_r", "Wrist camera right (to the gripper)", "SIG", "matched gripper-camera harness", 4.0, "USB-A", "gripper camera", "", "ARM-010"),
        ("CBL-P54", "lsens1", "lift_node", "Lift stop sensor L1000 (always-on 24 V)", "SIG", "SICK DOL-1204-G02M", 5.0, "M12 4-pin", "CTL-017 input", "", "LFT-002"),
        ("CBL-P55", "lsens2", "lift_node", "Lift stop sensor L1175", "SIG", "SICK DOL-1204-G02M", 5.0, "M12 4-pin", "CTL-017 input", "", "LFT-002"),
        ("CBL-P56", "lsens3", "lift_node", "Lift stop sensor L1350", "SIG", "SICK DOL-1204-G02M", 5.0, "M12 4-pin", "CTL-017 input", "", "LFT-002"),
        ("CBL-P57", "jetson", "nucleo", "USB host to MCU", "SIG", "USB data cable", 4.0, "USB-A", "NUCLEO USB", "", "CTL-008"),
        ("CBL-P58", "jetson", "bay_usbhub", "J401 USB 3 to the hub", "SIG", "USB 3 cable", 5.0, "USB-A", "USB-B", "", "CMP-009"),
        ("CBL-P59", "rz_bms", "rz_pwr017_2", "Daly P- (switched battery -) to the BAT - bus BUS-: flexible busbar BB-05; all returns here, no chassis return", "BAT", "busbar flexible laminated Cu 25 x 3 mm (verify)", 8.0, "BMS P- lead, crimped", "M8 stud, bolted", "BAT -", "WIR-001"),
        ("CBL-P60", "rz_bms", "battery+", "BMS sense harness and NTCs", "BAT", "BMS sense harness", 6.0, "BMS connector", "cell taps", "", "PWR-025"),
        ("CBL-P61", "bay_din", "rz_pre", "Precharge relay Kpre drive", "SIG", "2 x 0.5 mm²", 4.0, "terminal", "Kpre coil", "TPL7407L channel", "SAF-004"),
        ("CBL-P62", "rz_bms", "battery-", "Daly B- to pack - (tray lead): flexible busbar BB-06, disconnect DP-TRAY-R", "BAT", "busbar flexible laminated Cu 25 x 3 mm (verify)", 8.0, "BMS B- lead, crimped", "M8 lug (pack - terminal)", "B-", "WIR-001"),
    ]
    if gi80["midi"]:   # GI-080 option 4: one MIDI holder per SAFE branch; K2 feeds holder 1, a bus bar links the four holders
        mfuse = {"F-TRAC": "rz_fbb_1", "F-ARM-L": "rz_fbb_2", "F-ARM-R": "rz_fbb_3", "F-LIFT": "rz_fbb_4"}
        CAB = [(c[0], c[1] if c[1] != "rz_fbb" else mfuse.get(c[8], "rz_fbb_1"), c[2] if c[2] != "rz_fbb" else "rz_fbb_1") + tuple(c[3:]) for c in CAB]
        CAB = [c if c[0] != "CBL-P06" else c[:3] + ("K2 to the SAFE bus MIDI holders (bus bar to the other three)",) + c[4:] for c in CAB]
    # ---------------- harness: named harnesses on supported routes, tie points, lift energy chain (harness.py)
    import harness as HN
    if "fan" in geo:   # chassis fan under the cover: lead at its underside
        fb_ = [HN.prim_box(p_) for p_ in geo["fan"]["prims"]]
        flo, fhi = np.min([b_[0] for b_ in fb_], 0), np.max([b_[1] for b_ in fb_], 0)
        TERM["fan"] = [0.090, 0.060, 0.235]   # DP-FAN: the fan stays on the cover; its lead plugs in at the front end of CH-C1 (the tier lifts out under it)
        ID_OF_TERM["fan"] = "fan"
    hctx = {"G": {k: {"v": np.array(v["v"]), "f": np.array(v["f"])} for k, v in G.items()}, "geo": geo, "fbd": fbd, "TERM": TERM,
            "ID_OF_TERM": ID_OF_TERM, "CAB": CAB, "U": U, "LR": LR, "RL": RL, "fb_default": fb_default, "hide": ["battery"],
            "FIXED": dict({k_: {"pts": v_, "kind": "cable", "zone": RP["exception"]["id"]} for k_, v_ in RP["fixed_cables"].items()},
                          **{k_: {"pts": v_["pts"], "kind": "busbar", "zone": RP["exception"]["id"], "name": v_["name"], "section": v_["section"]} for k_, v_ in RP["busbars"].items()}),
            "EXCEPTION": RP["exception"]}
    if os.environ.get("OAMR_DUMP_HCTX"):   # debugging aid: the routing inputs for harness experiments
        import pickle
        pickle.dump(hctx, open(os.environ["OAMR_DUMP_HCTX"], "wb"))
    hcache = HN.load_cache(os.path.join(MODEL, "harness_routes.json"), hctx, FACTS)   # routes reused when the routing inputs are unchanged
    HR = HN.run(hctx, FACTS, cache=hcache)
    BEND25, cab_rows, unattached = {}, [], []
    tubes = {d: {"base": [], "col": [], "mov": []} for d in DOMAIN_COL}
    axo = np.array([FACTS["lift_plate"]["col_axis_x"]["bp000"], 0, 0])
    mass_pm = {"25 mm²": 0.26, "10 mm²": 0.11, "6 mm²": 0.07, "2.5 mm²": 0.035, "1.5 mm²": 0.022}
    HNAME = {h["id"]: h["name"] for h in HN.HARNESSES}
    for cid, a, b, fn, dom, gauge, od, ca, cb, pin, bomref in CAB:
        m = HR["meta"][cid]
        secs = m["sections"]
        L = sum(plen(s["pts"]) for s in secs if s["kind"] != "chain") + (HR["chain"]["length"] + 0.10 if any(s["kind"] == "chain" for s in secs) else 0)
        routed = bool(secs) and m["status"] == "routed"
        if not routed:
            unattached.append(cid)
        rmins = [HN.route_radius(s["pts"])[0] for s in secs if s["kind"] != "chain"]
        route_txt = m["status"] if not routed else " > ".join(
            HN.zones_of(next(s["pts"] for s in secs if s["kind"] == "base"), (HR["withdraw"][1]["lo"], HR["withdraw"][1]["hi"])) if any(s["kind"] == "base" for s in secs) else []) 
        if routed:
            up = [s["kind"] for s in secs if s["kind"] != "base"]
            names = {"sleeve": "DP-LIFT > fixed sleeve (column -y face)", "chain": "energy chain", "moving": "moving trunk and post riser", "column": "static column"}
            route_txt = " > ".join([t for t in [route_txt] if t] + [names[k] for k in up])
        nties = sum(1 for t in HR["ties"] if cid in t["cables"])
        bpts_ = [p_ for s_ in secs if s_["kind"] == "base" for p_ in HN.sample(s_["pts"], 0.01)] if routed else []
        in_pas = sorted({q_["id"].split(" ")[0] if q_["id"].startswith("CH") else q_["id"] for _, p_ in bpts_ for q_ in HN.PASSAGES
                         if all(q_["lo"][i] <= p_[i] <= q_["hi"][i] for i in range(3))})
        if gauge.startswith("busbar"):
            prot_, att_ = "insulated copper busbar (heat shrink or silicone sleeve), stud covers on both ends", "bolted on the stud terminals; insulated standoff or clip at most every 150 mm"
        elif gauge == "25 mm²":
            prot_, att_ = "flexible 25 mm² with lug boots; touch-protected terminals", "lugs on the studs; %d tie points" % nties
        else:
            prot_ = "; ".join([x_ for x_ in ["braided sleeve and chain-rated cable in the energy chain" if m.get("lift") else "",
                                             "in channel %s (lid)" % "/".join(x_ for x_ in in_pas if x_.startswith("CH")) if any(x_.startswith("CH") for x_ in in_pas) else "",
                                             "on the over-wheel guard" if any("guard" in x_ for x_ in in_pas) else "",
                                             "edge trim or grommet at every penetration"] if x_])
            att_ = "%d tie points (tie bases, clips, strain relief at the connectors)" % nties
        if not routed:
            prot_, att_ = "", ""
        row = {"id": cid, "from": a, "to": b, "function": fn, "domain": dom, "gauge_or_type": gauge, "od_mm": od, "connector_a": ca, "connector_b": cb,
               "pin_or_terminal": pin, "bom": bomref, "harness": m["harness"], "harness_name": HNAME[m["harness"]], "route": route_txt,
               "route_length_m": R(L, 3) if routed else "", "length_with_margin_m": R(L * 1.1, 3) if routed else "",
               "min_bend_radius_mm": m["rmin"], "route_min_radius_mm": (R(min(rmins) * 1000, 0) if rmins and min(rmins) < 1e3 else "straight") if routed else "",
               "flex_min_radius_mm": m["flex"] if m.get("lift") else "", "label_a": m["label_a"], "label_b": m["label_b"], "disconnect": m["disconnect"],
               "tie_points": nties if routed else 0, "protection": prot_, "attachment": att_, "mass_kg": R(L * 1.1 * mass_pm.get(gauge, 0.03), 3) if routed else 0,
               "from_part": ID_OF_TERM.get(a, a.rsplit("_", 1)[0] if a.endswith(("_1", "_2")) else a),
               "to_part": ID_OF_TERM.get(b, b.rsplit("_", 1)[0] if b.endswith(("_1", "_2")) else b),
               "from_xyz": [R(v) for v in secs[0]["pts"][0]] if routed else "", "to_xyz": [R(v) for v in secs[-1]["pts"][-1]] if routed else ""}
        cab_rows.append(row)
        if gauge == "25 mm²" and routed:
            r0 = min(rmins)
            BEND25[cid] = {"route_m": R(L, 3), "direct_m": R(float(np.linalg.norm(np.subtract(TERM[a], TERM[b]))), 3), "local": True,
                           "bend_ok": bool(r0 >= 0.060 - 5e-4), "worst_corner": {"deg": 90, "need_mm": 60.0, "have_mm": R(r0 * 1000, 1)}}
        for s in secs:
            if s["kind"] in ("chain", "sleeve"):
                continue   # drawn as the energy chain (model.js) and as one sleeve
            g = s["group"]
            bar = gauge.startswith("busbar")
            pts = s["pts"] if bar else HN.fillet(s["pts"], m["rmin"] / 1000)
            off = axo if g in ("col", "mov") else np.zeros(3)
            tubes[dom][g].append({"cid": cid, "pts": [list(np.subtract(p, off)) for p in pts], "r": od / 2000, "bar": bar})
    for dom, gg in tubes.items():
        if dom == "MECH":
            continue
        parts = []
        for g, tl in gg.items():
            if not tl:
                continue
            k = "harness_%s_%s" % (dom.lower(), g)
            parts.append(k)
            prims_ = []
            for t in tl:
                if t.get("bar"):   # flat busbar: one box per straight segment, 25 mm wide, 4 mm thick (thin in y on risers in the side gap)
                    for p0, p1 in zip(t["pts"][:-1], t["pts"][1:]):
                        d_ = np.abs(np.subtract(p1, p0))
                        ax_ = int(np.argmax(d_))
                        sz_ = [0.025, 0.025, 0.004] if ax_ != 2 else [0.025, 0.004, 0.025]
                        sz_[ax_] = float(d_[ax_]) + 0.004
                        if ax_ == 0:
                            sz_[1] = 0.025
                        prims_.append(dict(box(sz_, np.add(p0, p1) / 2, DOMAIN_COL[dom], name="busbar"), cid=t["cid"]))
                else:
                    prims_.append(dict(tube(t["pts"], t["r"], DOMAIN_COL[dom]), cid=t["cid"]))
            geo[k] = {"group": g, "prims": prims_}
        if not parts:
            continue
        rows = [c for c in cab_rows if c["domain"] == dom]
        comp("harness_" + dom.lower(), "Harness: " + T["harness_domains"][dom]["label"], ", ".join(sorted({c["bom"] for c in rows})), len(rows), "proposed",
             "%d cables of the %s domain on their routes, in harnesses %s (cable_list.csv)." % (len(rows), dom, ", ".join(sorted({c["harness"] for c in rows}))),
             "tubes at the cable outer diameter on the routed path, bends at the class minimum radius",
             "routed by harness.py: supported routes along the floor, the side panels and the uprights (bp000, L1000)",
             sum(c["mass_kg"] for c in rows), "route length x 1.1 x mass per metre", 9, parts, off=[0, 0, .45], opn=[0, 0, .2])
        for k in parts:
            exploded["harness_" + dom.lower()]["offsets"][k] = [0, 0, .45]
    # tie points, grommets, guards, DP-LIFT, sleeve and chain brackets
    fit = {"base": [], "col": [], "mov": []}
    for t in HR["ties"]:
        g = t.get("group", "base")
        off = axo if g in ("col", "mov") else np.zeros(3)
        p = np.subtract(t["p"], off)
        fit[g].append(box([.008, .008, .008] if t["kind"] == "clip" else [.012, .012, .006], p, "#2b2b2b", hq=True, name=t["id"]))
        if t["kind"] in ("tie base on standoff", "tie base on a bracket") and t.get("base"):
            b_ = np.subtract(t["base"], off)
            mid, ln = (p + b_) / 2, float(np.linalg.norm(p - b_))
            axis = "xyz"[int(np.argmax(np.abs(p - b_)))]
            if ln > .004:
                fit[g].append(cyl(.003, ln, mid, axis, "#9a9a9a", hq=True))
    for gr in HR["grommets"]:
        gp = gr["p"]
        grp = "mov" if "adapter plate" in gr["on"] else "base"
        off = axo if grp == "mov" else np.zeros(3)
        fit[grp].append(cyl(.008, .004, np.subtract(gp, off), "z", "#1a1a1a", hq=True))
    fparts = []
    for g, pr in fit.items():
        if pr:
            k = "harness_fittings_" + g
            fparts.append(k)
            geo[k] = {"group": g, "prims": pr}
    comp("harness_fittings", "Harness fittings: tie bases, clips and grommets", "MEC-013", len(HR["ties"]) + len(HR["grommets"]), "proposed",
         "%d tie points (tie bases on the floor, the side panels, the arch and the brackets, clips on the column, the plate angle and the post) "
         "at 150 mm or less and within 50 mm of every connector and branch; %d grommets or split entries at the panel penetrations." % (len(HR["ties"]), len(HR["grommets"])),
         "small primitives", "harness.py tie points", R(0.004 * len(HR["ties"]) + 0.003 * len(HR["grommets"]), 3), "estimate", 9, fparts, hq=True, off=[0, 0, .45], opn=[0, 0, .2])
    gparts = []
    for gd in HR["guards"]:
        k = gd["id"]
        geo[k] = {"group": "base", "prims": [box(np.subtract(gd["plate"][1], gd["plate"][0]), np.add(gd["plate"][0], gd["plate"][1]) / 2, "#9aa3ab"),
                                            box(np.subtract(gd["lip"][1], gd["lip"][0]), np.add(gd["lip"][0], gd["lip"][1]) / 2, "#9aa3ab")]}
        gparts.append(k)
    comp("wheel_guards", "Over-wheel cable guards (side trunks across the drive section)", "MEC-013", len(gparts), "proposed",
         "2 mm aluminium tray on each side-panel inner face, 8 mm above the tyre top: the side trunks cross the drive section on it, clear of the wheel.",
         "primitive", "harness.py, above the drive wheels", 0.12, "estimate 2 mm aluminium", 9, gparts, off=[0, 0, .45], opn=[0, 0, .2])
    dpb = HR["dp"]["box"]
    geo["dp_lift"] = {"group": "col", "prims": [box(np.subtract(dpb[1], dpb[0]), np.add(dpb[0], dpb[1]) / 2 - axo, "#5d6d7e", name="DP-LIFT"),
                                                box([.020, .004, .016], np.array([-0.082, -0.0485, 0.345]) - axo, "#2c3e50"),
                                                box([.016, .004, .014], np.array([-0.0725, -0.0485, 0.355]) - axo + [0, 0, .02], "#2c3e50")]}
    comp("dp_lift", "Disconnect point DP-LIFT (bulkhead connector plate behind the lift base plate)", "MEC-013", 1, "proposed",
         "All lift and upper-body cables plug in here: the lift assembly comes off without opening the base harness.", "primitive",
         "harness.py, above the deck exit behind the lift base plate", 0.15, "estimate", 8, ["dp_lift"], group="col", off=[0, -.2, .1], opn=[0, 0, 0])
    geo["harness_sleeve"] = {"group": "col", "prims": [tube([np.subtract(p, axo) for p in HR["sleeve"]], HR["upper"]["sleeve_r_bundle"], "#34495e")]}
    comp("harness_sleeve", "Fixed upper-body sleeve on the static column (-y face)", "MEC-013", 1, "proposed",
         "Braided sleeve over the upper-body cables from DP-LIFT up the -y face of the static column into the energy-chain fixed end (180 degree turn, R %.0f mm)." % (HR["upper"]["sleeve_r"] * 1000),
         "tube", "harness.py", 0.08, "estimate", 8, ["harness_sleeve"], group="col", off=[0, -.2, .1], opn=[0, 0, 0])
    chn = HR["chain"]
    geo["lift_energy_chain"] = {"group": "col", "prims": [box([chn["outer_w"] + .01, .006, .04], [chn["x"] - axo[0], chn["y_fixed"] - .022, chn["fixed_z"] - .01], "#5d6d7e", name="fixed_end_bracket")]}
    geo["lift_energy_chain_moving"] = {"group": "mov", "prims": [
        box([chn["outer_w"] + .01, .006, .04], [chn["x"] - axo[0], chn["y_moving"] + .022, chn["moving_z0"] + .01], "#5d6d7e", name="moving_end_bracket"),
        box([HR["upper"]["x_riser"] - chn["x"] + .02, .025, .003], [(HR["upper"]["x_riser"] + chn["x"]) / 2 - axo[0], chn["y_moving"], HR["upper"]["z_trunk"] - .0125], "#9aa3ab", name="hung_angle"),
        box([HR["upper"]["x_riser"] - chn["x"] + .02, .003, .028], [(HR["upper"]["x_riser"] + chn["x"]) / 2 - axo[0], chn["y_moving"] - .0125, HR["upper"]["z_trunk"] + .001], "#9aa3ab")]}
    comp("lift_energy_chain", "Lift energy chain (vertical U, inner 38 x 25 mm, R 75 mm)", "MEC-013", 1, "proposed",
         "%s; %d links, %.3f m; fixed end on the -y face of the static column at z %.3f, moving end under the adapter-plate rear extension; drawn for the current lift height." % (
             chn["type"], chn["links"], chn["length"], chn["fixed_z"]),
         "links drawn by model.js from placement.json energy_chain", "harness.py energy_chain()", 0.45, "estimate", 8,
         ["lift_energy_chain", "lift_energy_chain_moving"], group="col", off=[0, -.2, .1], opn=[0, 0, 0])
    issues_seed.append({"energy_chain": {k: chn[k] for k in ("length", "R", "stroke")}, "chain_clash": sorted({c for s in chn["stops"] for c in s["clash"]}),
                        "harness_blocked": sorted(c for c in unattached if HR["meta"][c]["status"].startswith("blocked"))})
    fittings = [("tie", t["id"]) for t in HR["ties"]] + [("grommet", g["id"]) for g in HR["grommets"]]

    # ---------------- CAN terminations
    tparts = []
    for i, (cidr, end) in enumerate([("CAN1", "zlac"), ("CAN1", "nucleo"), ("CAN2", "bay_can2"), ("CAN2", "rz_bms")]):
        if end not in TERM:
            continue
        k = "can_term_%d" % (i + 1)
        tparts.append(k)
        p = np.array(TERM[end]) + [0, 0, .006]
        geo[k] = {"group": "base", "prims": [box([.016, .010, .010], p, "#16a085", hq=True)]}
    comp("can_terms", "CAN1 and CAN2 120 ohm terminations", "CTL-009, CTL-010", len(tparts), "proposed",
         "120 ohm at both physical ends of CAN1 and CAN2 (CAN3 termination is part of CTL-015).", "small primitive",
         "bus ends of the routed CAN cables", 0.016, "estimate", 9, tparts, hq=True, off=[0, 0, .45], opn=[0, 0, .2])

    # ---------------- fasteners (named and proposed); drawn ones load only with High quality
    fx = {"base": [], "col": [], "mov": []}
    def F(joint, part, size, qty, std, mat, cls, drawn="y"):
        fasteners.append({"joint": joint, "part": part, "size": size, "qty": qty, "standard": std, "material": mat, "class": cls, "drawn": drawn})
    # lift base plate on the arch (B3): 4 x M8 class 8.8 from above into the arch rivet nuts; column screwed from below (DIN 7500, flush)
    for (x, y) in arch_bolts:
        fx["base"] += [cyl(.0065, .008, [x, y, lp["top"] + .004], "z", "#2d2d2d", hq=True), cyl(.008, .0016, [x, y, lp["top"] + .0008], "z", "#9a9a9a", hq=True),
                       cyl(.0056, .014, [x, y, FACTS["arch"]["top"] - .002 - .007], "z", "#b0b4b8", hq=True)]
    F("Lift base plate MEC-019 to the centre-frame arch (from above)", "socket head cap screw, class 8.8", "M8 x 20", 4, "ISO 4762", "steel 8.8, zinc flake", "proposed")
    F("Lift base plate MEC-019 to the centre-frame arch (from above)", "washer", "M8", 4, "ISO 7089", "steel 200 HV", "proposed")
    F("Lift base plate MEC-019 to the centre-frame arch", "existing M8 blind rivet nut, round thin, stainless, in the arch top (CAD MMP.04.00.00.000)", "M8", 4, "BOM_specs_MMP.xlsx", "stainless steel", "named")
    # rear power module (rear_power.py): non-metal fixings within 20 mm of the receiver (TZBOT manual; verify torque and creep)
    F("Rear power plate MEC-006 (G10) to the rear panel and the arch angles (within 20 mm of the receiver)", "pan head screw + nut, PA66 (or PEEK)", "M5 x 12", 6, "ISO 7045", "PA66 / PEEK", "proposed", "n")
    F("F0 holder, K1, K2 and the FB-B shelf posts to the G10 plate (screw heads and nuts within 20 mm of the receiver)", "pan head screw + nut, PA66 (or PEEK)", "M5 x 16", 14, "ISO 7045", "PA66 / PEEK", "proposed", "n")
    F("BUS+ on its two POM standoffs", "POM standoff + A2 screw above the standoff (more than 20 mm above the receiver)", "M6 x 12", 4, "ISO 4762", "POM / A2", "proposed", "n")
    F("Busbars BB-01 to BB-04 on the stud terminals (QS1 M10, BUS+, K1, K2, FB-B M8)", "flange nut, serrated, with spring washer", "M8 / M10", 10, "ISO 4161", "brass / A2", "proposed", "n")
    F("FB-B shelf (L3) and FB-A shelf to their posts and the rear panel", "ISO 7380 + M4 blind rivet nut", "M4 x 8", 10, "ISO 7380", "A2", "proposed", "n")
    F("BMS clamp strips to the right side panel (removable panel: BMS service)", "ISO 7380 + M4 blind rivet nut", "M4 x 10", 4, "ISO 7380", "A2", "proposed", "n")
    F("BUS- upright bracket and the left corner plate", "ISO 7380 + M4 blind rivet nut", "M4 x 8", 6, "ISO 7380", "A2", "proposed", "n")
    F("Central channels CH-C1, CH-C2 hung from the arch top sheet; lids clipped", "ISO 7380 + M4 blind rivet nut", "M4 x 8", 8, "ISO 7380", "A2", "proposed", "n")
    F("Front bay side mounting plates to the base sheet", "ISO 7380 + M4 blind rivet nut", "M4 x 8", 8, "ISO 7380", "A2", "proposed", "n")
    for bp, axx in lp["col_axis_x"].items():
        for sx in (-1, 1):
            for sy in (-1, 1):
                x, y = axx + sx * lp["col_screws"][0] / 2, sy * lp["col_screws"][1] / 2
                if bp == "bp000":
                    fx["base"].append(cyl(.0082, .0045, [x, y, lp["top"] - .010 + .00225], "z", "#2d2d2d", hq=True))
    F("DOLD column to the lift base plate (from below, first, on the bench; bp000 hole set)", "countersunk thread-forming screw, flush with the plate underside", "M8 x 30 (>= 20 mm engagement)", 4, "DIN 7500", "steel", "named")
    F("DOLD column to the lift base plate (bp050 hole set, alternative)", "same set at the bp050 holes", "M8 x 30", 4, "DIN 7500", "steel", "named", "n")
    top = U["col_top"]
    ax0 = 0.0
    for dx in (-.03, .03):
        fx["mov"].append(cyl(.0065, .008, [ax0 + .18 + dx, 0, top - .004], "z", "#2d2d2d", hq=True))
    F("HFS6-60120 post to adapter plate (from below, end-tapped)", "socket head cap screw", "M8 x 25", 2, "ISO 4762", "steel 8.8", "proposed")
    for z in (top + .06, top + .16, top + .26):
        fx["mov"].append(box([.006, .016, .010], [ax0 + .18 - .062, 0, z], "#7a7a7a", hq=True))
    F("Rear upright (10 mm) and stiffener to the post", "T-slot nut + socket head cap screw", "M6 x 16", 6, "MISUMI HNTT6 / ISO 4762", "steel", "proposed")
    for s in (-1, 1):
        for dx in (-.03, .03):
            for dz in (-.03, .03):
                fx["mov"].append(cyl(.005, .004, [ax0 + .18 + dx, s * .0325, top + .166 + dz], "y", "#2d2d2d", hq=True))
    F("OpenArm J1_A base to the post side face (1 mm spacer)", "T-slot nut + socket head cap screw", "M6 x 20", 8, "MISUMI HNTT6 / ISO 4762", "steel", "proposed")
    F("J1_A spacer", "1 mm spacer plate", "1 mm", 2, "B7", "aluminium", "named")
    gx = 0.372
    for s in (-1, 1):
        fx["base"].append(cyl(.003, .006, [gx, s * .03, 0.123], "x", "#c9a227", hq=True))
    F("Gemini 336L to PETG mount MEC-009", "heat-set insert", "M4 x 8.1", 2, "brass heat-set insert", "brass", "named")
    F("Gemini 336L to PETG mount MEC-009", "socket head cap screw", "M4 x 8", 2, "ISO 4762", "A2", "proposed")
    F("LIFT-SNS-01 rod corner bracket", "short nut", "M4", 2, "LFT-007", "steel", "named")
    F("LIFT-SNS-01 rod corner bracket", "button head screw", "M4 x 8", 2, "ISO 7380", "steel", "named")
    F("LIFT-SNS-01 rod to adapter plate", "socket head cap screw", "M5 x 20", 1, "ISO 4762", "steel", "named")
    F("LIFT-SNS-01 sensor brackets to the DOLD T-slot", "bracket screw + T-nut", "per BEF-WN-M12", 3, "LFT-007", "steel", "named")
    lz = U["lift_sensor_z"]
    LRf = lift_rear_layout()
    for z in lz:   # A6: bracket screw into the T-slot of the rear face, on the leg on the face
        fx["col"].append(cyl(.003, .004, [FACTS["lift_rear"]["column_rear_x"] - .002, -0.020, z - .008], "x", "#2d2d2d", hq=True))
    F("MB7060 in the 27.5 mm panel hole", "3/4 in NPS lock nut", "3/4 in NPS", 4, "MEC-021", "nylon / steel", "named")
    F("MEC-005 lower plate to the base sheet (rivet nuts)", "ISO 7380 button head screw + rivet nut", "M4 x 8", 6, "ISO 7380", "A2", "proposed")
    for (x, y) in [(0.150, 0.150), (0.240, 0.150), (0.325, 0.150), (0.150, -0.150), (0.240, -0.150), (0.325, -0.150)]:
        fx["base"].append(cyl(.004, .0025, [x, y, FB.FLOOR + .00125], "z", "#9a9a9a", hq=True))
    F("DIN rail to MEC-005", "pan head screw", "M4 x 8", 2, "ISO 7045", "A2", "proposed")
    F("RSD-60G-5, RSD-100B-24 to MEC-005", "socket head cap screw + washer", "M4 x 8", 8, "ISO 4762 / ISO 7089", "A2", "proposed", "n")
    F("FB-A, FB-B, PWR-017 to MEC-006", "socket head cap screw + washer", "M5 x 12", 10, "ISO 4762 / ISO 7089", "A2", "proposed", "n")
    F("K1/K2, F0 holder, BMS to the side pocket plates", "socket head cap screw + washer", "M5 x 12", 10, "ISO 4762 / ISO 7089", "A2", "proposed", "n")
    F("Battery tray MEC-007 to the deck", "socket head cap screw + washer", "M6 x 16", 6, "ISO 4762 / ISO 7089", "steel 8.8", "proposed", "n")
    F("Detachable battery side panels", "quarter-turn fastener", "M5", 8, "DIN 7500-compatible quarter-turn", "steel", "proposed", "n")
    F("PETG sensor mounts (MEC-010, MEC-011) to the panels", "heat-set insert + ISO 7380", "M3 x 6", 12, "brass insert / ISO 7380", "A2", "proposed", "n")
    F("Second E-stop housing P2 to the arm-post rear slots (HFS6)", "ISO 4762 + ISO 7089 + M6 T-slot nut", "M6 x 10", 4, "ISO 4762", "steel", "proposed", "n")
    F("TZBOT receiver bracket WCH-007 to the base sheet (outside the 20 mm zone)", "ISO 7380 + rivet nut, stainless (non-magnetic A4)", "M5 x 10", 4, "ISO 7380", "A4", "proposed", "n")
    F("Ferrite sheet on the receiver top", "adhesive backing (no metal fasteners in the 20 mm zone)", "-", 1, "-", "-", "proposed", "n")
    F("MEC-005 upper shelf on the lower plate (second tier)", "hex standoff M4 x 50 + ISO 7380", "M4", 4, "hex standoff / ISO 7380", "A2", "proposed", "n")
    F("DIN carrier to the centre-bracket front legs", "ISO 4762 + rivet nut", "M5 x 12", 4, "ISO 4762", "A2", "proposed", "n")
    F("Getac pocket and light-bar plate to the post front face", "T-slot nut + ISO 4762", "M6 x 12", 4, "ISO 4762", "steel", "proposed", "n")
    F("MEC-015 motor brackets to the base sheet", "hex bolt + nut + washer", "M8 x 20", 8, "ISO 4017 / ISO 4032 / ISO 7089", "steel 8.8", "proposed", "n")
    for fa in HN.fasteners(HR):
        F(*fa)
    fparts = []
    for g, pr in fx.items():
        if pr:
            k = "fasteners_" + g
            fparts.append(k)
            geo[k] = {"group": g, "prims": pr}
    comp("fasteners", "Fasteners (named and proposed, see fastener_schedule.csv)", "MEC-014, LFT-007", sum(len(p) for p in fx.values()), "proposed",
         "Drawn fasteners of the named joints (B7, LFT-007, Gemini inserts) and proposed ones; the full list is fastener_schedule.csv.",
         "ISO / DIN standard part envelopes", "joints of the model", 0.6, "estimate", 9, fparts, hq=True, off=[0, 0, .45], opn=[0, 0, .2])

    # ---------------- upper-body parts of the harness, fittings and fasteners move to stage 8 components, so that
    # they hide with the upper body (opened base) and explode with it
    up = {"harness": [], "fasteners": []}
    for c in list(comps):
        if c["id"].startswith(("harness_", "fasteners", "service_loop")) and c["id"] != "harness_upper":
            keep = [p for p in c["parts"] if geo[p]["group"] == "base"]
            moved = [p for p in c["parts"] if geo[p]["group"] != "base"]
            if not moved:
                continue
            up["fasteners" if c["id"] == "fasteners" else "harness"] += moved
            if keep:
                c["parts"] = keep
                exploded[c["id"]]["offsets"] = {p: exploded[c["id"]]["offsets"][p] for p in keep}
                exploded[c["id"]]["open"] = {p: exploded[c["id"]]["open"].get(p, [0, 0, .2]) for p in keep}
            else:
                comps.remove(c)
                exploded.pop(c["id"])
    if up["harness"]:
        rows_up = [r for r in cab_rows if r["harness"] in ("W08", "W09") and r["route_length_m"]]
        comp("harness_upper", "Harness on the lift column and carriage (W08 lift column, W09 upper body: sleeve, energy chain, moving trunk)", "ARM-009, ARM-010, ARM-006, AUX-003, LFT-002, CTL-016", len(rows_up), "proposed",
             "Upper-body part of the routed cables: fixed sleeve up the -y face of the static column into the energy chain, the lift stop sensor cables down the rear face to the lift node, and the moving trunk under the adapter plate with the risers at the arm post to the arms, ZED, Getac, head light and second E-stop.",
             "tubes at the cable outer diameter", "routed by harness.py (bp000, L1000)", 0.6, "estimate", 8, up["harness"], off=[0, -.25, .1], opn=[0, 0, 0])
    if up["fasteners"]:
        comp("fasteners_upper", "Fasteners of the lift and arm post (named and proposed)", "MEC-014", len(up["fasteners"]), "proposed",
             "Lift sensor bracket screws, post bolts from below, rear upright T-nuts and the J1_A mounting screws.", "ISO / DIN standard part envelopes",
             "joints of the upper body", 0.2, "estimate", 8, up["fasteners"], hq=True, off=[0, 0, .1], opn=[0, 0, 0])

    # ---------------- outputs
    # meta for the registry components of model.js (class, part number, position source, mass) from bom_map.yaml
    js = open(os.path.join(MODEL, "model.js"), encoding="utf-8").read()
    reg = json.loads(re.search(r"/\*COMPONENTS-JSON\*/(.*?)/\*COMPONENTS-JSON-END\*/", js, re.S).group(1))
    meta = {}
    for c in reg:
        hits = [(bid, m) for bid, m in BM.items() if isinstance(m, dict) and c["id"] in [x.strip() for x in str(m.get("by", "")).split(",")]]
        if not hits:
            first = (c.get("bom") or "").split(",")[0].strip()
            hits = [(first, BM[first])] if first in BM else []
        cls = {"cad": "CAD-derived", "envelope": "envelope", "primitive": "primitive", "none": "not drawn"}[c["geometry"]]
        if c.get("provisional"):
            cls = "provisional"
        if c.get("placeholder"):
            cls = "placeholder"
        mm = hits[0][1] if hits else {}
        meta[c["id"]] = {"class": cls, "part_number": BOM.get(hits[0][0], {}).get("Model / order code", "")[:120] if hits else "",
                         "position_source": mm.get("pos", "CAD v0.2 assembly (openamr-platform-hw)" if c["geometry"] == "cad" else ""),
                         "mass_kg": mm.get("mass", ""), "mass_source": mm.get("msrc", "")}
    placement = {"schema": 1, "meta": meta, "frame": "base_footprint (floor under the drive-axle midpoint; x forward, y left, z up)",
                 "about": "Generated by scripts/roadmap_model/build.py. Do not edit by hand.",
                 "sources": {"datums": rev, "facts": FACTS["documents"], "snapshot": FACTS["snapshot"]},
                 "groups": "base: robot root (floor frame); col: lift assembly (x from the column axis); mov: lift stage (x from the column axis, z at L1000)",
                 "legend": {d: T["harness_domains"][d] for d in T["harness_domains"]},
                 "components": comps, "geometry": geo,
                 "hide_glb": ["battery"],   # A1: the single-row battery envelope is replaced by the cells in the side pockets
                 "front_bay": {"default": fb_default, "layout": FBR[fb_default].get("layout", ""), "relocate": fb_relocate, "glb_centre": fb_glb_centre, "relocatable": ["compute", "base_controller"]},
                 "upper_body": {k: (v if not isinstance(v, (list, tuple)) else [R(x) for x in v]) for k, v in U.items() if k != "datums_revision"},
                 "energy_chain": {"x": R(chn["x"] - FACTS["lift_plate"]["col_axis_x"]["bp000"]), "y_fixed": chn["y_fixed"], "y_moving": chn["y_moving"],
                                  "fixed_z": chn["fixed_z"], "moving_z0": chn["moving_z0"], "R": chn["R"], "length": chn["length"], "pitch": chn["pitch"],
                                  "outer_w": chn["outer_w"], "outer_h": chn["outer_h"], "stroke": chn["stroke"], "part": "lift_energy_chain",
                                  "about": "lift energy chain, drawn by model.js for the lift travel (col group: x from the column axis, z absolute)"}}
    json.dump(placement, open(os.path.join(MODEL, "placement.json"), "w"), separators=(",", ":"))
    # exploded.json: merge entries, add stage 9
    xp = os.path.join(MODEL, "exploded.json")
    ex = json.load(open(xp))
    if not any(s["n"] == 9 for s in ex["stages"]):
        ex["stages"].append({"n": 9, "title": "Harness", "text": "Every cable of the harness on its routed path, coloured by domain, with the P-clips, grommets, CAN terminations, the upper-body service loop and the drawn fasteners. Proposed by the roadmap model; cable_list.csv gives each route.", "frame": "base"})
    gen = ex.setdefault("generated", [])
    for cid in gen:
        ex["components"].pop(cid, None)
    ex["components"].update(exploded)
    ex["generated"] = sorted(exploded)
    json.dump(ex, open(xp, "w"), indent=1, ensure_ascii=False)

    # bom_coverage.csv
    comp_by_id = {c["id"]: c for c in comps}
    rows = []
    for bid in sorted(BOM, key=lambda k: (k.split("-")[0], k)):
        b = BOM[bid]
        m = dict(BM.get(bid, {}))
        qty = b.get("Qty", "")
        q = int(qty) if str(qty).strip().isdigit() else None
        by = m.get("by", "")
        if by in comp_by_id or by in [it["id"] for it in T["packed"] + T["fixed"]]:
            c = comp_by_id.get(by)
            if c is None:
                m.update({"cls": "not drawn", "reason": "no space found by the packer (see geometry_issues.csv)", "mass": 0})
                drawn_qty = 0
            else:
                m.setdefault("cls", c["class"])
                m.setdefault("geo", c["source"])
                m.setdefault("pos", c["position_source"])
                m.setdefault("mass", c["mass_kg"])
                m.setdefault("msrc", c["mass_source"])
                drawn_qty = c["qty"]
        else:
            drawn_qty = None
        offb = str(m.get("reason", "")).startswith(("offboard", "fallback", "set row"))
        onboard = not offb and q != 0
        if m.get("cls") == "not drawn" or by == "none":
            drawn, mq = "n", 0
        elif by == "harness" or str(by).startswith("inside:"):
            drawn, mq = "y", q
        else:
            drawn = "y"
            mq = drawn_qty if drawn_qty is not None else q
            if bid in ("MEC-001",):
                mq = 1
            if bid == "ARM-001":
                mq = 1
            if bid == "SAF-001":
                mq = 2
            if bid in ("PWR-001", "PWR-028"):
                mq = 1
            if bid == "MEC-015":
                mq = 2
            if bid == "MEC-008":
                mq = 1
        if "mqty" in m and drawn == "y":
            mq = m["mqty"]
        rows.append({"id": bid, "part": b.get("Component / assembly", ""), "part_number": b.get("Model / order code", "")[:90],
                     "qty": qty, "subsystem": b.get("Subsystem", ""), "onboard": "y" if onboard else "n",
                     "class": m.get("cls", "unmapped"), "geometry_source": m.get("geo", ""), "position_source": m.get("pos", ""),
                     "model_qty": mq if mq is not None else "", "model_component": by, "mass_kg": m.get("mass", ""), "mass_source": m.get("msrc", ""),
                     "drawn": drawn, "reason_not_drawn": m.get("reason", "") if drawn == "n" else ""})
    with open(os.path.join(MODEL, "bom_coverage.csv"), "w", newline="") as f:
        w = csv.DictWriter(f, fieldnames=list(rows[0]))
        w.writeheader()
        w.writerows(rows)
    with open(os.path.join(MODEL, "fastener_schedule.csv"), "w", newline="") as f:
        w = csv.DictWriter(f, fieldnames=["joint", "part", "size", "qty", "standard", "material", "class", "drawn"])
        w.writeheader()
        w.writerows(fasteners)
    with open(os.path.join(MODEL, "cable_list.csv"), "w", newline="") as f:
        keys = ["id", "from", "to", "function", "domain", "gauge_or_type", "od_mm", "connector_a", "connector_b", "pin_or_terminal", "bom",
                "harness", "harness_name", "route", "route_length_m", "length_with_margin_m", "min_bend_radius_mm", "route_min_radius_mm",
                "flex_min_radius_mm", "label_a", "label_b", "disconnect", "protection", "attachment", "tie_points", "mass_kg", "from_part", "to_part", "from_xyz", "to_xyz"]
        w = csv.DictWriter(f, fieldnames=keys)
        w.writeheader()
        w.writerows(cab_rows)
    # Declared exit passage of the battery and power module (owner review of #71): cables of other harnesses that start or end at a
    # module part leave the module only here, listed by ID; everywhere else in the module exception zone every check applies.
    # Kept here (not in harness.py) so the route cache stays valid; the routes already run in this box.
    exit_passages = [{"id": "C-RM rear module exit channel over the F0 access band into the arch opening",
                      "lo": [-0.195, -0.090, 0.190], "hi": [-0.135, 0.090, 0.270],
                      "cables": ["CBL-P07", "CBL-P12", "CBL-P14", "CBL-P15", "CBL-P20", "CBL-P35", "CBL-P61"],
                      "why": "exit lane from the rear module into the arch opening (|y| < 90 mm); above the 60 mm F0 access band; cables in a lidded U-channel (harness_cad_changes.csv)"}]
    RJ = HN.routes_json(HR, cab_rows, hcache["key"])
    RJ["passages"] = list(RJ.get("passages", [])) + exit_passages
    with open(os.path.join(MODEL, "harness_routes.json"), "w", encoding="utf-8") as f:
        json.dump(RJ, f, separators=(",", ":"))
    with open(os.path.join(MODEL, "harness_cad_changes.csv"), "w", newline="") as f:
        w = csv.DictWriter(f, fieldnames=["item", "part", "change", "qty", "where"])
        w.writeheader()
        w.writerows(HN.cad_changes(HR))
        mmw = lambda lo_, hi_: "x %.0f to %.0f, y %.0f to %.0f, z %.0f to %.0f mm" % (lo_[0] * 1000, hi_[0] * 1000, lo_[1] * 1000, hi_[1] * 1000, lo_[2] * 1000, hi_[2] * 1000)
        extra = [{"item": "new part", "part": "C-RM rear module exit channel (W02, W03, W04, W09 cables leaving the module into the arch opening)",
                  "change": "U-channel 2 mm walls with a clip lid, mounted on the arch rear opening above the F0 access band; edge trim at both ends; cables CBL-P07, P12, P14, P15, P20, P35, P61",
                  "qty": 1, "where": "x -195 to -135, y -90 to 90, z 190 to 270 mm"},
                 {"item": "rear power module", "part": "MEC-006 power plate", "change": "plate material and height: G10 / FR4 glass-epoxy 3 mm (non-metal within 20 mm of the receiver), underside 117 mm (15 mm above the receiver top); PA66 or PEEK fasteners within 20 mm of the receiver (verify with TZBOT)",
                  "qty": 1, "where": mmw(RP["parts"]["rear_plate"]["lo"], RP["parts"]["rear_plate"]["hi"])}]
        for k_, m_ in RP["mounts"].items():
            extra.append({"item": "new part", "part": m_["name"], "change": "new mounting part, %s" % m_["material"], "qty": 1, "where": mmw(m_["lo"], m_["hi"])})
        for cid_, b_ in RP["busbars"].items():
            p_ = b_["pts"]
            extra.append({"item": "busbar", "part": "%s (%s)" % (b_["name"], cid_), "change": "%s; %d bends; developed length %.0f mm; insulated, stud covers; E-01 circuit unchanged" % (
                b_["section"], len(p_) - 2, sum(np.linalg.norm(np.subtract(p_[i + 1], p_[i])) for i in range(len(p_) - 1)) * 1000), "qty": 1,
                          "where": " > ".join(str([round(v * 1000) for v in q]) for q in p_)})
        extra += [{"item": "rear panel", "part": "rear panel MMP (Rev B)", "change": "QS1 BS-6004B cut-out moved to y -56 mm, z 191 mm (67 mm face, key outside, studs inboard)", "qty": 1, "where": "x -370 mm"},
                  {"item": "side panel", "part": "right side panel", "change": "BMS clamp strips: 4 x M4 blind rivet nuts; the panel stays removable for BMS service", "qty": 4, "where": "x -275 to -127 mm, z 96 to 170 mm"},
                  {"item": "electronics bracket", "part": "MMP.04.00.00.002", "change": "rear-wall slot 150 x 53 mm with edge trim for both hub-motor leads from the ZLAC8015D", "qty": 1, "where": "x -16 mm, y -75 to 75 mm, z 115 to 168 mm"}]
        extra.append({"item": "new part", "part": "CH-B1 / CH-B2 channel cross branches", "change": "U-branches 40 mm wide from the central channels over the wheels to the over-wheel guards; 2 slots 36 x 25 mm with edge trim in the centre-bracket side walls", "qty": 2, "where": "x -60 to -20 mm, |y| 85 to 236 mm, z 212 to 240 mm"})
        for c_ in HN.CHANNELS:
            extra.append({"item": "new part", "part": c_["name"], "change": "U-channel 3 mm floor, 2 mm walls, lid with clips, floor drop-out x %.0f to %.0f mm with edge trim; 4 x M4 rivet nuts in the arch top sheet" % (HN.CH_DROP[0] * 1000, HN.CH_DROP[1] * 1000),
                          "qty": 1, "where": "x %.0f to %.0f, y %.0f to %.0f, z %.0f to %.0f mm" % (HN.CH_X[0] * 1000, HN.CH_X[1] * 1000, c_["y"][0] * 1000, c_["y"][1] * 1000, HN.CH_FLOOR * 1000, HN.CH_TOP * 1000)})
        for q_ in FBR[fb_default].get("side_plates", []):
            extra.append({"item": "new part", "part": q_["name"], "change": "3 mm 5052 plate on the base sheet, 4 x M4 rivet nuts", "qty": 1, "where": mmw(q_["lo"], q_["hi"])})
        extra.append({"item": "side panel", "part": "right side panel", "change": "USB and Ethernet service feed-throughs moved from the left to the right side panel (signal side)", "qty": 2, "where": "x 200 and 245 mm, z 185 mm"})
        ax_ = FACTS["lift_plate"]["col_axis_x"]["bp000"]
        for k_, (lo_, hi_) in FGL["boxes"].items():
            extra.append({"item": "new part", "part": "flag rod guide: %s" % k_.replace("_", " "), "change": {"ring": "stainless 1.4301, 1.5 mm, U bent (open toward -y)", "liner": "PTFE 0.5 mm bonded (verify)", "arm": "6082-T6 3 mm plate", "foot": "6082-T6 spacer block, 2 x M5 x 30 ISO 4762 + T-slot nuts into the static column +y face"}[k_.split("_")[0]],
                          "qty": 1, "where": mmw([lo_[0] + ax_, lo_[1], lo_[2]], [hi_[0] + ax_, hi_[1], hi_[2]])})
        w.writerows(extra)
    assembly(fasteners)
    # source snapshot for scripts/check_roadmap.py (CI has no ../src): the source values the model must match
    snap = {"about": "Source values the roadmap model is checked against (scripts/check_roadmap.py). Generated by build.py.",
            "datums_revision": rev, "base_link_z": FACTS["base_link_z"],
            "sensor_frames": {k: [R(x, 5) for x in v["xyz"]] for k, v in SF.items()},
            "frame_nodes": {"imu_link": "imu", "lidar_link": "lidar", "base_camera_link": "base_camera", "tof_front": "tof_front", "tof_rear": "tof_rear",
                            "us_front_left": "ultrasonic_front_left", "us_front_right": "ultrasonic_front_right",
                            "us_rear_left": "ultrasonic_rear_left", "us_rear_right": "ultrasonic_rear_right"},
            "datums": {k: v for k, v in D.items() if not isinstance(v, dict)},
            "owner_corrections": {"source": "owner, 2 Nov 2026 (to be entered in P-03 and M-01)", "getac_size": FACTS["getac"]["size"], "getac_lower_by": FACTS["getac"]["lower_by"],
                                  "light_gap": FACTS["getac"]["light_gap"], "zed_ahead_of_j1a": FACTS["zed_ahead_of_j1a"], "second_estop": FACTS["second_estop"]["position"],
                                  "receiver": {"lo": FACTS["tzbot_receiver"]["lo"], "hi": FACTS["tzbot_receiver"]["hi"], "status": FACTS["tzbot_receiver"]["status"]},
                                  "lift_rear": dict(LR, column_rear_x=FACTS["lift_rear"]["column_rear_x"], sensor_z=FACTS["lift_rear"]["sensor_z"])}}
    snap["sensor_frames_rpy"] = {k: [R(x, 5) for x in v["rpy"]] for k, v in SF.items()}
    snap["sensor_bodies"] = sensor_bodies(G, SF, snap["frame_nodes"])
    old_snap = os.path.join(MODEL, "source_snapshot.json")
    if os.path.exists(old_snap):
        keep = json.load(open(old_snap)).get("combined_model")
        if keep:
            snap["combined_model"] = keep
    json.dump(snap, open(os.path.join(REPO, "docs", "assets", "roadmap", "model", "source_snapshot.json"), "w"), indent=1)
    summary = {"packed": {k: [[R(x) for x in v[0]], [R(x * 1000, 1) for x in v[1]]] for k, v in placed.items()}, "nofit": nofit,
               "front_bay": {o: {"fit": fb_fit[o], "placed": {k: [v[0], [R(x) for x in v[1]], [R(x * 1000, 1) for x in v[2]]] for k, v in FBR[o]["placed"].items()},
                                 "plates": FBR[o]["plates"], "shelf": FBR[o].get("shelf"), "shelf_order": FBR[o].get("shelf_order")} for o in FBR},
               "front_bay_default": fb_default, "relocate": fb_relocate, "receiver": {"centre": FACTS["tzbot_receiver"]["centre"], "lo": TZL["lo"].round(4).tolist(), "hi": TZL["hi"].round(4).tolist(), "cutout": TZL["cutout"], "orientation": TZL["orientation"], "cutout_mm": TZL["cutout_mm"], "cutout_full_mm": TZL["cutout_full_mm"], "gap_m": R(TZL["lo"][2] - FACTS["tzbot_transmitter"]["size"][2]), "status": FACTS["tzbot_receiver"]["status"]},
               "rear_layout": {k: RL[k] for k in ("measured", "pocket_free", "pockets", "plate", "margin", "cutout", "trays", "link_z")},
               "k1k2_options": opt, "gi080": gi80, "flag_guide": {k_: FGL[k_] for k_ in ("z", "band", "band_margin_mm", "opening", "clearance_mm", "liner", "wall", "arm", "summary", "checks", "removal", "rod_x_base")}, "battery_trays": tray_check, "cables_25mm2": BEND25, "bolts": bolts, "bay_plate_area_m2": R(area, 4), "seed": issues_seed,
               "coverage": {c: sum(1 for r in rows if r["class"] == c) for c in sorted({r["class"] for r in rows})},
               "onboard": sum(1 for r in rows if r["onboard"] == "y"), "records": len(rows)}
    json.dump(summary, open(os.path.join(HERE, "build_summary.json"), "w"), indent=1, default=str)
    print(json.dumps({k: summary[k] for k in ("nofit", "coverage", "onboard", "records")}, indent=0))
    print("K1/K2:", {k: v["fits"] for k, v in opt.items()})


SENSOR_TYPE = {"imu_link": "imu", "lidar_link": "lidar", "base_camera_link": "base_camera", "tof_front": "tof", "tof_rear": "tof",
               "us_front_left": "ultrasonic", "us_front_right": "ultrasonic", "us_rear_left": "ultrasonic", "us_rear_right": "ultrasonic"}


def rpy_matrix(r, p, y):
    cr, sr, cp, sp, cy, sy = math.cos(r), math.sin(r), math.cos(p), math.sin(p), math.cos(y), math.sin(y)
    return np.array([[cy, -sy, 0], [sy, cy, 0], [0, 0, 1]]) @ np.array([[cp, 0, sp], [0, 1, 0], [-sp, 0, cp]]) @ np.array([[1, 0, 0], [0, cr, -sr], [0, sr, cr]])


def sensor_bodies(G, SF, frame_nodes):
    """Reference body of each base sensor for the pose check of scripts/check_roadmap.py: its drawn GLB mesh expressed in
    its sensor_frames.yaml frame (mm, vertex order of the GLB), validated against the platform-sw visual STL of the sensor
    type (largest vertex-to-surface distance, recorded; at most 0.6 mm or the build stops)."""
    import trimesh
    stl_dir = os.path.join(os.path.dirname(os.path.dirname(SENSOR_FRAMES)), "meshes", "visual")
    out, meshes = {}, {}
    for frame, node in frame_nodes.items():
        typ = SENSOR_TYPE[frame]
        f = SF[frame]
        local = (G[node]["v"] - np.array(f["xyz"])) @ rpy_matrix(*f["rpy"])
        if typ not in meshes:
            meshes[typ] = trimesh.load(os.path.join(stl_dir, typ + ".stl"), force="mesh")
        _, dist, _ = trimesh.proximity.closest_point(meshes[typ], local)
        if dist.max() > 0.0006:
            raise SystemExit("sensor body %s: drawn mesh is %.2f mm off the source STL %s.stl in its frame" % (node, dist.max() * 1000, typ))
        lo, hi = local.min(0), local.max(0)
        out[frame] = {"node": node, "type": typ, "stl": "openamr-platform-sw ros2/src/openamrobot_description/meshes/visual/%s.stl" % typ,
                      "stl_residual_max_mm": round(float(dist.max()) * 1000, 3),
                      "centre_local_mm": [round(float(x) * 1000, 2) for x in (lo + hi) / 2],
                      "extents_mm": [round(float(x) * 1000, 2) for x in hi - lo],
                      "ref_local_mm": [[round(float(x) * 1000, 3) for x in p] for p in local]}
    return out
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
