openAMRobot/openamrobot-docs/scripts/roadmap_model/hardware_sections.py

#!/usr/bin/env python3
"""Write the generated sections of docs/assets/roadmap/hardware.html from the model outputs:
3D model coverage (bom_coverage.csv, analysis_summary.json, build_summary.json, cable_list.csv), the mechanical
parts table (design_intent/index.json), the geometry and hardware issues (geometry_issues.csv, sorted by severity)
and the conflicts list (conflicts.yaml). The sections sit between <!--GEN:name--> and <!--/GEN:name--> markers,
after the "Hardware values with known drift" section. Rerun after build.py and analyse.py.
"""
import collections
import csv
import html
import json
import os
import re

from frames import HERE, MODEL, REPO, load_yaml, tzbot_layout

PAGE = os.path.join(REPO, "docs", "assets", "roadmap", "hardware.html")
E = html.escape
SNAP = "2 Nov 2026"
A = lambda href, text: '<a href="%s" target="_blank" rel="noopener">%s</a>' % (E(href), E(text))
OWNER = '<a class="who" href="https://github.com/fridayali" target="_blank" rel="noopener">@fridayali</a> <span class="role">(mechanical CAD)</span>'


def section(sid, title, body, src):
    return ('<!--GEN:%s--><section class="card" id="%s"><h2>%s</h2>%s<p class="src small mute">Source: %s · %s</p></section><!--/GEN:%s-->'
            % (sid, sid, E(title), body, src, SNAP, sid))


def table(head, rows, cls="tbl"):
    h = "".join("<th>%s</th>" % E(x) for x in head)
    b = "".join("<tr>%s</tr>" % "".join("<td%s>%s</td>" % (' class="small"' if i else "", c) for i, c in enumerate(r)) for r in rows)
    return '<div class="%s"><table><thead><tr>%s</tr></thead><tbody>%s</tbody></table></div>' % (cls, h, b)


def harness_table(hr, cab):
    """One row per named harness: route, cables (routed / all), length with margin, smallest bend radius held, tie points."""
    if not hr.get("harnesses"):
        return ""
    rows = []
    for h in hr["harnesses"]:
        mine = [c for c in cab if c.get("harness") == h["id"]]
        rt = [c for c in mine if c["route_length_m"]]
        radii = [float(c["route_min_radius_mm"]) for c in rt if c.get("route_min_radius_mm") not in ("", "straight")]
        ties = sum(1 for t in hr.get("ties", []) if any(x in h.get("all_cables", []) for x in t["cables"]))
        rows.append([E(h["id"]), E(h["name"]), E(h["route"]), "%d / %d" % (len(rt), len(mine)), "%.1f" % sum(float(c["length_with_margin_m"]) for c in rt),
                     "%.0f" % min(radii) if radii else "-", str(ties)])
    ch = hr.get("chain") or {}
    b = ch.get("bundle", {})
    return (table(["Harness", "Name", "Route", "Cables routed / all", "Length m (10 % margin)", "Smallest bend radius held, mm", "Tie points"], rows) +
            "<p><b>Lift energy chain:</b> %s; %d links, %.3f m, bend radius %.0f mm; %d cables in it (%.0f mm² of %.0f mm² inner section, %.0f %% fill, "
            "largest OD %.1f mm, continuous-flex minimum %d mm). Fixed end at z %.3f on the static column, loop bottom %.0f mm at L1000 and %.0f mm at L1350 "
            "above the floor, fixed run %.0f mm at L1350; %s at the 25 mm steps of the stroke.</p>" % (
                E(ch.get("type", "")), ch.get("links", 0), ch.get("length", 0), ch.get("R", 0) * 1000, b.get("count", 0), b.get("area_mm2", 0), 38 * 25,
                b.get("fill_pct", 0), b.get("max_od_mm", 0), b.get("flex_min_mm", 0), ch.get("fixed_z", 0),
                ch["stops"][0]["loop_bottom_z"] * 1000 if ch.get("stops") else 0, ch["stops"][-1]["loop_bottom_z"] * 1000 if ch.get("stops") else 0,
                ch["stops"][-1]["fixed_run_m"] * 1000 if ch.get("stops") else 0,
                "no contact with the column, sensors, flag rod, lift node, DP-LIFT or cover" if not any(st_["clash"] for st_ in ch.get("stops", [])) else
                "contact: " + E(", ".join(sorted({c_ for st_ in ch["stops"] for c_ in st_["clash"]})))))


def model_section():
    cov = list(csv.DictReader(open(os.path.join(MODEL, "bom_coverage.csv"))))
    an = json.load(open(os.path.join(HERE, "analysis_summary.json")))
    bs = json.load(open(os.path.join(HERE, "build_summary.json")))
    cab = list(csv.DictReader(open(os.path.join(MODEL, "cable_list.csv"))))
    try:
        hr = json.load(open(os.path.join(MODEL, "harness_routes.json"), encoding="utf-8"))
    except (OSError, ValueError):
        hr = {}
    fas = list(csv.DictReader(open(os.path.join(MODEL, "fastener_schedule.csv"))))
    on = [r for r in cov if r["onboard"] == "y"]
    cnt = collections.Counter(r["class"] for r in on)
    drawn = sum(1 for r in on if r["drawn"] == "y")
    qmis = [r["id"] for r in on if r["drawn"] == "y" and r["model_qty"] not in ("", r["qty"])]
    rows = [[E(k), str(v)] for k, v in sorted(cnt.items(), key=lambda kv: -kv[1])]
    m = an["mass"]
    st = an["stability"]
    ld = an["loads"]
    routed = [c for c in cab if c["route_length_m"]]
    total_len = sum(float(c["length_with_margin_m"]) for c in routed)
    nofit = bs["nofit"]
    k = bs["k1k2_options"]
    body = (
        '<p>The shared model now draws every onboard BOM Issue 7.14 line it has a geometry or position source for. '
        'Positions come from datums.yaml (%s), sensor_frames.yaml and the section B facts through '
        '<code>scripts/roadmap_model/build.py</code>; nothing is placed by hand. A part without a position source is drawn '
        'provisional with a label; parts the model proposes (front bay, rear zone, harness, fasteners) are marked proposed.</p>'
        % E(an.get("datums_revision", "2026-11-01.c")) +
        "<p><b>Coverage:</b> %d BOM records, %d onboard by the model rule (offboard, qty 0 and the fallback lift excluded; "
        "the BOM states 115 onboard, see the conflicts list); %d onboard lines drawn, %d not drawn. Model quantity differs from the BOM "
        "quantity on: %s.</p>" % (len(cov), len(on), drawn, len(on) - drawn, E(", ".join(qmis)) or "none") +
        table(["Class (onboard lines)", "Lines"], rows) +
        "<p><b>Mass and centre of mass</b> (coverage roll-up, MEC-001 from the CAD volume as steel, %.1f kg): %.1f kg against the 120 kg cap. "
        "COM at L1000 x %.0f, y %.0f, z %.0f mm; at L1350 z %.0f mm. Static tip-over margins to the castor polygon: fore %.0f, aft %.0f, lateral %.0f mm; "
        "maximum deceleration before tip-over %.1f m/s² at L1000 and %.1f m/s² at L1350 (fore), %.1f m/s² lateral at L1350. "
        "Drive pair load by the lever rule %.0f kg (rating 120 kg per pair).</p>" % (
            an["steel_chassis_kg"], m["L1000"]["mass"], m["L1000"]["com"][0] * 1000, m["L1000"]["com"][1] * 1000, m["L1000"]["com"][2] * 1000,
            m["L1350"]["com"][2] * 1000, st["L1000"]["margin_fore_m"] * 1000, st["L1000"]["margin_aft_m"] * 1000, st["L1000"]["margin_lat_m"] * 1000,
            st["L1000"]["a_max_fore"], st["L1350"]["a_max_fore"], st["L1350"]["a_max_lat"], ld["L1350"]["drive_pair_kg"]) +
        "<p><b>Front electronics bay</b> (one layout, owner correction A2): %s, %d parts placed, not placed: %s; see the front bay section below.</p>" % (
            E(bs["front_bay"]["single"]["fit"].get("layout", "")), bs["front_bay"]["single"]["fit"]["placed"], E(", ".join(bs["front_bay"]["single"]["fit"]["not_placed"])) or "none") +
        "<p><b>Rear section</b> (owner correction A1 and the receiver position of 2 Nov 2026): 8 x LF105 upright, 4 per side pocket (8S); power electronics on "
        "the MEC-006 plate above the prepared TZBOT receiver, underside 122 mm above the floor, with a second level allowed for the BMS and PWR-017 and nothing "
        "above a fuse. Not placed: %s (geometry issue %s). K1/K2 option A GX11CAC fits: %s. Option B TeSys D LC1D80BD fits: %s (labelled ghost). "
        "Siemens 3RT2 S3 fits: %s.</p>" % (E(", ".join(nofit)) or "none", gi("Rear layout"), "yes" if k["A"]["fits"] else "no", "yes" if k["B_tesys"]["fits"] else "no", "yes" if k["B_siemens"]["fits"] else "no") +
        "<p><b>Harness:</b> %d cables in %d named harnesses (W01 to W09), %d on supported routes (%.1f m with the 10 %% service margin); "
        "%d partly routed or not routed (endpoint not placed, or no compliant passage in the rear layout: see the geometry issues). Routes run "
        "along the floor, the side panels and the uprights, branch inward at each consumer, cross the drive section on the two over-wheel guards and "
        "leave the base at one deck exit behind the lift base plate, where every lift cable plugs in at DP-LIFT. %d tie points at 150 mm or less "
        "and within 50 mm of every connector and branch, %d grommets or split entries. Upper body: fixed sleeve on the -y face of the static column, "
        "energy chain behind the column (%s, %d links, R %.0f mm), moving trunk under the adapter plate. Labels at both ends of every cable. "
        "<b>Fasteners:</b> %d schedule rows (named and proposed), the start of MEC-014; small parts load with High quality only.</p>" % (
            len(cab), len(hr.get("harnesses", [])), len(routed), total_len, len(cab) - len(routed), len(hr.get("ties", [])), len(hr.get("grommets", [])),
            E(hr["chain"]["type"].split(" (")[0]) if hr.get("chain") else "-", hr["chain"]["links"] if hr.get("chain") else 0,
            hr["chain"]["R"] * 1000 if hr.get("chain") else 0, len(fas)) +
        harness_table(hr, cab) +
        "<p>Files: %s, %s, %s, %s, %s, %s, %s; layout STEP for SolidWorks: %s.</p>" % (
            A("model/bom_coverage.csv", "bom_coverage.csv"), A("model/fastener_schedule.csv", "fastener_schedule.csv"),
            A("model/cable_list.csv", "cable_list.csv"), A("model/harness_routes.json", "harness_routes.json"),
            A("model/harness_cad_changes.csv", "harness_cad_changes.csv"), A("model/assembly_sequence.csv", "assembly_sequence.csv"),
            A("model/geometry_issues.csv", "geometry_issues.csv"), A("model/export/openamrobot2_layout.step", "openamrobot2_layout.step")))
    return section("model3d", "3D model: BOM coverage, front bay, rear zone and harness", body,
                   "roadmap model build of %s (scripts/roadmap_model), BOM Issue 7.14, datums.yaml 2026-11-01.d, sensor_frames.yaml at platform-sw 4926f40" % SNAP)


def mech_section():
    di = json.load(open(os.path.join(MODEL, "design_intent", "index.json")))
    di = di if isinstance(di, list) else di["items"]
    names = {"tof_mount": "a. TF-Luna mounts, front and rear", "ultrasonic_mount": "b. MB7060 mounts (4)", "gemini_mount": "c. Gemini 336L mount",
             "zed_bracket": "d. ZED Mini bracket on the post top", "getac_pocket": "e. Getac ZX80 pocket and light-bar plate",
             "lift_base_plate": "f. Lift base plate on the centre-frame arch", "adapter_post": "g. One-piece adapter plate with the rear extension, HFS6-60120 post, upright, stiffener",
             "rear_estop_housing": "h. Second E-stop housing on the adapter plate, button up (A5)", "motor_bracket": "i. Hub motor shaft-flat brackets", "lift_sensor_set": "j. Lift stop sensor set on the column rear face (A6)",
             "battery_tray": "k. Battery tray"}
    rows = []
    for d in di:
        status = "design intent" + ("; CAD exists for the fixed-angle version" if d.get("existing_cad") else "")
        src = "%s, %s, %s mm; %s" % ("design_intent/%s.step" % d["files"][0]["variant"], d.get("method", ""), d.get("thickness_mm", ""), d.get("existing_cad") or "no CAD in openamr-platform-hw or openamr-upperbody-hw")
        rows.append([E(names.get(d["item"], d["item"])), E(d.get("bom", "")), E(status), E(src), E(d.get("next_step", "CAD owner to model from the design intent")), OWNER])
    rows.append([E("Layout STEP of the whole robot"), "", E("design intent"), E("export/openamrobot2_layout.step: design-intent solids plus one box per drawn part, named by BOM id, base_footprint"),
                 E("open in SolidWorks as the skeleton for M-02 to M-09"), OWNER])
    rows.append([E("M-09 positions (Getac, light, second E-stop, lift sensors)"), "UI-001, AUX-001, SAF-001, LFT-001", E("not started"),
                 E("placeholders from datums.yaml; no CAD commit since 16 Oct (6c32fba)"), E("confirm the absolute positions; CAD fixes promised 31 Oct are not pushed"), OWNER])
    body = ("<p>Parametric design-intent parts (CadQuery, one script per item in <code>scripts/roadmap_model/design_intent/</code>, change a value and "
            "rerun <code>run_all.py</code>), exported as STEP and STL. They are proposals from B7 and the datasheets, class provisional, not CAD. "
            "Work packages M-02, M-03, M-04, M-05, M-07 and M-09.</p>" + table(["Item", "BOM ID", "Status", "Source", "Next step", "Owner"], rows))
    return section("mechparts", "Mechanical parts", body, "M-01 rev19.7, P-03 rev20.2, decisions.yaml 5ed600e, design_intent/index.json")


def issues_section():
    rows = list(csv.DictReader(open(os.path.join(MODEL, "geometry_issues.csv"))))
    big = [r for r in rows if r["severity"] in ("blocker", "major")]
    small = [r for r in rows if r["severity"] == "minor"]
    who = lambda h: '<a class="who" href="https://github.com/%s" target="_blank" rel="noopener">@%s</a>' % (E(h), E(h))
    mk = lambda rs: [[E(r["id"]), E(r["severity"]), E(r["parts"]), E(r["configuration"]), E(r["measured"]), E(r["limit"]), E(r["suggested_fix"]), who(r["owner"])] for r in rs]
    head = ["ID", "Severity", "Parts", "Configuration", "Measured", "Limit", "Suggested fix", "Owner"]
    c = collections.Counter(r["severity"] for r in rows)
    body = ("<p>Generated from %s by <code>scripts/roadmap_model/analyse.py</code> on the shared model: interference of all part pairs at L1000, L1175 and "
            "L1350, bp000 and bp050, hp15 to hp35 and both Getac positions; a single-joint arm sweep through the URDF limits at 10 deg steps at L1000 and "
            "L1350; the Gemini 336L and ZED Mini views and the LiDAR plane; mass, stability, the TZBOT receiver, service access and the K1/K2 fit. "
            "Box parts are tested exactly, meshes on 0.75 mm surface samples. %d blocker, %d major, %d minor.</p>" % (A("model/geometry_issues.csv", "geometry_issues.csv"), c["blocker"], c["major"], c["minor"]) +
            table(head, mk(big)) + "<details><summary>%d minor issues</summary>%s</details>" % (len(small), table(head, mk(small))) + closed_html())
    return section("geoissues", "Geometry and hardware issues", body, "roadmap model analysis of %s; B8 simulation findings of 29 Oct 2026" % SNAP)


def conflicts_section():
    C = load_yaml(os.path.join(HERE, "conflicts.yaml"))
    rows = [[E(c["item"]), E(c["a"]), E(c["b"]), E(c["status"])] for c in C["conflicts"]]
    body = ("<p>Where a repository disagrees with the documents in force, the document wins unless the repository change is later. "
            "Proposed register changes are in the pull request of this update.</p>" + table(["Item", "One source says", "The other says", "State"], rows))
    return section("conflicts", "Conflicts between sources", body, "P-03 rev20.2, E-01 rev1.6, M-01 rev19.7, BOM Issue 7.14, decisions.yaml 5ed600e, repository main at the snapshot")


def decisions_section():
    an = json.load(open(os.path.join(HERE, "analysis_summary.json")))
    ep = an["estop"]
    pl = an["lift_base_plate"]
    tz = an["tzbot"]
    ic = an["intended_contacts"][0]
    lp = load_yaml(os.path.join(HERE, "facts.yaml"))["lift_plate"]
    # A5 second E-stop
    ep = an["estop"]
    t_estop = table(["Position", "Actuator centre at L1000 / L1175 / L1350 (m)", "0.90 to 1.50 m at every stop", "Arms (valid poses)", "Cable"],
                    [[E(ep["position"]), E(" / ".join("%.3f" % v for v in ep["actuator_centre_m"].values())), E("yes" if all(0.90 <= v <= 1.50 for v in ep["actuator_centre_m"].values()) else "no"),
                      E("clear" if not any("second_estop" in k for k in an["sweep"]) else "hit"), E(ep["cable"])]])
    # B3 load check
    rows = []
    for c in pl["cases"]:
        rows.append([E(c["case"]), E(c["bp"]), "%.1f" % max(c["bolt_tension_per_bolt_N"].values()), "%.1f" % c["bolt_shear_per_bolt_N"], "%.2f" % c["bolt_utilisation"],
                     "%.2f" % c["rivet_nut_pull_through_utilisation"], "%.0f (%.2f)" % (c["plate_stress_MPa"], c["plate_utilisation"]),
                     "%.0f (%.2f)" % (c["arch_sheet_stress_MPa"], c["arch_sheet_utilisation"]), "%.3f" % c["plate_deflection_at_column_front_mm"], "%.2f" % c["column_tilt_deg"]])
    t_plate = table(["Load case", "Plate hole set", "Bolt tension (N, worst)", "Bolt shear (N)", "Bolt (EN 1993-1-8)", "Rivet-nut pull-through", "Plate stress MPa (Rp0.2 255)", "Arch sheet stress MPa (fy 235)", "Plate deflection at the column front (mm)", "Column tilt (deg)"], rows)
    ab = pl["above_plate"]
    mu = pl["max_utilisation"]
    ok = max(mu.values()) <= 0.67
    # A1 rear section and the prepared receiver
    rl = tz["rear_layout"]
    me = rl["measured"]
    t_dim = table(["Dimension", "CAD v0.2 (base GLB), the reference (A9)"], [
        [E("between the two side walls (inner faces)"), "%.0f mm" % me["between_side_walls_mm"]],
        [E("between the rear top-cover supports (inner faces)"), "%.1f mm" % me["between_supports_mm"]],
        [E("rear panel inner face to the edge of the central arch"), "%.0f mm (supports %.0f mm deep)" % (me["rear_panel_to_arch_mm"], me["support_depth_from_rear_panel_mm"])],
        [E("side pocket across (side-wall width - 150) / 2, minus the 20 mm margin"), "%.0f mm (%.0f mm before the margin)" % (rl["pocket_free"]["y_mm"], rl["pocket_free"]["y_formula_mm"])]])
    t_rx = table(["Rear body", "Clearance to the receiver (mm)", "Inside the 20 mm metal-free margin"],
                 [[E(k), "%.1f" % v, "yes" if v < 20 else "no"] for k, v in tz["position"]["clearance_to_rear_bodies_mm"].items()])
    body = (
        "<p>Decisions of 2 Nov 2026 by the robot owner, to be entered in P-03 and M-01. Values below are generated by "
        "<code>scripts/roadmap_model/analyse.py</code>, <code>rear_layout.py</code>, <code>front_bay.py</code> and <code>lift_plate_check.py</code>.</p>"
        "<h3>Wheel and axle (B1)</h3><p>The drive wheels are rubber, radius 0.100 m, with the axle (base_link) at 0.098 m: the 2 mm is intended tyre "
        "compression under load and levels the rigid chassis, which has no suspension. The model shows it as an intended contact (wheel-to-floor overlap "
        "%.1f mm, limit 2 mm), not as a conflict.</p>" % ic["overlap_mm"] +
        "<h3>Second E-stop (A5)</h3><p>One position: on top of the adapter plate (the moving plate on the lift carriage that carries the post and the arms), "
        "centred in y, in the free part of the plate behind the post, above the column; button facing up in a small housing on the plate, so the contact "
        "blocks sit above the plate (design_intent/rear_estop_housing). The cable runs through the plate into the lift cable chain with the arm cables. "
        "Arm reach checks use only physically valid poses: inside the joint limits, no self-collision, motion stopped at the first contact with the robot body; only contacts that a valid pose produces are reported.</p>" + t_estop +
        "<h3>Lift base plate (B3)</h3><p>One 10 mm 6082-T6 plate, %.0f x %.0f mm, on the top of the centre-frame arch (top 304 mm). The arch top (2 mm "
        "S235JR, CAD MMP.04.00.00.000) carries 8 x M8 blind rivet nuts in two patterns: 120 x 100 mm (x +/-0.060, y +/-0.050) and 190 x 300 mm "
        "(x +/-0.095, y +/-0.150); the plate uses the inner one and is bolted from above with 4 x ISO 4762 M8 x 20 class 8.8. The DOLD column stands forward "
        "of the arch centre on the plate, screwed from below (4 x DIN 7500 M8, flush) with hole sets for bp000 (x 0.060) and bp050 (x 0.110). Length: "
        "from the rear arch holes minus 20 mm (x -0.080) to the column front at bp050 plus 20 mm (x 0.250). Assembly: the column onto the plate from below "
        "first, on the bench; then the plate onto the arch from above. The column front overhangs the arch front wall by %.0f mm at bp050 (%.0f mm at bp000).</p>" % (
            lp["size"][0] * 1000, lp["size"][1] * 1000, pl["overhang"]["bp050"]["column_front_ahead_of_arch_front_wall_m"] * 1000,
            pl["overhang"]["bp000"]["column_front_ahead_of_arch_front_wall_m"] * 1000) +
        "<p>Load check (above the plate %.1f kg, COM x %.3f, z %.3f m at L1350; braking at %.2f m/s2, the tip-over limit at L1350; arms at full forward "
        "reach with 2 x 4.1 kg: %.1f kg, COM x %.3f, z %.3f m). Sources: 6082-T6 Rp0.2 255 MPa (EN 485-2), S235JR fy 235 MPa (EN 10025-2), M8 8.8 "
        "Ft,Rd %.1f kN and Fv,Rd %.1f kN, rivet-nut flange pull-through Bp,Rd %.1f kN (EN 1993-1-8 Table 3.4). Largest utilisation: bolts %.2f, rivet-nut "
        "pull-through %.2f, plate %.2f, arch top sheet %.2f; column tilt up to %.2f deg. %s</p>" % (
            ab["L1350"]["mass_kg"], ab["L1350"]["com_m"][0], ab["L1350"]["com_m"][2], pl["decel_m_s2"], pl["arms_forward"]["mass_kg"], pl["arms_forward"]["com_m"][0],
            pl["arms_forward"]["com_m"][2], pl["cases"][0]["bolt_Ft_Rd_kN"], pl["cases"][0]["bolt_Fv_Rd_kN"], pl["cases"][0]["Bp_Rd_kN"], mu["bolt_utilisation"],
            mu["rivet_nut_pull_through_utilisation"], mu["plate_utilisation"], mu["arch_sheet_utilisation"], pl["max_column_tilt_deg"],
            "The load path goes into the arch with margin." if ok else "The 2 mm arch top sheet is the limit: it is over its yield in the worst case. Decided fix (A7): a doubler under the arch top sheet, or through-bolts with a backing plate; CAD pending (%s)." % gi("Lift base plate MEC-019")) + t_plate + lift_rear_html(an) +
        "<h3>TZBOT WCM-500-24 receiver, prepared in 2.0, installed later (A1)</h3><p class=\"note\">Wireless charging with the TZBOT WCM-500-24 is prepared in OpenAMRobot 2.0: the receiver position at the rear panel on the centre line, the base-sheet cut-out and the charge wiring are in the design; the receiver unit is installed later. Manual charging through the SB50 connector works at any time. Docking for wireless charging will approach the station, turn 180 degrees and reverse onto the transmitter.</p>"
        "<p>Prepared in 2.0 (class \"prepared, installed later\"): the base-sheet cut-out, the F-CHG 30 A charge branch, the KCHG charge relay and the start and fault lines to the controller (CBL-P31). "
        "Manual charging through SB50 with the Daly 28.4 V / 20 A charger (PWR-005) stays available.</p>"
        "<p>Receiver (manual V2.5, 170 x 150 x 52 mm, about 1.5 kg; installed later) 170 mm along x and 150 mm across y, centred on the long axis, "
        "x %.3f to %.3f, as close to the rear panel inner face as possible without touching the rear TF-Luna, the rear MB7060s, their mounts or the rear "
        "panel flange; bottom 50 mm above the floor (2 mm below the base sheet). The 20 mm metal-free margin and the base-sheet cut-out are drawn; no transmitter "
        "is drawn. Charging gap with a 52 mm floor transmitter: %.0f mm (to solve before the receiver is installed, %s).</p>" % (
            tz["position"]["x_m"][0], tz["position"]["x_m"][1], tz["floor_gap"]["gap_mm"], gi("TZBOT receiver / floor transmitter")) + t_rx + t_dim +
        "<p>Cells: 4 + 4 LF105 upright (%s, tray %s mm); clear of the side-panel return flanges: %s (%s).</p>" % (
            E(rl["pockets"].get("arrangement", "")), " x ".join("%.0f" % v for v in rl["pockets"].get("tray_mm", [])), "yes" if rl["pockets"].get("clears_flanges") else "no", gi("Rear side pockets")) +
        rear_a9_html())
    return section("decisions", "Owner decisions of 2 Nov 2026: wheels, second E-stop, lift base plate, lift sensors, rear section, wireless charging", body,
                   "owner decisions of 2 Nov 2026; roadmap model analysis; CAD MMP.04.00.00.000 and the full assembly STEP (openamr-platform-hw main)")


def lift_rear_html(an):
    """A6: lift stop sensors on the rear face of the static column, the one-piece adapter plate with its rear extension, the flag rod."""
    lr = an["lift_rear"]
    L = lr["layout"]
    f = load_yaml(os.path.join(HERE, "facts.yaml"))["lift_rear"]
    cl = lr["clearances_mm"]
    worst = {}
    for nm, d in cl.items():
        for k, v in d.items():
            if v is None:
                worst.setdefault(k, (None, "all stops"))
            elif worst.get(k, (None,))[0] is None or v < worst[k][0]:
                worst[k] = (v, nm)
    t = table(["Part", "Smallest clearance to the rod, flag and corner bracket over L1000 to L1350 (mm)", "At"],
              [[E(k), "more than 50" if v[0] is None else "%.1f" % v[0], E(v[1])] for k, v in sorted(worst.items())])
    return ("<h3>Lift stop sensors and flag rod (A6)</h3><p>The three M12 inductive sensors sit on the rear face of the static DOLD column (x %.3f m), "
            "centred in y, at z %s mm; their SICK DOL-1204-G02M cables run down the static column. The flag (%s mm) moves with the adapter plate, %.0f mm "
            "off the sensor faces, on a 20 x 20 mm rod L%.0f bolted with M5 under the plate extension and a corner bracket. The adapter plate is one part, "
            "6082-T6, %.0f x %.0f x %.0f mm (x %.3f to %.3f m on the carriage), %.0f mm behind the column rear face: the extension length is the sum of the "
            "sensor face, the %.0f mm flag gap, the %.0f mm rod clearance, the rod and the %.0f mm bolt edge distance. No separate rod bracket. The plate is no "
            "longer flush with the column rear face (P-03 rev20.1 item 25 D2: intended pending difference). Rod bottom at L1000: %.0f mm above the floor, "
            "%.0f mm above the top cover. The E-stop housing is %.0f mm from the rod mount area.</p>" % (
                f["column_rear_x"], " / ".join("%.0f" % (z * 1000) for z in f["sensor_z"]), " x ".join("%.0f" % (v * 1000) for v in f["flag"]), f["gap"] * 1000,
                f["rod"]["len"] * 1000, L["plate_len"] * 1000, L["plate_width"] * 1000, L["plate_t"] * 1000, L["plate_rear_x"], L["plate_rear_x"] + L["plate_len"],
                L["extension"] * 1000, f["gap"] * 1000, f["rod_clear"] * 1000, f["bolt_edge"] * 1000, lr["rod_bottom_L1000_mm"], lr["rod_bottom_above_cover_L1000_mm"],
                lr.get("estop_to_rod_mount_mm", 0)) + t)


def rear_a9_html():
    """A9: the GI-080 attempts, the 25 mm² cable rules, the two battery trays and the decided GI-025 fix."""
    bs = json.load(open(os.path.join(HERE, "build_summary.json")))
    g = bs.get("gi080", {})
    step = __import__("rear_layout").gi080_step_result
    rows = [["%d" % st["option"], E(st["what"]), E(step(st))] for st in g.get("steps", [])]
    t = table(["Option (in order; 1 to 3 A9, 4 and 5 independent review, all proposed)", "What was tried", "Result"], rows)
    c = bs.get("cables_25mm2", {})
    t2 = table(["Cable (25 mm²)", "Route (mm)", "Straight (mm)", "Bend radius 60 mm"],
               [[E(k), "%.0f" % (v["route_m"] * 1000), "%.0f" % (v["direct_m"] * 1000),
                 "ok" if v["bend_ok"] else E("%.0f mm straight cable at a %d deg corner, %.0f mm needed" % (v["worst_corner"]["have_mm"], v["worst_corner"]["deg"], v["worst_corner"]["need_mm"]))]
                for k, v in sorted(c.items())])
    tc = bs.get("battery_trays", {})
    return ("<h3>Rear power layout (A9)</h3><p>Rules: nothing on top of the cells; F0 within about 150 mm cable length of battery +; the BMS close to the "
            "cells; bend radius at least 60 mm on 25 mm² cables. The options were tried in order and the first that fits is kept. Result: %s (%s).</p>" % (
                "every part placed" if not g.get("final_nofit") else "no option fits, " + E(", ".join(g["final_nofit"])) + " not placed", gi("Rear layout (A1)")) + t +
            "<p>25 mm² runs in the rear bay (%s):</p>" % gi("Rear layout (A9)") + t2 +
            "<p>Battery: two removable trays (4 + 4 LF105), joined by the keyed, touch-protected main connector PWR-018 on the 8S series link; this "
            "replaces the one removable battery assembly of B-02 rev18.10 (listed under conflicts for the battery owner). The cells go in from above with "
            "the cover off (%s); the power plate comes out without removing the cells after PWR-018 is unplugged; nothing sits on the cells (%s).</p>"
            "<p>Side-panel return flanges: decided fix (A9), notch the flanges at x -0.275 to -0.133 m; CAD pending (%s).</p>" % (
                "yes" if tc.get("cells_from_above") else "no", "yes" if tc.get("nothing_on_cells") else "no", gi("Rear side pockets")))


def closed_html():
    """Closed issue IDs (scripts/roadmap_model/issue_ids.yaml; IDs are stable and never renumbered)."""
    c = json.load(open(os.path.join(HERE, "analysis_summary.json"))).get("closed_issues", [])
    return ("<p><b>Closed issue IDs</b> (IDs are stable across reruns and never renumbered; new issues get new IDs): %s.</p>" %
            "; ".join("%s %s (%s)" % (E(x["id"]), E(x["key"].split("|", 1)[1]), E(x["reason"])) for x in c)) if c else ""


def gi(prefix):
    """ID of the geometry issue whose parts start with prefix (IDs are assigned by analyse.py)."""
    for r in csv.DictReader(open(os.path.join(MODEL, "geometry_issues.csv"))):
        if r["parts"].startswith(prefix):
            return r["id"]
    return "?"


def frontbay_section():
    bs = json.load(open(os.path.join(HERE, "build_summary.json")))
    f = bs["front_bay"]["single"]["fit"]
    t = table(["Layout", "Parts placed", "Not placed", "Margin to the cover (mm)", "Parts in the scan band", "Smallest gap (mm)"],
              [[E(f.get("layout", "")), str(f["placed"]), E(", ".join(f["not_placed"]) or "none"), "%.1f" % f["cover_margin_mm"], E(", ".join(f["scan_band_parts"]) or "none"), "%.1f" % f["min_gap_mm"]]])
    zones = "; ".join("%s: %s" % ({"A_lower": "lower plate", "A_upper": "upper shelf", "A_din": "DIN carrier", "bay": "plate"}.get(k, k), ", ".join(v)) for k, v in f["by_zone"].items())
    body = ("<p>One layout, no options (owner correction A2, 2 Nov 2026; to be entered in P-03 and M-01). The receiver is no longer at the front, so the "
            "MEC-005 plate lies on the base sheet and every front-bay part uses the full height up to the cover underside (0.290 m), clear of the LiDAR, its "
            "scan plane 222.05 mm +/-5 mm in the open sector, the Gemini 336L, the MB7060 and TF-Luna bodies, the E-stop and RESET bodies and the lift-plate "
            "top-access rule, with 10 mm air gaps around converters and top access to every fuse and terminal block. One plate is tried first; a second tier "
            "is used only because one plate does not take every part. The Jetson does not sit on bracket MMP.04.00.00.002; the EV_ICM-42688-P stays at "
            "imu_link with nothing heavy or vibrating on its bracket. Catalogue outlines and their sources are in <code>scripts/roadmap_model/parts.yaml</code> "
            "and <code>front_bay.py</code>.</p>" + t + "<p>Zones: %s.</p>" % E(zones))
    return section("frontbay", "Front bay: one layout", body, "front_bay.py; owner correction A2 (2 Nov 2026); P-03 rev20.2, E-01 rev1.6")


def parity_section():
    ps = json.load(open(os.path.join(HERE, "parity_summary.json")))
    ms = json.load(open(os.path.join(HERE, "mass_summary.json")))
    src = ps["sources"]
    srcs = ", ".join("%s %s" % (v["repository"].split("/")[-1], v["commit"][:7]) for v in src.values())
    rows = [[E(x)] for x in ps["out_list"]]
    pend = [[E(x)] for x in ps["pending_list"]]
    tot = ms["totals"]
    body = ("<p><b>Goal:</b> the roadmap becomes a renderer of the expanded combined_robot.xacro (openamr-upperbody-sw) at a pinned commit, with no "
            "hand-typed dimensions in model.js. One geometry, two presentations. URDF only: physics, inertials, collisions, ros2_control, MoveIt, Gazebo. "
            "Roadmap only: finishes, labels, exploded offsets, BOM classes, harness, fasteners, design-intent parts; a roadmap-only part always attaches to a "
            "URDF link with an offset.</p><p><b>Phases:</b> 1) warn-only parity report (this update); 2) URDF-to-GLB renderer plus an overlay file keyed by "
            "URDF link name; 3) the parity check fails CI above 0.5 mm, and the frozen fixture in openamr-upperbody-sw is removed; 4) the combined model "
            "feeds the lift joint, limits, mass, COM, collision reports and recorded MoveIt trajectories into the roadmap, and the roadmap feeds BOM masses, "
            "visual-only detail links and confirmed design-intent datums back.</p>"
            "<p><b>Phase 1 result</b> (combined model expanded with pip xacro and a minimal ament index at %s; bp000 and bp050, L1000, L1175 and L1350, hp30, "
            "arms at zero; tolerance 0.5 mm and 0.2 deg): %d mapped items, <b>%d matched</b>, <b>%d out of tolerance</b>, %d intended pending differences "
            "(%d mapped, %d roadmap-only), %d URDF links without a roadmap part, %d roadmap-only parts attached to URDF links. Report: %s; map: "
            "<code>scripts/roadmap_model/link_map.yaml</code>. CI runs it as a warning.</p>" % (
                E(srcs), ps["mapped_items"], ps["matched"], ps["out_of_tolerance"], ps["pending"], ps["pending_mapped"], ps["pending_roadmap_only"],
                ps["unmapped_urdf"], ps["roadmap_only"], A("model/parity_report.csv", "parity_report.csv")) +
            "<details><summary>Out of tolerance (%d)</summary>%s</details>" % (len(rows), table(["URDF link / roadmap part"], rows)) +
            "<details><summary>Intended pending differences (%d)</summary>%s</details>" % (len(pend), table(["Item and reason"], pend)) +
            "<p><b>Mass:</b> the combined model carries %.1f kg in total (base URDF %.1f kg); the roadmap model from BOM Issue 7.14 carries %.1f kg, COM "
            "(%.3f, %.3f, %.3f) m at L1000 and z %.3f m at L1350. %s gives the per-link masses for the platform-sw mass PR and for mass_provenance.yaml.</p>" % (
                ms["comparison"]["combined_model_total_kg"], ms["comparison"]["base_urdf_kg"], tot["L1000"]["mass_kg"], tot["L1000"]["com_m"][0], tot["L1000"]["com_m"][1],
                tot["L1000"]["com_m"][2], tot["L1350"]["com_m"][2], A("model/mass_export.yaml", "mass_export.yaml")))
    return section("parity", "Roadmap vs combined model", body, "combined_robot.xacro expanded at %s; scripts/roadmap_model/parity.py" % E(srcs))


def main():
    s = open(PAGE, encoding="utf-8").read()
    secs = [decisions_section(), frontbay_section(), model_section(), mech_section(), issues_section(), parity_section(), conflicts_section()]
    s = re.sub(r"<!--GEN:(\w+)-->.*?<!--/GEN:\1-->", "", s, flags=re.S)
    anchor = s.index('<section class="card" id="hwdrift">')
    end = s.index("</section>", anchor) + len("</section>")
    s = s[:end] + "".join(secs) + s[end:]
    open(PAGE, "w", encoding="utf-8").write(s)
    print("hardware.html sections written")


if __name__ == "__main__":
    main()
