openAMRobot/openamrobot-docs/(commit log)

2026-08-29 Add Getting Started documentation for OpenAMRobot
    Add the Getting Started landing page for the OpenAMRobot documentation site.
2026-08-29 Change mdl_colors from blue-grey to indigo-pink
    Use a supported Material Design Lite color scheme so the documentation theme styles load correctly.
2026-08-29 Configure Material for MkDocs
    Configure the OpenAMRobot documentation site using Material for MkDocs with navigation, search, dark mode, and GitHub integration.
2026-08-29 Add MkDocs deployment workflow
    Add a GitHub Actions workflow to build and deploy the Material for MkDocs documentation site from main.
2026-08-29 Clean homepage for MkDocs
    Remove legacy Jekyll front matter and update the homepage title for Material for MkDocs.
2026-08-29 legal: standardize original project material under MIT
2026-08-31 docs: add complete fillable documentation framework
2026-09-28 docs: add OpenAMRobot 2.0 design section and architecture reference
    * docs: add OpenAMRobot 2.0 design section with the hardware architecture diagram
    Add the reference section for development cycle 2 with a section index
    and the interactive hardware architecture diagram generated from BOM
    Issue 7 (27 September 2026). The diagram is served as a self-contained
    HTML asset and embedded through a responsive frame; a full-screen link
    covers phones. Record the design status as planned, map the section to
    openamr-platform-hw in the page-context hook, add the embed styles to
    brand.css, and cross-link from the mobile platform and reference index
    pages.
    The diagram is a connection model, not a releas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
2026-09-28 site: add a collapsible table of contents (#27)
    Add javascripts/toc-toggle.js and the matching styles in brand.css. On
    desktop widths the right sidebar gets a small arrow button that hides it
    and lets the content use the width; a tab on the right edge shows it
    again. The state is kept in localStorage and re-applied on instant
    navigation. Below 76.25em Material already moves the table of contents
    into the drawer, so nothing changes there.
2026-09-30 Clarify P-03 rev18.2 mast geometry and assembled height (#28)
    * docs: clarify P-03 rev18.2 mast geometry and height envelope
    * docs: clarify P-03 rev18.2 mast geometry and height envelope
    * docs: clarify P-03 rev18.2 mast geometry and height envelope
2026-10-02 chore: set code owners for OpenAMRobot 2.0 (#31)
    Set .github/CODEOWNERS to the OpenAMRobot 2.0 owner assignment
    (team ground-truth document, section 5.4).
    Claude-Session: https://claude.ai/code/session_01TtEpmZ66TW3ufBTVZHLkCC
2026-10-10 docs: add OpenAMRobot 2.0 dark-store pick simulation (#38)
    Adds an interactive 3D simulation of OpenAMRobot 2.0 (Hexalift V4 lift,
    two OpenArm 2.0 arms, front totes) picking a grocery order in a two-aisle
    dark store. The page embeds the self-contained simulation and summarises
    what the current baseline shows. Linked from the 2.0 design index and the
    retail solution page.
2026-10-12 docs: base controller is the STM32H723 (P-03 rev18.5 item 14) (#36)
    Replace the STM32H743 / NUCLEO-H743ZI2 base-controller references with
    the STM32H723ZG on the NUCLEO-H723ZG in the hardware architecture page
    and its interactive diagram, and state the CAN mapping: CAN1 traction,
    CAN2 BMS, CAN3 reserved for upper-body actuators.
    Claude-Session: https://claude.ai/code/session_01FTYv7wU12mXomHsTFu3iF6
2026-10-13 docs: option B upper body and 2.0 sensor layout (P-03 rev19.0) (#37)
    * docs: follow upper-body mounting option B (P-03 rev18.9 item 18)
    Update the OpenAMRobot 2.0 design pages to the decision of 9 October
    2026: DOLD Hexalift V4 lift column on a two-position base plate (bp000,
    bp050), arm profile on an adapter plate with the OpenArm arm mount point
    180 mm ahead of the column axis, shoulder 1000 to 1350 mm, ZED Mini head
    camera on the lift carriage and the configuration IDs.
    Remove the fixed-mast and four-position wording from the 2.0 index,
    general arrangement, hardware architecture, mass and stability, upper
    body and mobile platform pages. Withdraw the 28 September drawings and
    F2S results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
2026-10-13 docs: reference use cases page; 2.0 is Use Case 1, dark-store picking is 3.0 (#40)
2026-10-13 docs: navigation LiDAR is the RPLIDAR S3 (P-03 rev19.0 items 13 and 19) (#34)
    * chore: navigation LiDAR is the RPLIDAR S3 (P-03 rev18.4 item 13)
    Replace the Hokuyo UST-10LX with the SLAMTEC RPLIDAR S3 (S3M1-R2) as the
    OpenAMRobot 2.0 navigation LiDAR in the 2.0 hardware architecture page,
    the general arrangement page and sheet, and the BOM Issue 7 diagram
    labels: USB via a USB to UART adapter to the Jetson, regulated 5 V rail,
    existing A1 bracket plus spacer plate, lidar_link unchanged, open scan
    window, functional sensing only, RPLIDAR S2E backup only if the S3 is
    unavailable. The 24 V fused LiDAR branch and Ethernet link are marked
    withdrawn; diagram geometry and embedded Issue 7 source r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
2026-10-24 docs: roadmap snapshot 24 Oct 2026 and roadmap checker (#51)
    Refresh the OpenAMRobot 2.0 roadmap pages from the 19 Oct snapshot,
    checked against P-03 rev19.7 (in force), E-01 rev1.4, BOM Issue 7.10
    (corrected 24 Oct), P-02 rev19.2, decisions.yaml at 1c3f516 and main of
    every repository:
    - Overview: system map, timeline with confirmed and proposed dates by
    source, shared base recorded (P-03 rev19.7 item 23, SHARED-BASE),
    first 10 plan steps.
    - Robot: base sensor frames at the P-03 rev19.7 design values with drift
    markers; ToF callout pitched 10 deg.
    - Hardware: PARTS from BOM Issue 7.10 (136 rows) with purchase package
    and procurement state, procurement by package, open design items,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
2026-10-25 roadmap: robot page base, CAD v0.2 chassis with 2.0 components (#52)
    Replace the drawn base on the robot page with the mesh set generated in
    openamr-platform-sw PR #94 (tools/cad/step_to_description_meshes.py):
    the CAD v0.2 chassis from openamr-platform-hw eaac115 and the BOM 7.10
    components as envelopes, embedded as a base64 GLB and placed at base_link
    (z 0.098) in the floor-origin, z-up robot group. A small GLB reader
    follows the existing OPENARM base64 to BufferGeometry pattern. The lift,
    column, arms, callouts, controls, the labelled illustrations and three.js
    are unchanged; a source line names the base geometry.
    Claude-Session: https://claude.ai/code/session_01LwTsQAzAHpEbojLYap63cP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
2026-10-25 roadmap: exploded view page for OpenAMRobot 2.0, shared model with the robot page (#53)
    * roadmap: exploded view page for OpenAMRobot 2.0, shared model with the robot page
    Add docs/assets/roadmap/exploded.html: the 2.0 robot assembled or exploded
    by subsystem, a numbered component list (BOM Issue 7.11 rows, geometry type,
    public source) with matching callouts, selection that highlights one part,
    and eight build stages by subsystem (orientation, not an assembly
    instruction). Static image and list when WebGL is unavailable; bottom sheet
    on narrow screens; reduced motion jumps instead of animating.
    The robot geometry moves into shared files under model/: base_glb.js (the
    per-part GLB of opena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
2026-10-25 roadmap: exploded view v2, open-the-base view, guided tour and video (#55)
    The exploded view now fills the window below the nav (min 560 px) with the
    side panel scrolling on its own, and adds:
    - Explode in two levels: "Explode robot" (the subsystem explode of #53)
    and "Open the base": cover and flanges lift and fade, side, front and
    rear panels move out with their sensors, and the internal components
    rise above the deck in two tiers (battery, compute, base controller,
    driver, IMU, LiDAR, camera, near-field sensors), with name labels
    - "Cutaway": cover and panels translucent on the assembled robot
    - fly-to framing for stages and selections (stages 1 to 6 frame the base;
    reduced mot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
2026-10-25 roadmap: finish colours on the shared model, two slot cover strips, re-rendered videos (#56)
    * roadmap: finish colours on the shared model, two slot cover strips
    model/finish.json (new) holds RAL colours and finishes keyed by the
    existing part ids; model.js reads it at load and recolours the GLB
    nodes and upper-body primitives it names. Geometry is unchanged: all
    130 existing meshes keep their geometry and placement, silhouettes are
    identical. Two 85 mm slot cover strips (primitive, stage 8) are added
    inside the arm-profile group, above the arm mounts so that they stay
    more than 150 mm from the chest E-stop drawn on the robot page.
    The tour caption now changes only when the camera reaches i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
2026-10-26 roadmap: one shared robot model for store and exploded view, physically based materials (step 1) (#58)
    * roadmap: one shared robot model for store and exploded view, PBR materials (step 1)
    robot.html no longer carries its own three.js r160 bundle: it loads
    model/three-r160.min.js (rebuilt from the same entry plus RoomEnvironment)
    and model/three-r160-store.min.js (store-only addons built against that
    core, no core copy). Both pages build the robot with OAMR_MODEL.build in
    model/model.js; the robot page fittings, arm link meshes, cable and wrist
    cameras moved there unchanged. model/look.js holds the shared renderer
    settings (ACES, sRGB, PCF soft shadows) and the RoomEnvironment PMREM map.
    fi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
2026-10-27 roadmap: no LED strips on the robot, re-rendered tour, store video and pictures in the new look (#59)
    * roadmap: no LED strips or foot light on the robot
    Remove the cyan LED strips on both sides and the rear of the base and the
    cyan foot light around the lift column base from the robot page fittings
    in model/model.js, with their led material and the "status lights" entry
    of the illustration list on robot.html. The slot cover strips (RAL 5018),
    the store's chiller strips, the E-stops, RESET and decals stay.
    check_roadmap.py fails if model.js defines an led material or a cyan
    emissive colour on the robot again.
    Claude-Session: https://c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
2026-10-28 Visuals: base E-stop and RESET positions, chest layout (P-03 rev20.0 item 24) (#60)
    * Visuals: base E-stop and RESET positions (P-03 rev20.0 item 24)
    model/base_glb.js now embeds the base GLB of openamr-platform-sw PR #100 at
    head 1939b82b47715b449d61685fedd4dea32b7fe4d2 (regenerated with its
    converter; sha256 4c126742d1048f875d20718d06d6b2f680958cfd11cf036f4a704b4dc8e391dd,
    854,136 bytes, the value reported in that PR). Against the previous GLB
    (#96) the 44 existing nodes are unchanged; two nodes are new: estop and
    reset_button, both placeholder geometry from datasheet dimensions in the
    front-panel holes of the release 001 buttons (E-stop +y, RESET -y).
    - model.js: estop and reset_button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
2026-10-28 docs: 28 Oct upper-body decisions in the reference pages and the dark-store simulation (#63)
    P-03 rev20.0 (28 Oct 2026 corrections line, items 15, 17, 18 and 24)
    and E-01 rev1.5, text and embedded data only:
    - Getac ZX80 chest tablet (replaces the ZX10), Falcon FLDL-i150x15-W
    head light (Banner WLS28 dropped), chest layout from the bottom up
    (head light, 30 mm gap, Getac; placeholders until M-09).
    - Second E-stop: XB4BS8445 with ZBE-102 on the rear face of the static
    lift column; the OpenArm kit button is superseded.
    - F-PD is now F-PANEL.
    - ZED Mini lens 42 mm ahead of the arm mount point, baseline hp30.
    - Dark-store simulation: ZED_X 0.222, default head pitch 30 degrees,
    second E-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
2026-10-29 roadmap: upper-body layout of 28 Oct (second E-stop on the column, Getac and head light, head camera forward and hp30), lift stop sensors, one model on both pages, all media re-rendered (#62)
    * roadmap: chest E-stop, Getac and head light placeholders, tote riser
    Chest equipment of P-03 rev20.0 item 24 and BOM Issue 7.14 on the shared
    model (both pages), on the moving chest, bottom up:
    - chest_estop (SAF-001, 2 in BOM 7.14: base front and chest): a copy of
    the GLB estop meshes, the base E-stop placeholder of openamr-platform-sw
    #100, contact block on the arm-profile front face; it replaces the
    robot page's illustrative chest E-stop in columnFittings
    - getac_tablet (UI-001): listed, no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
2026-11-01 roadmap: align pages and model with P-03 rev20.2 (1 Nov 2026) (#66)
    Plan set P-03 rev20.2, E-01 rev1.6, M-01 rev19.7, BOM Issue 7.14 in the
    roadmap pages, the reference pages and the shared roadmap model:
    K1/K2 GX11CAC recorded with the availability-rule decision due 2 Nov
    (LEV100H withdrawn); CTL-002 click shield removed, IMU board TDK
    EV_ICM-42688-P on SPI4; second E-stop on the static column, ESTOP-KIT
    withdrawn; Gate A full run 6 Nov (30 Oct partial, A1 control only);
    hp30 in the register; Getac ZX80 on a rotatable mount (item 26);
    precharge fitted; SAFE 24 V converter MEAN WELL DDR-240B-24; DOLD
    holding confirmation received, holding test open; availability rule.
    model.js: getac_tablet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
2026-11-02 roadmap: model call to action and link preview tags on the overview page (#69)
    * roadmap: model call to action and link preview tags on the overview page
    Add a caption and two link buttons (model repository on GitHub, contact
    form) above the first visualization of docs/assets/roadmap/index.html,
    styled with the page's existing tokens. Add Open Graph and Twitter card
    tags using the existing store simulation poster as the preview image.
    The visualizations themselves are unchanged.
    Claude-Session: https://claude.ai/code/session_01DZnPERquA3ASQ1DZ4PJWds
    * roadmap: 3D model button on the overview, call to action card and link preview tags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
2026-11-03 Roadmap update, snapshot 2 Nov 2026 (#68)
    * Roadmap update 2 Nov 2026: work in progress
    Claude-Session: https://claude.ai/code/session_01DZnPENuVcmVSR9z5iEBd9u
    * hardware: re-import PARTS from BOM Issue 7.14 (146 records)
    Adds LFT-001 to LFT-007, AUX-002, AUX-003 and PWR-032; SAF-001 qty 2;
    ARM-008 and CTL-002 qty 0; AUX-001 Falcon head light; MEC-018 DOLD SKU;
    MEC-019 description; UI-002 rotatable 2-position mount. The re-import is
    scripts/roadmap_model/bom714.py (idempotent).
    Claude-Session: https://claude.ai/code/session_01D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
2026-11-03 Roadmap: harness routing, tie points and lift energy chain (#70)
    Claude-Session: https://cla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
2026-11-04 Roadmap: electronics layout, harness re-route and flag rod guide (#71)
    * Roadmap: add labelled review render tool from tools/review-shots
    Claude-Session: https://claude.ai/code/session_01DZnPENfo7Qu54t5hGegoKq
    * Roadmap model: zones, corridors, rear power module layout and front bay side zones (phases 1 and 2)
    - rear_power.py: explicit rear power module from the rear power owner's report rev 2 with measured
    adaptations; 15 mm receiver gap (owner decision 3 Nov 2026), G10 plate and non-metal fixings within
    20 mm of the receiver; F0 at the plate front edge, QS1 studs inboard, busba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
2026-11-04 Roadmap: photos and videos re-rendered from the current model (#72)
    * evidence: start 2026-11-04 media folder
    Claude-Session: https://claude.ai/code/session_01DZnPEQ6JGa6H93HeZueqRM
    * Roadmap tour: new engineering stops, captions fixed against the current model
    - exploded.html: tour keyframes take lift (travel above L1000, m; the carriage parts, the arms and
    the energy chain move) and hide (components faded out, @upper for the lift assembly and arms)
    - exploded.json: stops for the rear power module (two views), the base harness, the front bay side
    zones, the lift energy chain fro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
2026-11-10 Roadmap model: owner decisions of 8 Nov 2026 (#83)
    * Roadmap model: owner decisions of 8 Nov 2026
    ZX80 portrait 55 mm lower with the head light 10 mm below, ZED lens
    60 mm ahead of J1_A, TZBOT receiver offset 15 mm from any side, DOLD
    lift drawn from the supplier STEP, arch backing plate for GI-082,
    K1/K2 GX11CAC only (GI-008 and GI-009 closed), no cable in the cover
    slot (z 214 to 232 mm), reference pages, STATE.md and CHANGELOG.
    Register: openAMRobot/.github#90 (change request #89).
    Claude-Session: https://claude.ai/code/session_01DZnPERXdK4VNyx7trxz3QR
    * Roadmap model: receiver f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
2026-11-10 Roadmap: 9 Nov 2026 refresh, model visuals, exploded tour and every page (#84)
    * Roadmap: 9 Nov 2026 refresh, model visuals, exploded tour and every page
    - PARTS from BOM Issue 7.15 (Hardware BOM sheet; LFT-008 and MEC-022 added, 21 rows
    changed) by scripts/roadmap_model/bom715.py: only fields that differ from 7.14 are
    taken from the workbook, and that text is made public (no prices, sellers, first
    names or partner names).
    - Mass ledger 87.1 kg with LFT-008 and MEC-022 (design values, not weighed).
    MEC-007 model quantity is the number of trays drawn (2).
    - Exploded tour captions and labels at 43.5, 54, 71.5 and 79.5 follow the 8 Nov
    decisions; stills 01 to 08, posters and the 1080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
2026-11-10 Roadmap: copy fixes after the 10 Nov 2026 audit (#85)
    * Roadmap: copy fixes after the 10 Nov 2026 audit
    - Record the merges of 10 Nov: .github #90 (87c8486), docs #83 (329a7bc)
    and #84 (ff8ca57) in the register footers, system map and progress lines.
    - 16 Nov as a planned software session on the v0.0.1 Teensy rig, after
    preflight; base controller decided per line; IMU row per D-10.
    - Motion figure labelled as the rc.1 pin of 19 Oct; progress opens with a
    capability panel (main, rc.1 pin, last run); per-area tables marked as the
    historical audit of 19 Oct; "precharge fitted" annotated with E-01 rev1.8.
    - Purchasing status out of the narrative; check_roadmap.py "purchasing
    status" t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
